nickthelegend/xorrpad/docs/screens/v4/README.md

# Firmware v4 captures

The approved desktop components, tokens and art are retained.

## F8 SCAN captures

`scan-markets-{1440,375}.png` and `scan-activity-{1440,375}.png` show the
existing desktop components populated by both real SCAN routes. The test checks
visible-element bounds at both widths. The full market/error list is expandable;
checked/unavailable counts do not claim missing candle feeds were evaluated.
`scan-record.json` records the actual public result and its provenance; `scan.png`
is the exact firmware `ui.h` frame rendered by native uipreview at 2x RGB565.
Financial data is live or explicitly Setup required. The pad record displays six
market rows plus full counts; SCAN answers never authorize a trade.

## F7 release captures

`release-captures.json` lists **14** new browser screenshots from the actual
local desk, SQLite and verified encrypted native padsim. No HTTP response is
intercepted. Device saves Sounds, Ambient and Tilt guard together and reloads
their actual stored settings. Markets' Predict on pad selects Predictor without
creating a signal. Agent and Activity show actual guard/journal state; financial
reads are live or explicitly Setup required/unavailable/empty.

- `release-{device,markets,agent,activity}-{1440,375}.png` are full-page captures.
- `release-{ambient,sounds,tilt-guard}-{1440,375}.png` show the Device settings
  around each section heading; the full-page Device capture includes every
  control. Viewport edges and the existing fixed mobile navigation are retained.
- The browser checks document width and visible form-control bounds at both
  sizes and records page runtime errors. Every resulting image is also visually
  reviewed for clipping and overflow. Configuration values are settings, not
  financial quotes, balances or claimed fills.

`release-pad-records.json` retains public input snapshots and provenance for
every new pad screen. `release-pad-*.png` are generated by the actual `ui.h`
native renderer at 2× panel resolution. `release-pad-captures.json` records
dimensions and SHA-256 hashes. Predict/outcomes, perps Setup, flatten Setup,
ambient and empty journal come from the feature suite's live-or-Setup records.
Cockpit, liquidation alarm, cooldown countdown, flatten plan and populated
journal are explicitly **LAYOUT TEST** inputs, never substituted external
responses or claims of a live trade. Missing-clock cooldown is an honest native
Setup state. Native/WASM parity separately covers all **31** frame cases.

Reproduce the release pad PNGs from the committed public snapshots:

```sh
make -B -C tools/uipreview
node tools/uipreview/capture-v4.mjs
```

Run `SIBYL_PY=$PWD/.venv/bin/python npm test --prefix desk` alone to recapture the
desktop against a fresh local session. Restore historical v3 screenshots with
`git checkout -- docs/screens/v3` if their tests rewrite them. Historical
per-feature evidence below remains intact; release screenshots use separate names.

## Historical feature captures

| Files | Source / limits |
| --- | --- |
| `predict.png` | F1 actual public pm-AMM devnet record through firmware ui.h. |
| `outcome-positions.png` | F1 actual missing-owner Setup record through ui.h. |
| `predict-markets-{1440,375}.png` | F1 real local desk + encrypted native padsim. |
| `perps-device-{1440,375}.png` | F2 real local desk + encrypted native padsim, threshold saved to 7.5%; no configured perp authority. |
| `perps-positions.png` | F2 actual empty/Setup `perps` wire record rendered with ui.h. |
| `liq-guard.png` | F2 native parser/renderer **LAYOUT TEST** vector (mark 100, liquidation 95, distance 5%). No external API substitution or live liquidation claim. |
| `perps-cockpit-layout.png` | F2 native **LAYOUT TEST** cockpit vector; next funding unavailable. No live position claim. |

F2 layout inputs are generated under `firmware/build/f2-{liq,cockpit}-layout.json`;
the real Setup record is captured as `firmware/build/f2-perps.json` by
`desk/test/pad-perps.test.mjs`. Run `make -B -C tools/uipreview` and
`tools/uipreview/preview OUTPUT 2 RECORD.json` to render the exact firmware pixels.
Native/WASM tests cover 16 distinct frames including unknown cockpit fields and
the guard, alongside all existing Fund/Portfolio/Predict/outcome cases. No hardware
was flashed, no funded perp was reduced and no transaction was submitted.

F3 evidence:

- `tilt-agent-{1440,375}.png` and `tilt-device-{1440,375}.png`: real local desk,
  SQLite and verified encrypted native-accounting padsim. The actual simulator
  has no approvals/fills at capture time; its saved hourly limit is 1. No market
  quote, fill, wallet balance or realized PnL is fabricated.
- `cooldown-layout.png`: the actual `ui.h` native renderer with explicit
  **LAYOUT TEST** inputs (900/1800 seconds, half ring), not a real trading event.
- `cooldown-setup.png`: the native renderer's honest missing-UTC state, with
  no invented clock/countdown value.

F3 extends native/WASM parity to **19 distinct frames**, including countdown,
missing UTC and a reviewed reduce-only decision while cooling. Desktop captures
reuse the approved components; no stylesheet, token or commissioned art changes.
Physical display/power-loss verification remains hardware work.

F4 evidence:

- `flatten-setup.png` uses the actual encrypted padsim/desk response with missing
  public authorities, rendered by the production `ui.h` through uipreview.
- `flatten-layout.png` is explicitly **LAYOUT TEST / no live trades**: three
  coordinator/parser layout vectors, never an external API response or a fill.
- `flatten-device-{1440,375}.png` uses the actual local desk and verified v4
  padsim after KILL. The desktop live firmware texture receives the Setup plan;
  mobile retains the approved static CAD poster and actual Kill latch controls.
  `flatten-activity-{1440,375}.png` shows the actual NO/refused record in the
  existing Activity components. Styling, tokens and commissioned art are unchanged.
- Native/WASM parity adds awaiting, Setup and refused Flatten frames, preserving
  every earlier frame and actual Fund QR decoding (22 distinct frame cases).

Public inputs are in `firmware/build/f4-flatten-{setup,layout}.json`. A plan
layout is not proof of a funded live close; venue/signing prerequisites and
unsupported inventory cases are documented in `docs/v4/V4-NOTES.md`.

F5 evidence:

- `sounds-device-{1440,375}.png`: the real Device sound controls on the local
  desk with a verified encrypted v4 padsim. The browser saves volume 45%, mute
  off, detent tick on and 22:00–07:00 UTC quiet hours. No stylesheet, tokens,
  artwork, market data or trade outcome is changed or invented.
- `sounds-cooldown-setup.png`: actual native `ui.h` rendering of the production
  tilt driver's missing-UTC state after enabling an hourly limit with no clock.
  No reservation, close or financial fill is injected. Sound is silent in
  configured quiet hours without UTC, while the existing Setup screen and LED
  remain available. The input is `firmware/build/f5-sound-cooldown-setup.json`.

F5 adds sound and LED behavior to existing screens; `ui.h` and its shipped WASM
are unchanged. PCM/browser evidence is in `desk/test/pad-earcons.test.mjs` and
`firmware/test/earcons.cpp`. Acoustic and LED hardware measurements are pending.
