nickthelegend/xorrpad/keeper/README.md

# xorrpad devnet keeper

This separate process signs only keeper market-creation and resolution
transactions on devnet. The v1 desk defaults to phone-wallet signing and also
supports a capped local session wallet; its venue adapters remain unsigned
builders. The keeper refuses any RPC whose
genesis hash is not Solana devnet and any collateral other than
`3WQ8hCqTNwjrh8WzE2XyoZoUrd1miPcwWfMkmFPUMEWZ` (6-decimal mUSDC).
It checks both before key access and again before each signing/submission.

```bash
npm install --prefix keeper
node keeper/keygen.mjs        # once: prints only the public key
node keeper/fund.mjs          # stops with the precise funding instruction if needed
node keeper/run.mjs --once    # one scheduling pass
node keeper/run.mjs           # separate recurring keeper; stop by its PID
```

The key is `keeper/.keeper-devnet.json`, exclusively created with mode 0600;
key generation refuses an existing key or public metadata. It is gitignored.
The desk reads only `.creator-devnet.json` public metadata, never the key.
Never paste a secret into a terminal, a README, or an environment file.

Funding tries `requestAirdrop` on the public devnet RPC once per keeper key.
If the balance is below 0.5 SOL afterward it stops. Once SOL is funded, the
pm-AMM faucet is requested at most once an hour for mUSDC; balances are confirmed
from chain rather than inferred from the faucet response. Local attempt records
prevent repeated faucet requests on restart.

## Schedule and creation

SOL and BTC expire on the next eligible UTC hour; ETH expires at UTC midnight.
An expiry less than 360 seconds away is skipped to leave room for the program's
300-second minimum. Strikes round the live Pyth price to $1 for SOL, $100 for BTC
and $10 for ETH, using integer arithmetic. Questions are `SOL above $<strike>
at HH:00 UTC?` and equivalents. The on-chain `endTs` is the exact expiry.

`KEEPER_DEPOSIT_USDC` defaults to 50 human mUSDC. The keeper composes the SDK's
`ix.initializeMarket` and `ix.depositLiquidity` builders, with raw 6-decimal
amounts for the deposit, then signs only inside this process. This is equivalent
to the documented [`send.createMarket`](https://predict-pm-amm.dev/llms.txt)
flow. Deterministic creator/template/expiry market ids prevent duplicate markets
on restart. The run lock prevents concurrent keepers; after a crash, inspect its
PID and chain status before removing a stale lock. Pending signatures are never
blindly resubmitted.

## Pyth sources

Feed identities were checked against the official Hermes feed-search endpoint,
matching the full `Crypto.<asset>/USD` symbol rather than the first search hit:

| Asset | Pyth Core/Hermes feed ID | Official source |
|---|---|---|
| SOL/USD | `ef0d8b6fda2ceba41da15d4095d1da392a0d2f8ed0c6c7bc0f4cfac8c280b56d` | [Hermes feed search](https://hermes.pyth.network/v2/price_feeds?query=SOL%2FUSD) |
| BTC/USD | `e62df6c8b4a85fe1a67db44dc12de5db330f7ac66b72dc658afedf0f4a415b43` | [Hermes feed search](https://hermes.pyth.network/v2/price_feeds?query=BTC%2FUSD) |
| ETH/USD | `ff61491a931112ddf1bd8147cd1b641375f79f5825126d665480874634fd0ace` | [Hermes feed search](https://hermes.pyth.network/v2/price_feeds?query=ETH%2FUSD) |

[Official feed-ID guide](https://docs.pyth.network/pro/price-feed-ids).
[Timestamp update API](https://docs.pyth.network/api-reference/hermes/price-updates-at-time).
[Pyth Core upgrade and API-key requirement](https://docs.pyth.network/pro/pyth-core-upgrade).

Hermes now requires `PYTH_API_KEY` in an `Authorization: Bearer` header for price
updates. Set it in the process environment; this code never loads an `.env` file,
prints the credential or writes headers into evidence. An authentication failure
reports `Setup required: PYTH_API_KEY`. Feed discovery remains public. There is
no substitute price source or unsigned-price fallback.

## Resolution and evidence

At the chain expiry, the keeper requests
`https://hermes.pyth.network/v2/updates/price/<endTs>?ids[]=<feed ID>`.
Hermes returns the first update at or after the requested second. This keeper
requires **publish_time exactly equal to endTs**. If it is missing, it holds
the market open and retries the same timestamp; it never substitutes a later
price. Resolution uses exact integer arithmetic against the rounded strike.
YES requires the entire confidence interval above the strike; NO requires it
below (or an exact zero-confidence equality, because the question says above).
An interval touching or straddling the strike remains open and logs
`UNRESOLVED: confidence straddles strike`. Retrying the same fixed observation
may never settle an ambiguous market; this is deliberate, not a later-price
fallback. Retries are no faster than once per minute.

The full Hermes response, including `binary.data`, is journalled before sending
the resolution. Only after confirmation and a matching on-chain winning side is
`resolutions/<market>.json` published, with the question, strike, exact publish
time, price, confidence, outcome and resolution transaction signature. These
are public evidence files. A restart recovers a confirmed pending resolution;
it does not guess a signature or blindly submit twice.

This is a creator-operated oracle keeper, **not** an on-chain Pyth verifier.
Hermes HTTPS parsed fields are trusted by this process; signed update bytes are
preserved for independent verification. pm-AMM still enforces creator authority
rather than verifying the oracle proof itself.

`node keeper/run.mjs --cycle` attempts one SOL market expiring in ten minutes,
then waits to resolve it. It needs funding and authenticated Hermes first.
SIGINT/SIGTERM request a clean stop; the process owns no listening port.

## Desk read endpoints and traction

The authenticated desk API exposes `/pm/ours` from on-chain creator filtering,
`/pm/resolutions` from these public evidence files, and `/pm/stats` from chain
transaction history only. `KEEPER_PUBLIC_KEY` can select the public creator when
the desk does not have local public metadata. The desk never imports this
process's signing module or reads its key.

Stats cache successful scans for at least 60 seconds. They deduplicate transaction
signatures across markets, ignore failed transactions, identify each swap's
actual trader, and isolate its SPL transfers (including CPI stack scopes).
Volume is the gross mUSDC leg: declared raw USDC input for buys and actual vault
outflow for sells. YES↔NO trades count as swaps but have zero mUSDC volume.
Creator fees count actual fee transfers; a creator trading with themselves does
not inflate received fees with a waived fee share. Missing transactions or an
unobserved creation instruction make totals incomplete and request an archival
`PMAMM_RPC`; no database total or fabricated zero is substituted.
