nickthelegend/xorrpad/docs/v4/V4-NOTES.md

# Firmware 4.0.0 — F8 SCAN answers

MIT · Copyright (c) 2026 Nivesh Gajengi.

Features 1–7 are delivered through F1–F6; F7 packages their release evidence.
V1–V3 and agent-wallet functionality remains. OTA metadata defaults to 4.0.0
and lists every feature. Pro and Core manifests are explicitly unsigned:
no production signing step, OTA publication, flashing or push is performed.
See [4.0.0 release notes](RELEASE-4.0.0.md) and the F8 section in
[TESTING.md](../../TESTING.md) for current verification rather than historical
per-feature counts below. F8 delivers SCAN answers below; the remaining legacy
mirror corrections are the separate F9 scope.

Select **Predictor** in Device or **Predict on pad** in Markets. If the device has
stored hardware profiles, the desk selects its Predictor profile/Predict layer.
Otherwise the desktop profile activates the same screen. Pending decisions,
clear signing, KILL, pairing, receipts and errors retain their existing priority.
Knob turns browse the live market catalogue, six records at a time. The pad keeps
local selection responsive; the desk returns the selected catalogue page.

`{type:"predict", enabled, cluster:"devnet", venue:"pmamm", markets:[{market,
question, probability, change24h, closesIn}], selected, total, offset, sizeUsd,
observedAt, validForMs?}` comes from authenticated `/pm/markets`. A snapshot is
usable for at most 30 seconds. Scrolling cannot extend its original freshness.
Questions are bounded to 180 printable characters and drawn in at most three
lines. `change24h:null` is rendered **24h unavailable** because the current adapter
has no history. The arc uses the on-chain marginal YES probability; executable
BUY quotes include size, fees and price impact and need not equal that probability.
No offline or empty feed creates a quote. Failed prediction requests use the
existing Action needed screen with the actual desk error, rather than hiding
quote or liquidity failures behind the probability arc.

A first YES/NO emits `key` with `action:"predict:yes"|"predict:no"` and the displayed
market. The desk checks the profile, encrypted session, KILL state, absence of a
pending decision, freshness and market membership, then reads `/pm/quote` at the
current desk size and sends a normal `/signals` proposal. `manualConfirmation`
persists in the signal and disables auto-accept on both proposal and re-gate.
A new signal resets the physical hold: a held initiating YES cannot also accept.
Only a separate trusted YES (800 ms above the existing threshold) accepts; NO
refuses. Existing permissions, caps, execution, clear-sign, session policy and
mainnet acknowledgement gates remain in force. F1 is devnet-only. Nothing is
signed or submitted as part of the verification scenarios.

PORTFOLIO in Predict reads `/pm/positions` using its existing configured public
owner (`SOLANA_ADDRESS`). `{type:"outcome_positions",cluster:"devnet",positions:
[{name,yes,no}],message?}` shows up to eight outcome markets, three per timed page.
These are outcome **shares**, not invented USD valuations. Missing owner/RPC gives
Setup required; a successful empty response gives No outcome positions. Any key
closes the card without proposing; a one-second PORTFOLIO hold still requests FUND.
`predict:close` synchronizes this dismissal with the desktop mirror.

Core builds (`-DXORR_CORE=1`) skip TFT initialization/backlight. The same public
Predict/outcome records reach the authenticated desktop mirror; existing earcons
remain. Transaction-byte signing on a screenless Core still requires the existing
external desktop/phone review/signing path: local clear-sign approval is not bypassed.
No hardware was flashed and no physical pad behavior is claimed as measured.

`PredictPadSimulator` in `tools/padsim/predict.mjs` uses encrypted v2 framing with
firmware version 4.0.0 and the existing native session driver. It implements
proposal-vs-answer, scroll, stale/empty refusal and outcome dismissal. Run the
focused scenario with `SIBYL_PY=$PWD/.venv/bin/python node --test
--test-concurrency=1 desk/test/pad-predict.test.mjs` after the native driver build.
Tests use real local HTTP/encryption and real devnet reads; pure parser/layout
cases are explicitly test inputs, not substituted external service responses.

Evidence: `docs/screens/v4/predict.png` renders an actual public devnet record;
`outcome-positions.png` renders the actual missing-owner response. Markets captures
at 1440/375 px preserve the approved desktop. The native/WASM parity suite covers
live-layout probabilities 0/42/100%, unknown change, Setup, empty and share rows.
See TESTING.md for the final counts and unsigned Pro/Core build evidence.

## F2 — Perps cockpit and liquidation guard

Authenticated `GET /pad/perps` reads configured Phoenix (`PHOENIX_AUTHORITY`)
and Jupiter (`JUPPERPS_AUTHORITY`, falling back to the public `SOLANA_ADDRESS`)
positions. The desk checks these on its existing five-second connected-pad tick.
No authority means Setup required; a successful empty venue response stays empty.
Both existing perp deployments expose mainnet **read-only** data. F2 verification
uses no funded perp authority, executes no mainnet transaction, and never enables
`XORR_ALLOW_MAINNET`. The existing mainnet signing gate additionally guards the
reduce-only builder in every wallet mode.

`{type:"perps",positions:[{market,venue,side,entry,mark,leverage,liq,distancePct,
nextFunding}],message,observedAt}` adds up to six cockpit pages alongside all
existing spot position pages. Native/WASM share the exact renderer. Missing
fields are null on the link and **unavailable** on the pad. Phoenix account data
does not expose actual account liquidation or leverage; its isolated-entry quote
estimate is deliberately excluded. Neither adapter supplies a next funding time.
Jupiter API micro-USD fields are decoded at six decimal places; leverage is copied
from the API. [Jupiter's API specification](https://perps-api.jup.ag/v2/docs)
documents position fields and the partial `positions/decrease` request.

Distance is `max(0, (mark-liq)/mark*100)` for longs and
`max(0, (liq-mark)/mark*100)` for shorts. Crossing liquidation remains an alarm.
`liqGuardPct` defaults to 10 and is persisted in `/pad/options` (0 < pct <= 100).
The nearest eligible open position emits `{type:"liq_guard",active,id,market,
mark,liq,distancePct,proposal,observedAt}`. Missing prices never trigger a guard.
A red LIQ GUARD screen, distinct synthesized alarm and red LED pulse announce
the episode. KILL, errors, pairing, pending/clear-sign decisions and updates retain
priority. The guard and cockpit expire after 30 seconds without a fresh read.

With no pending decision, first YES sends `liq:yes` with `guardId`; NO sends
`liq:no` and dismisses that episode. YES rechecks the live position, threshold,
identity, exact half size, encrypted peer, KILL and pending state, then creates
an ordinary `/signals` proposal with `reduceOnly:true`, `reducePct:50` and
`manualConfirmation:true`. It never accepts, signs or executes that proposal.
A distinct trusted YES must accept the newly displayed **REDUCE 50%** proposal;
the existing fresh-key/hold and transaction-byte clear-sign rules still apply.
Every re-gate preserves manual confirmation. Permissions, caps, cooldowns and
session/crew policy remain in force. A cap that would alter the half-close
refuses it rather than silently changing its meaning. A changed position or
quote requires a fresh proposal.

Reduction routes never call an opening builder or switch venues. Phoenix halves
absolute base lots and sets the actual order's ReduceOnly flag. Jupiter halves
raw USD size, uses `positions/decrease` with `entirePosition:false` and withdraws
zero collateral. Both round down to the venue integer unit, rejecting dust. Each builder read
also verifies the reviewed position side and notional size before constructing
the close; intervening changes require a fresh proposal.
Jupiter's decrease response has no execution price: proposal price is its live
mark reference, explicitly labelled in quote metadata; fees come from its API
quote. A quote/unsigned transaction is never presented as a fill. After a
proposal/refusal, the same alert episode stays dismissed until recovery or a
different nearest position, preventing repeated prompts/alarms.

Device's existing options form gains the threshold. Activity's existing surfaces
show actual guard events received this session; disconnected/empty states remain
honest. Core receives the same records through the existing desktop/phone mirror
and hears the alarm, without bypassing the existing external visual review path.
`PredictPadSimulator` handles guard records and proposal-vs-answer semantics using
the encrypted native session simulator.

Evidence in `docs/screens/v4/`: `perps-device-{1440,375}.png` captures the real
local server and encrypted padsim; `perps-positions.png` renders its actual Setup
record. `liq-guard.png` and `perps-cockpit-layout.png` are explicitly labelled
**LAYOUT TEST** native parser/renderer vectors, not external financial data or
claims of a live liquidation. Their supplied inputs are generated test vectors
in `firmware/build/f2-{liq,cockpit}-layout.json`. No physical pad was flashed.

## F3 — Firmware tilt guard

`/pad/options.tiltGuard` configures `{dailyLossUsd,maxTradesHour,losingCloses,
cooldownMinutes}` in Device's existing options form. Zero disables each limit;
cooldown is 1–10080 minutes, hourly and streak limits are 0–1000. Defaults leave
all limits disabled, preserving existing permissions. Each pad saves its settings,
accepted IDs, rolling-hour timestamps, confirmed close PnL, losing streak and
independent UTC deadlines as one versioned `xorrtilt/state` NVS blob in the
existing 256 KiB profiles partition (bounded to 64 KiB, avoiding NVS string limits). Approval
reserves and saves locally before any approval/signature leaves the device.
Repeated signal approval, crew review and signing count once (128 recent IDs).
Counts include reduce-only approvals and conservative reservations even if the
desk later rejects the trade. A failed NVS write or corrupt restore refuses new
exposure; risk-reducing actions remain available under their existing gates.

Hourly limits use a rolling hour, daily loss uses net **confirmed realized** USD
PnL received this UTC day, and N losing closes starts the configured cooldown.
Zero/profitable closes reset the streak. Independent deadlines compose: a new
UTC day releases only the daily loss latch. Relaxing/disabling settings, positive
PnL, reconnection and reboot cannot shorten a running deadline. There is no desk
reset or supplied-clock operation. Firmware uses ESP32 UTC/SNTP, started by the
existing price-alert service. Missing/regressing UTC gives Setup required when
limits are enabled or a deadline is retained. With disabled limits, approvals
before clock sync are persisted and conservatively counted for an hour after
sync, rather than inventing timestamps. At most 1000 hourly timestamps are kept.

Firmware v4+ receipt records carry `closed` and `realizedPnlUsd` (number or
null); v1–v3 receipt records retain their exact existing shape. Explicit close receipts, reduce-only fills and spot sells identify closes.
PnL is copied only from confirmed receipts; marks, quotes, unrealized PnL and
unsigned builds never become realized profit/loss. Current adapters do not always
supply realized close PnL. A missing close result is recorded as unavailable and
loss-based guards show **Setup required: close PnL**, refusing new exposure until
that receipt supplies known PnL or the next UTC day. Unknown closes reset streak
continuity. No external API or financial response is mocked. Receipt signatures
are deduplicated across reboot (128 recent signatures and unresolved closes).

The Cooldown screen shows the reason and countdown ring, including offline.
New proposal YES is refused before the ordinary confirmation and clear-sign /
session / crew signing paths. Previously reserved approval-to-sign steps may
finish without double-counting; no new approval or automatic signing route can
bypass a tripped guard. Hidden confirmation pages cannot count as reviewed, and
a refused approval releases its hold so approval requires a fresh YES. KILL retains its exact hold/latch/rearm semantics. NO,
PORTFOLIO (including its funding hold), liquidation-guard reduction proposals and
reviewed reduce-only trades retain their existing behavior. Core receives the
same state through the desktop/phone mirror, and the existing refusal earcon
announces cooldown start. Every prior permission/cap/clear-sign/mainnet gate
still applies; no live trade, production release signing or flashing is performed here.

Encrypted `{type:"tilt_state",blocked,reason,remainingSeconds,durationSeconds,
tradesHour,realizedPnlUsd,losingCloses,unknownCloses,clockReady,healthy,settings}`
reports locally authoritative state once per second. The desk accepts this only
from the preferred verified encrypted peer and exposes it in `/desk/link`.
Agent shows the actual device state or Setup required, including unknown PnL.
The native/WASM mirror renders the same Cooldown frame, and stale mirror state
is marked Setup required. Desktop controls reuse existing Field/Card components;
no CSS, design tokens or art is changed.

`tools/padsim/tilt.mjs` uses production C++ accounting via `tilt-driver`, public
accounting files and the existing encrypted native-signing simulator. Native tests
cover serialized reboot, UTC midnight, independent deadlines, settings changes,
rolling-hour counting, deduplication, unknown PnL/time, corrupt storage and failed
persistence. No board has been flashed: physical NVS atomicity, power cuts, UTC
synchronization and TFT readability still require hardware verification.

F3 acceptance: native **291 passed / 4,146 assertions / 0 failures**; isolated
complete desk **266 tests / 256 passed / 10 existing skips / 0 failures /
0 cancellations**. Model3d CAD parity and all 19 native/WASM frame cases pass.
The standalone app build, WASM rebuild and unsigned Pro/Core compilation pass.
Final implementation/artifact hashes match across the workspace and isolated
source. Verification logs are `firmware/build/f3-*.log`; see TESTING.md for exact
counts, build sizes and limits. No CSS, token or commissioned art is changed. No existing private key,
production signing key or existing wallet directory is opened.

## F4 — Panic flatten

The existing KILL timer still fires at exactly 2 seconds, latches locally before
network work and persists through reboot. Its desk request + fresh physical
800 ms YES re-arm flow is unchanged. After a verified v4 pad reports KILL, the
desk reads configured Phoenix, Jupiter Perps and pm-AMM public wallet inventories
and builds one immutable Flatten all plan for that latch episode. KILL cancels
old pending trades first. No transaction is built for execution or signed merely
because KILL was pressed. NO refuses the plan and keeps the local and desk latch.

`{type:"flatten",id,fingerprint,reduceOnly:true,state,orders,perps,outcomes,rows,
message,remainingMs,observedAt}` drives the pad, Core's desktop/phone mirror and
Activity. States are building, awaiting, setup, empty, executing, refused, complete
and failed. Counts and every bounded row must agree; non-reduce-only records are
refused by the native parser. The pad shows four plan rows per page (knob scroll),
with quantities/budgets, venue and market; the fingerprint binds full identities
and amounts even when a long public market address is abbreviated for display.
The plan has at most 32 transactions and a 60-second confirmation window. Larger,
incomplete or unsupported inventories are Setup required rather than truncated
executable plans. A stale/changed plan requires re-arm and another KILL to rebuild.

A fresh YES hold of 800 ms sends a dedicated `flatten:yes` key bound to the
plan ID and fingerprint over the preferred verified encrypted transport. NO sends
`flatten:no`. Ordinary trade YES, voice, knobs that change trade parameters and
unrelated signing remain blocked while killed. The desk rereads the full inventory
before acting, cancels orders first, then closes every planned perp at 100% and
sells existing outcome tokens into collateral. No opposite-side purchase is used.
Each leg goes through the existing signal queue and executor, with auto-accept
forced off, permissions/caps/allowlists/cooldowns and the selected phone/session/
pad/crew policy intact. Caps cannot silently resize the reviewed exit. Outcome
permission budgets conservatively use $1 per share, not an invented price.
Normal remembered spot-position checks remain in force; only structurally valid
flatten exits use the actual venue inventory instead of requiring spot memory.

The killed exception is an in-memory grant for an exact internally created child
signal and its complete signal digest, device and current plan. A `reduceOnly`
label supplied by another proposal grants nothing. Re-arm requests and another
KILL revoke the plan; submission rechecks authorization immediately before the
network call. Each transaction must have a confirmed receipt before the next leg
starts; a phone handoff, quote or unsigned build is never called a fill. Failure
stops the sequence and reports its reason, retaining the latch and any earlier
confirmed partial progress. A completed flatten also leaves the latch on.

Every granted child ID also reserves native F3 accounting when its executing
record arrives, including phone/session signing modes; signing retries deduplicate
that same ID. Cancellations do not fabricate realized close PnL.

For pad signing, executing records identify the granted `legId` with
`legReduceOnly:true`. Only that ID can receive status/transaction review while
killed; policy configuration remains blocked. Native clear-sign decoding, every
reviewed page and its existing hold remain required. Automatic pad signing is
suppressed while killed, so an unrelated automatic policy cannot turn KILL into
a trade. Core retains its existing external visual-review/signing requirement.

Inventory scope is the existing configured Phoenix trader PDA and its subaccounts,
Jupiter public authority and pm-AMM public owner. Phoenix normal limit-order
cancellation uses the official SDK instruction builder; its conditional, spline
and active TWAP orders currently require external cancellation and block the
whole plan with Setup required. Jupiter limit and TP/SL requests use the official
unsigned cancellation API; keeper-dependent cancellation is explicitly refused.
Phoenix/Jupiter full-close instructions retain their real reduce-only/decrease
semantics and bind to the reviewed side/notional snapshot. Their deployments are
mainnet read-only by default: every flatten builder retains `XORR_ALLOW_MAINNET`.
pm-AMM sells exact existing YES/NO token amounts on devnet, checks the live token
balance and uses minimum-output protection. Resolved/expired shares require the
external claim flow and block the plan honestly. LP liquidity is outside the
outcome-position scope. Missing authorities, RPC failures, dust or unsupported
public account metadata never become a fabricated empty/successful flatten.

`tools/padsim/flatten.mjs` extends the encrypted native-signing/tilt simulator.
Coordinator tests use explicitly labelled local state-machine vectors to verify
YES execution dispatch, cancel-before-close ordering, receipt sequencing, NO,
replay, expiry, changed snapshots, permission refusal and grant revocation. These
vectors do not replace external APIs or claim live financial execution. The
actual HTTP/encrypted test uses missing public authorities, verifies Setup and
NO/re-arm, and confirms that YES cannot manufacture a plan or trade.
No physical pad is flashed and no live transaction is submitted in verification.

F4 acceptance: complete desk **271 tests / 262 passed / 9 existing skips /
0 failures / 0 cancellations**; native **293 passed / 4,179 assertions /
0 failures**. All 22 native/WASM frame cases, CAD parity, app build, WASM rebuild
and final unsigned Pro/Core compiles pass. See TESTING.md for exact sizes, command,
run duration, prerequisites and public log locations. No push or board flash.

## F5 — Sound design

`firmware/xorrpad/logic/earcons-table.h` is the single parameter source for
all eight synthesized earcons. The Arduino compiler includes it as an X macro;
the desktop imports its raw text at build time. Two sine notes per event use
3 ms raised-cosine edges, signed 16-bit mono PCM at 16 kHz and bounded peaks.
No recorded sound asset is shipped. The existing `Chime::Error` name maps to
wire event `alert`, retaining every earlier caller and native voice test.

`GET/POST /pad/options` gains `sounds` (complete object):

```json
{"volume":80,"mute":false,"knobTick":false,"quietHours":null}
```

Volume is an integer 0–100. `quietHours` is null or
`{"startMinute":1320,"endMinute":420}` in UTC. Start is inclusive and end is
exclusive; midnight wrapping works; equal endpoints silence the full day.
The Device form accepts HH:MM UTC. Mute, zero volume and quiet hours silence
alarms as well as speech and routine cues. Configured quiet hours with an
unavailable pad UTC clock stay silent. The LED and safety controls remain live.
Sound settings persist in the pad's `xorrsound` NVS namespace and desk options;
identical pad configurations avoid repeated flash writes. The preexisting voice
profile volume knob still changes local playback gain.

Every scheduled cue emits an authenticated notification
`{type:"earcon",id,kind,audible,volume}`. Kinds are `accept`, `refuse`, `fill`,
`alert`, `liq_alarm`, `kill`, `cooldown`, `tick`. The desk validates it from the
current verified transport and publishes `pad_earcon` with device and sound
settings. This is a sound notification and carries no trade authority. Secure
transport replay checks remain in force. The mirror listens only to its selected
device, uses WebAudio buffers from the same PCM formula and needs an initial
click/key gesture under browser autoplay rules. Muted/unsynced-clock pad events
stay silent on the mirror; events before unlock are discarded, never replayed
later. Older firmware without these notifications does not gain mirror sound.

I2S playback emits at most 128 samples (8 ms) per loop, without blocking for
an entire earcon. A detent never interrupts another cue; safety alarms take
priority over routine cues. KILL remains a deliberate 2 s hold, and acceptance
sound on a trusted decision occurs when its existing tap/hold gate emits YES.
No audio callback signs, creates or accepts a trade. GPIO 48 retains a green
fill pulse, adds a red alarm pulse while KILL/LIQ GUARD is active, and breathes
amber while cooling. Warnings remain visible with mute or quiet hours enabled.

Native tests render every cue to PCM and check exact duration, peak, silent
edges and distinct samples. `earcon-driver` exposes the production synthesis
and policy to the desk's sample-by-sample parity test. Browser verification
observes actual AudioBufferSourceNode playback from an encrypted padsim event,
checks volume and mute, saves the real Device form and reloads simulator state.
These are explicit local audio/policy vectors, not fabricated prices or fills.
The native uipreview frame uses the actual missing-UTC discipline state. No new
pad screen or `ui.h` change is needed for F5; the existing WASM is preserved.
Physical speaker timbre, acoustic loudness and LED appearance require a board.

F5 acceptance: complete desktop **274 tests / 265 passed / 9 existing skips /
0 failures / 0 cancellations**; native **296 passed / 4,286 assertions /
0 failures**. App build, unchanged native/WASM parity, uipreview and final
unsigned Pro/Core compiles pass. The approved desktop styling, all previous
features and the existing YES/permission/signing gates are retained. Earlier
screenshots are restored. No push or board flash.

## F6 — Ambient desk clock

After exactly 60 seconds without physical input on Home, the pad shows a quiet
UTC clock, an independent SOL reference price and up to 24 hourly closes, the
remembered book's unrealized P/L, the earliest venue-reported funding time,
existing NY hours and crew review-round count. Book P/L is change against known
cost basis, not an invented 24-hour return; missing basis is Setup required.
The existing perp readers currently supply no next funding timestamp, so the
countdown honestly says unavailable. Missing SOL data stays unavailable. The
clock extrapolates desk UTC for at most 90 seconds; an interrupted link replaces
stale financial values with Setup required. The clock stays dimly visible instead
of blanking; disabling Ambient restores the existing display idle policy.

`/pad/options` adds boolean `ambient` (default true), persisted on desk and in
`xorrui` NVS. `{type:"ambient",epoch,price,closes,pnl,nextFunding,hours,crew}`
uses only live existing reads; SOL uses `/pad/chart?symbol=SOL&hours=24`, independent
of the market in hand. The first key press consumes both down and up, including
YES, NO and KILL; the next KILL still requires its original 2-second hold. A knob
turn or press only wakes; holding that first press cannot start recording and
its release cannot cycle the control. Every proposal, warning and wallet view
keeps its priority. Screen transitions report authenticated `pad_view` records
for the mirror; they carry no trading authority. Core uses the same state and
mirror with its existing earcons. Native tests and the padsim production C++
driver cover boundaries, clock wrap and complete wake gestures. Native/WASM
parity adds two honest missing-feed clock frames. The preview capture is a real
desk record or an explicit unavailable-data state, never a substituted quote.

## F6 / feature 7 — NVS trade journal

A knob click from Home opens the journal, newest first; turn to browse and click
again or press a key to dismiss. A dismissal consumes both key edges; KILL
retains its hold immediately. Existing knob mode cycling remains outside Home,
clear-review paging, prediction scrolling, volume and long-press voice retain
their gates. New decisions, warnings and wallet cards outrank journal browsing.
No journal path creates, accepts, signs or retries a trade.

The pad stores a bounded 32-entry chronological ring as a blob in `xorrjournal`
on the existing `profiles` NVS partition. Decision IDs deduplicate repeated link
records; an update changes that decision in place, and the 33rd distinct ID
evicts the oldest. Each row holds UTC epoch seconds (zero = Time unavailable),
action, market, size, venue, result, confirmed signature and bounded public reason.
The result can be awaiting, accepted, signed, filled, refused, expired, failed or
blocked by tilt guard. Local NO, local deadlines, clear-review/sign responses
and tilt blocks are retained alongside authenticated desk outcomes. Only a
confirmed receipt with a nonempty signature supplies `filled`; accepted, signed
and executed-without-receipt do not imply a fill. Unknown metadata is labelled
unavailable. The pad clock must be synchronized for timestamps; reboots preserve
unknown/in-flight outcomes until the desk reports their result. No reconstructed
or estimated fill/PnL is added. Storage faults report Setup required without
silently wiping or claiming the history was saved. Legacy polling preserves the
in-memory journal, and no repeated unchanged record writes flash.

Authenticated desk `journal_decision` records carry decision metadata and queue
outcomes, including proposals refused by existing policy before display. Existing
`signal`, `signal_state` (now including reason) and `receipt` messages also update
the same IDs. Clear-sign approval is not a trade receipt. Metadata on signatures,
including flatten child decisions, remains subject to all existing permissions,
caps, session policy and physical review. No journal notification grants consent.

Pad-to-desk sync sends `journal_begin {revision,count,healthy}`, at most 32
`journal_entry {revision,index,entry}` records and `journal_end {revision}`.
Each record fits the existing encrypted link bound; ordered revision validation
and duplicate-ID checks prevent partial or mixed snapshots replacing the last
complete history. Reconnect and changes restart the snapshot. `GET /pad/journal`
(optionally `?device=...`) returns capacity, per-device last complete history,
sync time, storage health and connection state. Other verbs and unverified peers
are refused. The desk cache lasts for this process; NVS remains authoritative.
A disconnected pad's last synced copy is labelled Offline. Activity polls this
read-only route, reusing existing components/styles. With no synced pad, the route returns an explicit
Setup required state; a connected empty ring says No decisions recorded.

The mirror receives `pad_view {screen,selected}` and draws Journal/Ambient
through the exact compiled `ui.h`. Seven journal layout/empty/storage/error
states join the two clock states and 22 earlier pixel-parity cases. Native tests
cover ring eviction, scroll wrap, each outcome, strict storage restoration,
unknown UTC and receipt semantics. The final padsim extends the existing native
signer/tilt/flatten simulator and delegates journal state to production C++ with
public disk-backed storage; reboot tests start a new process. Browser evidence
captures a genuinely empty pad journal and a real encrypted link. A deliberately
refused local queue vector tests forwarding and reason retention; it never has
an executable quote, transaction signature or accepted trade. Firmware fixtures
for outcomes are labelled local state-machine inputs, never external API mocks.

Journal/view telemetry remains allowed while KILL is latched, through the same
verified preferred transport checks. This exception accepts no key, proposal or
signature authority. The encrypted padsim test records a refused local decision
while killed, confirms it syncs, and verifies BUY still fails with the latch on.

F6 final acceptance: complete isolated desktop **280 tests / 271 passed /
9 existing skips / 0 failures / 0 cancellations**; native **304 cases /
4,474 assertions / 0 failures**. App build, all 31 native/WASM frame cases,
model3d parity, rebuilt WASM, uipreview and final unsigned Pro/Core builds pass.
The journal/KILL telemetry exception is covered in the final full run; ordinary
trade keys remain blocked. Exact commands, duration, sizes, hash, captures and
public evidence locations are in TESTING.md. Approved desktop styling and all
existing signing/YES/permission gates are retained. No push or board flash.

## F7 — Release integration and evidence

Device's existing options form saves `sounds`, `ambient`, `tiltGuard` and
`liqGuardPct` together through authenticated `/pad/options`. The release browser
scenario reloads the actual stored values and verifies encrypted pad delivery.
Markets' existing Predict on pad button selects the Predictor profile via
`/desk/profiles`; that selection creates no proposal, signature or trade.
Agent reads pad-authoritative tilt state and Activity reads the bounded journal
and actual liquidation events. No desktop component, stylesheet, design token
or commissioned asset is replaced or restyled.

`firmware/build-unsigned.sh` compiles both release variants and
`prepare-release.mjs` derives public metadata from the resulting image bytes.
The existing signed generator shares the same validated metadata and complete
4.0.0 feature notes. Unsigned manifests deliberately lack a signature and fail
the existing OTA verifier. Nothing in this release workflow can bypass consent
or produce an installable verified package without the separate signing step.

The final isolated desk run passes **273/282 tests**, with **9 existing setup /
provider skips** and **0 failures / cancellations**. Native tests pass **304
cases / 4,474 assertions**. Visual review found a two-pixel collision between
the perp Setup message and the profile footer; moving only that message up six
pixels fixes it. WASM and both firmware images are rebuilt after this final
`ui.h` change; the subsequent **7/7** CAD/pixel checks include all **31** frame
cases and actual Fund QR decoding. Full-suite and focused results are reported
separately in TESTING.md, rather than added together.

All **14** desktop captures and **12** release pad frames are visually inspected
for clipping/overflow. Committed public records make native uipreview captures
reproducible. Setup/empty cases are actual feature-suite snapshots; populated
financial layouts are clearly labelled local vectors, never API substitutions
or claimed transactions. Historical v3/per-feature screenshots are restored.
No production signing, flash, mainnet enablement or push occurs.

## F8 — SCAN answers

Both `GET /scan` and the physical SCAN/BASE key publish one public
`{type:"scan", summary, markets, top, checkedCount, unavailableCount}` record.
The pad receives up to six market names (available feeds first), with the full
checked/unavailable counts, verdict in words and top setup's side/market/strategy.
The panel shows the answer for eight seconds, using a wrap-safe local timer;
any key dismisses and consumes that gesture. KILL still runs its existing safety
path. Safety screens retain priority. A pending top-setup proposal returns to
its existing confirmation screen after dismissal/expiry; otherwise Home resumes.
SCAN proposals explicitly disable auto-accept and require the existing trusted
YES, clear-sign, caps and policy checks. Receiving or dismissing an answer never
accepts, signs or sends a trade.

Markets uses the existing surface/State components for Last scan, including the
full expandable list of markets and feed errors. Activity reads
`GET /scan/history`, one uniquely identified record per completed scan including
Setup states; the latest 100 records survive navigation/refresh during this desk
process. History is not persisted across desktop restart. The last result remains
available through `/scan/last`. Missing candle feeds explicitly say Setup required;
a BTC trend-gate observation alone does not claim market setups were evaluated.
The current verified Solana book does not provide a configured candle source for
all symbols. A partial answer labels unavailable markets; no prices are invented.

Core uses the authenticated desktop mirror and Last scan card. `pad_view` adds
`screen:"scan"`; the WASM mirror consumes the same record until dismissal or
expiry. Native tests cover parsing, bounds, counts, wrap/expiry and dismissal;
the encrypted padsim uses the production C++ parser/timer. Browser coverage calls
both real SCAN routes, checks exactly one Activity row per scan, read-only YES,
refresh, and 1440/375 layouts. Native/WASM parity adds Setup and pending-top-setup
frames. `docs/screens/v4/scan-record.json` records live/Setup provenance for the
native `scan.png` frame and desktop captures. No external API responses are mocked.

## F9 — Desktop 3D pad mirror

The model's `drawFirmware` adapter uses the public `screenRecords` in
`/desk/link`, retained when the link writes a record rather than when it queues
one. It renders Fund, Portfolio, SCAN, Predict, outcome positions, spot/perp
Positions, LIQ GUARD, Cooldown, Flatten, Journal and Ambient through the shipped
WASM compiled from the same `ui.h`. The latest signal supplies the exact displayed
venue, size, price, fee, fingerprint, reduction flag and confirmation deadline;
a separately fetched desktop proposal cannot replace it.

Verified `pad_view` reports add the screen name, selected journal/market/plan
page and uint32 pad uptime. A view/selection change is sent immediately, with a
one-second clock update; the Core build sends the same metadata. The browser
extrapolates that uptime and preserves each sent record's age, so firmware page
cycling, quote expiry, scan expiry, funding/clock and plan timers use their normal
render paths. Dismissed Fund, Portfolio and outcome records remain cached without
reopening. Missing values retain firmware Setup/unavailable states. This is a
presentation-only report; it cannot accept a proposal, clear tilt or change caps.

The link publishes scoped screen events to the model, including locally reported
tilt/journal state. It does not refresh every desktop panel for clock ticks. Kill
and completed re-arm push authoritative status to the device and browser without
waiting for the five-second link tick or fifteen-second desktop poll; queued
pre-kill decisions cannot reappear after re-arm. The existing deliberate holds,
YES, clear-sign, reduce-only restrictions and session policy retain authority.

`pad-mirror.test.mjs` exercises each screen's actual browser canvas against an
independently specified native firmware frame, plus stale feeds, selected pages,
dismissal and the filmed Meteora/Jupiter decision mismatch. The encrypted
`MirrorPadSimulator` extends the existing native signing/tilt/scan/journal driver
chain; its real-server test disables the desk heartbeat, performs KILL/re-arm,
checks immediate sent status, requests the actual missing-wallet Portfolio and
verifies no trade was accepted. `mirror-view.cpp` checks firmware view priorities.
Committed replay captures identify their public release-record source; layout
vectors remain explicitly labelled. `mirror-record.json` is the real Setup reply,
with 1440/375 Device screenshots and the actual WASM Portfolio frame beside it.
Physical display refresh, USB/BLE latency and hardware clock drift remain board
checks. No desktop styles, signing keys or external API substitutions are involved.

## F10 — Tilt guard at the desk

The existing verified `tilt_state` record now gates every SignalQueue acceptance,
including API, keyboard and automatic decisions. A blocked new-exposure signal
becomes `refused` with `ruleId:"signals.tilt_guard"` and the reason
`Tilt guard: <reason> — <mm:ss> left on the pad`. Automatic refusal happens before
its acceptance announcement. The guard is checked again after asynchronous
proposal gates, at execution gates, and immediately before submission. A phone
handoff or session wallet does not bypass it.

`/desk/link` adds `tiltGate` (null when ready, otherwise device, blocked, unknown,
reason, remainingSeconds, observedAt and message). The existing SignalCard reads
it every second, disables its Accept control as Cooldown and displays the reason.
No stylesheet, component styling or artwork changes. Refuse remains available.

The desk remembers only public IDs in `pad-tilt-devices.json` after verified pad
reports. A report or transport older than 15 seconds, disconnection, restart,
unhealthy storage or an unready pad clock holds new exposure until a fresh,
healthy, clock-ready report from that pad says it is no longer blocked. Any
remembered pad can hold the desk; another ready pad cannot override it. Countdown
extrapolation is display-only, including at zero. No desk option clears it.

Strict `reduceOnly:true` signals, including existing flatten legs and order
cancellations, bypass only this tilt check; permission caps, reduce-position
validation, live quotes, KILL and clear-sign/session policy still apply. No
external API responses are substituted and no trades are sent by F10 tests.
The encrypted simulator advances the production C++ guard's test clock to
exercise real expiry. Browser captures label the pending proposal as a local
policy vector; missing model/wallet setup stays honest.
