nickthelegend/xorrpad/docs/screens/v3/README.md

# Desktop v3 screenshots

D1 Connect: `connect-{empty,pair,unverified,genuine}-{1440,375}.png`.
Generated by `desk/test/app-v3-routes.test.mjs` against the actual desk server
and `tools/padsim/v2.mjs`, using USB CRC records and real encrypted pairing.
The six-digit code in the pairing screenshots belongs to the disposable simulator.

The unverified pad has no factory certificate. The genuine scenario uses a
transient in-memory test factory injected through the `PadLink` constructor,
with an issued certificate and fresh cryptographic proof. No production trust
root is installed; these screenshots do not claim a provisioned physical pad.

Both widths use reduced motion. Browser checks cover 44 px controls, horizontal
overflow, wrong-code timeout, transport selection and clearing trust after
disconnect. The captured states are visually inspected before committing.

## D5 acceptance captures

All six v3 screens are captured from the built app served by the actual desk,
using `desk/test/app-v3-routes.test.mjs` and `desk/test/app-d4.test.mjs`.
No HTTP or WebSocket response is intercepted. Each state has a 1440 px and a
375 px image, with a 1000 px viewport height and reduced motion enabled.
Full-page images include content reached by ordinary page scrolling.

| Screen | States (filename suffix before width) | Images |
| --- | --- | ---: |
| Connect | empty, pair, unverified, genuine | 8 |
| Device | empty, connected, error, updated | 8 |
| Abilities | empty, review, installed, error | 8 |
| Agent | empty, policy, approved | 6 |
| Activity | empty, error, clear-results, crew-policy, crew-approved | 10 |
| Markets | alert-empty, alerts-stored, alerts-form | 6 |
| Total | 23 states at both widths | 46 |

Connect and Device use `tools/padsim/v2.mjs` with real encrypted pairing and
USB CRC framing. Device OTA uses the existing public signed image and manifest;
the transfer does not claim a physical flash. Abilities uses
`tools/padsim/abilities.mjs` and the native firmware interpreter with both SDK
samples. Agent, clear-sign review and price alerts use
`tools/padsim/session.mjs`; crew uses independent `tools/padsim/crew.mjs` peers.
Their native drivers execute the firmware policy, parser and approval logic.
Test identities are disposable; no existing secret or wallet is opened.

The layout check examines rendered text rectangles against viewport and
clipping ancestors, so `overflow-x: clip` cannot mask text outside the viewport.
Added controls are checked for 44×44 px targets. Long Sheet content deliberately
scrolls vertically: `markets-alerts-form-*` shows the lower form and reachable
Save action, complementing the top-of-sheet stored-alert captures.
All images are visually inspected for wrapping, clipped labels, public hashes,
verbatim errors and empty states. The approved components and styles are retained.

### Agent wallet W1 — Portfolio only

`agent-wallet-portfolio-devnet.png` and `agent-wallet-portfolio-no-wallet.png`
render the actual public desk records captured by `portfolio.live.test.mjs`
through `tools/uipreview/preview`, using the firmware's own `ui.h`. The devnet
capture is a newly created, unfunded disposable agent wallet (SOL 0, USDC 0),
not a funded-account demonstration. The empty capture shows the exact no-wallet
instruction. Both were visually inspected at 2× native resolution. Desktop
wallet-card and Fund-screen captures are documented below.

```sh
make -C tools/uipreview
tools/uipreview/preview firmware/build/w1-pad 2 firmware/build/w1-portfolio-devnet.json
tools/uipreview/preview firmware/build/w1-pad 2 firmware/build/w1-portfolio-no-wallet.json
```

### Agent wallet W3 — desktop card and pad funding

`agent-wallet-devnet-{1440,375}.png` captures the built Agent screen served by
the real authenticated desktop backend. `desk/test/app-agent-wallet.test.mjs`
creates an unfunded disposable desktop wallet, reads actual devnet SOL and SPL
balances, checks the clipboard address, independently decodes the local QR,
and sends its funding record to `tools/padsim` over fragmented TCP. Nothing is
funded or submitted. Both captures use a 1000 px viewport, reduced motion,
44×44 px controls and readable text bounds. The complete card is positioned
above the mobile navigation using ordinary page scrolling.

`agent-wallet-fund-devnet.png` renders that actual received Fund record through
`tools/uipreview/preview`. `agent-wallet-portfolio-devnet.png` and
`agent-wallet-portfolio-no-wallet.png` render the actual Portfolio records from
the full run's `portfolio.live.test.mjs`. These use the firmware's `ui.h` at
2× native resolution. Zero SOL/USDC belongs to real newly generated devnet
identities; unavailable market USD is stated honestly. These are simulator
and firmware-renderer captures, with no physical-pad funding claim.
