nickthelegend/xorrpad/docs/screens/01-boot.png

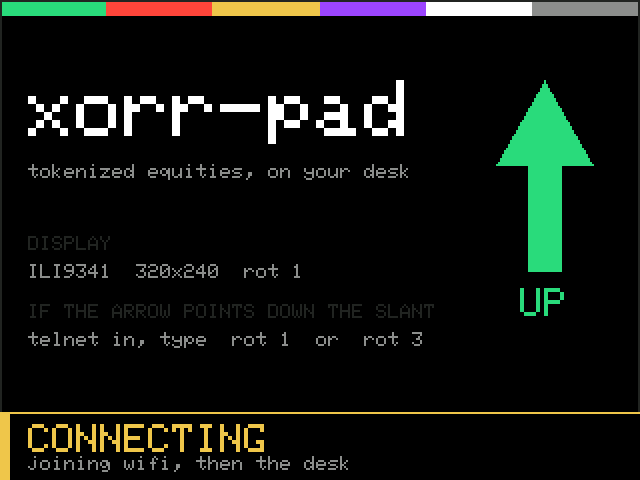
docs/screens/01-boot.png
