nickthelegend/xorrpad/docs/screens/02-home-weekend.png

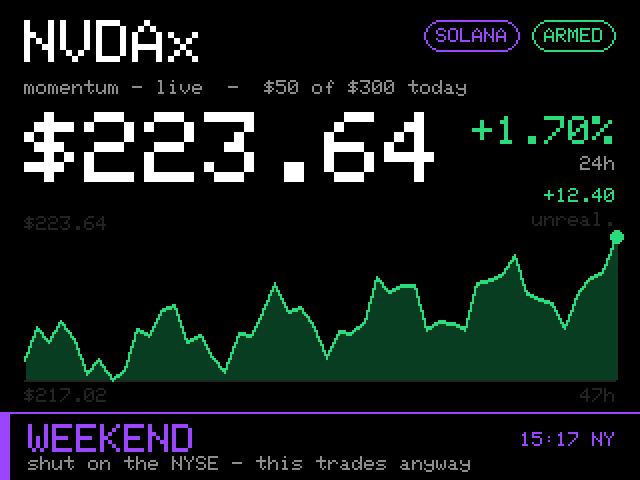
docs/screens/02-home-weekend.png
