nickthelegend/xorrpad/docs/screens/03-home-open-down.png

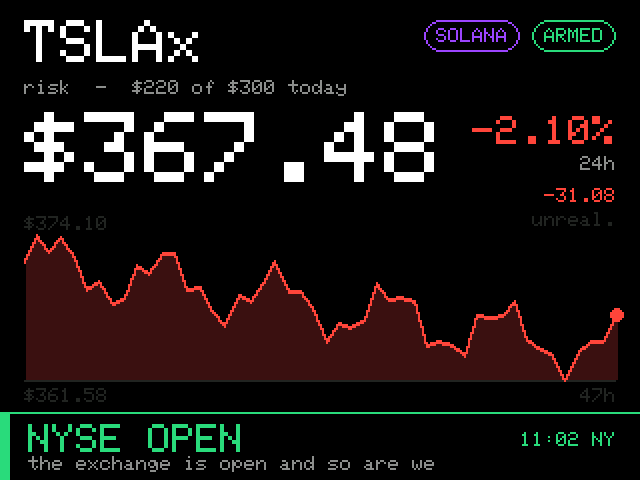
docs/screens/03-home-open-down.png
