nickthelegend/xorrpad/docs/screens/04-confirm-buy.png

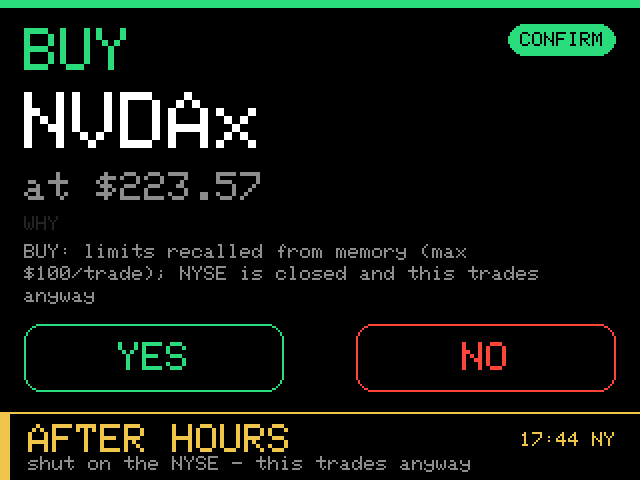
docs/screens/04-confirm-buy.png
