nickthelegend/xorrpad/docs/screens/05-stopped-wiped.png

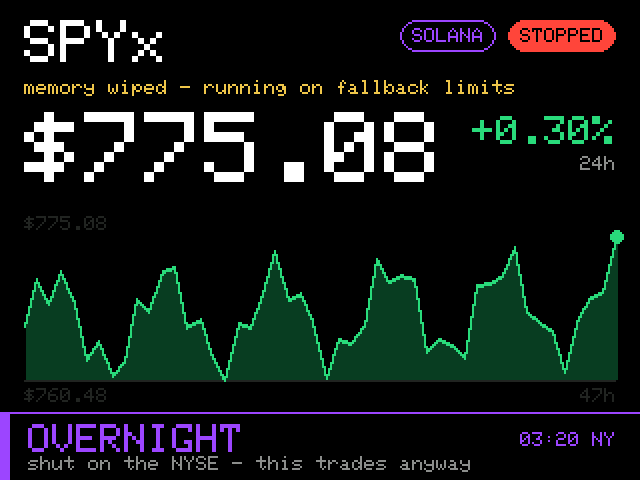
docs/screens/05-stopped-wiped.png
