nickthelegend/xorrpad/docs/screens/06-xlayer.png

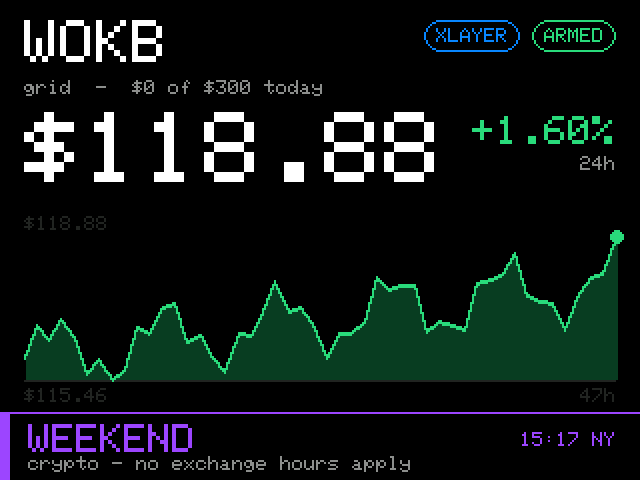
docs/screens/06-xlayer.png
