nickthelegend/xorrpad/docs/screens/07-offline.png

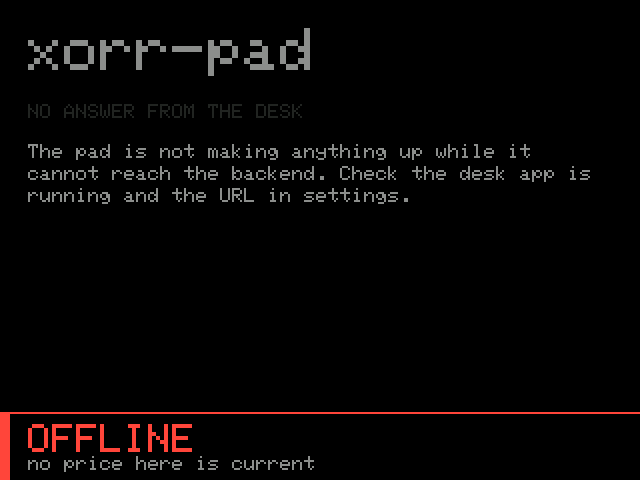
docs/screens/07-offline.png
