nickthelegend/xorrpad/docs/screens/08-no-chart.png

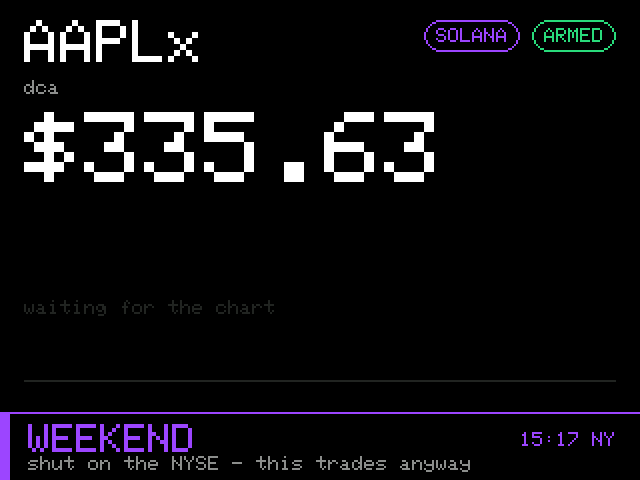
docs/screens/08-no-chart.png
