nickthelegend/xorrpad/docs/screens/phoenix-spot-before-1440.png

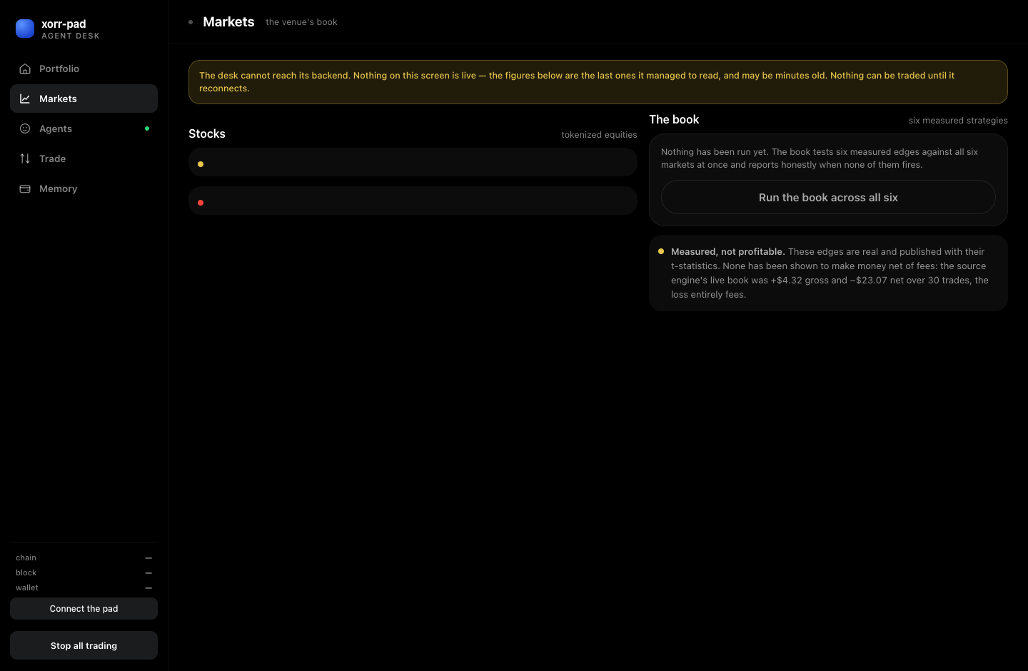
docs/screens/phoenix-spot-before-1440.png
