nickthelegend/xorrpad/docs/screens/solana-markets-after-375.png

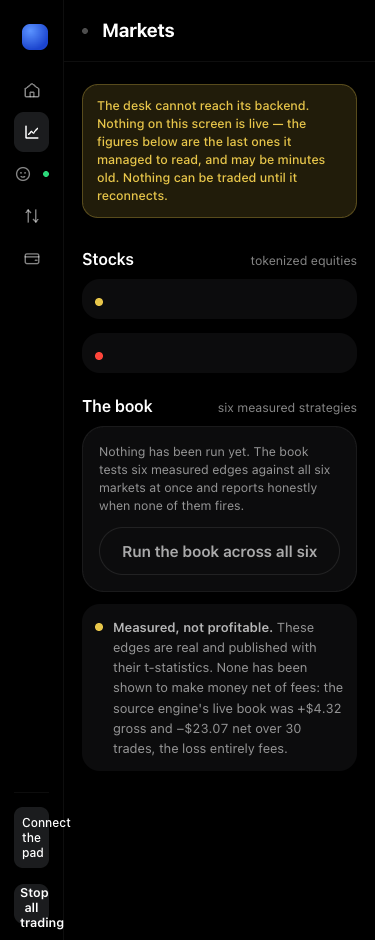
docs/screens/solana-markets-after-375.png
