nickthelegend/xorrpad/docs/screens/solana-markets-before-375.png

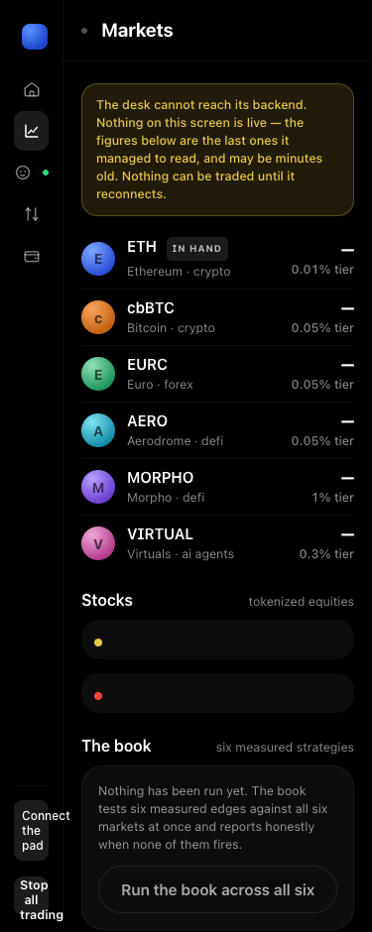
docs/screens/solana-markets-before-375.png
