nickthelegend/xorrpad/docs/screens/solana-markets-before-1440.png

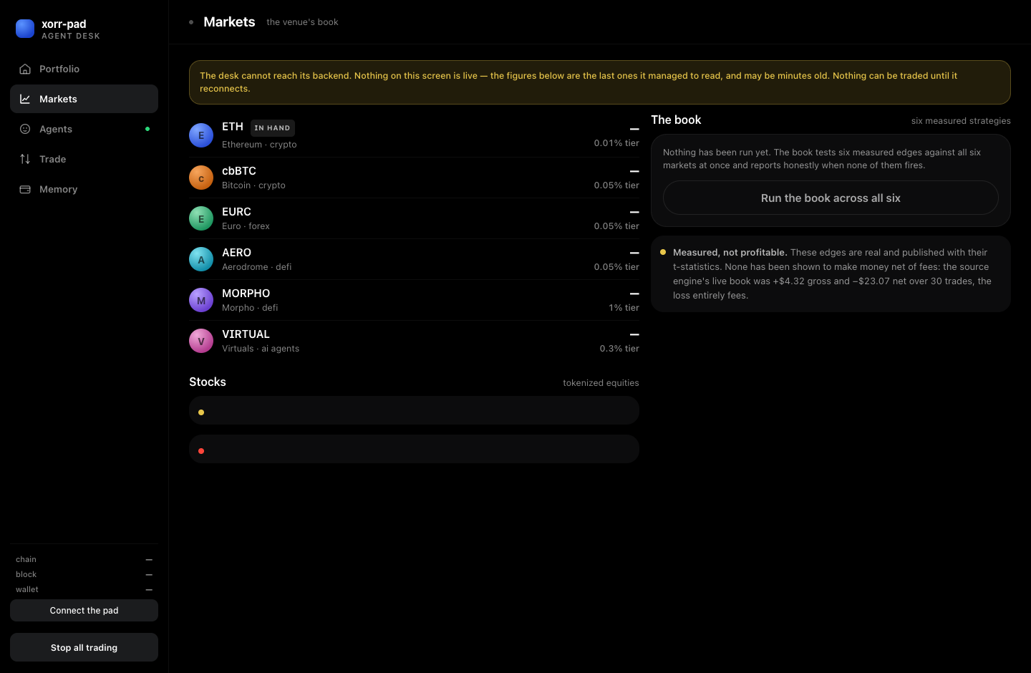
docs/screens/solana-markets-before-1440.png
