nickthelegend/xorrpad/docs/screens/solana-only-after-375.png

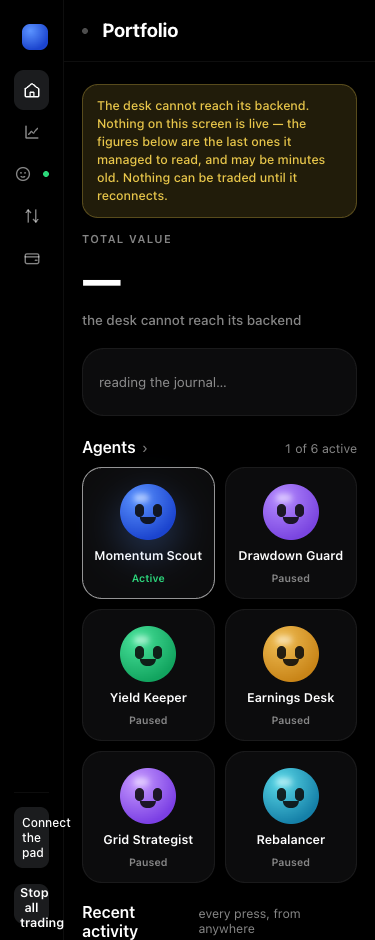
docs/screens/solana-only-after-375.png
