nickthelegend/xorrpad/docs/screens/solana-only-before-1440.png

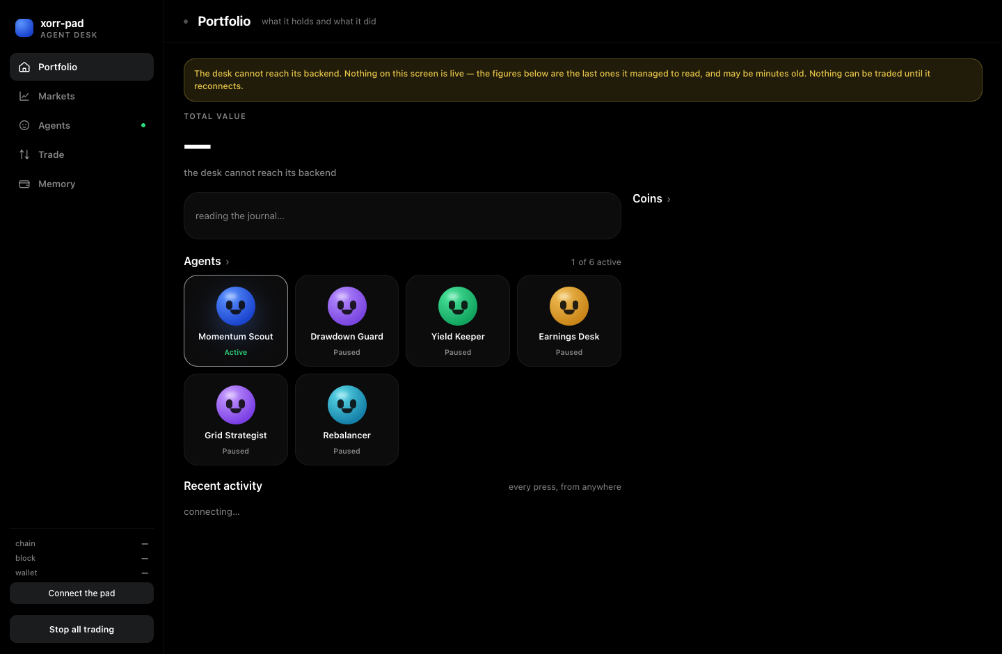
docs/screens/solana-only-before-1440.png
