nickthelegend/xorrpad/docs/screens/v4/ambient-device-375.png

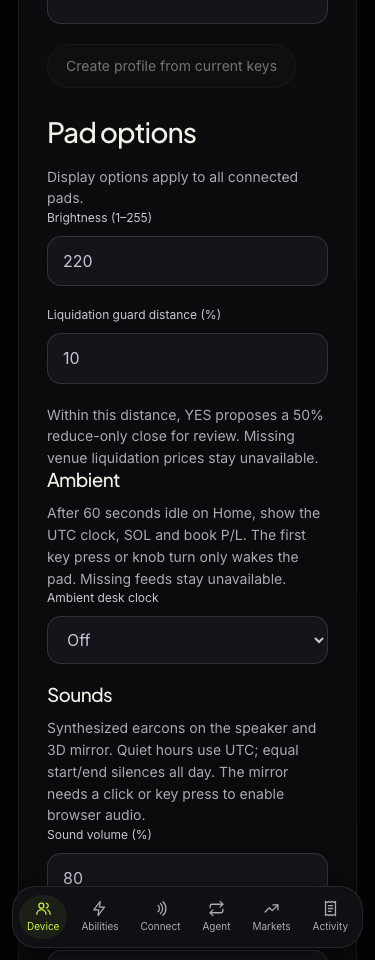
docs/screens/v4/ambient-device-375.png
