nickthelegend/xorrpad/docs/screens/v4/ambient-device-1440.png

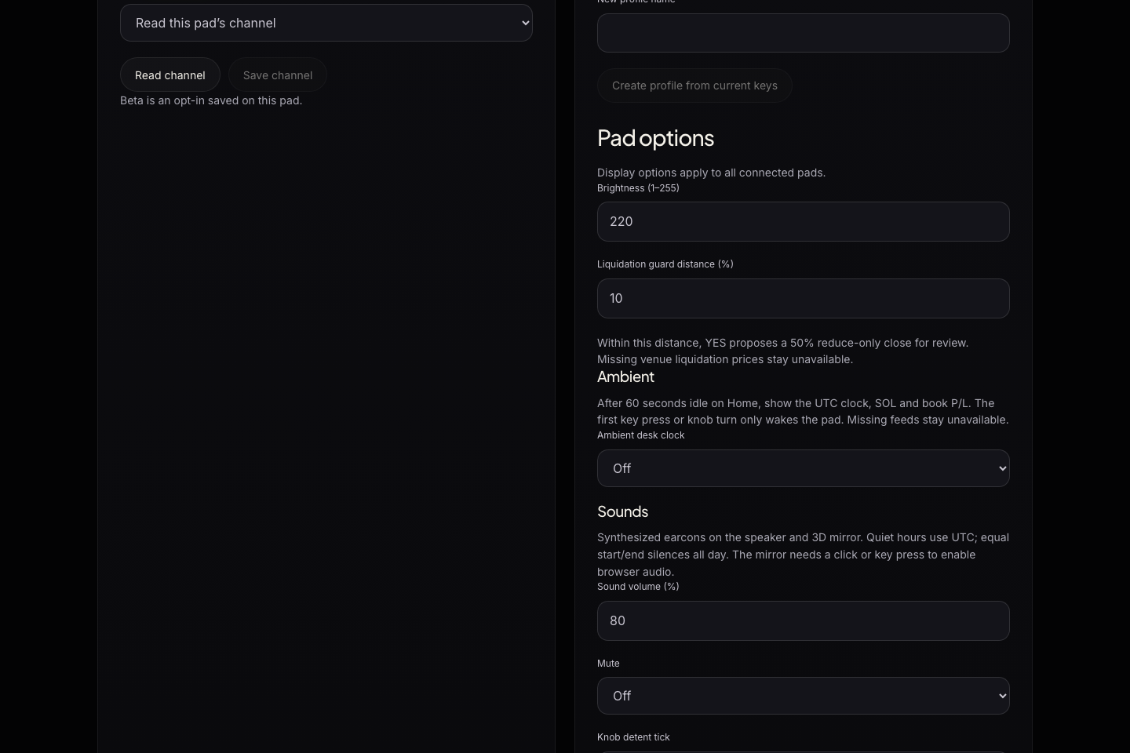
docs/screens/v4/ambient-device-1440.png
