nickthelegend/xorrpad/docs/screens/v4/ambient.png

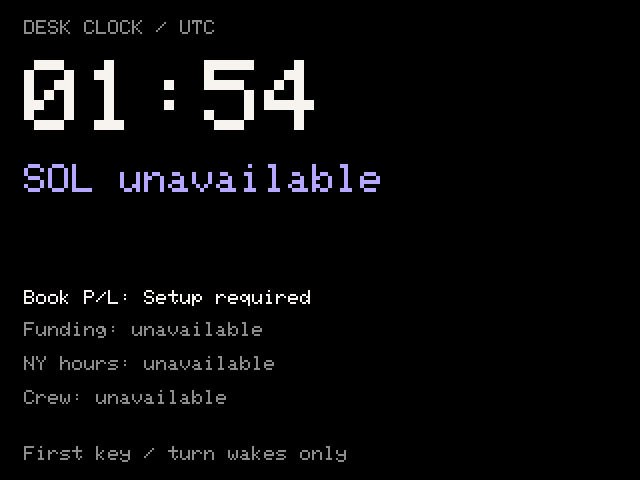
docs/screens/v4/ambient.png
