nickthelegend/xorrpad/docs/screens/v4/cooldown-layout.png

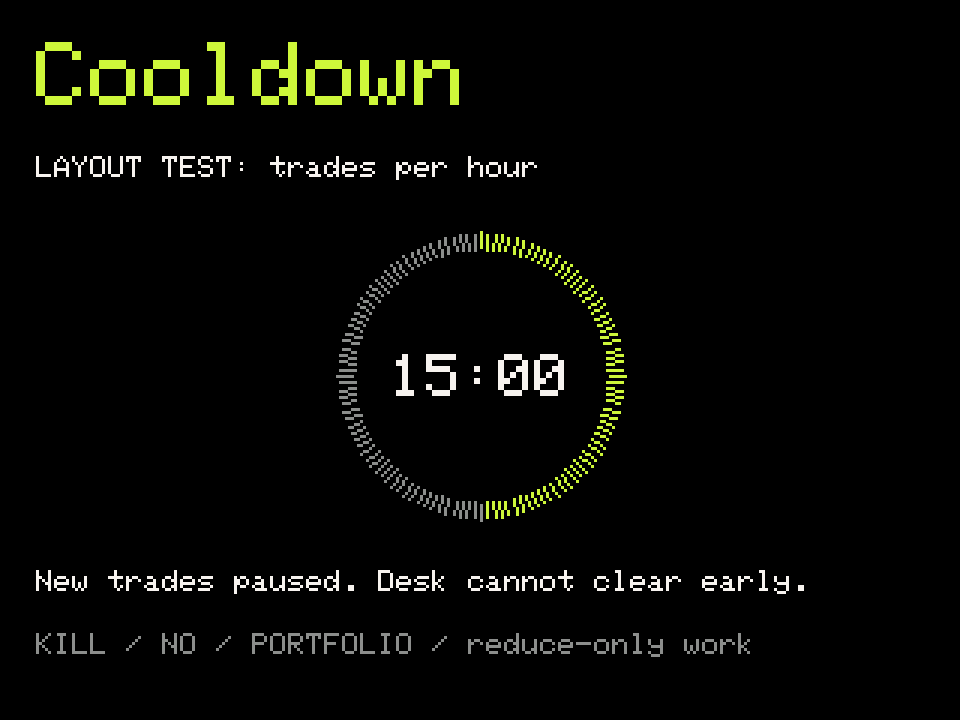
docs/screens/v4/cooldown-layout.png
