nickthelegend/xorrpad/docs/screens/v4/f10-tilt-375.png

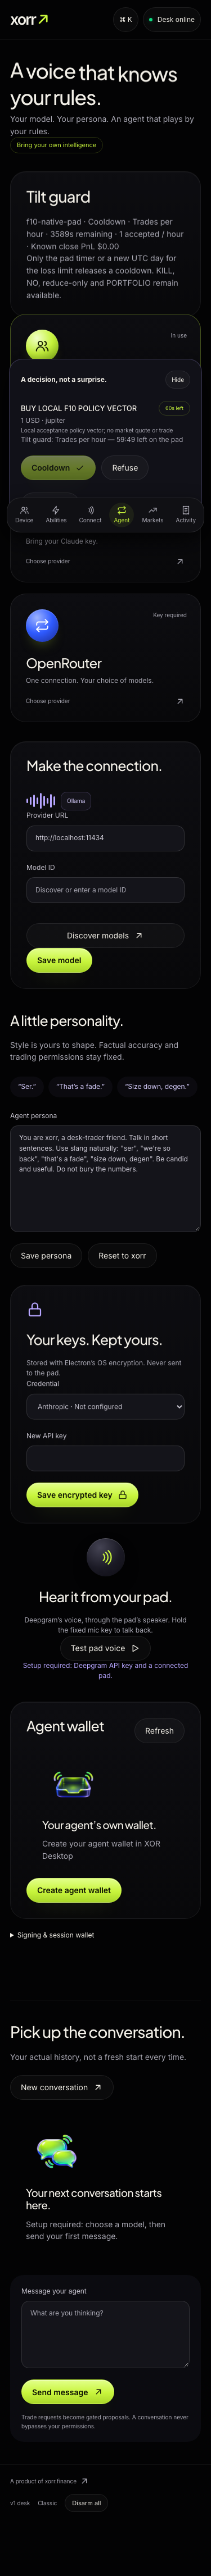
docs/screens/v4/f10-tilt-375.png
