nickthelegend/xorrpad/docs/screens/v4/f10-tilt-1440.png

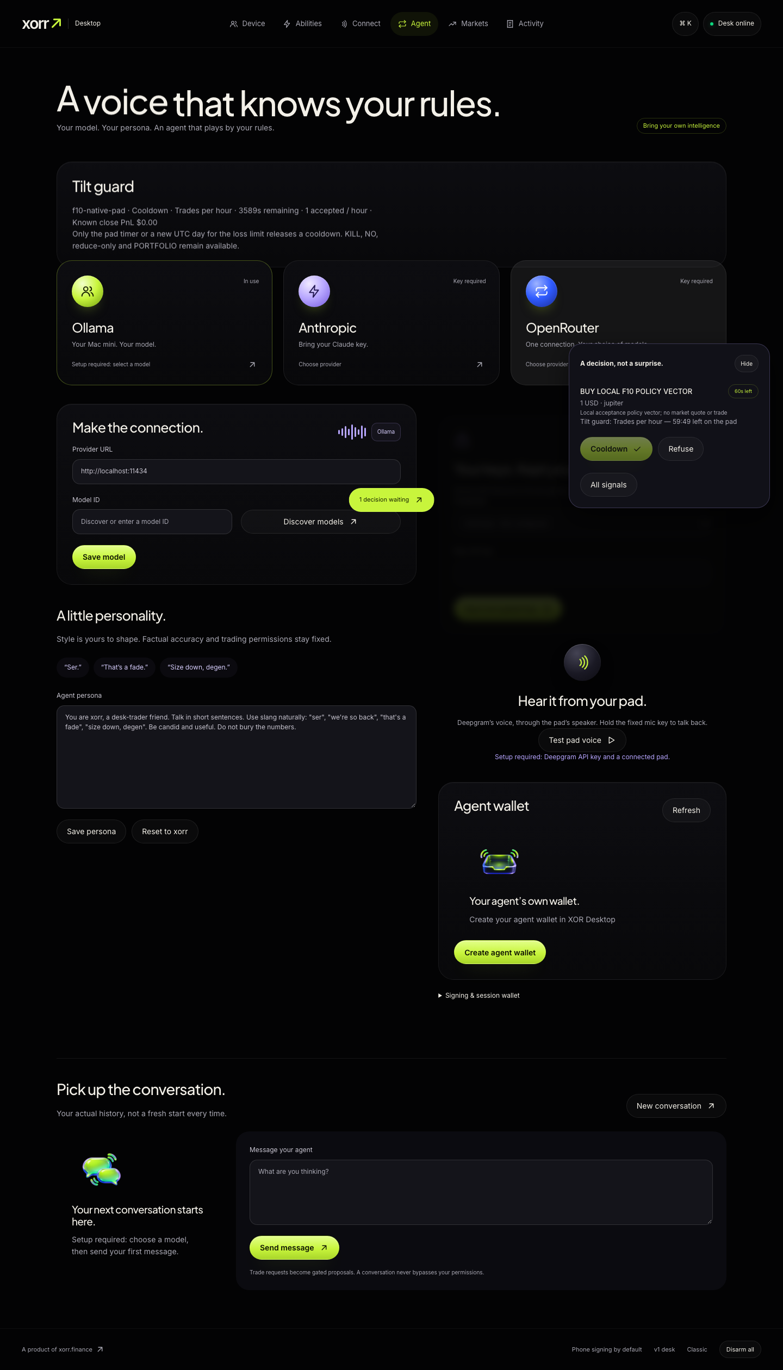
docs/screens/v4/f10-tilt-1440.png
