nickthelegend/xorrpad/docs/screens/v4/flatten-activity-375.png

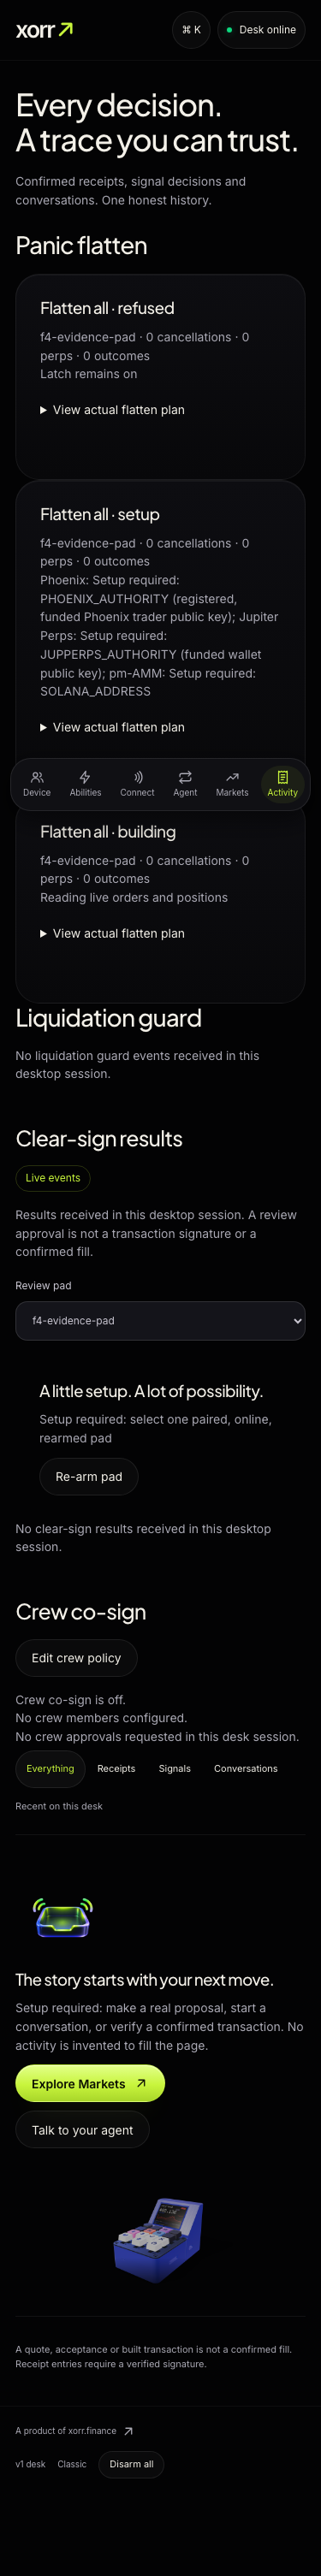
docs/screens/v4/flatten-activity-375.png
