nickthelegend/xorrpad/docs/screens/v4/flatten-activity-1440.png

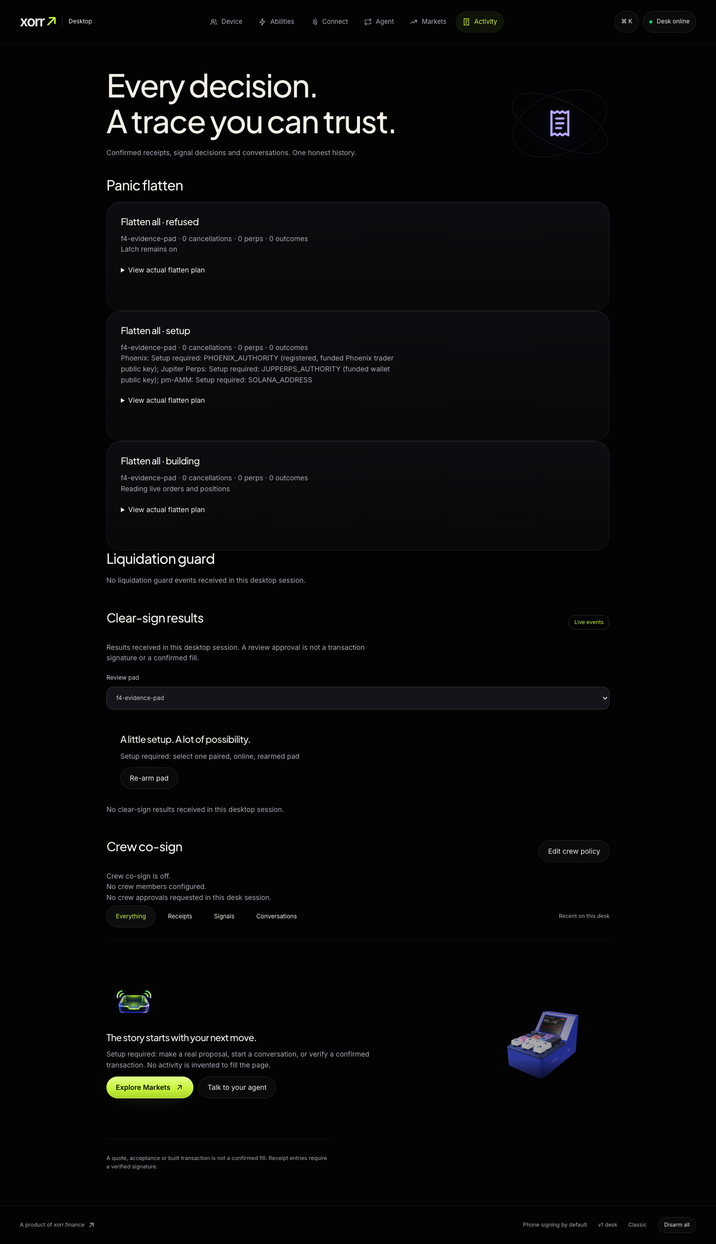
docs/screens/v4/flatten-activity-1440.png
