nickthelegend/xorrpad/docs/screens/v4/flatten-device-375.png

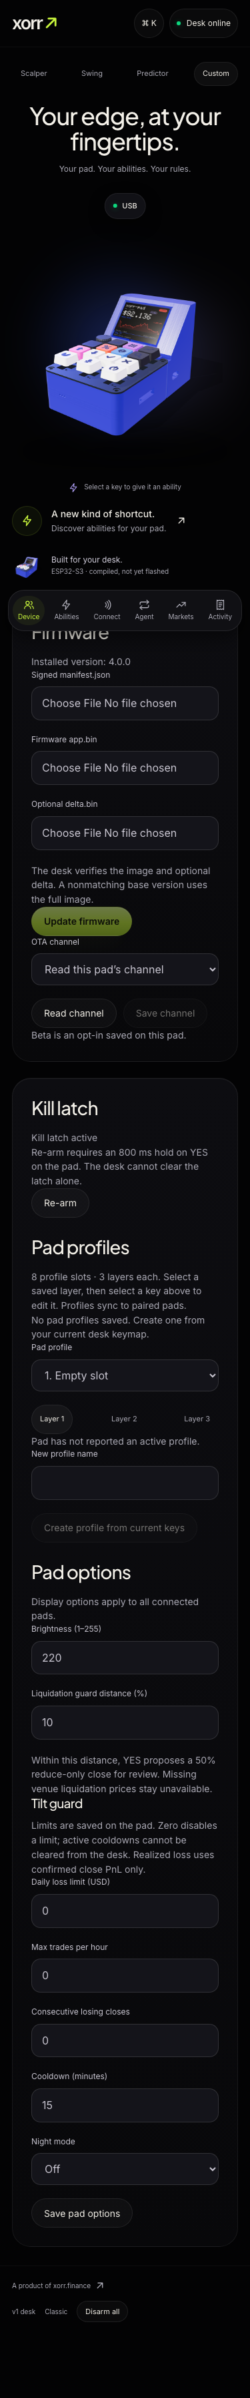
docs/screens/v4/flatten-device-375.png
