nickthelegend/xorrpad/docs/screens/v4/flatten-device-1440.png

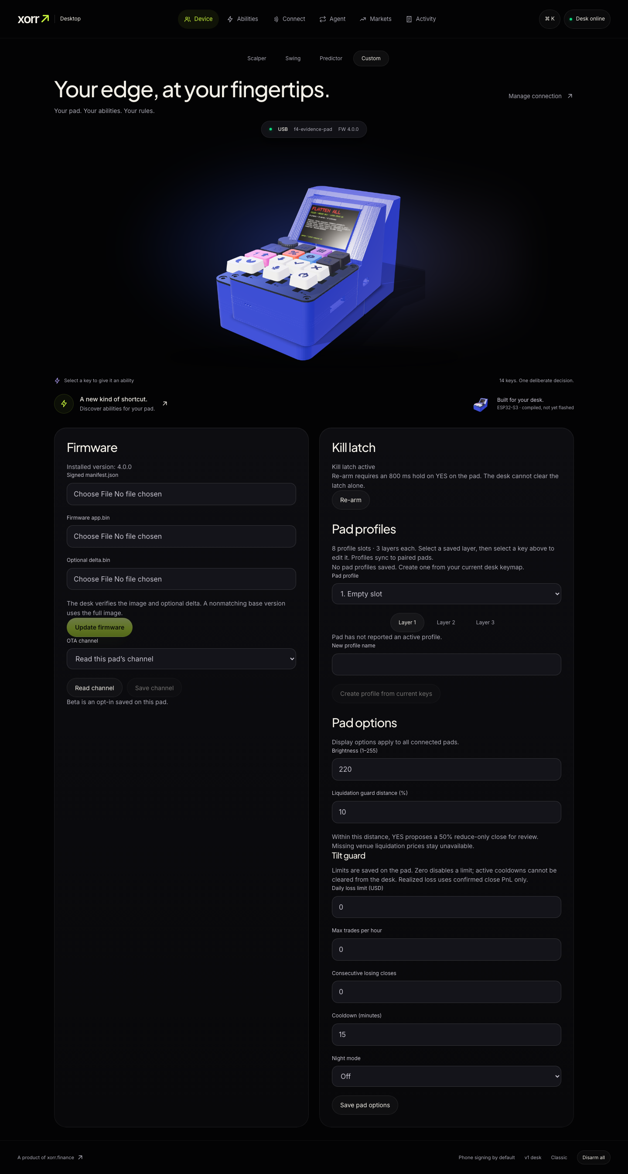
docs/screens/v4/flatten-device-1440.png
