nickthelegend/xorrpad/docs/screens/v4/liq-guard.png

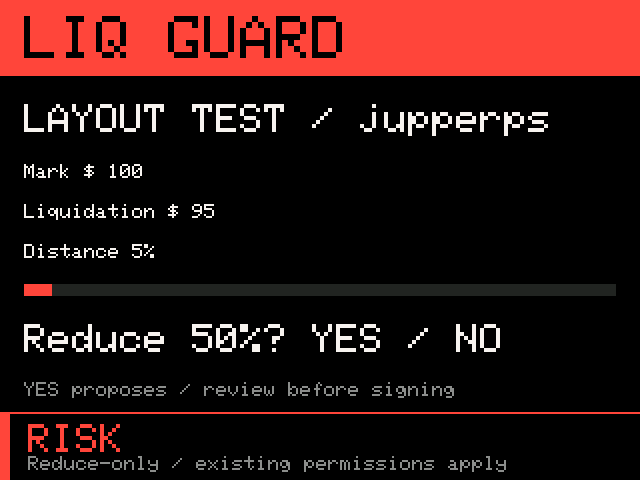
docs/screens/v4/liq-guard.png
