nickthelegend/xorrpad/docs/screens/v4/mirror-device-375.png

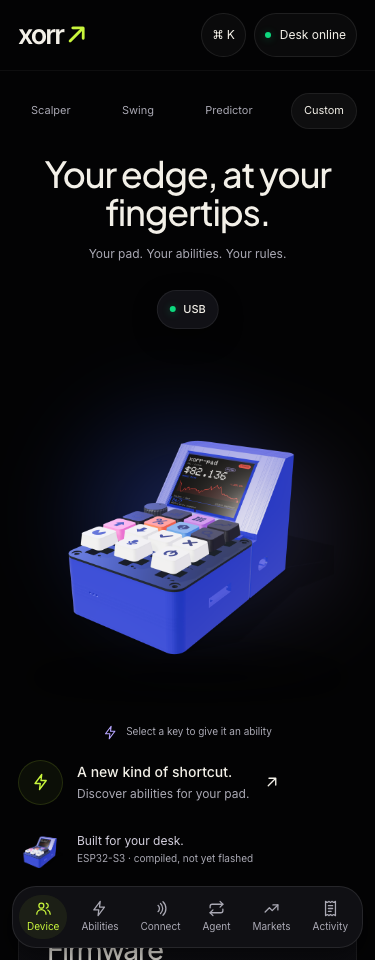
docs/screens/v4/mirror-device-375.png
