nickthelegend/xorrpad/docs/screens/v4/mirror-device-1440.png

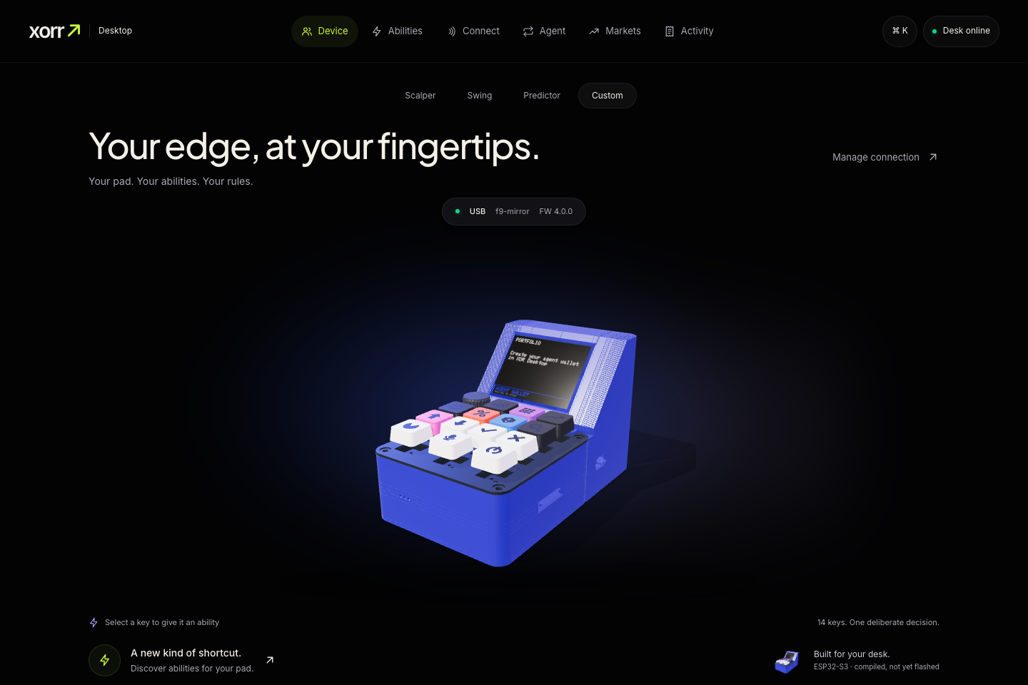
docs/screens/v4/mirror-device-1440.png
