nickthelegend/xorrpad/docs/screens/v4/mirror-pad-flatten-layout.png

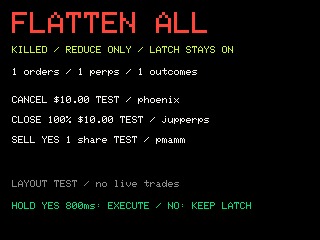
docs/screens/v4/mirror-pad-flatten-layout.png
