nickthelegend/xorrpad/docs/screens/v4/mirror-pad-outcome-positions.png

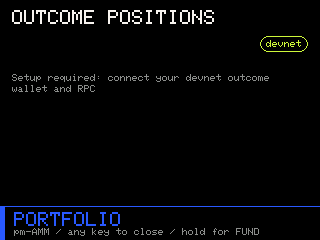
docs/screens/v4/mirror-pad-outcome-positions.png
