nickthelegend/xorrpad/docs/screens/v4/mirror-pad-perps-cockpit-layout.png

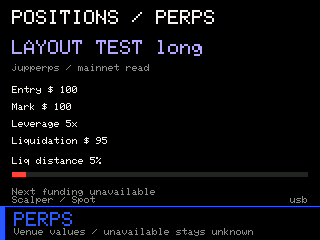
docs/screens/v4/mirror-pad-perps-cockpit-layout.png
