nickthelegend/xorrpad/docs/screens/v4/mirror-pad-perps-positions.png

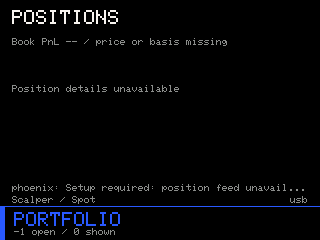
docs/screens/v4/mirror-pad-perps-positions.png
