nickthelegend/xorrpad/docs/screens/v4/mirror-pad-portfolio.png

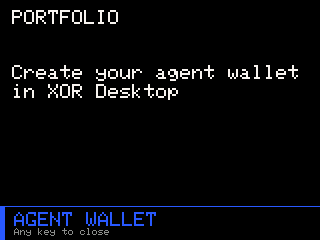
docs/screens/v4/mirror-pad-portfolio.png
