nickthelegend/xorrpad/docs/screens/v4/mirror-pad-predict.png

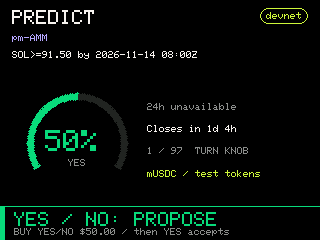
docs/screens/v4/mirror-pad-predict.png
