nickthelegend/xorrpad/docs/screens/v4/perps-device-375.png

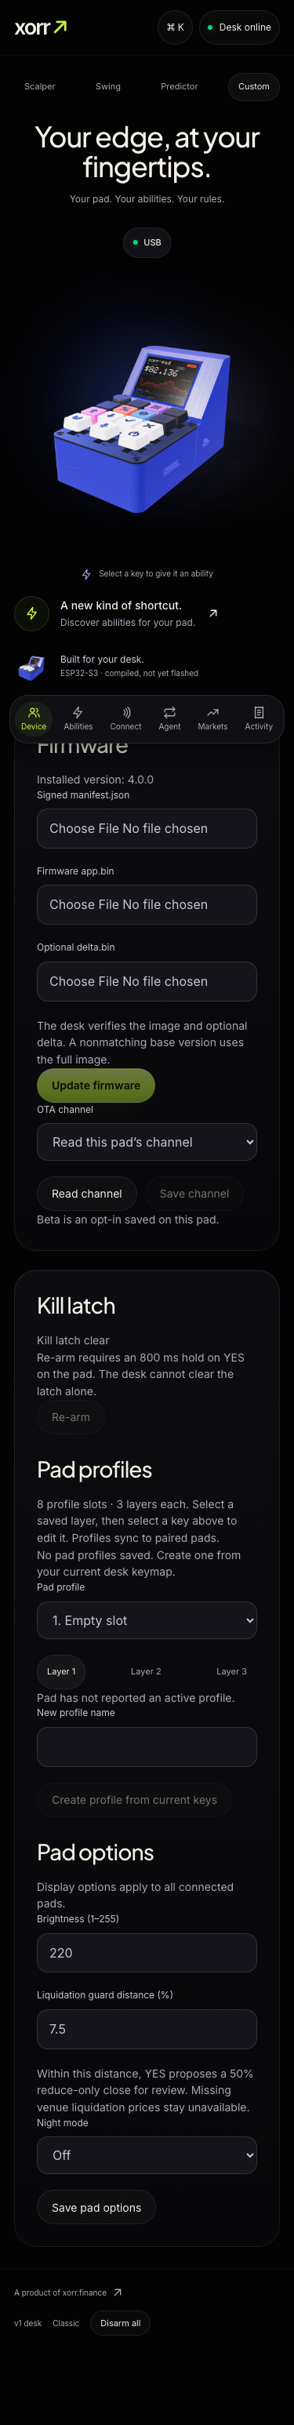
docs/screens/v4/perps-device-375.png
