nickthelegend/xorrpad/docs/screens/v4/perps-device-1440.png

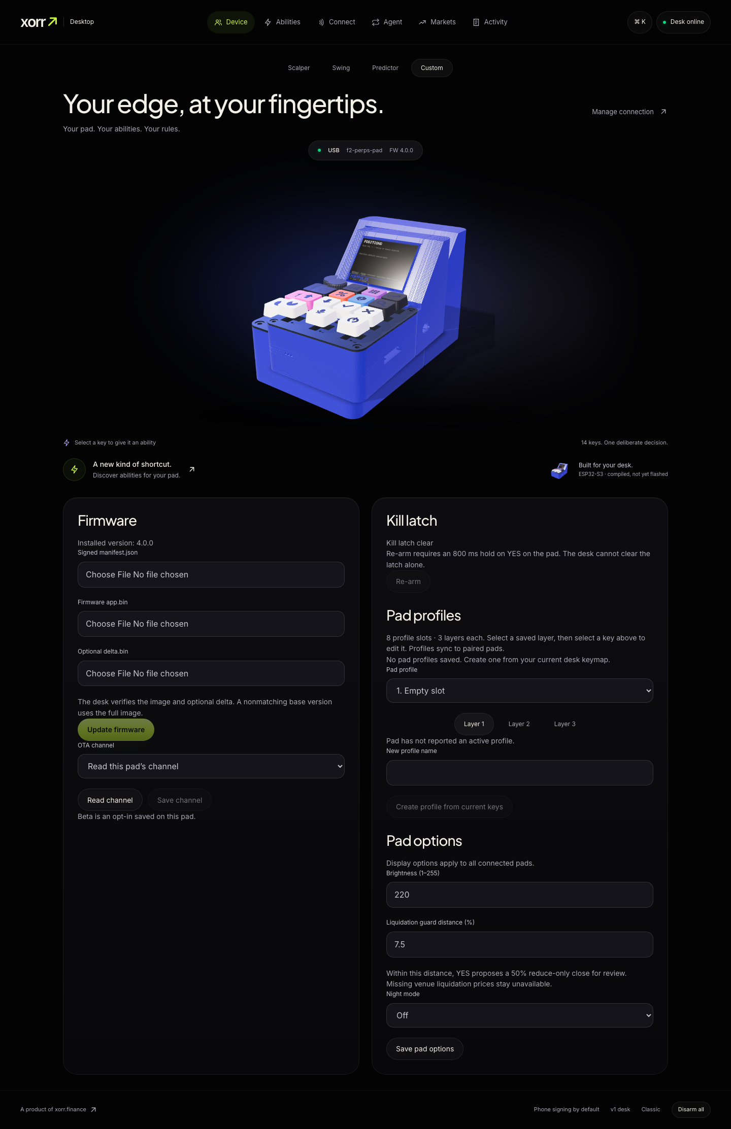
docs/screens/v4/perps-device-1440.png
