nickthelegend/xorrpad/docs/screens/v4/perps-positions.png

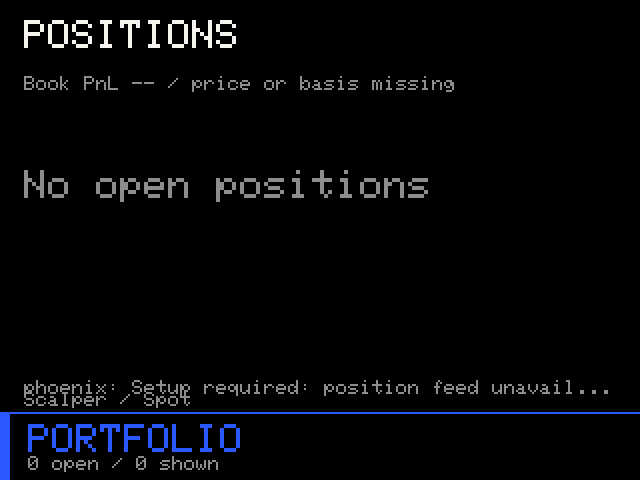
docs/screens/v4/perps-positions.png
