nickthelegend/xorrpad/docs/screens/v4/predict-markets-375.png

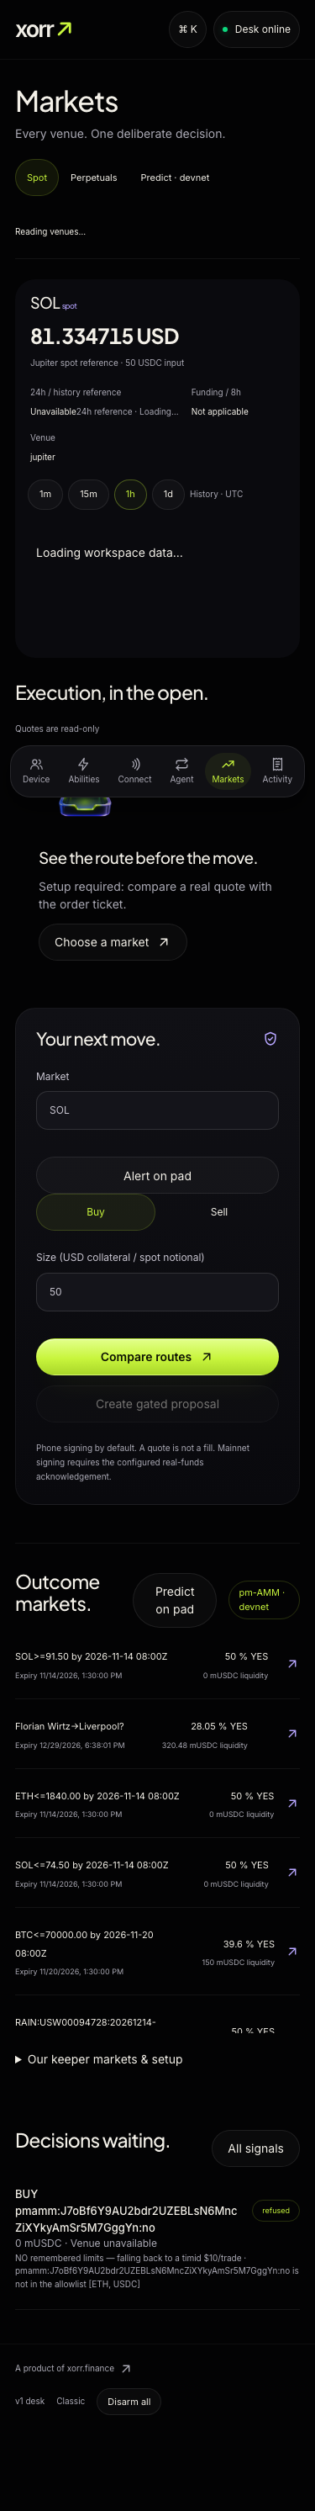
docs/screens/v4/predict-markets-375.png
