nickthelegend/xorrpad/docs/screens/v4/predict-markets-1440.png

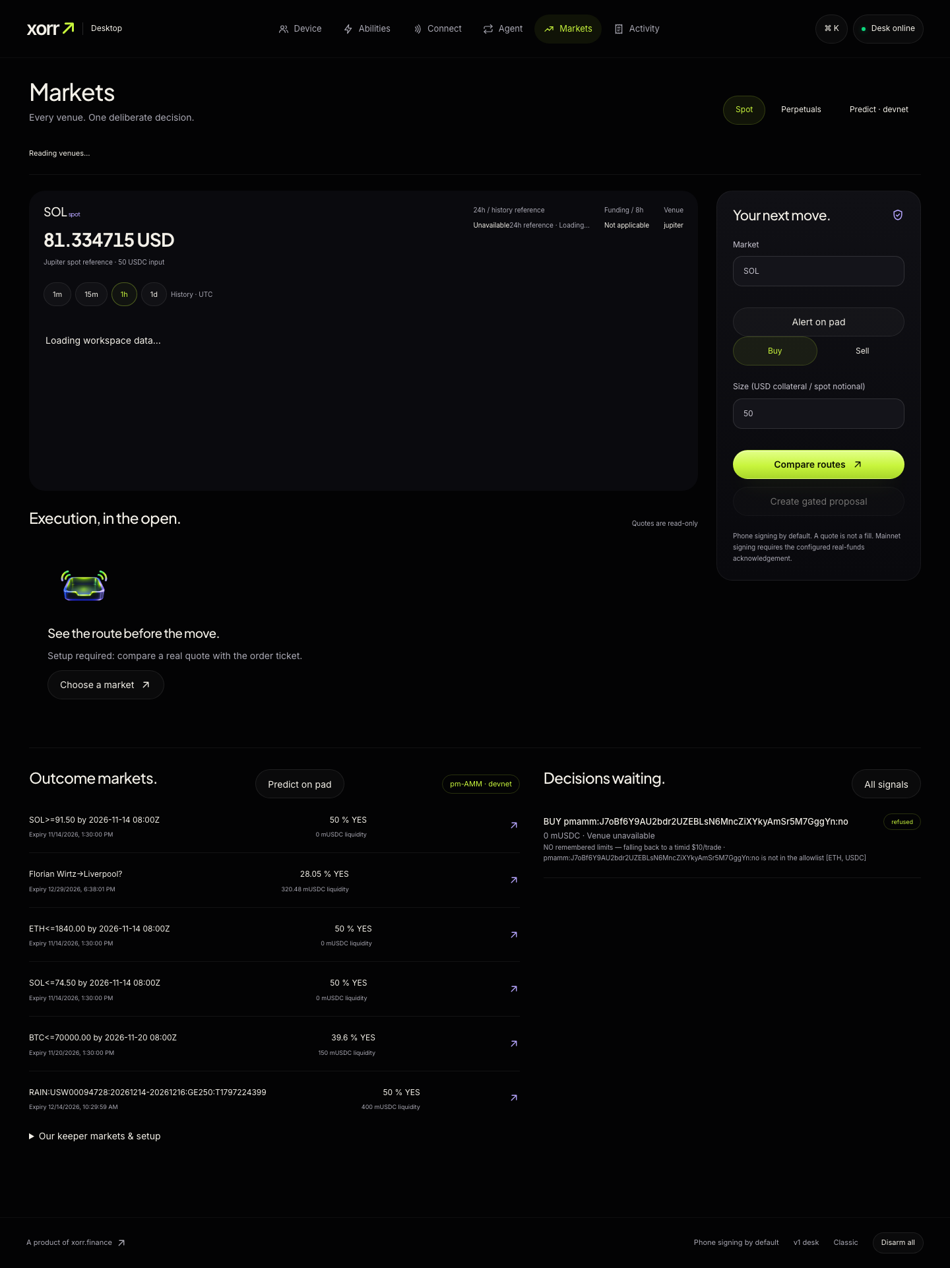
docs/screens/v4/predict-markets-1440.png
