nickthelegend/xorrpad/docs/screens/v4/release-activity-375.png

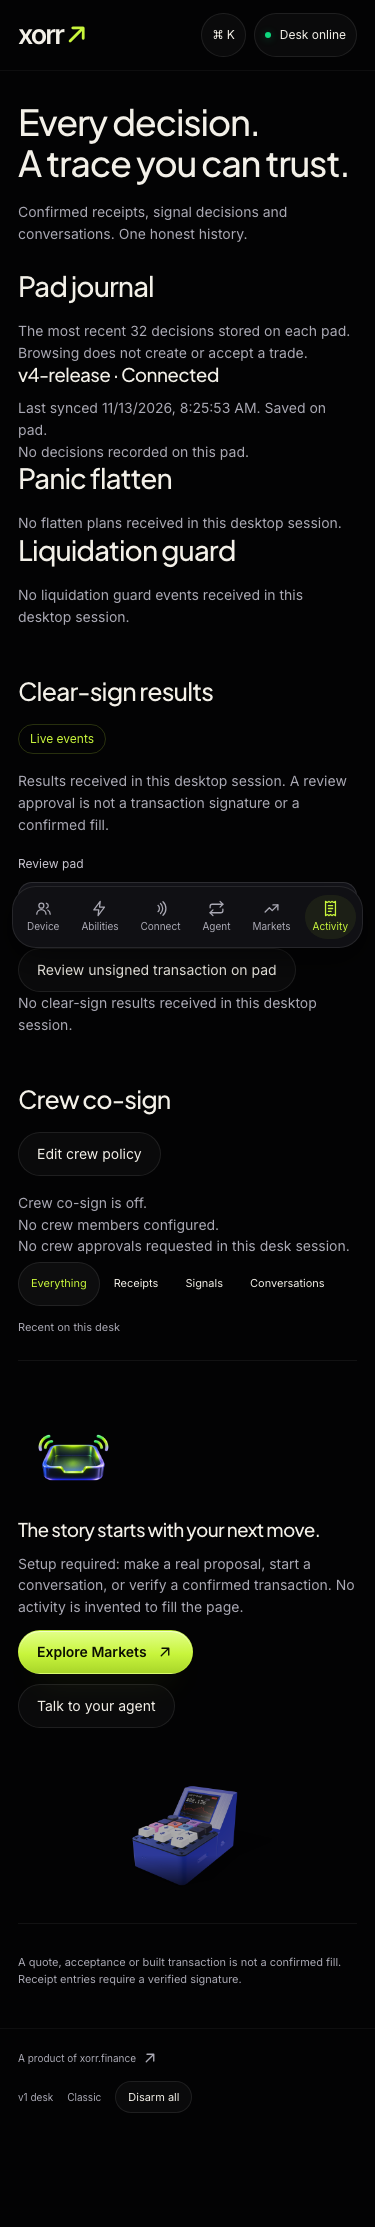
docs/screens/v4/release-activity-375.png
