nickthelegend/xorrpad/docs/screens/v4/release-activity-1440.png

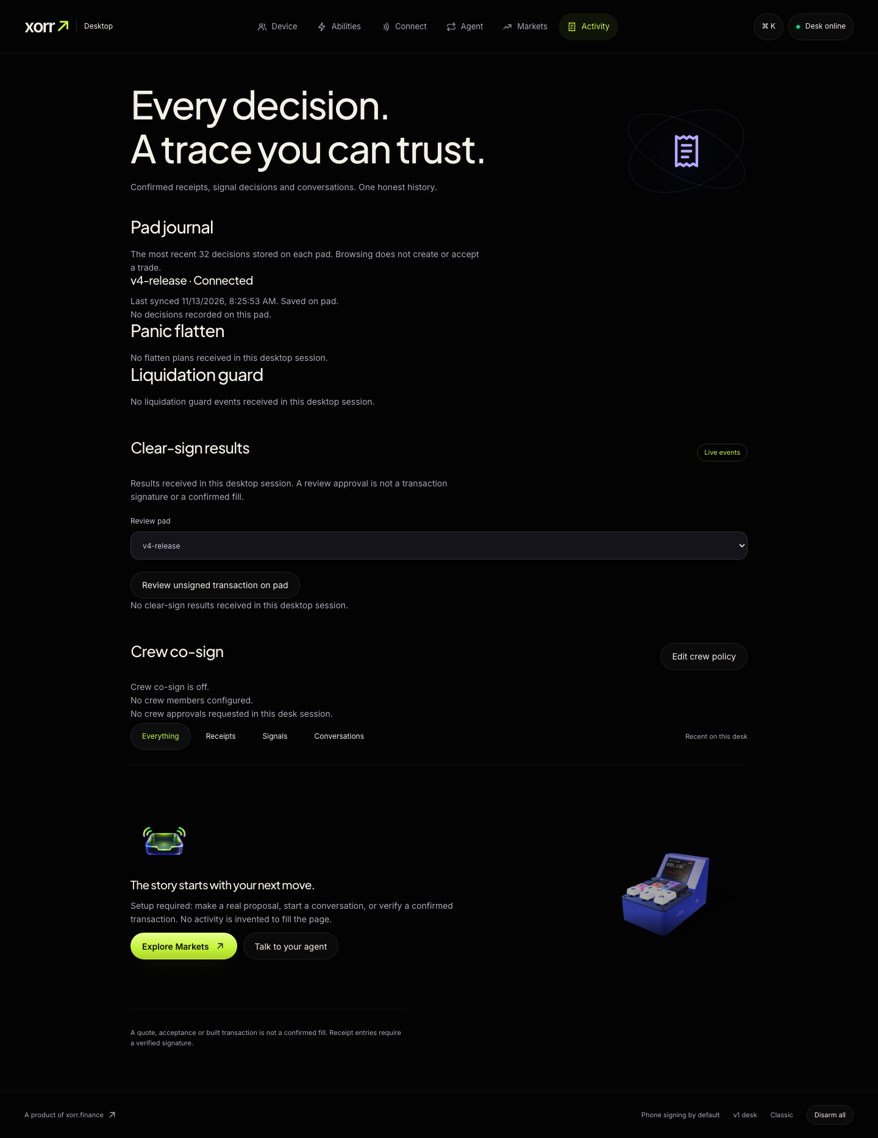
docs/screens/v4/release-activity-1440.png
