nickthelegend/xorrpad/docs/screens/v4/release-agent-1440.png

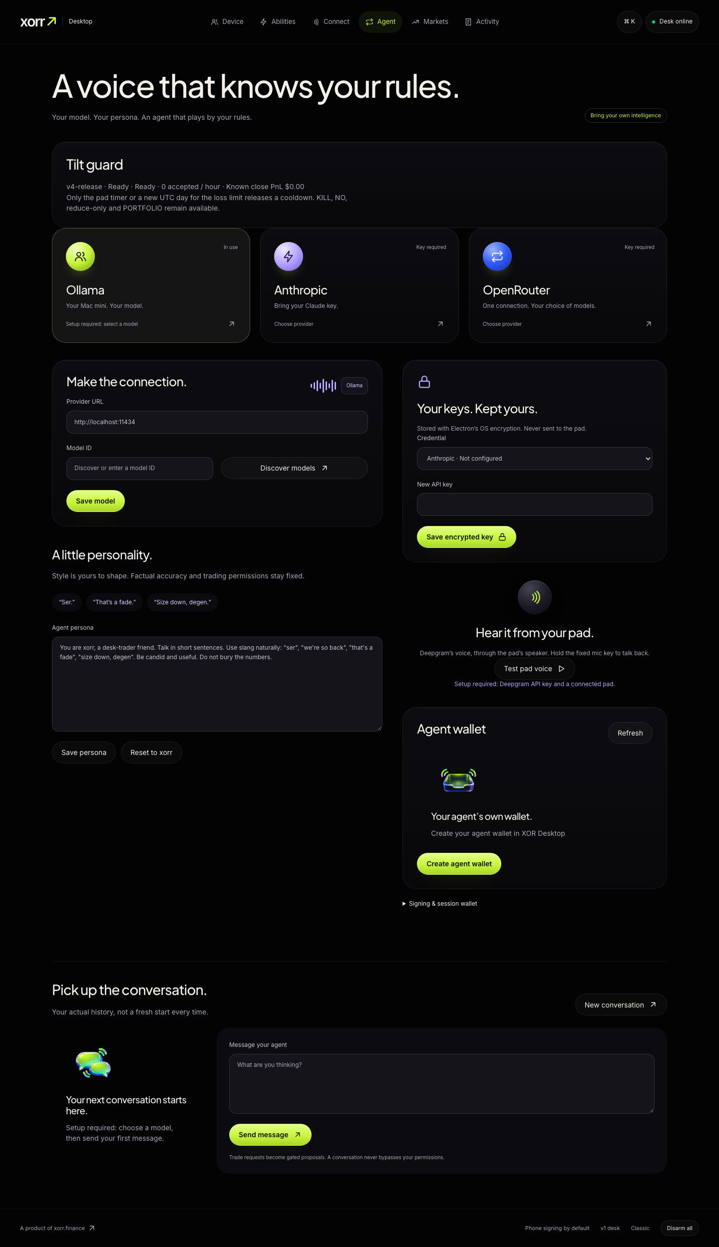
docs/screens/v4/release-agent-1440.png
