nickthelegend/xorrpad/docs/screens/v4/release-device-1440.png

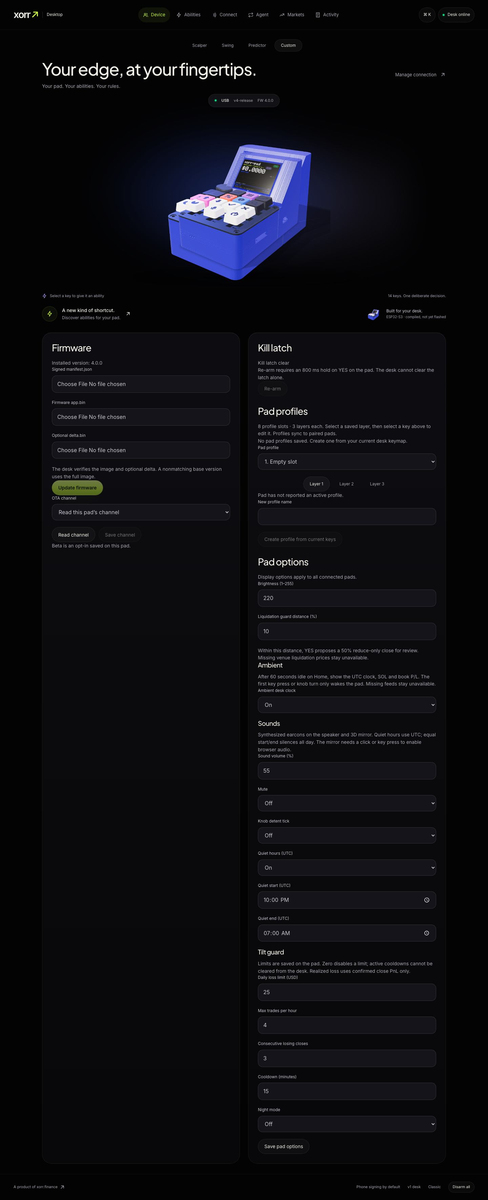
docs/screens/v4/release-device-1440.png
