nickthelegend/xorrpad/docs/screens/v4/release-markets-375.png

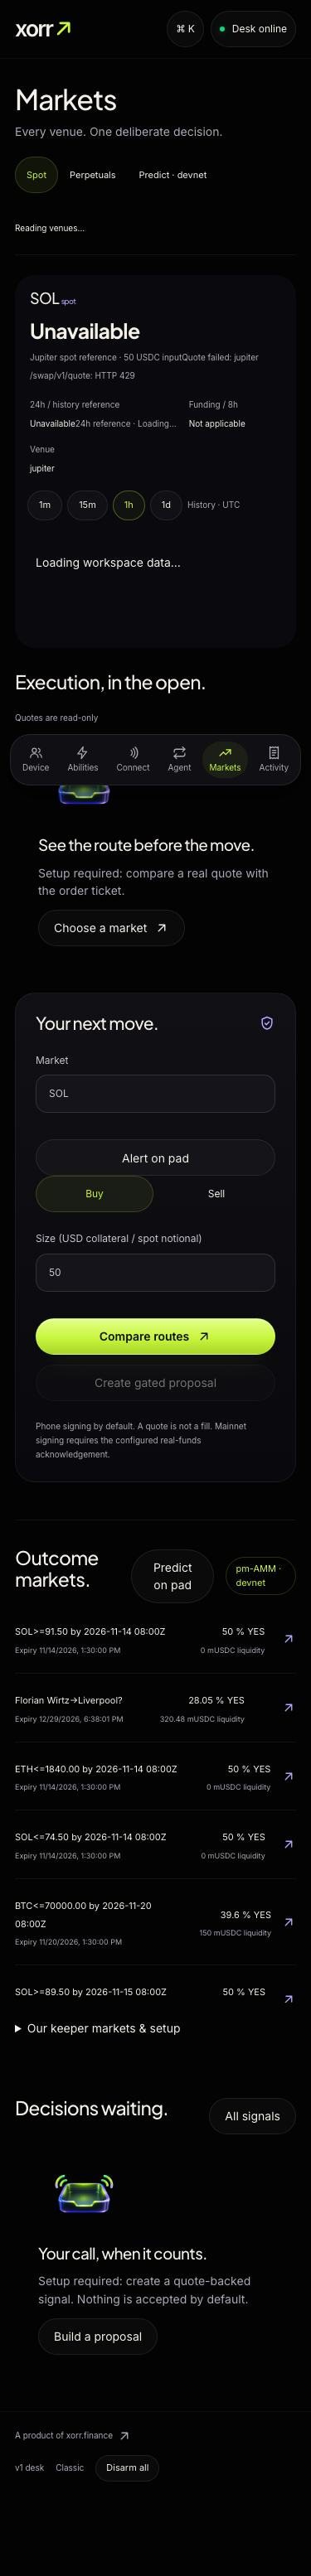
docs/screens/v4/release-markets-375.png
