nickthelegend/xorrpad/docs/screens/v4/release-tilt-guard-375.png

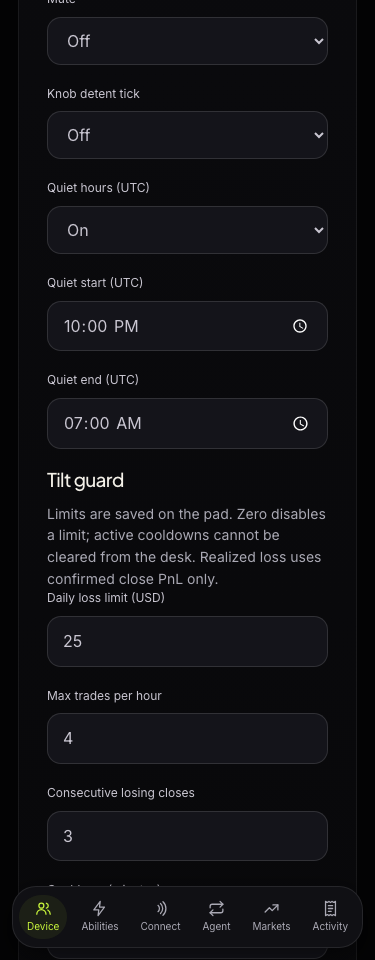
docs/screens/v4/release-tilt-guard-375.png
