nickthelegend/xorrpad/docs/screens/v4/scan-activity-375.png

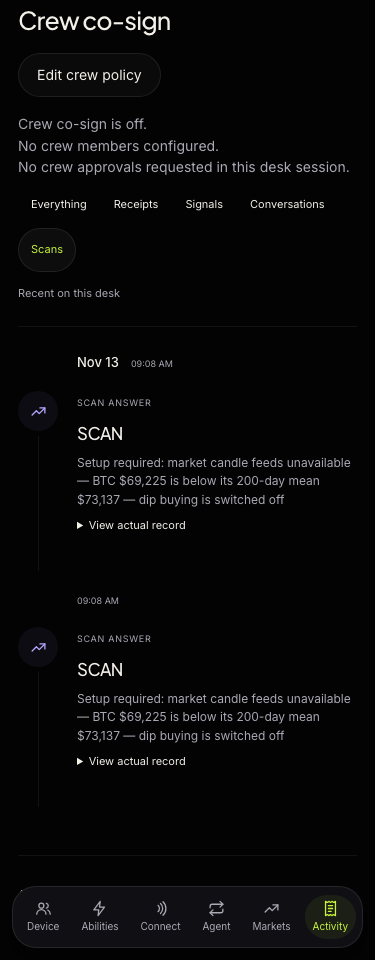
docs/screens/v4/scan-activity-375.png
