nickthelegend/xorrpad/docs/screens/v4/scan-activity-1440.png

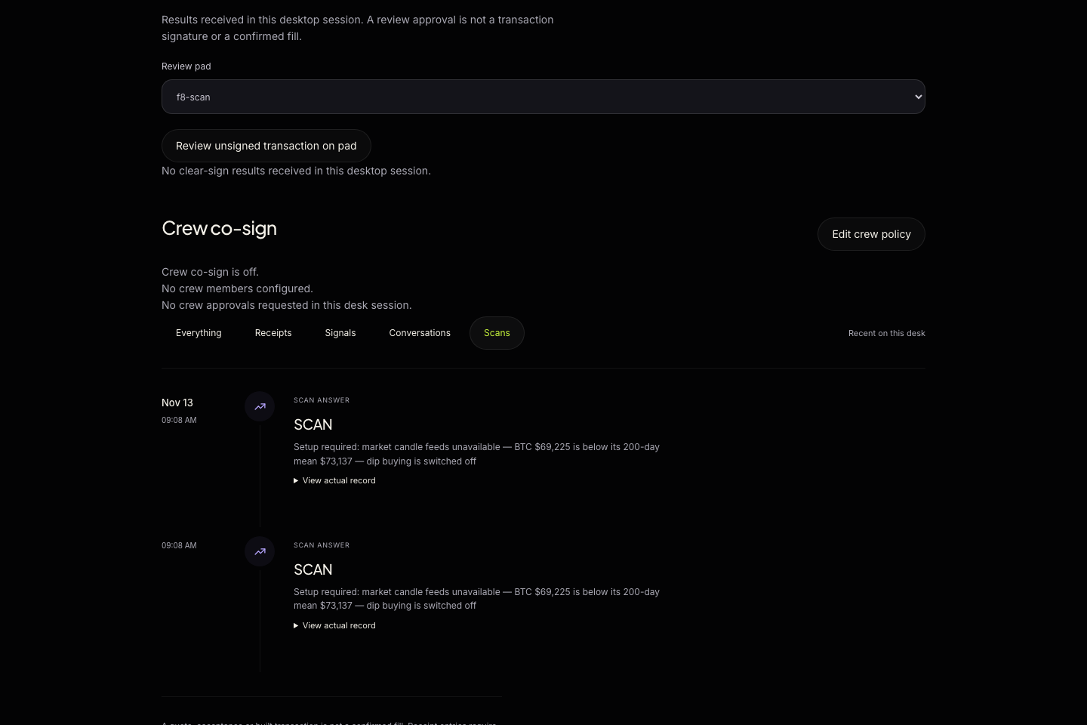
docs/screens/v4/scan-activity-1440.png
