nickthelegend/xorrpad/docs/screens/v4/scan-markets-375.png

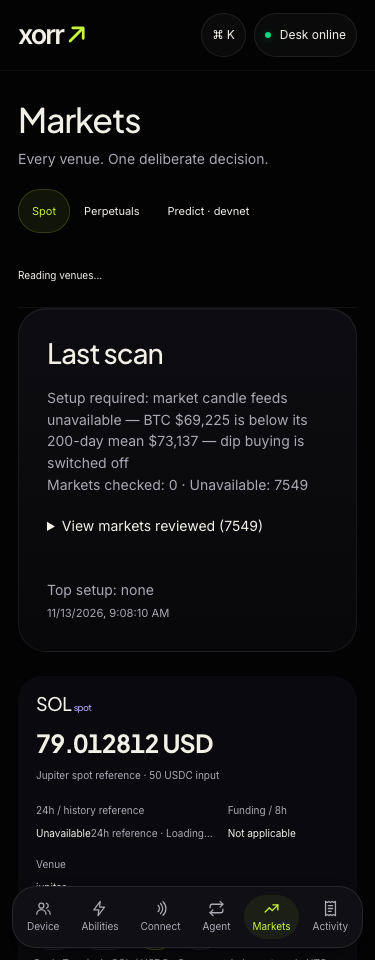
docs/screens/v4/scan-markets-375.png
