nickthelegend/xorrpad/docs/screens/v4/scan-markets-1440.png

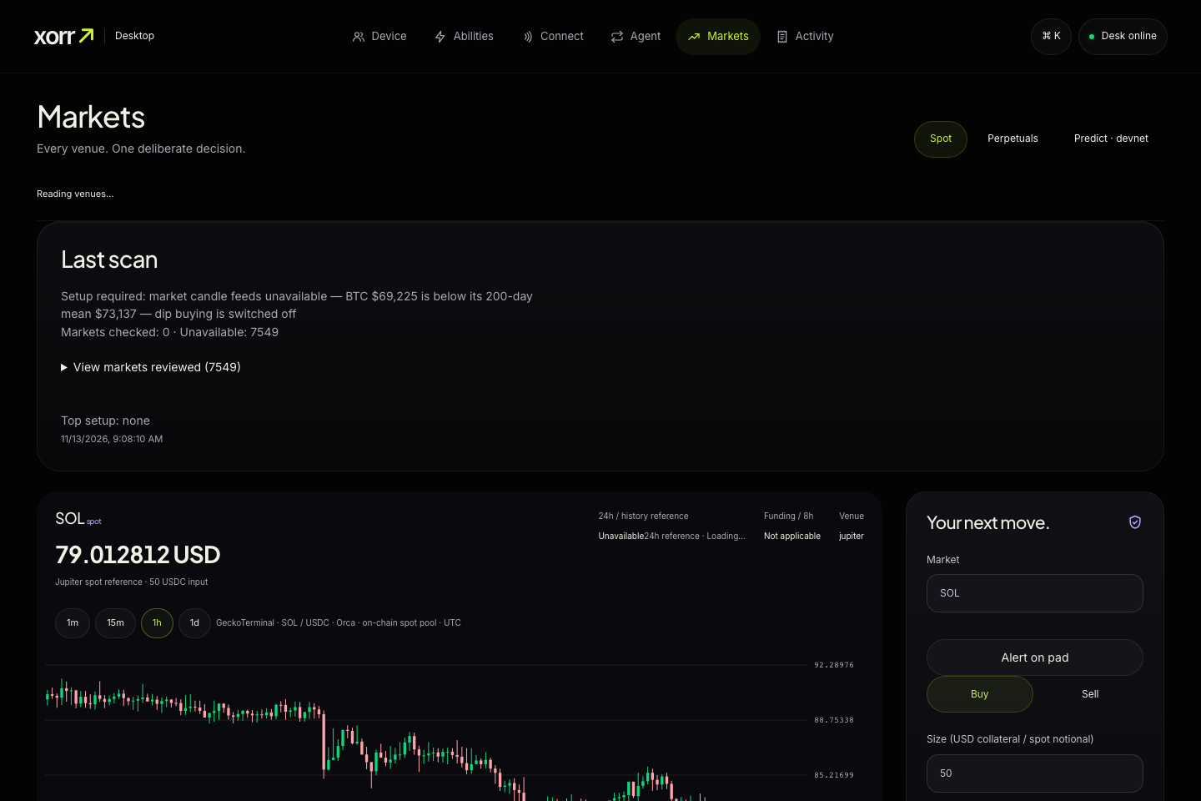
docs/screens/v4/scan-markets-1440.png
