nickthelegend/xorrpad/docs/screens/v4/scan.png

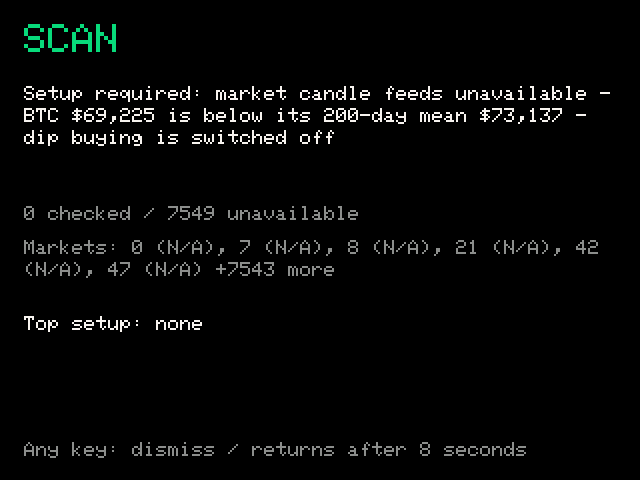
docs/screens/v4/scan.png
