nickthelegend/xorrpad/docs/screens/v4/sounds-device-375.png

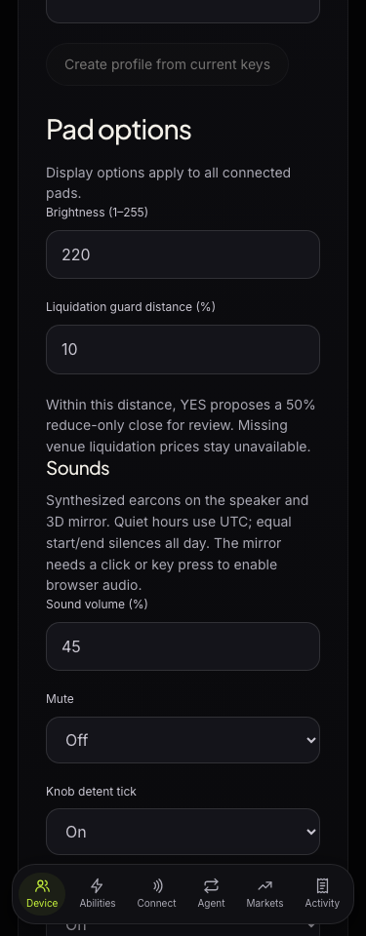
docs/screens/v4/sounds-device-375.png
