nickthelegend/xorrpad/docs/screens/v4/tilt-agent-375.png

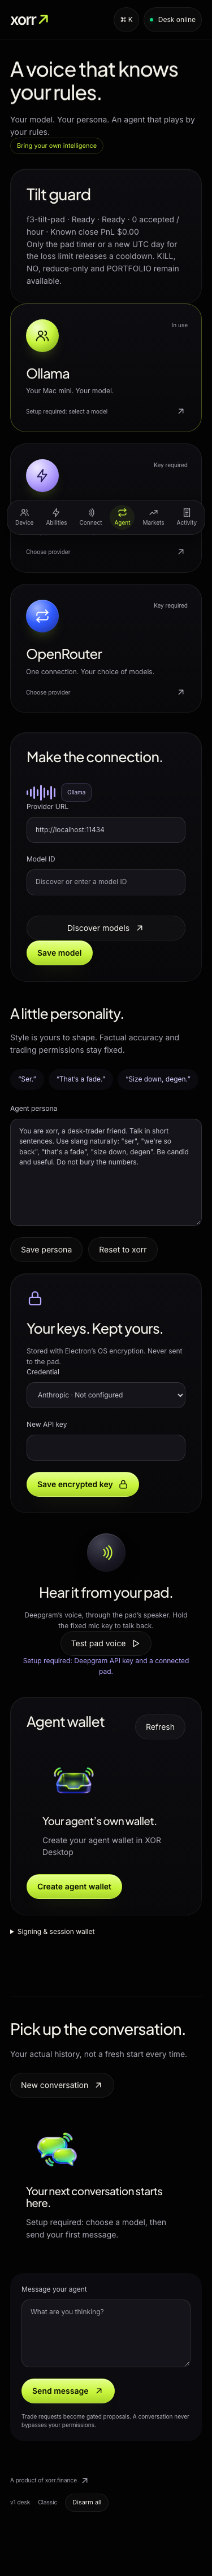
docs/screens/v4/tilt-agent-375.png
