nickthelegend/xorrpad/hardware/generated/core/fab/core-bottom.png

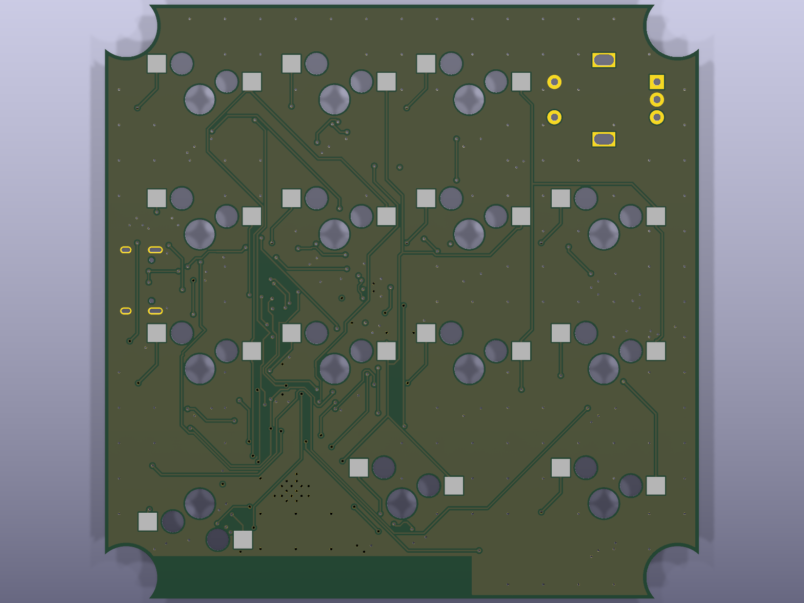
hardware/generated/core/fab/core-bottom.png
