nickthelegend/xorrpad/hardware/generated/core/fab/core-three-quarter.png

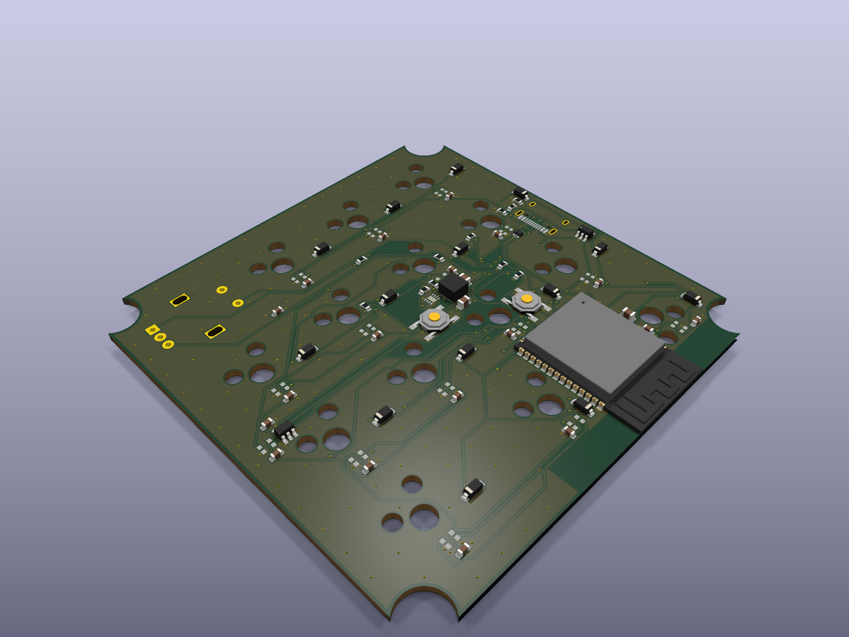
hardware/generated/core/fab/core-three-quarter.png
