nickthelegend/xorrpad/hardware/generated/core/fab/core-top.png

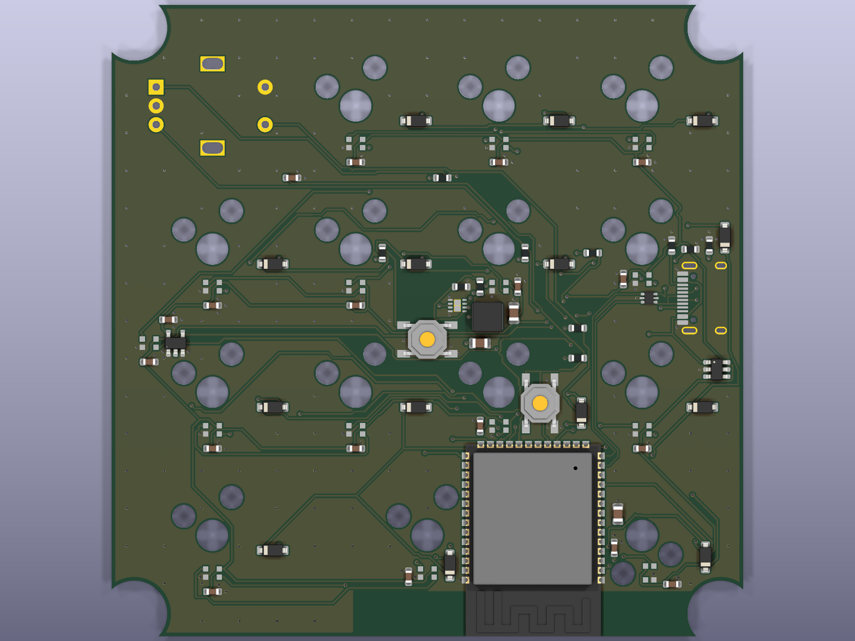
hardware/generated/core/fab/core-top.png
