nickthelegend/xorrpad/hardware/generated/pro/fab/pro-bottom.png

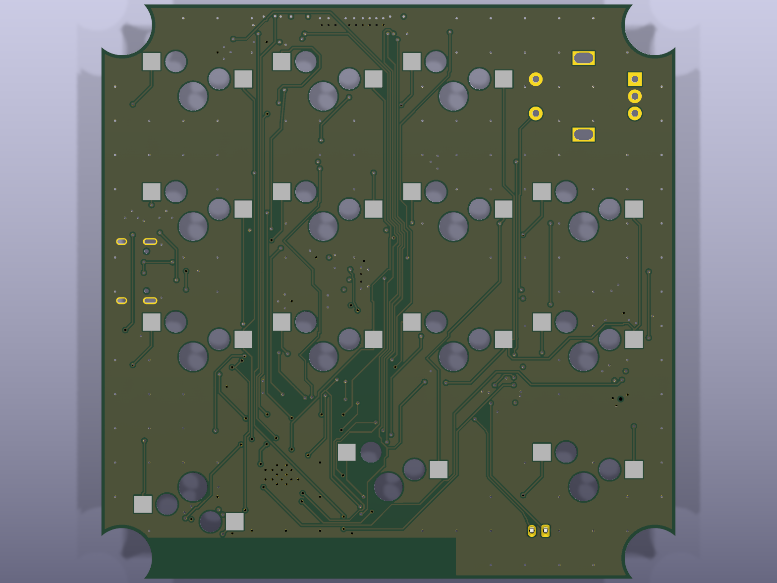
hardware/generated/pro/fab/pro-bottom.png
