nickthelegend/xorrpad/hardware/generated/pro/fab/pro-top.png

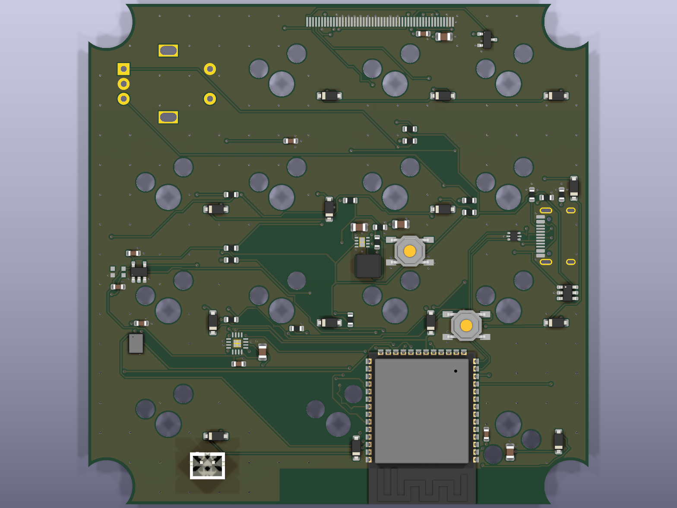
hardware/generated/pro/fab/pro-top.png
