nickthelegend/xorrpad/docs/business/BOM.md

# Production BOM and purchasing basis

Research date: **2026-11-12**. USD, before tax, freight, assembler procurement fees, attrition, reels and minimum-order rounding. [Pro CSV](bom-pro.csv) and [Core CSV](bom-core.csv) contain separate rows at **100 / 500 / 1,000 / 5,000 finished pads**. These are design choices requested in the [brief](BRIEF.md). They reconcile board references to the [SKiDL manifests](../../hardware/generated/) and add final-assembly kits. Every priced row has its URL, read date, selected published quantity tier and stock snapshot. Blank means **quote needed**, never zero.

## What the numbers do and do not cover

| Finished pads | Pro priced-line subtotal | Unpriced Pro lines | Core priced-line subtotal | Unpriced Core lines |
| ---: | ---: | ---: | ---: | ---: |
| 100 | $23.6972 | 16 | $12.7046 | 11 |
| 500 | $16.3015 | 17 | $11.7543 | 11 |
| 1,000 | $15.8002 | 17 | $11.4649 | 11 |
| 5,000 | $15.6588 | 17 | $11.3330 | 11 |

**Derived reference subtotals, not purchasable BOM totals or landed costs.** Generated by [business-bom.py](../../tools/business-bom.py) from [saved distributor facts](price-sources.json). The Pro subtotal falls sharply because the display vendor explicitly requests quotes at 500+; its price is then blank and excluded. That is missing coverage, not a manufacturing saving. Stock shortages are flagged even when a reference price exists. A quoted replacement microphone, full power circuit, caps, case and cable will change these numbers.

For an order of N pads, required component quantity is `N × quantity per pad`: sockets and switches are **14N**; Core LEDs are **15N** (14 keys plus status); Pro has one status LED. Use the largest published tier threshold not exceeding the required component quantity. Do not interpolate a new discount. A quantity beyond the last tier uses that published rate only as a reference. The CSV is not a cart: supplier package multiples, scrap/rework, panel rails and assembly attrition still need a purchasing quote. **ASSUMPTION:** reserve 2% extra pads/parts for pilot yield planning; this is not measured production yield or included in the table.

## Selected electronics and sourcing holds

| Function | Selection / LCSC | Quantity per pad | Reference price basis and qualification |
| --- | --- | ---: | --- |
| Radio/controller | Espressif ESP32-S3-WROOM-1-N16R8 / C2913202 | 1 | $3.3843 at 100 parts; $3.2241 at 650; $3.1548 at 1,300. Keep prototype flash/PSRAM configuration; no N8R8 substitution without firmware revalidation. [LCSC](https://www.lcsc.com/product-detail/C2913202.html), read 2026-11-12. |
| Genuine hot-swap socket | Kailh CPG151101S11 / C2803348 | 14 | $0.0777 at 500 parts, $0.0705 at 2,000, $0.0661 at 4,000, **zero stock**. Quote needed from Kailh/JLCPCB. Do not substitute a HanElectricity part under the Kailh name. [LCSC](https://www.lcsc.com/product-detail/C2803348.html), read 2026-11-12. |
| Knob with push | Alps Alpine EC11E15244G1 / C370970 | 1 | $1.8709 at 30, $1.4011 at 480, $1.3581 at 960 parts; 2,814 in stock. Shaft length, peg locations and push force require drawing/case review. [LCSC](https://www.lcsc.com/product-detail/C370970.html), read 2026-11-12. |
| Pro microphone candidate | TDK ICS-43434 / C5656610 | Pro 1 / Core 0 | $3.0161 at 100, $2.8741 at 500, $2.8146 at 1,000; 4,259 stock. **Not approved for production**: [TDK product search](https://product.tdk.com/en/search/sw_piezo/mic/mems-mic/info?part_no=ICS-43434) says NRND while [InvenSense](https://www.invensense.tdk.com/en-us/products/microphone/ics-43434) says EOL. Quote needed from TDK/distributor for a current I2S replacement, then prove bit alignment, acoustics and firmware. [LCSC](https://www.lcsc.com/product-detail/C5656610.html); all read 2026-11-12. |
| Prototype mic alternative | INMP441 / C5438445 | Alternative only | Zero stock; published reference $9.4664 at 500, $9.3044 at 1,000. Not a supply plan and not added to the candidate mic's cost. Quote needed from LCSC/TDK. [LCSC](https://www.lcsc.com/product-detail/C5438445.html), read 2026-11-12. |
| Pro I2S amp | MAX98357AETE+T / C910544 | Pro 1 / Core 0 | $0.8811 / $0.8332 / $0.8101 at 100 / 500 / 1,000. Limit audio output to the speaker rating; BTL terminals never connect to ground. [LCSC](https://www.lcsc.com/product-detail/C910544.html), read 2026-11-12. |
| Pro speaker | INGHAi GSPK3520037RBOX-8R1W-L100 / C46961948 | Pro 1 / Core 0 | 8 Ω, 1 W; $0.9489 at 100, $0.9180 at 450, $0.9033 at 900, only 434 in stock. Bare leads need **vendor** PH harness termination; quote needed for that service. [LCSC](https://www.lcsc.com/product-detail/C46961948.html), read 2026-11-12. |
| USB-C / ESD | TYPE-C-31-M-12 C165948; USBLC6-2SC6 C7519 | 1 each | Separate 5.1 kΩ CC pull-downs: 0603WAF5101T5E C23186, two per pad. USB data is routed to the S3, not power-only. [USB](https://www.lcsc.com/product-detail/C165948.html), [ESD](https://www.lcsc.com/product-detail/C7519.html), [CC](https://www.lcsc.com/product-detail/C23186.html), read 2026-11-12; full tier tables in JSON/CSV. |
| Buck, not a hot LDO | TPS62160DSGR / C324077 | 1 | $0.5324 / $0.4795 / $0.4514 at 100 / 500 / 1,000. [TI](https://www.ti.com/product/TPS62160) documents 1 A output; [LCSC](https://www.lcsc.com/product-detail/C324077.html), read 2026-11-12. Add SWPA4026S2R2MT inductor, feedback resistors and Murata GRM21BR61A226ME44L capacitors. Their prices are blank unless actually sourced. Validate loop, DC bias, ripple and thermals. |
| USB input protection | TPS2553DBVR, ILIM resistor TBD | 1 | Quote needed from TI/JLCPCB. A limiter alone does not detect advertised current. USB negotiation, inrush, suspend and firmware brightness/audio throttling are unresolved. Do not power/order the draft. [TI](https://www.ti.com/product/TPS2553), read 2026-11-12. |
| RGB / logic | WS2812B-2020-V6 C52917434; SN74AHCT1G125DBVR C7484 | 15 / 1 LEDs; 1 buffer | $0.0517 at 500, $0.0491 at 2,500, $0.0472 at 4,500 LED parts. Buffer shifts data from 3.3 V to the 5 V LED rail. [LED](https://www.lcsc.com/product-detail/C52917434.html), [buffer](https://www.lcsc.com/product-detail/C7484.html), read 2026-11-12. |
| Matrix / passives | 1N4148W C81598; 100 nF C14663; 22 µF C441864; 10 kΩ C25804 | By generated references | Diode per key; local bypass per IC/LED; boot/reset, feedback and backlight resistors included in CSV, with unknown prices blank. [Diode](https://www.lcsc.com/product-detail/C81598.html), [bypass](https://www.lcsc.com/product-detail/C14663.html), [bulk](https://www.lcsc.com/product-detail/C441864.html), [pull-ups](https://www.lcsc.com/product-detail/C25804.html), read 2026-11-12. |

### Switch options, externally supplied and pressed in by us

- **Base BOM reference:** Gateron G Pro 3.0 mechanical linear, listed **$9.80 / 35 switches**, derived **$0.28 per switch / $3.92 per pad**. At the requested runs that is 40 / 200 / 400 / 2,000 packs. No wholesale savings assumed. Confirm the selected color, 3/5-pin option and SMD LED aperture before approving. [Gateron](https://www.gateron.com/products/gateron-g-pro-30-switch-set?VariantsId=10621), read 2026-11-12.
- **Alternative:** Kailh Box Red CPG1511F01S04, selected 110-switch pack **$35**, derived $0.31818 per switch before pack rounding. Requested runs require 13 / 64 / 128 / 637 packs, respectively; derived switch costs per pad $4.55 / $4.48 / $4.48 / $4.459. Page has conflicting availability labels; quote needed from Kailh for current wholesale stock and variant pricing. This replaces the Gateron row; never add both. [Kailh](https://www.kailh.net/collections/all-products/products/kailh-box-switch-set), read 2026-11-12.

### Bare display versus breakout

EastRising **ER-TFT028-4** is the bare ILI9341 FPC candidate. Its public base product shows **$7.08 single, $6.91 at 10, $6.73 at 30, $6.54 at 50, $6.35 at 100; 500+ quote request**. Touch and connector options are configurable: quote needed from EastRising for the exact **no-touch** production variant and all higher runs; do not assume optional touch is free or invent a bulk price. [Product](https://www.buydisplay.com/serial-spi-2-8-tft-lcd-module-display-320x240-optional-touch-screen), read 2026-11-12 (indexed page accessible; direct fetch later returned HTTP 403).

Matching top-contact **ER-CON50HT-1**: **$0.29 single, $0.20 at 1,000**, reel 2,000 with cut tape offered. [Connector](https://www.buydisplay.com/50-pin-0-5mm-pitch-top-contact-zif-connector-fpc-connector), read 2026-11-12. Connector is a separate BOM line; assembler must accept consigned parts. Panel datasheet Rev2.1 says 50 pins, 0.5 mm pitch, four parallel backlight LEDs and 3.3 V maximum operating logic supply; this panel does **not** need an assumed series-LED boost. The draft uses individually limited anodes and a PWM cathode transistor. [Manufacturer PDF via distributor mirror](https://www.icbanq.com/icdownload/V2_DATA/ICBShop/Board/DFDSAFJLSDA.pdf), read 2026-11-12. FPC contact orientation, strain relief, current and the custom connector land pattern still need review.

Adafruit's comparable ILI9341 breakout is **$29.95 single, $26.96 at 10–99, $23.96 at 100+**; it includes touch, microSD, regulation and level shifting. This proves a breakout costs more for that configuration, not a universal display-cost rule or a like-for-like margin saving. [Adafruit 1770](https://www.adafruit.com/product/1770), read 2026-11-12.

## Distributor cross-check and release gates

[DigiKey ESP32 listing](https://www.digikey.com/en/products/detail/espressif-systems/ESP32-S3-WROOM-1-N16R8/16162642) confirms the exact module and distributor part 5407-ESP32-S3-WROOM-1-N16R8CT-ND. [DigiKey amp listing](https://www.digikey.com/en/products/detail/analog-devices-inc-maxim-integrated/MAX98357AETE-T/4936122) confirms the exact MAX98357A package. [Mouser module listing](https://www.mouser.com/ProductDetail/Espressif-Systems/ESP32-S3-WROOM-1-N16R8) blocked automated access. All checked 2026-11-12; pricing was not exposed in these reads: **quote needed from DigiKey/Mouser**. Do not claim a price cross-check succeeded.

Freeze a current mic, genuine sockets and full stock coverage; resolve USB power and FPC geometry; match every footprint to its manufacturer's drawing; obtain assembler prices/attrition, mechanical and cable quotes. Caps, screws/feet/inserts, speaker harness, USB cable and case are deliberately visible unknown lines. [Manufacturing](MANUFACTURING.md) and [pricing](PRICING.md) carry these uncertainties forward. Neither CSV is permission to purchase.
