nickthelegend/xorrpad/docs/business/bom-core.csv

sku | finished_units | mpn_or_spec | lcsc | designators | qty_per_unit | required_parts | published_tier_min_parts | reference_usd_per_part | reference_usd_per_finished_unit | stock_snapshot_parts | status | source_url | read_date | footprint | notes
core | 100 | 0603WAF0330T5E |  | R11 | 1 | 100 |  |  |  |  | quote needed from JLCPCB/LCSC | https://jlcpcb.com/pcb-assembly | 2026-11-12 | Resistor_SMD:R_0603_1608Metric
core | 500 | 0603WAF0330T5E |  | R11 | 1 | 500 |  |  |  |  | quote needed from JLCPCB/LCSC | https://jlcpcb.com/pcb-assembly | 2026-11-12 | Resistor_SMD:R_0603_1608Metric
core | 1000 | 0603WAF0330T5E |  | R11 | 1 | 1000 |  |  |  |  | quote needed from JLCPCB/LCSC | https://jlcpcb.com/pcb-assembly | 2026-11-12 | Resistor_SMD:R_0603_1608Metric
core | 5000 | 0603WAF0330T5E |  | R11 | 1 | 5000 |  |  |  |  | quote needed from JLCPCB/LCSC | https://jlcpcb.com/pcb-assembly | 2026-11-12 | Resistor_SMD:R_0603_1608Metric
core | 100 | 0603WAF1002T5E | C25804 | R1,R2,R8,R9,R10 | 5 | 500 | 100 | 0.0022 | 0.0110 | 3788000 | published reference; packaging/assembler quote needed | https://www.lcsc.com/product-detail/C25804.html | 2026-11-12 | Resistor_SMD:R_0603_1608Metric
core | 500 | 0603WAF1002T5E | C25804 | R1,R2,R8,R9,R10 | 5 | 2500 | 1000 | 0.0019 | 0.0095 | 3788000 | published reference; packaging/assembler quote needed | https://www.lcsc.com/product-detail/C25804.html | 2026-11-12 | Resistor_SMD:R_0603_1608Metric
core | 1000 | 0603WAF1002T5E | C25804 | R1,R2,R8,R9,R10 | 5 | 5000 | 5000 | 0.0017 | 0.0085 | 3788000 | published reference; packaging/assembler quote needed | https://www.lcsc.com/product-detail/C25804.html | 2026-11-12 | Resistor_SMD:R_0603_1608Metric
core | 5000 | 0603WAF1002T5E | C25804 | R1,R2,R8,R9,R10 | 5 | 25000 | 10000 | 0.0015 | 0.0075 | 3788000 | published reference; packaging/assembler quote needed | https://www.lcsc.com/product-detail/C25804.html | 2026-11-12 | Resistor_SMD:R_0603_1608Metric
core | 100 | 0603WAF2003T5E |  | R7 | 1 | 100 |  |  |  |  | quote needed from JLCPCB/LCSC | https://jlcpcb.com/pcb-assembly | 2026-11-12 | Resistor_SMD:R_0603_1608Metric
core | 500 | 0603WAF2003T5E |  | R7 | 1 | 500 |  |  |  |  | quote needed from JLCPCB/LCSC | https://jlcpcb.com/pcb-assembly | 2026-11-12 | Resistor_SMD:R_0603_1608Metric
core | 1000 | 0603WAF2003T5E |  | R7 | 1 | 1000 |  |  |  |  | quote needed from JLCPCB/LCSC | https://jlcpcb.com/pcb-assembly | 2026-11-12 | Resistor_SMD:R_0603_1608Metric
core | 5000 | 0603WAF2003T5E |  | R7 | 1 | 5000 |  |  |  |  | quote needed from JLCPCB/LCSC | https://jlcpcb.com/pcb-assembly | 2026-11-12 | Resistor_SMD:R_0603_1608Metric
core | 100 | 0603WAF5101T5E | C23186 | R3,R4 | 2 | 200 | 100 | 0.0016 | 0.0032 | 14503200 | published reference; packaging/assembler quote needed | https://www.lcsc.com/product-detail/C23186.html | 2026-11-12 | Resistor_SMD:R_0603_1608Metric
core | 500 | 0603WAF5101T5E | C23186 | R3,R4 | 2 | 1000 | 1000 | 0.0012 | 0.0024 | 14503200 | published reference; packaging/assembler quote needed | https://www.lcsc.com/product-detail/C23186.html | 2026-11-12 | Resistor_SMD:R_0603_1608Metric
core | 1000 | 0603WAF5101T5E | C23186 | R3,R4 | 2 | 2000 | 1000 | 0.0012 | 0.0024 | 14503200 | published reference; packaging/assembler quote needed | https://www.lcsc.com/product-detail/C23186.html | 2026-11-12 | Resistor_SMD:R_0603_1608Metric
core | 5000 | 0603WAF5101T5E | C23186 | R3,R4 | 2 | 10000 | 10000 | 0.0008 | 0.0016 | 14503200 | published reference; packaging/assembler quote needed | https://www.lcsc.com/product-detail/C23186.html | 2026-11-12 | Resistor_SMD:R_0603_1608Metric
core | 100 | 0603WAF6203T5E |  | R6 | 1 | 100 |  |  |  |  | quote needed from JLCPCB/LCSC | https://jlcpcb.com/pcb-assembly | 2026-11-12 | Resistor_SMD:R_0603_1608Metric
core | 500 | 0603WAF6203T5E |  | R6 | 1 | 500 |  |  |  |  | quote needed from JLCPCB/LCSC | https://jlcpcb.com/pcb-assembly | 2026-11-12 | Resistor_SMD:R_0603_1608Metric
core | 1000 | 0603WAF6203T5E |  | R6 | 1 | 1000 |  |  |  |  | quote needed from JLCPCB/LCSC | https://jlcpcb.com/pcb-assembly | 2026-11-12 | Resistor_SMD:R_0603_1608Metric
core | 5000 | 0603WAF6203T5E |  | R6 | 1 | 5000 |  |  |  |  | quote needed from JLCPCB/LCSC | https://jlcpcb.com/pcb-assembly | 2026-11-12 | Resistor_SMD:R_0603_1608Metric
core | 100 | 1N4148W | C81598 | D1,D2,D3,D4,D5,D6,D7,D8,D9,D10,D11,D12,D13,D14 | 14 | 1400 | 500 | 0.0098 | 0.1372 | 1945750 | published reference; packaging/assembler quote needed | https://www.lcsc.com/product-detail/C81598.html | 2026-11-12 | Diode_SMD:D_SOD-123
core | 500 | 1N4148W | C81598 | D1,D2,D3,D4,D5,D6,D7,D8,D9,D10,D11,D12,D13,D14 | 14 | 7000 | 6000 | 0.0067 | 0.0938 | 1945750 | published reference; packaging/assembler quote needed | https://www.lcsc.com/product-detail/C81598.html | 2026-11-12 | Diode_SMD:D_SOD-123
core | 1000 | 1N4148W | C81598 | D1,D2,D3,D4,D5,D6,D7,D8,D9,D10,D11,D12,D13,D14 | 14 | 14000 | 6000 | 0.0067 | 0.0938 | 1945750 | published reference; packaging/assembler quote needed | https://www.lcsc.com/product-detail/C81598.html | 2026-11-12 | Diode_SMD:D_SOD-123
core | 5000 | 1N4148W | C81598 | D1,D2,D3,D4,D5,D6,D7,D8,D9,D10,D11,D12,D13,D14 | 14 | 70000 | 51000 | 0.0061 | 0.0854 | 1945750 | published reference; packaging/assembler quote needed | https://www.lcsc.com/product-detail/C81598.html | 2026-11-12 | Diode_SMD:D_SOD-123
core | 100 | CC0603KRX7R9BB104 | C14663 | C1,C2,C6,C20,C21,C22,C23,C24,C25,C26,C27,C28,C29,C30,C31,C32,C33,C34 | 18 | 1800 | 1500 | 0.004 | 0.072 | 596250 | published reference; packaging/assembler quote needed | https://www.lcsc.com/product-detail/C14663.html | 2026-11-12 | Capacitor_SMD:C_0603_1608Metric
core | 500 | CC0603KRX7R9BB104 | C14663 | C1,C2,C6,C20,C21,C22,C23,C24,C25,C26,C27,C28,C29,C30,C31,C32,C33,C34 | 18 | 9000 | 4000 | 0.0036 | 0.0648 | 596250 | published reference; packaging/assembler quote needed | https://www.lcsc.com/product-detail/C14663.html | 2026-11-12 | Capacitor_SMD:C_0603_1608Metric
core | 1000 | CC0603KRX7R9BB104 | C14663 | C1,C2,C6,C20,C21,C22,C23,C24,C25,C26,C27,C28,C29,C30,C31,C32,C33,C34 | 18 | 18000 | 4000 | 0.0036 | 0.0648 | 596250 | published reference; packaging/assembler quote needed | https://www.lcsc.com/product-detail/C14663.html | 2026-11-12 | Capacitor_SMD:C_0603_1608Metric
core | 5000 | CC0603KRX7R9BB104 | C14663 | C1,C2,C6,C20,C21,C22,C23,C24,C25,C26,C27,C28,C29,C30,C31,C32,C33,C34 | 18 | 90000 | 48000 | 0.003 | 0.054 | 596250 | published reference; packaging/assembler quote needed | https://www.lcsc.com/product-detail/C14663.html | 2026-11-12 | Capacitor_SMD:C_0603_1608Metric
core | 100 | CPG151101S11 | C2803348 | SW1,SW2,SW3,SW4,SW5,SW6,SW7,SW8,SW9,SW10,SW11,SW12,SW13,SW14 | 14 | 1400 | 500 | 0.0777 | 1.0878 | 0 | stock insufficient; quote needed from LCSC/JLCPCB | https://www.lcsc.com/product-detail/C2803348.html | 2026-11-12 | Xorrpad:Kailh_CPG151101S11
core | 500 | CPG151101S11 | C2803348 | SW1,SW2,SW3,SW4,SW5,SW6,SW7,SW8,SW9,SW10,SW11,SW12,SW13,SW14 | 14 | 7000 | 4000 | 0.0661 | 0.9254 | 0 | stock insufficient; quote needed from LCSC/JLCPCB | https://www.lcsc.com/product-detail/C2803348.html | 2026-11-12 | Xorrpad:Kailh_CPG151101S11
core | 1000 | CPG151101S11 | C2803348 | SW1,SW2,SW3,SW4,SW5,SW6,SW7,SW8,SW9,SW10,SW11,SW12,SW13,SW14 | 14 | 14000 | 4000 | 0.0661 | 0.9254 | 0 | stock insufficient; quote needed from LCSC/JLCPCB | https://www.lcsc.com/product-detail/C2803348.html | 2026-11-12 | Xorrpad:Kailh_CPG151101S11
core | 5000 | CPG151101S11 | C2803348 | SW1,SW2,SW3,SW4,SW5,SW6,SW7,SW8,SW9,SW10,SW11,SW12,SW13,SW14 | 14 | 70000 | 4000 | 0.0661 | 0.9254 | 0 | stock insufficient; quote needed from LCSC/JLCPCB | https://www.lcsc.com/product-detail/C2803348.html | 2026-11-12 | Xorrpad:Kailh_CPG151101S11
core | 100 | EC11E15244G1 | C370970 | ENC1 | 1 | 100 | 30 | 1.8709 | 1.8709 | 2814 | published reference; packaging/assembler quote needed | https://www.lcsc.com/product-detail/C370970.html | 2026-11-12 | Rotary_Encoder:RotaryEncoder_Alps_EC11E-Switch_Vertical_H20mm | Assembler THT soldering; shaft/peg drawing must be matched to case
core | 500 | EC11E15244G1 | C370970 | ENC1 | 1 | 500 | 480 | 1.4011 | 1.4011 | 2814 | published reference; packaging/assembler quote needed | https://www.lcsc.com/product-detail/C370970.html | 2026-11-12 | Rotary_Encoder:RotaryEncoder_Alps_EC11E-Switch_Vertical_H20mm | Assembler THT soldering; shaft/peg drawing must be matched to case
core | 1000 | EC11E15244G1 | C370970 | ENC1 | 1 | 1000 | 960 | 1.3581 | 1.3581 | 2814 | published reference; packaging/assembler quote needed | https://www.lcsc.com/product-detail/C370970.html | 2026-11-12 | Rotary_Encoder:RotaryEncoder_Alps_EC11E-Switch_Vertical_H20mm | Assembler THT soldering; shaft/peg drawing must be matched to case
core | 5000 | EC11E15244G1 | C370970 | ENC1 | 1 | 5000 | 960 | 1.3581 | 1.3581 | 2814 | stock insufficient; quote needed from LCSC/JLCPCB | https://www.lcsc.com/product-detail/C370970.html | 2026-11-12 | Rotary_Encoder:RotaryEncoder_Alps_EC11E-Switch_Vertical_H20mm | Assembler THT soldering; shaft/peg drawing must be matched to case
core | 100 | ESP32-S3-WROOM-1-N16R8 | C2913202 | U1 | 1 | 100 | 100 | 3.3843 | 3.3843 | 18796 | published reference; packaging/assembler quote needed | https://www.lcsc.com/product-detail/C2913202.html | 2026-11-12 | RF_Module:ESP32-S3-WROOM-1
core | 500 | ESP32-S3-WROOM-1-N16R8 | C2913202 | U1 | 1 | 500 | 100 | 3.3843 | 3.3843 | 18796 | published reference; packaging/assembler quote needed | https://www.lcsc.com/product-detail/C2913202.html | 2026-11-12 | RF_Module:ESP32-S3-WROOM-1
core | 1000 | ESP32-S3-WROOM-1-N16R8 | C2913202 | U1 | 1 | 1000 | 650 | 3.2241 | 3.2241 | 18796 | published reference; packaging/assembler quote needed | https://www.lcsc.com/product-detail/C2913202.html | 2026-11-12 | RF_Module:ESP32-S3-WROOM-1
core | 5000 | ESP32-S3-WROOM-1-N16R8 | C2913202 | U1 | 1 | 5000 | 1300 | 3.1548 | 3.1548 | 18796 | published reference; packaging/assembler quote needed | https://www.lcsc.com/product-detail/C2913202.html | 2026-11-12 | RF_Module:ESP32-S3-WROOM-1
core | 100 | GRM21BR61A226ME44L | C441864 | C3,C4,C5 | 3 | 300 | 150 | 0.1869 | 0.5607 | 7390 | published reference; packaging/assembler quote needed | https://www.lcsc.com/product-detail/C441864.html | 2026-11-12 | Capacitor_SMD:C_0805_2012Metric
core | 500 | GRM21BR61A226ME44L | C441864 | C3,C4,C5 | 3 | 1500 | 500 | 0.1625 | 0.4875 | 7390 | published reference; packaging/assembler quote needed | https://www.lcsc.com/product-detail/C441864.html | 2026-11-12 | Capacitor_SMD:C_0805_2012Metric
core | 1000 | GRM21BR61A226ME44L | C441864 | C3,C4,C5 | 3 | 3000 | 3000 | 0.1516 | 0.4548 | 7390 | published reference; packaging/assembler quote needed | https://www.lcsc.com/product-detail/C441864.html | 2026-11-12 | Capacitor_SMD:C_0805_2012Metric
core | 5000 | GRM21BR61A226ME44L | C441864 | C3,C4,C5 | 3 | 15000 | 6000 | 0.1451 | 0.4353 | 7390 | stock insufficient; quote needed from LCSC/JLCPCB | https://www.lcsc.com/product-detail/C441864.html | 2026-11-12 | Capacitor_SMD:C_0805_2012Metric
core | 100 | ILIM_VALUE_TBD |  | R5 | 1 | 100 |  |  |  |  | quote needed from JLCPCB/LCSC | https://jlcpcb.com/pcb-assembly | 2026-11-12 | Resistor_SMD:R_0603_1608Metric
core | 500 | ILIM_VALUE_TBD |  | R5 | 1 | 500 |  |  |  |  | quote needed from JLCPCB/LCSC | https://jlcpcb.com/pcb-assembly | 2026-11-12 | Resistor_SMD:R_0603_1608Metric
core | 1000 | ILIM_VALUE_TBD |  | R5 | 1 | 1000 |  |  |  |  | quote needed from JLCPCB/LCSC | https://jlcpcb.com/pcb-assembly | 2026-11-12 | Resistor_SMD:R_0603_1608Metric
core | 5000 | ILIM_VALUE_TBD |  | R5 | 1 | 5000 |  |  |  |  | quote needed from JLCPCB/LCSC | https://jlcpcb.com/pcb-assembly | 2026-11-12 | Resistor_SMD:R_0603_1608Metric
core | 100 | SN74AHCT1G125DBVR | C7484 | U4 | 1 | 100 | 50 | 0.0804 | 0.0804 | 2565 | published reference; packaging/assembler quote needed | https://www.lcsc.com/product-detail/C7484.html | 2026-11-12 | Package_TO_SOT_SMD:SOT-23-5
core | 500 | SN74AHCT1G125DBVR | C7484 | U4 | 1 | 500 | 500 | 0.0624 | 0.0624 | 2565 | published reference; packaging/assembler quote needed | https://www.lcsc.com/product-detail/C7484.html | 2026-11-12 | Package_TO_SOT_SMD:SOT-23-5
core | 1000 | SN74AHCT1G125DBVR | C7484 | U4 | 1 | 1000 | 500 | 0.0624 | 0.0624 | 2565 | published reference; packaging/assembler quote needed | https://www.lcsc.com/product-detail/C7484.html | 2026-11-12 | Package_TO_SOT_SMD:SOT-23-5
core | 5000 | SN74AHCT1G125DBVR | C7484 | U4 | 1 | 5000 | 3000 | 0.0523 | 0.0523 | 2565 | stock insufficient; quote needed from LCSC/JLCPCB | https://www.lcsc.com/product-detail/C7484.html | 2026-11-12 | Package_TO_SOT_SMD:SOT-23-5
core | 100 | SWPA4026S2R2MT |  | L1 | 1 | 100 |  |  |  |  | quote needed from JLCPCB/LCSC | https://jlcpcb.com/pcb-assembly | 2026-11-12 | Inductor_SMD:L_Sunlord_SWPA4026S
core | 500 | SWPA4026S2R2MT |  | L1 | 1 | 500 |  |  |  |  | quote needed from JLCPCB/LCSC | https://jlcpcb.com/pcb-assembly | 2026-11-12 | Inductor_SMD:L_Sunlord_SWPA4026S
core | 1000 | SWPA4026S2R2MT |  | L1 | 1 | 1000 |  |  |  |  | quote needed from JLCPCB/LCSC | https://jlcpcb.com/pcb-assembly | 2026-11-12 | Inductor_SMD:L_Sunlord_SWPA4026S
core | 5000 | SWPA4026S2R2MT |  | L1 | 1 | 5000 |  |  |  |  | quote needed from JLCPCB/LCSC | https://jlcpcb.com/pcb-assembly | 2026-11-12 | Inductor_SMD:L_Sunlord_SWPA4026S
core | 100 | TPS2553DBVR |  | U8 | 1 | 100 |  |  |  |  | quote needed from JLCPCB/LCSC | https://jlcpcb.com/pcb-assembly | 2026-11-12 | Package_TO_SOT_SMD:SOT-23-6 | USB advertised-current detection and ILIM tolerance design REQUIRED
core | 500 | TPS2553DBVR |  | U8 | 1 | 500 |  |  |  |  | quote needed from JLCPCB/LCSC | https://jlcpcb.com/pcb-assembly | 2026-11-12 | Package_TO_SOT_SMD:SOT-23-6 | USB advertised-current detection and ILIM tolerance design REQUIRED
core | 1000 | TPS2553DBVR |  | U8 | 1 | 1000 |  |  |  |  | quote needed from JLCPCB/LCSC | https://jlcpcb.com/pcb-assembly | 2026-11-12 | Package_TO_SOT_SMD:SOT-23-6 | USB advertised-current detection and ILIM tolerance design REQUIRED
core | 5000 | TPS2553DBVR |  | U8 | 1 | 5000 |  |  |  |  | quote needed from JLCPCB/LCSC | https://jlcpcb.com/pcb-assembly | 2026-11-12 | Package_TO_SOT_SMD:SOT-23-6 | USB advertised-current detection and ILIM tolerance design REQUIRED
core | 100 | TPS62160DSGR | C324077 | U3 | 1 | 100 | 100 | 0.5324 | 0.5324 | 12640 | published reference; packaging/assembler quote needed | https://www.lcsc.com/product-detail/C324077.html | 2026-11-12 | Package_SON:Texas_DSG0008A_WSON-8-1EP_2x2mm_P0.5mm_EP0.9x1.6mm_ThermalVias
core | 500 | TPS62160DSGR | C324077 | U3 | 1 | 500 | 500 | 0.4795 | 0.4795 | 12640 | published reference; packaging/assembler quote needed | https://www.lcsc.com/product-detail/C324077.html | 2026-11-12 | Package_SON:Texas_DSG0008A_WSON-8-1EP_2x2mm_P0.5mm_EP0.9x1.6mm_ThermalVias
core | 1000 | TPS62160DSGR | C324077 | U3 | 1 | 1000 | 1000 | 0.4514 | 0.4514 | 12640 | published reference; packaging/assembler quote needed | https://www.lcsc.com/product-detail/C324077.html | 2026-11-12 | Package_SON:Texas_DSG0008A_WSON-8-1EP_2x2mm_P0.5mm_EP0.9x1.6mm_ThermalVias
core | 5000 | TPS62160DSGR | C324077 | U3 | 1 | 5000 | 1000 | 0.4514 | 0.4514 | 12640 | published reference; packaging/assembler quote needed | https://www.lcsc.com/product-detail/C324077.html | 2026-11-12 | Package_SON:Texas_DSG0008A_WSON-8-1EP_2x2mm_P0.5mm_EP0.9x1.6mm_ThermalVias
core | 100 | TS-1088-AR02016 |  | SW15,SW16 | 2 | 200 |  |  |  |  | quote needed from JLCPCB/LCSC | https://jlcpcb.com/pcb-assembly | 2026-11-12 | Button_Switch_SMD:SW_SPST_TL3342
core | 500 | TS-1088-AR02016 |  | SW15,SW16 | 2 | 1000 |  |  |  |  | quote needed from JLCPCB/LCSC | https://jlcpcb.com/pcb-assembly | 2026-11-12 | Button_Switch_SMD:SW_SPST_TL3342
core | 1000 | TS-1088-AR02016 |  | SW15,SW16 | 2 | 2000 |  |  |  |  | quote needed from JLCPCB/LCSC | https://jlcpcb.com/pcb-assembly | 2026-11-12 | Button_Switch_SMD:SW_SPST_TL3342
core | 5000 | TS-1088-AR02016 |  | SW15,SW16 | 2 | 10000 |  |  |  |  | quote needed from JLCPCB/LCSC | https://jlcpcb.com/pcb-assembly | 2026-11-12 | Button_Switch_SMD:SW_SPST_TL3342
core | 100 | TYPE-C-31-M-12 | C165948 | J1 | 1 | 100 | 50 | 0.1488 | 0.1488 | 264005 | published reference; packaging/assembler quote needed | https://www.lcsc.com/product-detail/C165948.html | 2026-11-12 | Connector_USB:USB_C_Receptacle_HRO_TYPE-C-31-M-12
core | 500 | TYPE-C-31-M-12 | C165948 | J1 | 1 | 500 | 150 | 0.1294 | 0.1294 | 264005 | published reference; packaging/assembler quote needed | https://www.lcsc.com/product-detail/C165948.html | 2026-11-12 | Connector_USB:USB_C_Receptacle_HRO_TYPE-C-31-M-12
core | 1000 | TYPE-C-31-M-12 | C165948 | J1 | 1 | 1000 | 1000 | 0.105 | 0.105 | 264005 | published reference; packaging/assembler quote needed | https://www.lcsc.com/product-detail/C165948.html | 2026-11-12 | Connector_USB:USB_C_Receptacle_HRO_TYPE-C-31-M-12
core | 5000 | TYPE-C-31-M-12 | C165948 | J1 | 1 | 5000 | 5000 | 0.0974 | 0.0974 | 264005 | published reference; packaging/assembler quote needed | https://www.lcsc.com/product-detail/C165948.html | 2026-11-12 | Connector_USB:USB_C_Receptacle_HRO_TYPE-C-31-M-12
core | 100 | USBLC6-2SC6 | C7519 | U2 | 1 | 100 | 50 | 0.1204 | 0.1204 | 21950 | published reference; packaging/assembler quote needed | https://www.lcsc.com/product-detail/C7519.html | 2026-11-12 | Package_TO_SOT_SMD:SOT-666
core | 500 | USBLC6-2SC6 | C7519 | U2 | 1 | 500 | 500 | 0.0862 | 0.0862 | 21950 | published reference; packaging/assembler quote needed | https://www.lcsc.com/product-detail/C7519.html | 2026-11-12 | Package_TO_SOT_SMD:SOT-666
core | 1000 | USBLC6-2SC6 | C7519 | U2 | 1 | 1000 | 500 | 0.0862 | 0.0862 | 21950 | published reference; packaging/assembler quote needed | https://www.lcsc.com/product-detail/C7519.html | 2026-11-12 | Package_TO_SOT_SMD:SOT-666
core | 5000 | USBLC6-2SC6 | C7519 | U2 | 1 | 5000 | 3000 | 0.0818 | 0.0818 | 21950 | published reference; packaging/assembler quote needed | https://www.lcsc.com/product-detail/C7519.html | 2026-11-12 | Package_TO_SOT_SMD:SOT-666
core | 100 | WS2812B-2020-V6 | C52917434 | LED1,LED2,LED3,LED4,LED5,LED6,LED7,LED8,LED9,LED10,LED11,LED12,LED13,LED14,LED15 | 15 | 1500 | 500 | 0.0517 | 0.7755 | 896850 | published reference; packaging/assembler quote needed | https://www.lcsc.com/product-detail/C52917434.html | 2026-11-12 | LED_SMD:LED_WS2812B-2020_PLCC4_2.0x2.0mm
core | 500 | WS2812B-2020-V6 | C52917434 | LED1,LED2,LED3,LED4,LED5,LED6,LED7,LED8,LED9,LED10,LED11,LED12,LED13,LED14,LED15 | 15 | 7500 | 4500 | 0.0472 | 0.7080 | 896850 | published reference; packaging/assembler quote needed | https://www.lcsc.com/product-detail/C52917434.html | 2026-11-12 | LED_SMD:LED_WS2812B-2020_PLCC4_2.0x2.0mm
core | 1000 | WS2812B-2020-V6 | C52917434 | LED1,LED2,LED3,LED4,LED5,LED6,LED7,LED8,LED9,LED10,LED11,LED12,LED13,LED14,LED15 | 15 | 15000 | 4500 | 0.0472 | 0.7080 | 896850 | published reference; packaging/assembler quote needed | https://www.lcsc.com/product-detail/C52917434.html | 2026-11-12 | LED_SMD:LED_WS2812B-2020_PLCC4_2.0x2.0mm
core | 5000 | WS2812B-2020-V6 | C52917434 | LED1,LED2,LED3,LED4,LED5,LED6,LED7,LED8,LED9,LED10,LED11,LED12,LED13,LED14,LED15 | 15 | 75000 | 4500 | 0.0472 | 0.7080 | 896850 | published reference; packaging/assembler quote needed | https://www.lcsc.com/product-detail/C52917434.html | 2026-11-12 | LED_SMD:LED_WS2812B-2020_PLCC4_2.0x2.0mm
core | 100 | Gateron G Pro 3.0 linear mechanical switch, 35-pack |  | FINAL_SWITCHES | 14 | 1400 | 35 | 0.28 | 3.92 |  | retail reference; quote needed from Gateron for bulk | https://www.gateron.com/products/gateron-g-pro-30-switch-set?VariantsId=10621 | 2026-11-12 |  | ASSUMPTION: listed 35-pack retained at every volume; no wholesale discount. Confirm selected color/pin variant and stock; assembler does not solder switches.
core | 500 | Gateron G Pro 3.0 linear mechanical switch, 35-pack |  | FINAL_SWITCHES | 14 | 7000 | 35 | 0.28 | 3.92 |  | retail reference; quote needed from Gateron for bulk | https://www.gateron.com/products/gateron-g-pro-30-switch-set?VariantsId=10621 | 2026-11-12 |  | ASSUMPTION: listed 35-pack retained at every volume; no wholesale discount. Confirm selected color/pin variant and stock; assembler does not solder switches.
core | 1000 | Gateron G Pro 3.0 linear mechanical switch, 35-pack |  | FINAL_SWITCHES | 14 | 14000 | 35 | 0.28 | 3.92 |  | retail reference; quote needed from Gateron for bulk | https://www.gateron.com/products/gateron-g-pro-30-switch-set?VariantsId=10621 | 2026-11-12 |  | ASSUMPTION: listed 35-pack retained at every volume; no wholesale discount. Confirm selected color/pin variant and stock; assembler does not solder switches.
core | 5000 | Gateron G Pro 3.0 linear mechanical switch, 35-pack |  | FINAL_SWITCHES | 14 | 70000 | 35 | 0.28 | 3.92 |  | retail reference; quote needed from Gateron for bulk | https://www.gateron.com/products/gateron-g-pro-30-switch-set?VariantsId=10621 | 2026-11-12 |  | ASSUMPTION: listed 35-pack retained at every volume; no wholesale discount. Confirm selected color/pin variant and stock; assembler does not solder switches.
core | 100 | 14-cap custom legend set |  | FINAL_KIT | 1 | 100 |  |  |  |  | quote needed from named vendor; design/package not frozen | https://maxkeyboard.com/shop/cherry-mx-keycaps/custom-color-printed-keycaps/ | 2026-11-12
core | 500 | 14-cap custom legend set |  | FINAL_KIT | 1 | 500 |  |  |  |  | quote needed from named vendor; design/package not frozen | https://maxkeyboard.com/shop/cherry-mx-keycaps/custom-color-printed-keycaps/ | 2026-11-12
core | 1000 | 14-cap custom legend set |  | FINAL_KIT | 1 | 1000 |  |  |  |  | quote needed from named vendor; design/package not frozen | https://maxkeyboard.com/shop/cherry-mx-keycaps/custom-color-printed-keycaps/ | 2026-11-12
core | 5000 | 14-cap custom legend set |  | FINAL_KIT | 1 | 5000 |  |  |  |  | quote needed from named vendor; design/package not frozen | https://maxkeyboard.com/shop/cherry-mx-keycaps/custom-color-printed-keycaps/ | 2026-11-12
core | 100 | Vendor printed tray/plate/knob set |  | FINAL_KIT | 1 | 100 |  |  |  |  | quote needed from named vendor; design/package not frozen | https://jlc3dp.com | 2026-11-12
core | 500 | Vendor printed tray/plate/knob set |  | FINAL_KIT | 1 | 500 |  |  |  |  | quote needed from named vendor; design/package not frozen | https://jlc3dp.com | 2026-11-12
core | 1000 | Vendor printed tray/plate/knob set |  | FINAL_KIT | 1 | 1000 |  |  |  |  | quote needed from named vendor; design/package not frozen | https://jlc3dp.com | 2026-11-12
core | 5000 | Vendor printed tray/plate/knob set |  | FINAL_KIT | 1 | 5000 |  |  |  |  | quote needed from named vendor; design/package not frozen | https://jlc3dp.com | 2026-11-12
core | 100 | Screws, feet, inserts, gasket and final assembly consumable kit |  | FINAL_KIT | 1 | 100 |  |  |  |  | quote needed from named vendor; design/package not frozen | https://craftcloud3d.com | 2026-11-12
core | 500 | Screws, feet, inserts, gasket and final assembly consumable kit |  | FINAL_KIT | 1 | 500 |  |  |  |  | quote needed from named vendor; design/package not frozen | https://craftcloud3d.com | 2026-11-12
core | 1000 | Screws, feet, inserts, gasket and final assembly consumable kit |  | FINAL_KIT | 1 | 1000 |  |  |  |  | quote needed from named vendor; design/package not frozen | https://craftcloud3d.com | 2026-11-12
core | 5000 | Screws, feet, inserts, gasket and final assembly consumable kit |  | FINAL_KIT | 1 | 5000 |  |  |  |  | quote needed from named vendor; design/package not frozen | https://craftcloud3d.com | 2026-11-12
core | 100 | USB-C data cable |  | FINAL_KIT | 1 | 100 |  |  |  |  | quote needed from named vendor; design/package not frozen | https://www.lcsc.com | 2026-11-12
core | 500 | USB-C data cable |  | FINAL_KIT | 1 | 500 |  |  |  |  | quote needed from named vendor; design/package not frozen | https://www.lcsc.com | 2026-11-12
core | 1000 | USB-C data cable |  | FINAL_KIT | 1 | 1000 |  |  |  |  | quote needed from named vendor; design/package not frozen | https://www.lcsc.com | 2026-11-12
core | 5000 | USB-C data cable |  | FINAL_KIT | 1 | 5000 |  |  |  |  | quote needed from named vendor; design/package not frozen | https://www.lcsc.com | 2026-11-12
