nickthelegend/xorrpad/hardware/generated/pro-jlc-bom.csv

Comment | Designator | Footprint | LCSC Part #
0603WAF0330T5E | R11 | Resistor_SMD:R_0603_1608Metric
0603WAF1000T5E | R12,R13,R14,R15 | Resistor_SMD:R_0603_1608Metric
0603WAF1002T5E | R1,R2,R8,R9,R10 | Resistor_SMD:R_0603_1608Metric | C25804
0603WAF1003T5E | R16 | Resistor_SMD:R_0603_1608Metric
0603WAF2003T5E | R7 | Resistor_SMD:R_0603_1608Metric
0603WAF5101T5E | R3,R4 | Resistor_SMD:R_0603_1608Metric | C23186
0603WAF6203T5E | R6 | Resistor_SMD:R_0603_1608Metric
1N4148W | D1,D2,D3,D4,D5,D6,D7,D8,D9,D10,D11,D12,D13,D14 | Diode_SMD:D_SOD-123 | C81598
2N7002 | Q1 | Package_TO_SOT_SMD:SOT-23
B2B-PH-K-S(LF)(SN) | J2 | Connector_JST:JST_PH_B2B-PH-K_1x02_P2.00mm_Vertical
CC0603KRX7R9BB104 | C1,C2,C6,C20,C7,C8,C10 | Capacitor_SMD:C_0603_1608Metric | C14663
CPG151101S11 | SW1,SW2,SW3,SW4,SW5,SW6,SW7,SW8,SW9,SW10,SW11,SW12,SW13,SW14 | Xorrpad:Kailh_CPG151101S11 | C2803348
EC11E15244G1 | ENC1 | Rotary_Encoder:RotaryEncoder_Alps_EC11E-Switch_Vertical_H20mm | C370970
ER-CON50HT-1 | J3 | Xorrpad:ER-CON50HT-1_DRAFT
ESP32-S3-WROOM-1-N16R8 | U1 | RF_Module:ESP32-S3-WROOM-1 | C2913202
GRM21BR61A226ME44L | C3,C4,C5,C9,C11 | Capacitor_SMD:C_0805_2012Metric | C441864
ICS-43434 | U5 | Sensor_Audio:InvenSense_ICS-43434-6_3.5x2.65mm | C5656610
ILIM_VALUE_TBD | R5 | Resistor_SMD:R_0603_1608Metric
MAX98357AETE+T | U6 | Package_DFN_QFN:TQFN-16-1EP_3x3mm_P0.5mm_EP1.23x1.23mm | C910544
SN74AHCT1G125DBVR | U4 | Package_TO_SOT_SMD:SOT-23-5 | C7484
SWPA4026S2R2MT | L1 | Inductor_SMD:L_Sunlord_SWPA4026S
TPS2553DBVR | U8 | Package_TO_SOT_SMD:SOT-23-6
TPS62160DSGR | U3 | Package_SON:Texas_DSG0008A_WSON-8-1EP_2x2mm_P0.5mm_EP0.9x1.6mm_ThermalVias | C324077
TS-1088-AR02016 | SW15,SW16 | Button_Switch_SMD:SW_SPST_TL3342
TYPE-C-31-M-12 | J1 | Connector_USB:USB_C_Receptacle_HRO_TYPE-C-31-M-12 | C165948
USBLC6-2SC6 | U2 | Package_TO_SOT_SMD:SOT-666 | C7519
WS2812B-2020-V6 | LED1 | LED_SMD:LED_WS2812B-2020_PLCC4_2.0x2.0mm | C52917434
