nickthelegend/xorrpad/docs/print/keys-print-check.png

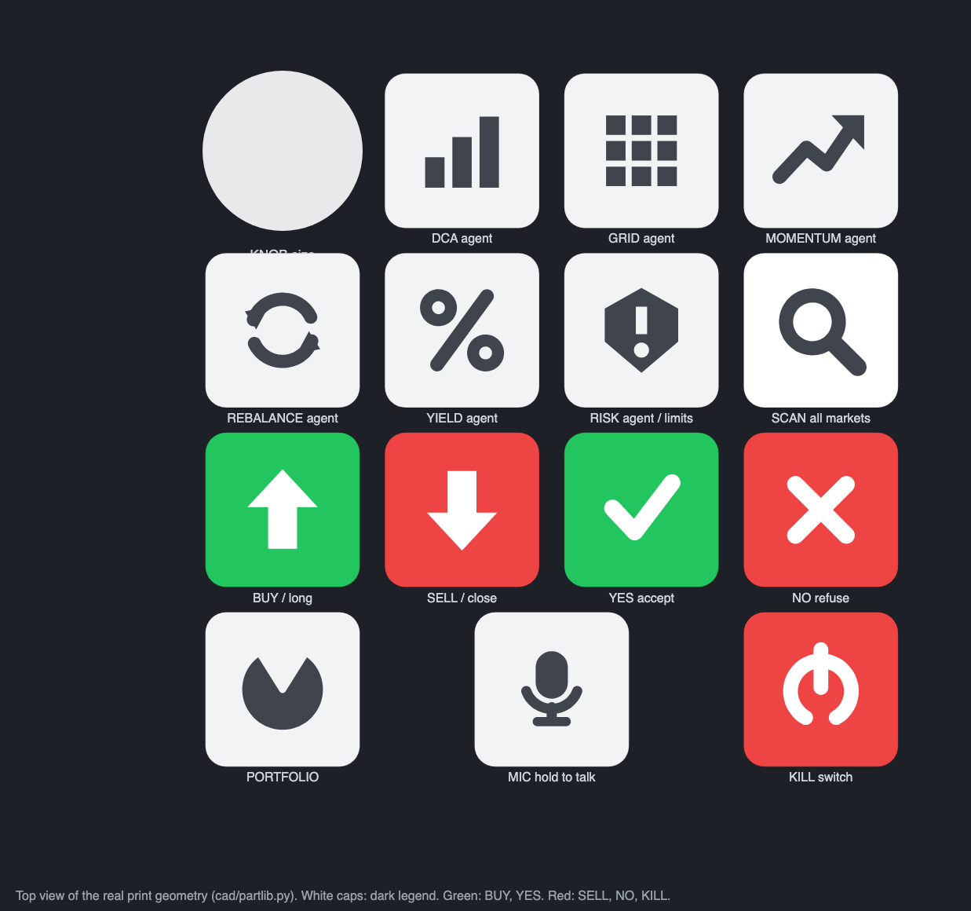
docs/print/keys-print-check.png
