nickthelegend/xorrpad/docs/screens/solana-setup-after-375.png

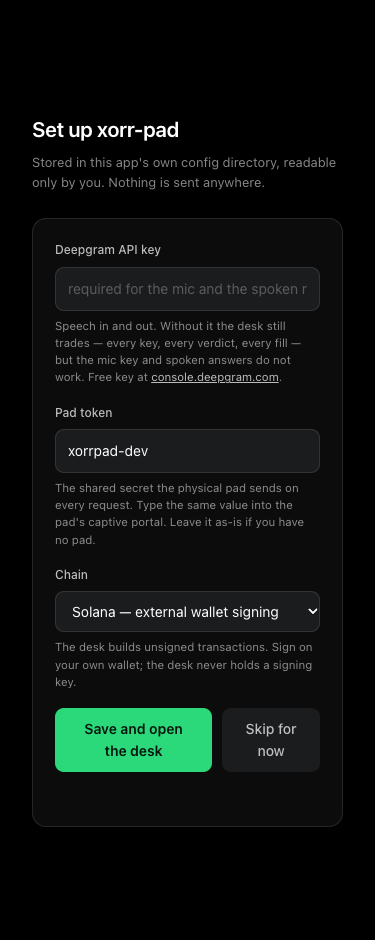
docs/screens/solana-setup-after-375.png
