nickthelegend/xorrpad/docs/screens/solana-setup-after-1440.png

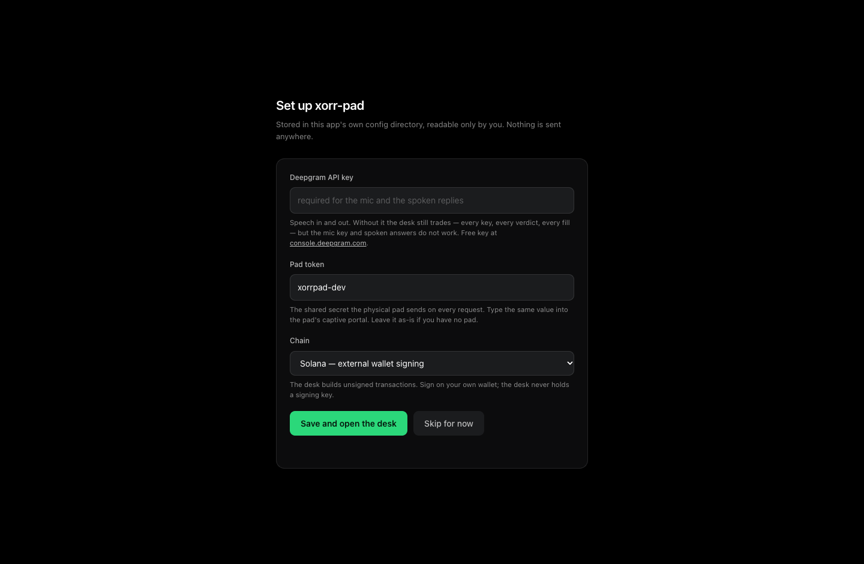
docs/screens/solana-setup-after-1440.png
