nickthelegend/xorrpad/docs/screens/solana-setup-before-375.png

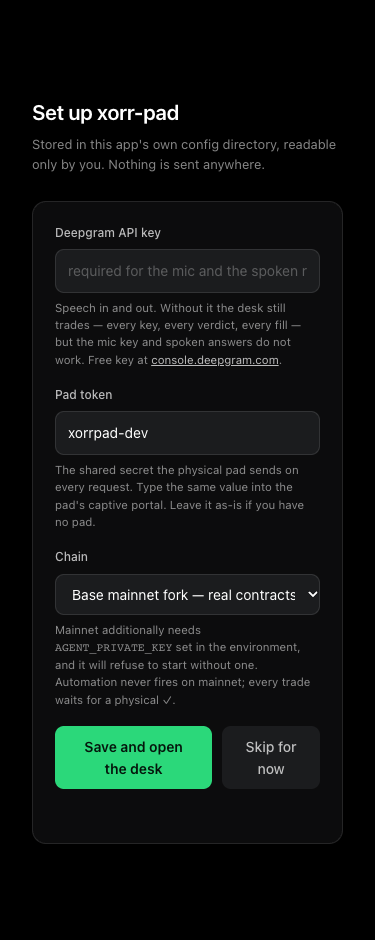
docs/screens/solana-setup-before-375.png
