nickthelegend/xorrpad/docs/screens/v4/mirror-pad-flatten-setup.png

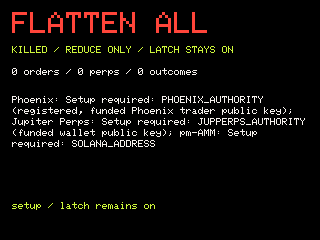
docs/screens/v4/mirror-pad-flatten-setup.png
