nickthelegend/xorrpad/CHANGELOG.md

# Changelog

All notable changes to xorrpad are documented here. This file follows
[Keep a Changelog](https://keepachangelog.com/en/1.1.0/) and
[Semantic Versioning](https://semver.org/spec/v2.0.0.html).

## [Unreleased]

## [4.0.0] — 2026-11-13

### Fixed — F10: Tilt guard at the desk

- A paired pad's cooldown also refuses desktop, API and automatic new-exposure
  acceptance, with the pad reason and countdown. The existing decision card
  disables Accept and shows Cooldown without changing desktop styles.
- Reported device identities persist; stale, disconnected, unhealthy or unknown
  tilt state holds the guard until a fresh healthy pad report releases it.
  The desktop countdown never clears it. Reduce-only and flatten retain their
  existing permission, clear-sign, session and KILL checks.
- Acceptance and executor checks cover cooldown races through signing/submission;
  native encrypted padsim, HTTP, browser and local policy vectors cover refusal,
  expiry, multiple pads, reconnect/restart and reduction exemptions.

### Added — F9: Desktop pad screen mirror

- The 3D pad draws Fund, Portfolio, SCAN, Predict, outcome positions, perp
  positions, LIQ GUARD, Cooldown, Flatten, Journal and the ambient clock from
  the public records written to its transport, with pad-reported selection and
  uptime for firmware paging and timers. Cached wallet records close with the pad.
- Decision venue, size, price, fee and fingerprint come from the sent signal;
  kill/re-arm push status immediately. Only the model refreshes on screen events.
- A desktop test per screen compares the real drawFirmware canvas to compiled
  native firmware; encrypted padsim covers status transitions and actual Setup.
  Existing desktop styling, consent rules and earlier features remain intact.

### Added — F8: SCAN answers

- SCAN/BASE and the live scan route publish bounded public pad answers with
  verdict, checked/unavailable counts and top setup; key dismissal and eight-second
  expiry retain trusted YES and KILL safety. SCAN proposals require manual consent.
- Markets shows Last scan using existing components; Activity keeps one entry per
  completed scan, including honest missing-feed states, across page refresh.
- Native parser/timer, encrypted padsim, browser and native/WASM parity coverage;
  actual uipreview and 1440/375 captures. No desktop styles or earlier tests removed.

### Release — F7

- Device's existing Sounds, Ambient and Tilt guard controls, Markets' Predict on
  pad, Agent's pad-authoritative guard state and Activity's journal/guard events
  ship together using the approved components, tokens and art.
- Compile-only Pro/Core release script writes image-bound unsigned OTA manifests
  with SHA-256, size and all seven feature notes. Unsigned manifests cannot pass
  existing OTA verification; production signing remains a separate operation.
- Release browser coverage saves settings together, reloads their stored values,
  selects Predictor without creating a trade, and captures the actual desktop
  at 1440/375 with overflow checks. Native uipreview frames cover every new pad
  screen; release notes document records, Setup states and hardware limits.

### Added — Firmware 4.0.0 F6: Ambient clock and trade journal

- After 60 seconds idle on Home, a dim UTC clock shows independent SOL reference
  data, up to 24 hourly closes, known book P/L, reported funding countdown, NY
  hours and crew state. Missing feeds remain unavailable; first key/knob input
  consumes the entire gesture and only wakes. Device exposes persistent Ambient.
- Knob press on Home opens the newest 32 pad decisions, stored in NVS and
  browsed with the knob. Records retain time, action, market, size, venue and
  filled/signature, refusal, expiry, failure/reason or tilt-blocked outcomes.
  Signing alone is never recorded as a fill.
- Authenticated bounded snapshots feed read-only `/pad/journal` and Activity's
  Pad journal section using the approved components. Native/padsim reboot,
  complete wake gestures, snapshot validation and native/WASM pixel parity are
  covered without mocking an external API or submitting a trade.

### Added — Firmware 4.0.0 F5: Synthesized earcons

- One shared parameter table drives 16 kHz PCM on MAX98357A I2S and WebAudio
  in the 3D mirror: accept, refuse, fill, alert, liquidation alarm, KILL,
  cooldown and optional detent tick (off by default).
- `/pad/options` sound volume, mute and UTC quiet hours persist on the desk and
  pad. The existing Device form exposes them without stylesheet or art changes.
  Quiet hours silence all cues, including alarms; LED warnings remain active.
- Bounded playback keeps key scanning responsive. GPIO 48 pulses green on fills,
  red for KILL/LIQ GUARD and breathes amber during cooldown. Native PCM renders,
  cross-runtime sample comparison and encrypted browser/padsim tests verify sound
  and settings without submitting a trade.

### Added — Firmware 4.0.0 F4: Panic flatten

- The unchanged two-second KILL latch requests one live Flatten all plan. The
  pad and exact firmware mirror show cancellations, full perp closes and outcome
  exits; a fresh 800 ms YES hold starts it, while NO leaves the latch on.
- Only that reviewed reduce-only plan can cross the killed execution gate.
  Every leg retains permissions, caps, fresh inventory, signing and session/crew
  policy. Cancellations precede closes; each transaction must confirm before the
  next. Re-arm, another KILL or changed inventory revokes the grant.
- Missing public authorities, incomplete/unsupported inventories and unavailable
  exits show Setup required. Mainnet signing remains disabled by default. Activity
  uses the existing desktop components; native tests, encrypted padsim and
  native/WASM parity cover both decisions without fabricated API responses.

### Added — Firmware 4.0.0 F3: Tilt guard

- Pad NVS holds daily realized-loss, rolling-hour trade and losing-close limits,
  local approval counters and cooldown deadlines that survive reboot. The desk
  cannot shorten a tripped guard; UTC rollover clears only the daily loss latch.
- Cooldown countdown ring and native/WASM mirror refuse new YES approvals across
  normal, clear-sign, session and crew paths. KILL, NO, reduce-only, PORTFOLIO
  and its funding hold retain their existing gates and behavior.
- Device settings and Agent state reuse approved components. Missing UTC, storage
  or confirmed close PnL gives honest Setup required; quotes are never counted
  as realized fills. Native accounting padsim and reboot/UTC regression evidence
  accompany the feature. No release signing, flashing, trading or push is performed.

### Added — Firmware 4.0.0 F2: Perps cockpit and liquidation guard

- Positions gains venue-supplied entry, mark, leverage, liquidation, distance bar
  and next funding, preserving unknowns as unavailable and prior spot pages.
- Each connected-pad tick reads real configured perp positions. `liqGuardPct`
  defaults to 10%; a red LIQ GUARD screen, distinct alarm and red LED pulse offer
  a 50% reduction. YES only proposes; a separate trusted YES and existing
  permissions, caps, clear-sign/session/crew and mainnet gates remain required.
- Venue-bound reduce-only builders halve Phoenix lots or Jupiter raw USD size;
  they never route to opening orders. Device threshold controls, actual Activity
  events, Core mirror, encrypted padsim, native/WASM tests and uipreview evidence
  accompany F2. Missing authorities return Setup required. No live trade claimed.

### Added — Firmware 4.0.0 F1: Predict on the pad

- Predictor home uses real devnet pm-AMM markets, with a YES probability arc,
  question wrapping, closing countdown, venue/cluster and unavailable 24h history.
  The knob pages through all markets in bounded six-market records.
- YES/NO with no pending decision proposes BUY YES/NO at the current desk size.
  A separate YES accepts the fingerprint-bound proposal under existing gates;
  NO refuses. Pad proposals explicitly disable auto-accept, including re-gating.
- PORTFOLIO shows actual outcome share balances or an honest Setup/empty state;
  the existing one-second funding hold remains. The desktop adds “Predict on pad”
  using its existing components. Its firmware mirror renders Predict and outcomes.
- Encrypted v4 padsim, native parser/confirmation tests, native/WASM frame parity,
  uipreview and responsive desktop evidence accompany F1. Core can compile with
  `XORR_CORE=1` and uses the desktop/phone for visual review. No release signing,
  flashing or push is performed. Later F3–F7 entries above complete this scope.

### Added — Agent wallet W3, part 4

- Agent now shows the existing agent wallet's full public address with copy,
  a locally encoded Solana Pay funding QR, live SOL/SPL balances and cluster,
  valuation availability and observation time. Refresh reads the wallet again;
  unavailable RPC data never becomes a fabricated zero balance.
- “Create agent wallet” appears only when no wallet exists. “Show QR on pad”
  uses the authenticated funding route and reports delivery or an absent pad.
  Existing signing controls, components, artwork and desktop styling remain.
- A built-app browser regression exercises real devnet creation/readback,
  clipboard contents, independent QR decoding, actual fragmented TCP Fund
  delivery and RPC failure. Captures cover the card at 1440/375 px and the
  actual pad Fund/Portfolio records through the firmware preview renderer.
- Concurrent wallet and policy status reads share one in-flight encrypted pad
  request. Approval/signing stays exclusive; disconnect rejects all waiting
  readers. This prevents the wallet card from disabling existing policy controls.

### Added — Agent wallet W3 acceptance

- Final isolated serial desk suite: 252 tests, 242 passed, 10 existing
  setup/provider skips, zero failures. Native suite: 273 cases and 2,709
  assertions passed. App build, model3d parity and all native/WASM wallet
  frames passed. W3 source and public-artifact hashes match the tested copy.
- Saved 1440/375 px desktop wallet captures and regenerated actual pad Fund,
  Portfolio and no-wallet screenshots in `docs/screens/v3/`; documented test
  results, the status-read race fix and screenshot provenance in `TESTING.md`.

### Added — Agent wallet W2, part 2

- The desk sends `{type:"fund", address, uri, cluster}` over the existing v1
  link or encrypted v2. Authenticated local `POST /agent-wallet {action:"fund"}`
  opens the funding QR on connected pads and reports an absent pad honestly;
  it never creates a wallet implicitly. A pad `fund` key requests the same record.
- Hold PORTFOLIO for one second for Fund; release sooner for Portfolio.
  Any key dismisses the wallet screen without triggering another action;
  KILL retains its safety action. Incoming wallet screens wake the display.
- Fund shows the real Solana Pay QR, shortened address, cluster and funding
  instruction. Pairing and Fund share `esp_qrcode` and the exact firmware pixel
  renderer across ESP32, native preview and the rebuilt desktop screen WASM.
  Portfolio retains its total, SOL/USDC, top-three tokens and honest unknown USD.
- Native hold/parser tests, independent decoding of the rendered funding QR,
  six native/WASM wallet frame cases and model3d frame parity are covered.
  The approved desktop components and styling are unchanged.

### Added — Agent wallet W2, part 5

- Final isolated desk suite: 250 tests, 240 passed, 10 existing setup/provider
  skips, zero failures; native suite 273 cases passed, app build, ESP32 compile
  and native/WASM model3d plus wallet-frame parity passed.

- Both padsim versions retain actual received `fund` and `portfolio` records,
  without inventing balances or rendered QR modules. Live tests exercise the
  authenticated desktop action and pad key over fragmented TCP and encrypted
  v2, including the selected native pad wallet and no plaintext funding record.

### Added — Agent wallet W1, part 3

- Final isolated desk suite: 248 tests, 238 passed, 10 existing setup/provider
  skips, zero failures; native suite 271 cases passed, app build and native/WASM
  frame parity passed. Classic's live chain slot/ID are retained and asserted.

- PORTFOLIO and `/portfolio` use the existing agent wallet when `SOLANA_ADDRESS`
  is unset; an explicit phone address still wins. With no wallet, they say
  “Create your agent wallet in XOR Desktop” and return no invented balances.
- The physical pad receives a Portfolio record over v1 or encrypted v2 and
  shows total USD, SOL, USDC and the top three other holdings, preserving
  unavailable USD values. Existing desktop components and styling are unchanged.
- Added native parser tests, live devnet/TCP/encrypted-native-pad coverage,
  native/WASM portfolio frame parity, and actual uipreview screenshots.
  Session-state replies can complete a PORTFOLIO key waiting on the pad public
  key without queueing behind that same key; response checks remain enforced.

### Added — Agent wallet W1, part 1

- Authenticated GET/POST `/agent-wallet` reuses the existing desk session wallet
  or the selected pad session public key, creates only when missing, and never
  returns secrets. Creation stays local and leaves the signing mode unchanged.
- Live genesis-verified SOL, SPL and Token-2022 balances, mint-pinned USDC,
  Jupiter USD prices where available, and explicit unknown/partial valuations.
  RPC failures are errors; devnet units have no claimed USD market value.

### Added — Desktop v3 D5 acceptance

- Final isolated desk suite: 238 tests, 228 passed, 10 setup/provider skips,
  zero failures or cancellations; standalone app build passes.
- Completed built-app coverage for all 17 brief routes and 25 route/method
  pairs, including invalid authentication, remaining methods, readable no-pad
  responses and the actual authenticated event WebSocket. Classic UI access
  remains checked; all existing tests are retained.
- Regenerated and inspected 46 real padsim screenshots across all six screens
  at 1440/375 px. Added text clipping, 44×44 px target and reduced-motion checks,
  plus lower-form captures proving the Markets sheet's Save action is reachable.
  The approved desktop components and styling are unchanged.
- Recorded simulator provenance, screenshot inventory, actual verification
  counts and local per-screen commits in TESTING.md. Nothing was pushed.

### Added — Desktop v3 D4, Markets

- Final D4 verification: 236 desk tests, 226 passed, 10 setup/provider skips,
  zero failures; app build passes. Twenty inspected desktop/mobile screenshots
  and full evidence are recorded in TESTING.md.

- Added Alert on pad to the selected market ticket. The existing sheet reads,
  saves and removes up to eight token-USD alert rules through `/pad/price-alerts`,
  preserving the other rules. It explains pad power/Wi-Fi/time requirements,
  re-arming on save, underlying-token limits and “Nothing will trade”.
- Added native parser-backed encrypted padsim browser coverage for both alert
  directions, stored readback, removal and device isolation, plus authenticated
  route/no-pad checks and inspected 1440/375 px empty/stored screenshots.
  No new CSS, fonts, colors or libraries; no signing or trading action is sent.

### Added — Desktop v3 D4, Activity

- Activity now shows authenticated clear-sign results, fingerprints, hashes,
  bounded actual pad-decoded rows, explicit refusals and real pad signatures.
  Review approvals and crew approvals never claim a transaction was signed or
  filled. The last 100 results remain available across screen navigation in the
  current desktop session; reload starts an honest empty event history.
- Added the existing crew threshold/quorum policy editor, paired identity
  selection and actual round approvers. The clear-sign sheet sends only unsigned
  review requests through the real route; signing remains the gated pad executor.
- Added public firmware review telemetry, native-backed encrypted padsim coverage
  for approval/refusal/signatures and independent two-pad quorum, and inspected
  1440/375 px screenshots. The approved desktop components and styling remain.

### Added — Desktop v3 D4, Agent

- Added Pad signer as the third wallet mode, bound to the selected paired pad.
  The existing session sheet edits dollar caps, 1× leverage, exact venue program
  allowlist and a capped market/destination auto-accept rule. Physical policy
  approval remains mandatory. Blind signing is off by default with a red warning
  and an explicit save. Selection/disconnect clears pad-specific editor state.
- Added public rolling-spend telemetry to firmware status and the native simulator;
  older firmware honestly reports unavailable accounting. No signing material is
  returned. Native accounting coverage and real encrypted padsim browser coverage
  include policy refusal, approval, spend readback and explicit blind opt-in.

### Added — Desktop v3 D3, Abilities

- Added an On-pad abilities section below the unchanged desktop catalog, using
  `/pad/abilities` for developer public-key review, signed bundle installation
  and removal in two independent slots. Developer trust still requires the
  physical pad hold; the complete reported public key remains readable.
- Capability pills and install examples use the actual Market Pulse and
  Pomodoro SDK manifests. The section states “Abilities can never sign or
  trade”, shows real empty/error states, and clears device-specific state on
  selection or disconnect without redirecting writes to another pad.
- Added authenticated route and encrypted native-interpreter padsim browser
  coverage, plus inspected 1440/375 px screenshots. No desktop restyling,
  automatic developer trust or bundled signing material.

### Added — Desktop v3 D2, Device

- Existing Device surfaces now expose signed manifest/image OTA with optional
  delta, authenticated event progress, explicit per-pad stable/beta channel
  read/save, and the installed firmware version from the real peer snapshot.
- Kill-latch state and a desk re-arm request preserve the physical YES hold;
  eight profile slots with three layers use the existing key assignment sheet,
  and brightness/night controls save through the real pad options route.
- Readable empty/error states, refresh-safe Device forms, authenticated route
  and encrypted padsim browser coverage, and 1440/375 px screenshots. The
  approved navigation, pad model, palette, fonts and classic UI stay intact.

### Added — Desktop v3 D1, Connect

- Encrypted pairing through `/pad/pair` using the discovered public pad identity
  and six-digit code shown on the pad, with confirmation from the peer snapshot,
  readable errors and an explicit timeout when pairing is not confirmed.
- Lime `Genuine xorrpad #serial` or red `Unverified device` badges and the exact
  attestation reason from the current encrypted peer; legacy and unprovisioned
  pads remain unverified, and disconnect/read failures clear the badge.
- Existing Connect components retain the approved desktop appearance, with
  transport/link timestamps, authenticated D1 route/browser regressions and
  encrypted padsim screenshots at 1440 and 375 px.

### Added — firmware 3.0.0, factory and XOR phone attestation

- Factory-signed device certificates, offline external-path key/issuance tools,
  physical USB factory provisioning and fresh connection proofs, verified by
  the firmware, desk and actual XOR phone app.
- Independent fresh phone-origin BLE challenges, local strict Ed25519 checking,
  single-use/expiry/disconnect protection and genuine/unverified labels in the
  existing Pad screens; v1 and encrypted v2 relay support remain.
- Native/desk/phone verification parity and firmware 3.0.0 handshake/report
  compatibility. Production trust roots remain deliberately unconfigured;
  compiled, not yet flashed, with funding/hardware acceptance still explicit.

### Added — firmware 3.0.0, V7 validation and hardware research

- Rev 2 research with exact secure-element, haptic knob, battery/charger and
  USB-C PD candidates, distributor price links, a 1k sourcing worksheet,
  enclosure DFM and FCC/CE integration paths; unresolved costs remain RFQ.
- Repeatable v3 padsim regression and live native-pad devnet signing runner,
  with exact public funding addresses and explicit BLOCKED broadcast reporting.
- Firmware label `3.0.0`, normal/release compile evidence and complete test
  totals in TESTING.md; compiled, not yet flashed. Pending attestation source,
  funded broadcast and physical-board acceptance remain explicit in V3-NOTES.md.

### Added — firmware 3.0.0, V6 OTA channels

- Per-pad stable/beta opt-in saved in NVS, signed channel/percentage rollout
  metadata, and deterministic device-ID cohorts checked by desk and firmware.
- Streaming signed COPY/ADD patches tied to the previous app version/hash;
  independent patch and final-image verification, inactive-slot writes and
  existing boot health-check rollback. Full-image and v2 bootstrap paths remain.
- Connect channel controls and optional delta uploads; real compiled-image,
  native, encrypted padsim, HTTP authorization and desktop/mobile regressions.

### Added — firmware 3.0.0, V5 multi-pad co-sign

- Persistent desk threshold/quorum policies with distinct paired crew identities;
  every pad clear-reviews the exact message and signs its raw SHA-256 after a hold.
- Executor gates phone, session and selected-pad signing/submission on fresh
  verified approvals; Connect displays the crew policy and approver names.
- Two encrypted native-backed simulated pads cover 2-of-2, refusal, expiry,
  disconnect, replay, identity/signature substitution and policy changes.

### Added — firmware 3.0.0, V5 offline price alerts

- Up to eight desk-configured, NVS-persisted one-shot price alerts; keyless
  Jupiter Price v3 over pinned Amazon Root CA 1 HTTPS at 30-second minimum intervals.
- Background bounded polling, offline-only TFT/LED/chime and no trade dispatch;
  native parser/scheduler regressions and a live pinned-root smoke check.

### Added — firmware 3.0.0, V4 Abilities SDK

- Embedded wasm3 with capability-only imports, instruction-dispatch fuel,
  bounded linear/engine memory, deadline traps and staged host effects.
- Two persistent developer-signed ability slots, full-key physical developer
  approval, encrypted installs and the desktop Abilities management screen.
- C/AssemblyScript templates, Market Pulse and Pomodoro discipline samples,
  external-signing bundle tools and native/ASan/UBSan sandbox escape regressions.
- Compiled, not yet flashed; hardware timing and production interpreter review
  remain explicit in `firmware/V3-NOTES.md`.

### Added — firmware 3.0.0, V2 on-pad session signing

- On-pad Ed25519 session generation, NVS policy/rolling debit journal, program
  allowlist, reviewed policy changes and exact-message hold/auto authorization.
- Conservative collateral-input caps refuse unpriced instructions and Phoenix
  packets without leverage. Counter reservations survive reboot and precede signing.
- Desk `pad` executor mode, public signer/policy API, signature verification and
  a native-firmware-backed encrypted simulator with real cryptographic tests.
- V2 remains compiled, not yet flashed; funded broadcast and unsupported exposure
  require further work documented in `firmware/V3-NOTES.md`.

### Added — firmware 3.0.0, V1 clear signing

- Bounded Solana legacy/v0 message parsing and the specified transfer, compute,
  pm-AMM, Jupiter v6 and Phoenix decoders, using real unsigned builder captures.
- On-pad transaction-byte fingerprints and full paged review; default-off red
  blind signing requires a fresh extra-three-second hold. Authenticated chunked
  desk transport records one approval for the exact message without signing it.
- Native/adversarial and real encrypted-link tests. Unauthenticated lookup
  evidence remains blind; Jupiter input mints use verified ATA derivations.
  Phoenix shows native lots/ticks and discloses absent account-wide leverage.
  This is item 1 of v3, compiled, not yet flashed; the full v3 release is pending.

### Added — firmware 2.0.0, S7 validation and research

- End-to-end padsim checks of encrypted wire records, live signal fingerprints,
  desk rejection of short holds/wrong fingerprints, released-hold cancellation,
  verified historical receipt delivery, signed OTA and corrupt-image rejection.
- Bidirectional authenticated replay rejection and kill persistence loaded by a
  new simulator before the desk relearns the latch; existing v1 tests retained.
- Protocol/reproduction documentation and P2 findings on custom WakeNet training
  costs and LVGL migration. Both remain research only. Firmware is 2.0.0,
  compiled, not yet flashed; hardware/phone/bootloader verification is pending.

### Added — firmware 2.0.0, S6 P1

- All P1 TFT screens, two explicit PSRAM sprites and the xorr.finance RGB565
  palette; live Market Pulse, real position rows/PnL, scrolling replies and
  coded fixes preserve unknown values and display priority.
- Persisted brightness/night/high-contrast/spoken-amount/left-handed settings,
  two-minute dim and ten-minute blank, with consumed wake/dismiss gestures.
- Cobalt idle breathing, lime pending pulses, mint receipt flashes, amber
  errors and kill-first solid red status indications.

### Added — firmware 2.0.0, S5 release hardening

- Compile out telnet in `XORR_RELEASE=1`, suppress application/SDK/portal logs,
  and gate USB diagnostics on volatile authenticated USB desk consent that is
  revoked on disconnect, transport failover, re-pair or reboot.
- Production Secure Boot v2, flash/NVS encryption and key-lifecycle planning
  with irreversible-step warnings. No security fuses or encryption enabled.

### Added — firmware 2.0.0, S5 manufacturing

- Physical 01+14 boot self-test: all fourteen keys, knob, mic meter, speaker
  sweep, TFT bars/grid, LED RGB, Wi-Fi scan and BLE advertising; signed unit
  reports with explicit failure/timeouts and serial PASS/FAIL verification.
- Physical 01+13 ten-second reset countdown with cancellation, suspended trade
  inputs, checked erasure of default/profile NVS and fresh pairing after reboot.

### Added — firmware 2.0.0, S4 health

- Panic-enabled task/idle watchdog, SDK brownout reset handling, bounded NVS
  reset history and encrypted 30-second uptime/heap/PSRAM/RSSI/temperature/link
  telemetry. Uptime uses the 64-bit monotonic clock.
- Flash core dump upload with contiguous bounded chunks, SHA-256 and size-bound
  acknowledgments, durable private desk storage, reconnect/re-pair recovery
  and lost-ack retries. Flash is erased only after the desk saves the full image.

### Added — firmware 2.0.0, S4 voice

- 16 kHz mono Opus at 24 kbps, push-to-talk energy VAD/noise gate, live TFT
  waveform, ordered Opus TTS and USB/Wi-Fi PCM fallback. Codec state resets per
  utterance; disconnects and congestion stop capture with an actionable message.
- Five distinct accept/refuse/fill/error/kill cues and shared speaker gain,
  adjusted by the knob in Voice mode. Native tests use the actual ESP32 Opus
  library; encrypted simulator tests decode real Opus TTS and preserve PCM.

### Added — firmware 2.0.0, S3 profiles and knob

- Eight persistent profiles with Spot, Perps and Predict keymaps; desk sync
  stages every layer before atomically replacing the saved snapshot. Selection
  persists locally and the TFT identifies the active profile and layer.
- A dedicated 256 KB profile NVS partition retains both 3 MB A/B app slots and
  the 16 MB flash layout. Profile names and all fourteen bindings are validated;
  MIC, KILL, YES and NO stay in their measured cells.
- Debounced rotary input, speed-dependent size/leverage/slippage changes,
  short-press mode cycling and long-press voice PTT. Offline/killed inputs do
  not change trade settings. Encrypted USB tests cover all 24 profile maps and
  the desk's size cap, leverage and slippage defaults.

### Added — firmware 2.0.0, S3 kill latch

- A two-second physical KILL persists disarm in NVS, stops queued inputs and
  voice, forces solid red, and refuses signals even while offline or rebooted.
- Re-arm requires a paired desk request and a fresh 800 ms physical YES hold
  within 15 seconds. Failed storage clears remain killed; disconnects revoke
  consent. Native tests cover timers, reboot bytes and failed persistence.

### Added — firmware 2.0.0, S2 secure pairing and link reliability

- TFT code/QR pairing with persistent device identities, fresh one-use device
  challenges, X25519 directional keys and ChaCha20-Poly1305 replay protection.
- BLE Secure Connections passkey enforcement and authenticated subscriptions;
  a BLE pairing prompt blocks trade confirmation until the signal is visible.
- Native frame/CRC/AEAD conformance tests and real TCP delivery-fault tests.

### Fixed — firmware 2.0.0, S2

- Keep control-frame replay tracking separate from reliable acknowledgments so
  heartbeats cannot discard lost data; recover dropped acknowledgments safely.
- Expire links during backend work, back off reconnects, prefer USB/BLE/Wi-Fi,
  reject standby trade inputs, and discard expired outbound signals.
- Gate every legacy HTTP request on the desk-enabled legacy setting and discard
  old Wi-Fi output on failover. Keep v1 desk compatibility.

### Added — firmware 2.0.0, S1 desk integration

- Encrypted v2 pad pairing and transport, serial CRC, acknowledgments/retries,
  telemetry/crash intake, signed OTA upload, profiles and BLE Opus bridging.
- Canonical trusted-signal fingerprints in queue events and trade confirmation;
  changed executable quotes require a fresh review.
- Connect controls for QR/code pairing, pad settings, signed firmware updates,
  profile selection and the desk/physical-hold kill-latch rearm flow.
- Stateful v2 pad simulator and real encrypted desk integration coverage.

### Fixed

- Reject incomplete or expired rearm confirmations, refresh the watchdog on
  authenticated control traffic, and bound crash uploads before saving them.
- Preserve the operator-refusal rule when accepting fingerprint-aware requests
  and isolate the v2 simulator's port from the existing signals tests.

## [1.0.1] - 2026-11-12

### Fixed

- Replace the dead primary Pyth Benchmarks history URL with mint-pinned
  GeckoTerminal Solana pool OHLCV, including cached pool selection, backward
  paging, a shared rate limiter and HTTP 429 backoff.
- Preserve Pyth as the secondary history provider and expose each attempted
  provider's failure. Disclose partial archive coverage and missing gate warm-up.
- Name the pool and DEX in chart/replay provenance; label perp charts as an
  underlying spot reference alongside the venue's live mark.
- Preserve all candle resolutions through complete-bar aggregation, validate
  requested-window duplicates, and share raw in-flight pages across ranges.

## [1.0.0] - 2026-11-12

### Added

- Shared Solana route comparison with live venue discovery, price/fee/impact
  disclosure, missing-venue reasons and mint-pinned catalog identities.
- Direct Meteora DLMM USDC-pair quotes and unsigned swaps alongside Jupiter spot,
  with Jupiter routing across Solana spot venues and the existing xStock book.
- Phoenix live perps markets, depth-based long/short quotes, actual positions,
  unsigned opens and ReduceOnly closes; Jupiter Perps SOL/ETH/BTC indicative
  quotes, on-chain fee reads and unsigned API open/close builders.
- pm-AMM devnet market reads, decay-aware YES/NO quotes, unsigned create/swap/claim,
  positions, expiring Solana Pay handoffs and outcome/perp hedge proposals.
- Separate devnet-only recurring-market keeper with deterministic SOL/BTC hourly
  and ETH daily scheduling, funding guards, exact-expiry Pyth/confidence rules,
  recovery journal and public resolution evidence. Chain-derived creator stats
  expose incomplete archive reads rather than substitute invented totals.
- Persisted permissions after memory vetoes: per-trade/day/leverage/position caps,
  venue/market restrictions, cooldown, quiet hours, manual thresholds and explicit
  deciding rule IDs. Auto-accept stays off by default and requires speech/logging.
- Expiring trade-signal queue, authenticated accept/refuse/signed-wallet routes,
  WebSocket events, durable execution reservations and confirmed receipts.
- Optional Electron safeStorage session wallet and protected Node wallet storage;
  exact-message signing capabilities, last-moment policy checks, RPC genesis
  validation and explicit mainnet acknowledgement for local signing.
- Bring-your-own-model Ollama/Anthropic/compatible-provider agent with gated tools,
  safeStorage API-key entry, model discovery, editable/resettable persona and
  persistent searchable/renameable/exportable chats with tool metadata.
- Deepgram Nova-3 streaming STT and Aura PCM TTS, ordered pad/desk playback,
  exact-number proposal speech and explicit missing-key/fallback states.
- Firmware USB-CDC, Nordic UART BLE and authenticated Wi-Fi NDJSON link manager,
  transport priority/expiry, no uncertain trade replay, nonblocking provisioning,
  persisted protected 14-key programming and protocol-level knob support.
- Firmware v1 boot/hello version, pending-signal countdown/AUTO, confirmation and
  refusal controls, confirmed signature/Explorer receipt display and PCM bridge.
- Real host pad simulator, fragmented TCP/HTTP/WebSocket framing checks and actual
  serialport/PTY round trips; host-rendered firmware layout evidence.
- Nine-page responsive desk: Pad, Trade, Predict, Chats, Models & keys, Permissions,
  Positions, Backtest and Link, with Floor/Paper/Neon themes and screenshot matrix.
- Real-history strategy/backtest tools, bounded rules, Pyth cache/provenance,
  fees/slippage/funding accounting, metrics and counterfactual pm-AMM curve replay.
- Standalone landing with actual prototype/desk imagery, durable Redis waitlist,
  live signup counts and terms-gated Solana Pay USDC reservations with immutable
  payment expectations and finalized on-chain receipt validation.
- Vercel deployment handoff, responsive landing evidence, v1 setup/architecture/
  safety documentation, deployment table, consolidated full-run test evidence and
  hackathon/bounty submission draft with explicit Nick-only TODOs.

### Changed

- Release metadata agrees at 1.0.0 for desk, keeper and firmware; keeper manifest
  and lockfile now declare the release version. The site already declares 1.0.0.

### Removed

- Nothing. v1 is additive: Classic, legacy HTTP/voice/provisioning paths, existing
  memory gates, market warnings and tests remain available.

### Known limitations

- Hardware is compiled, not yet flashed. Physical USB/BLE, persistence, display
  orientation, mic/amp and the unwired encoder need hardware verification.
- XOR Expo source is external; phone relay, push and public-TLS wallet completion
  are unverified. Packaged app verification remains outstanding.
- Funded devnet trade/receipt and keeper creation/resolution need funding and
  Hermes access; no new successful full cycle is asserted by this release.
- The specified Pyth history endpoint returns HTTP 404; successful historical
  replay/no-look-ahead evidence remains blocked. Provider and voice checks need
  a reachable model and credentials; live APIs may rate-limit requests.
- Landing persistence and a funded reservation payment need real Upstash,
  approved terms/merchant/price and deployment. Read [TESTING.md](TESTING.md)
  for exact current results and actions; this entry does not claim all tests pass.
