nickthelegend/xorrpad/docs/screens/v4/journal-activity-375.png

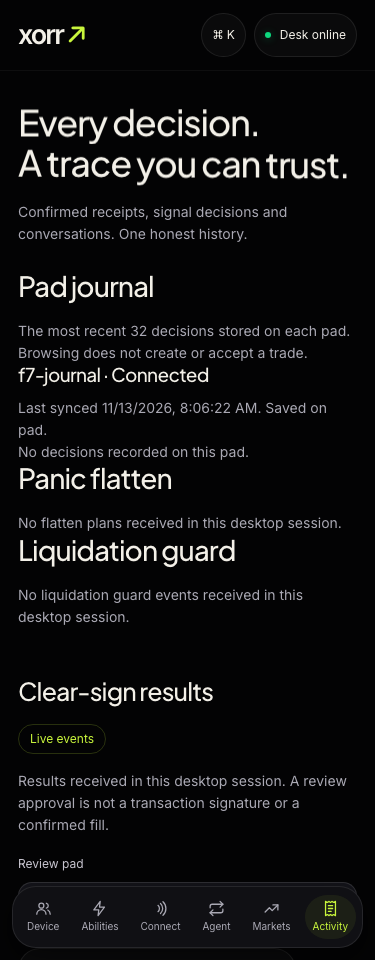
docs/screens/v4/journal-activity-375.png
