nickthelegend/xorrpad/docs/screens/v4/journal-activity-1440.png

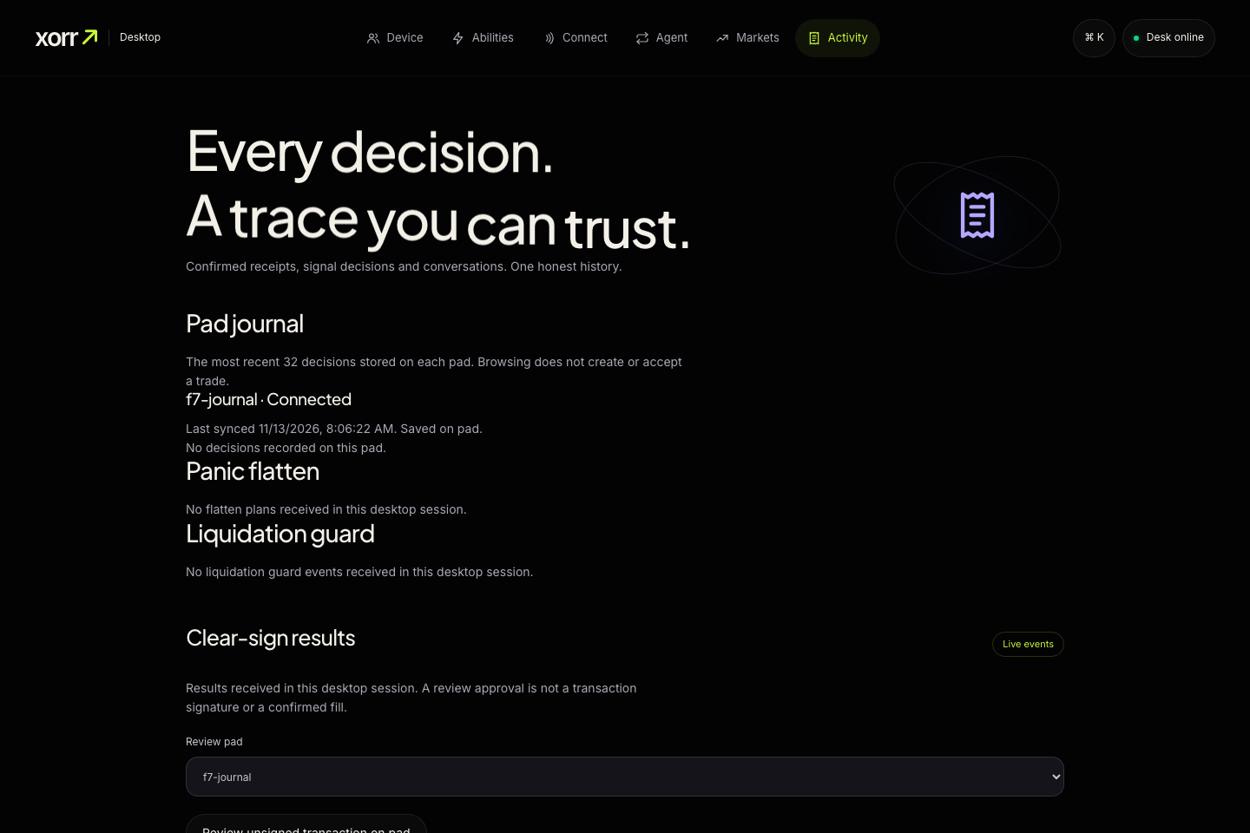
docs/screens/v4/journal-activity-1440.png
