nickthelegend/xorrpad/docs/screens/v4/journal.png

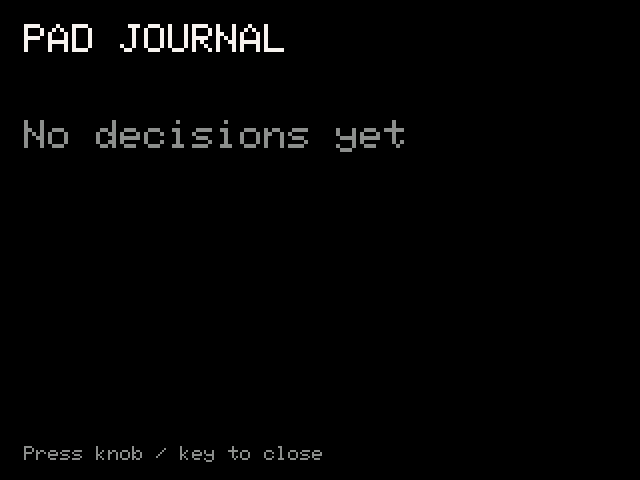
docs/screens/v4/journal.png
