nickthelegend/xorrpad/docs/screens/v4/mirror-pad-journal-layout.png

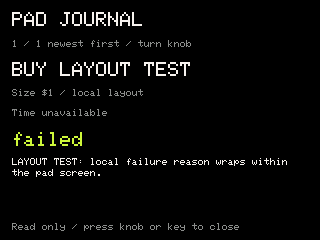
docs/screens/v4/mirror-pad-journal-layout.png
