nickthelegend/xorrpad/hardware/generated/core/fab/core-board.pdf

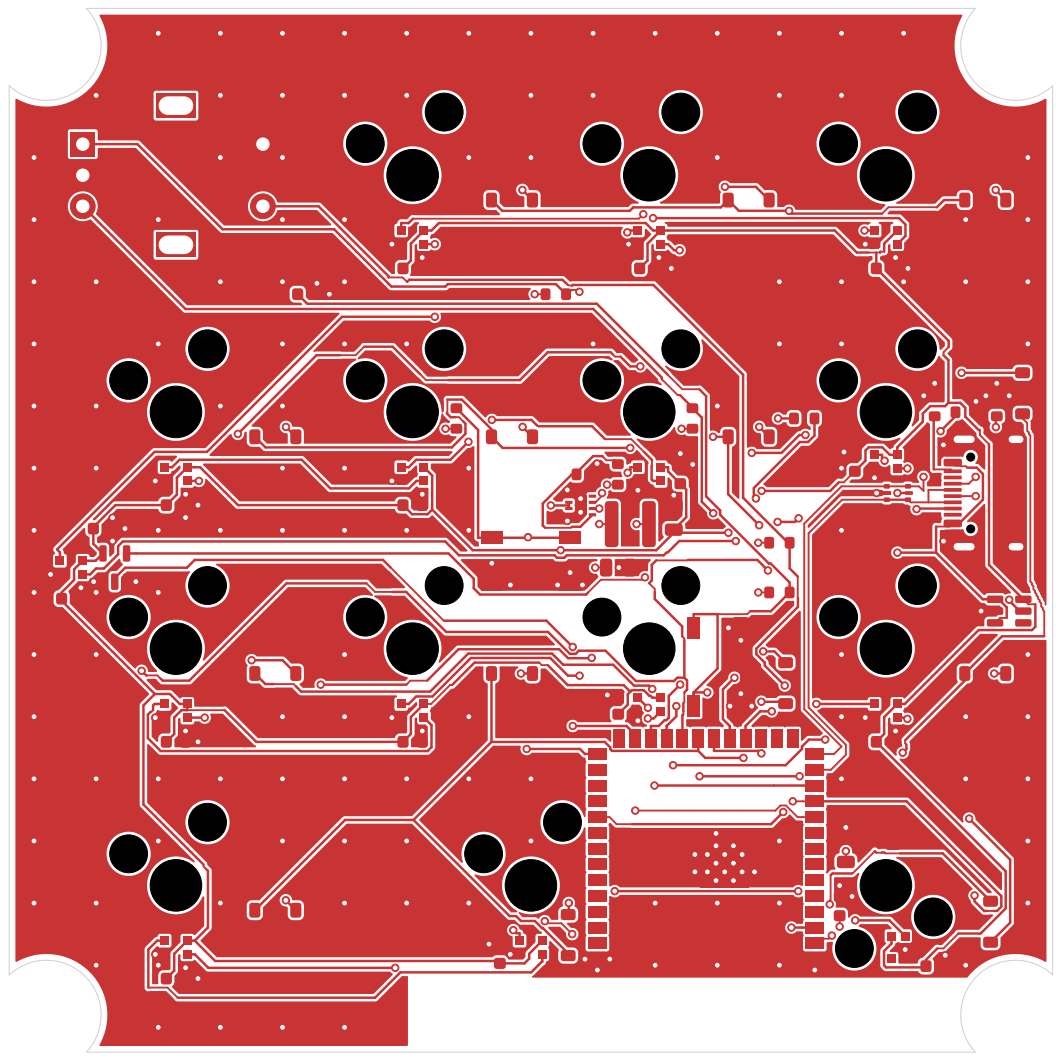
[picture p67: page 1]

Size: A4 | Rev:
KiCad E.D.A. 10.0.6 | Id: 1/8

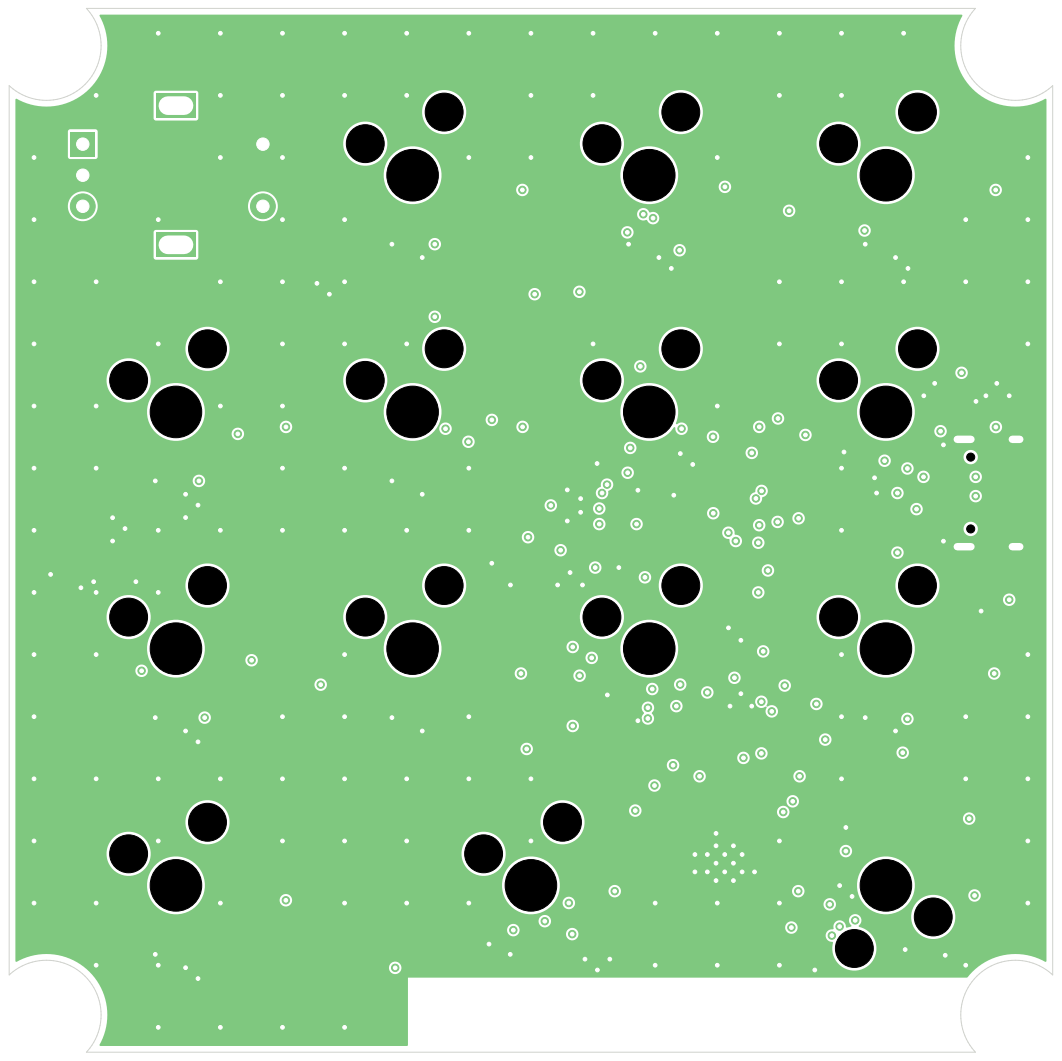
[picture p68: page 2]

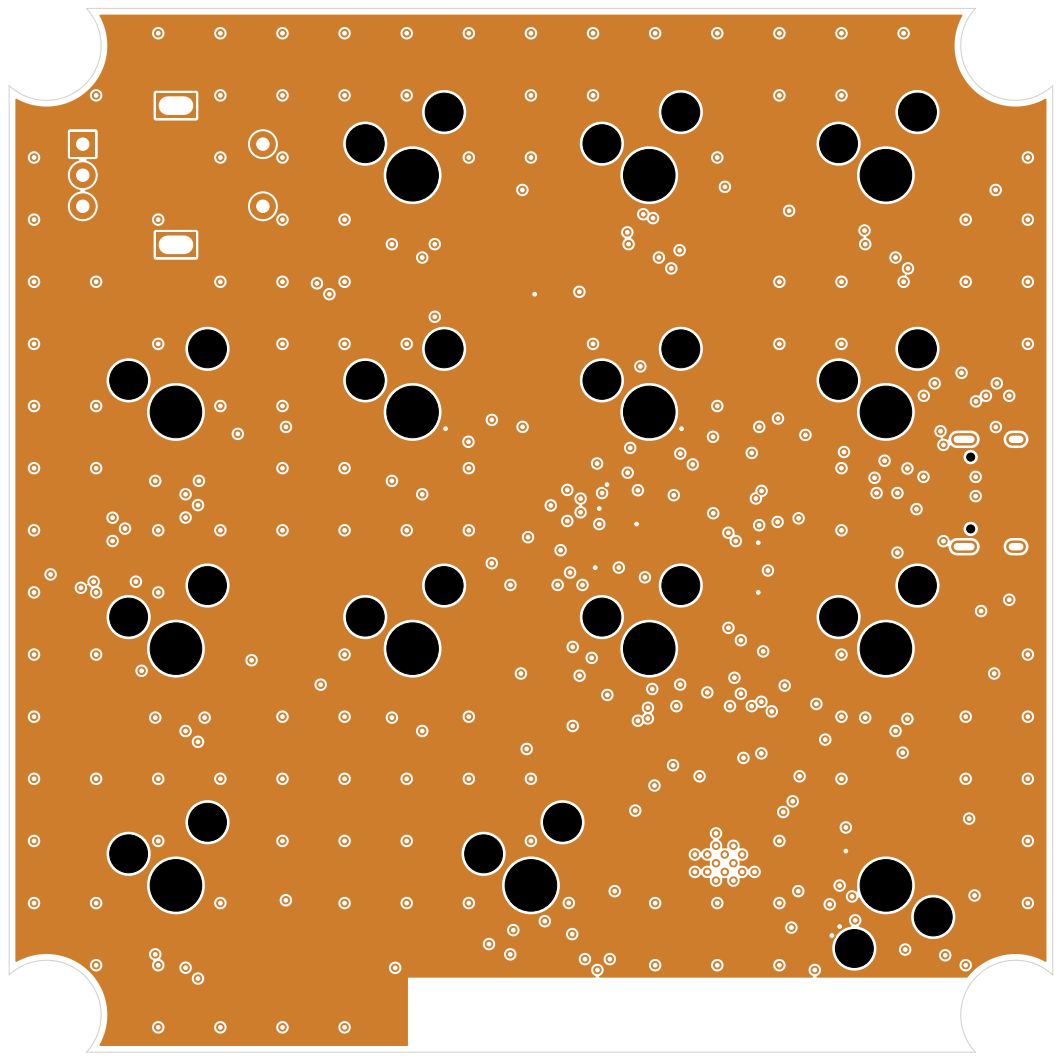
[picture p69: page 3]

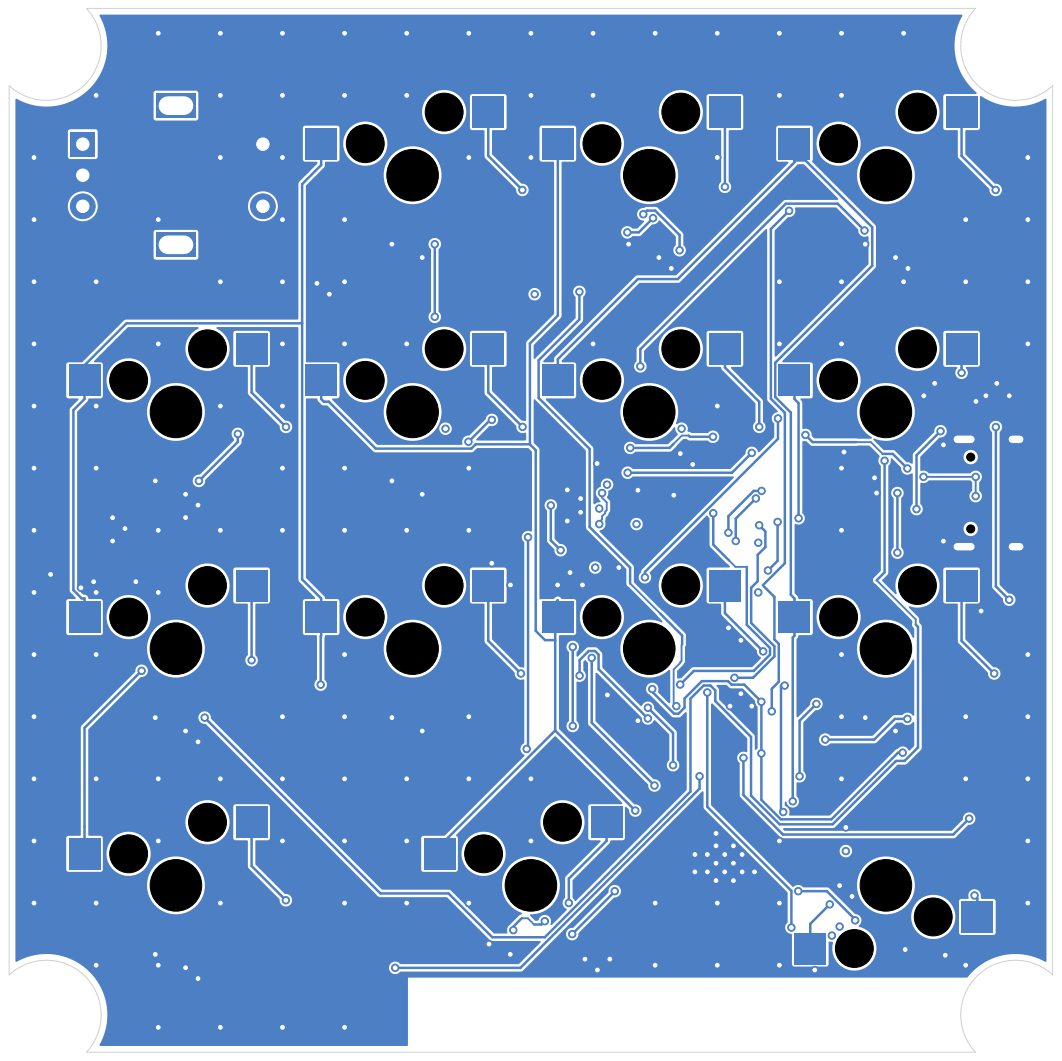
[picture p70: page 4]

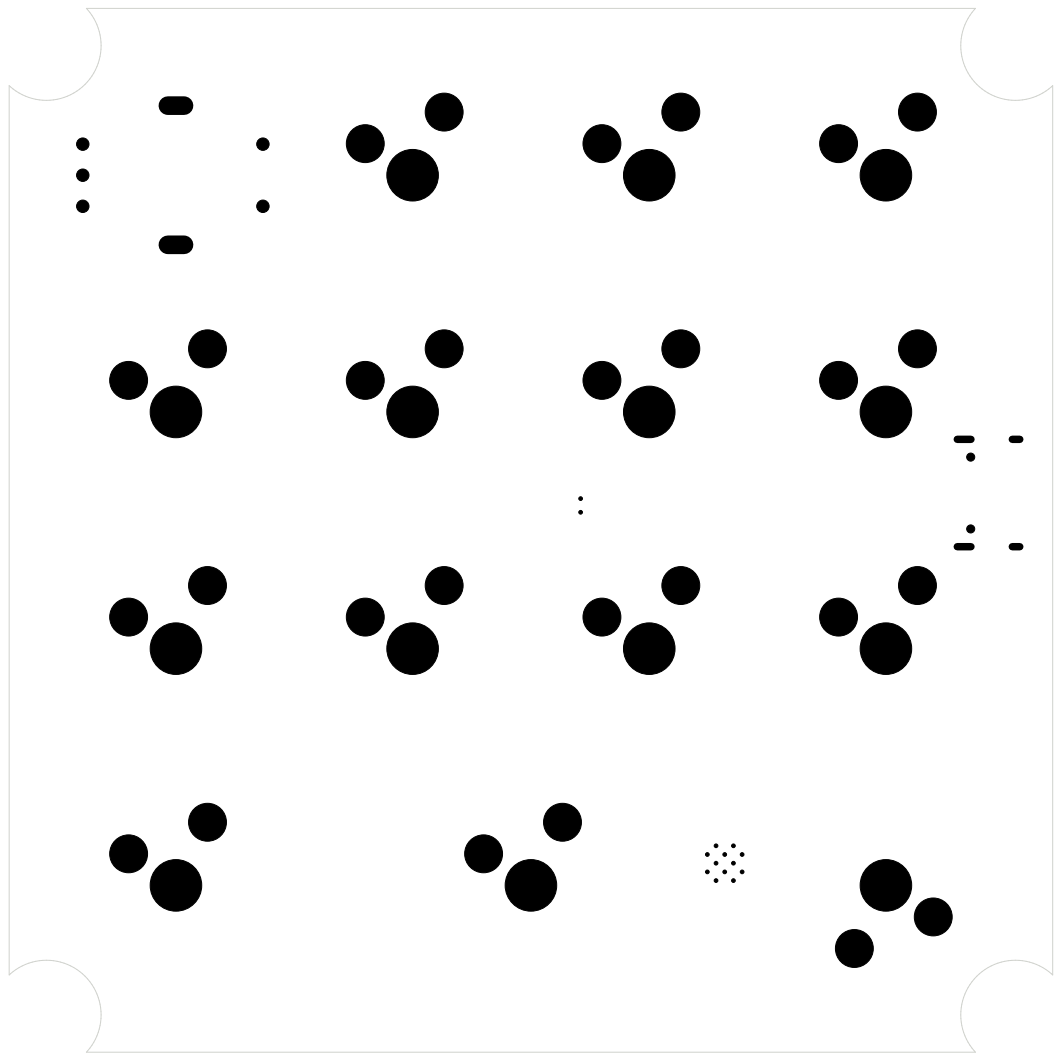
[picture p71: page 5]

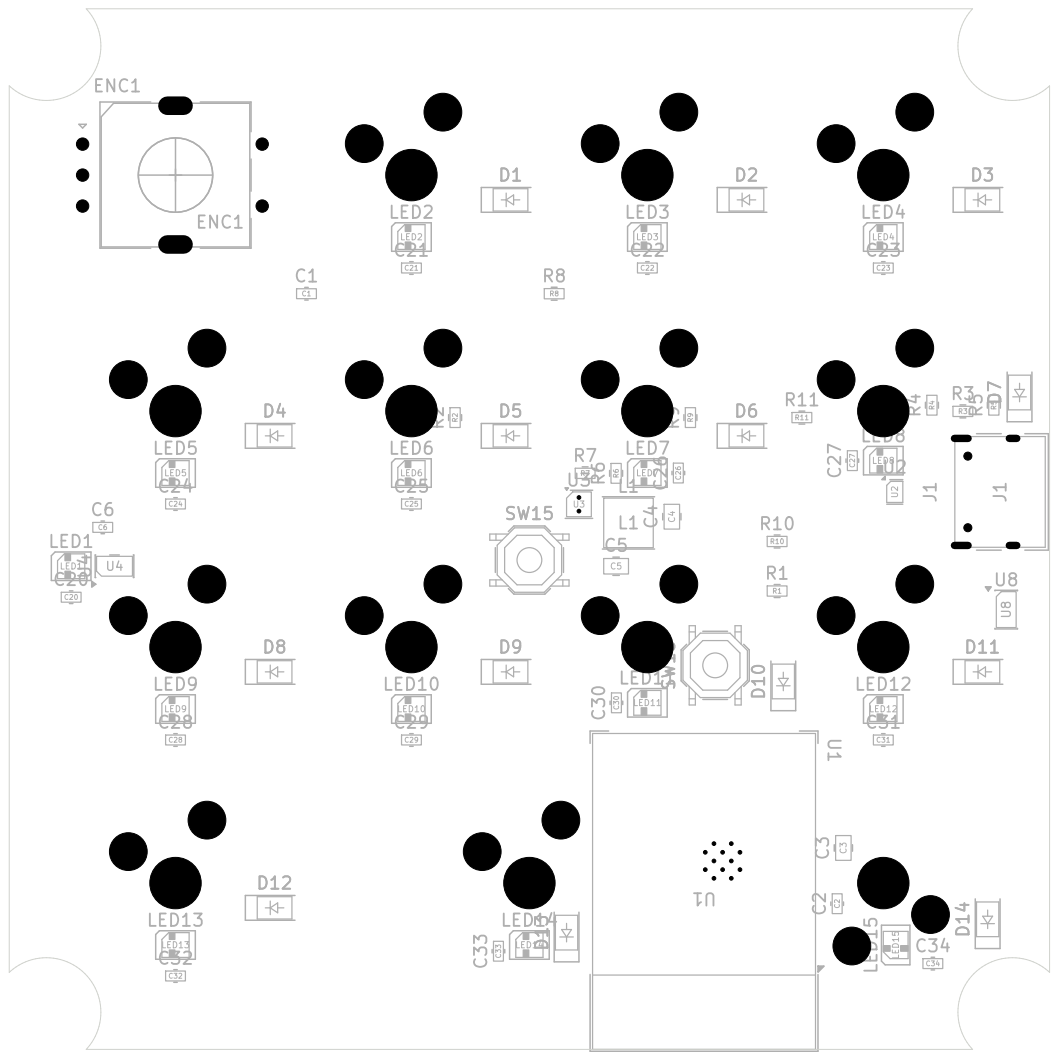
[picture p72: page 7]

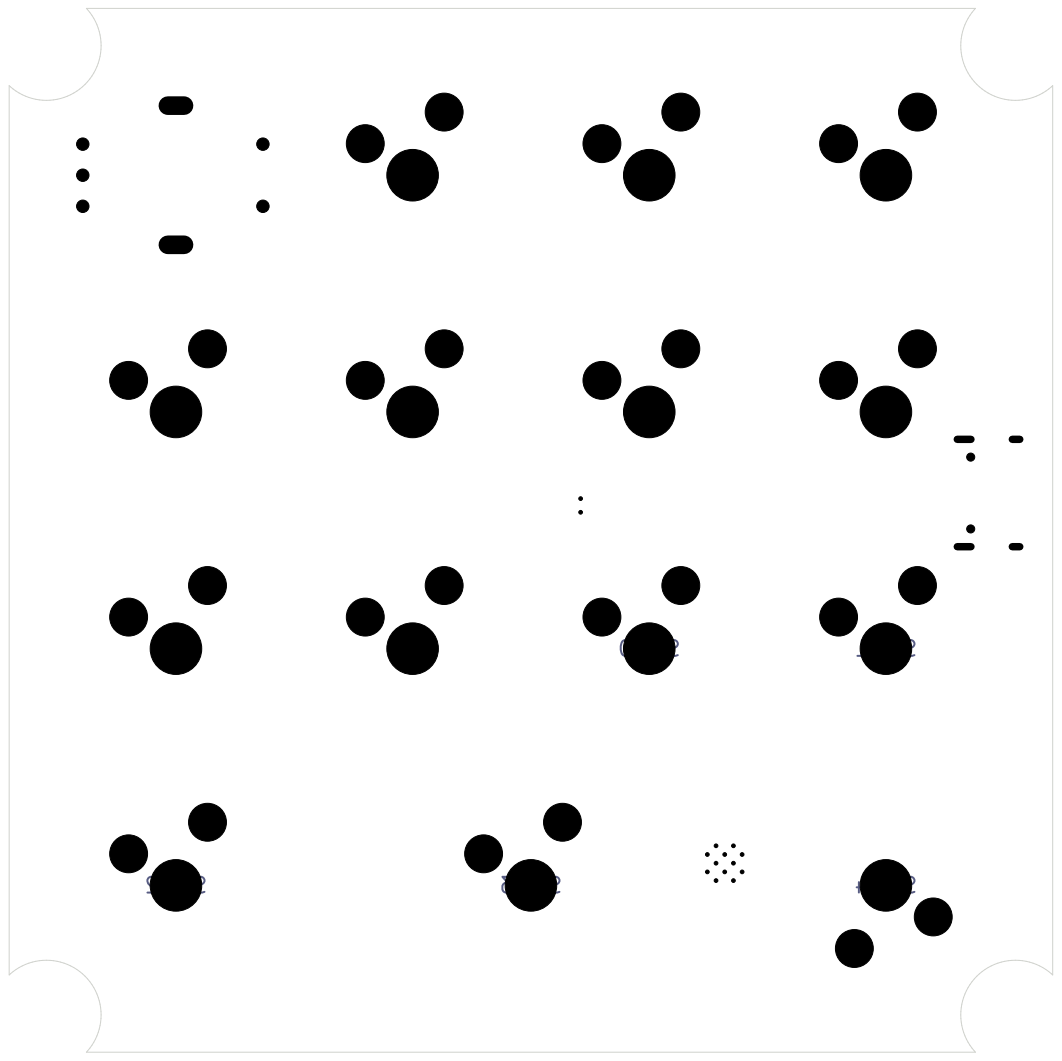
[picture p73: page 8]
