nickthelegend/xorrpad/hardware/generated/core/fab/core-schematic.pdf

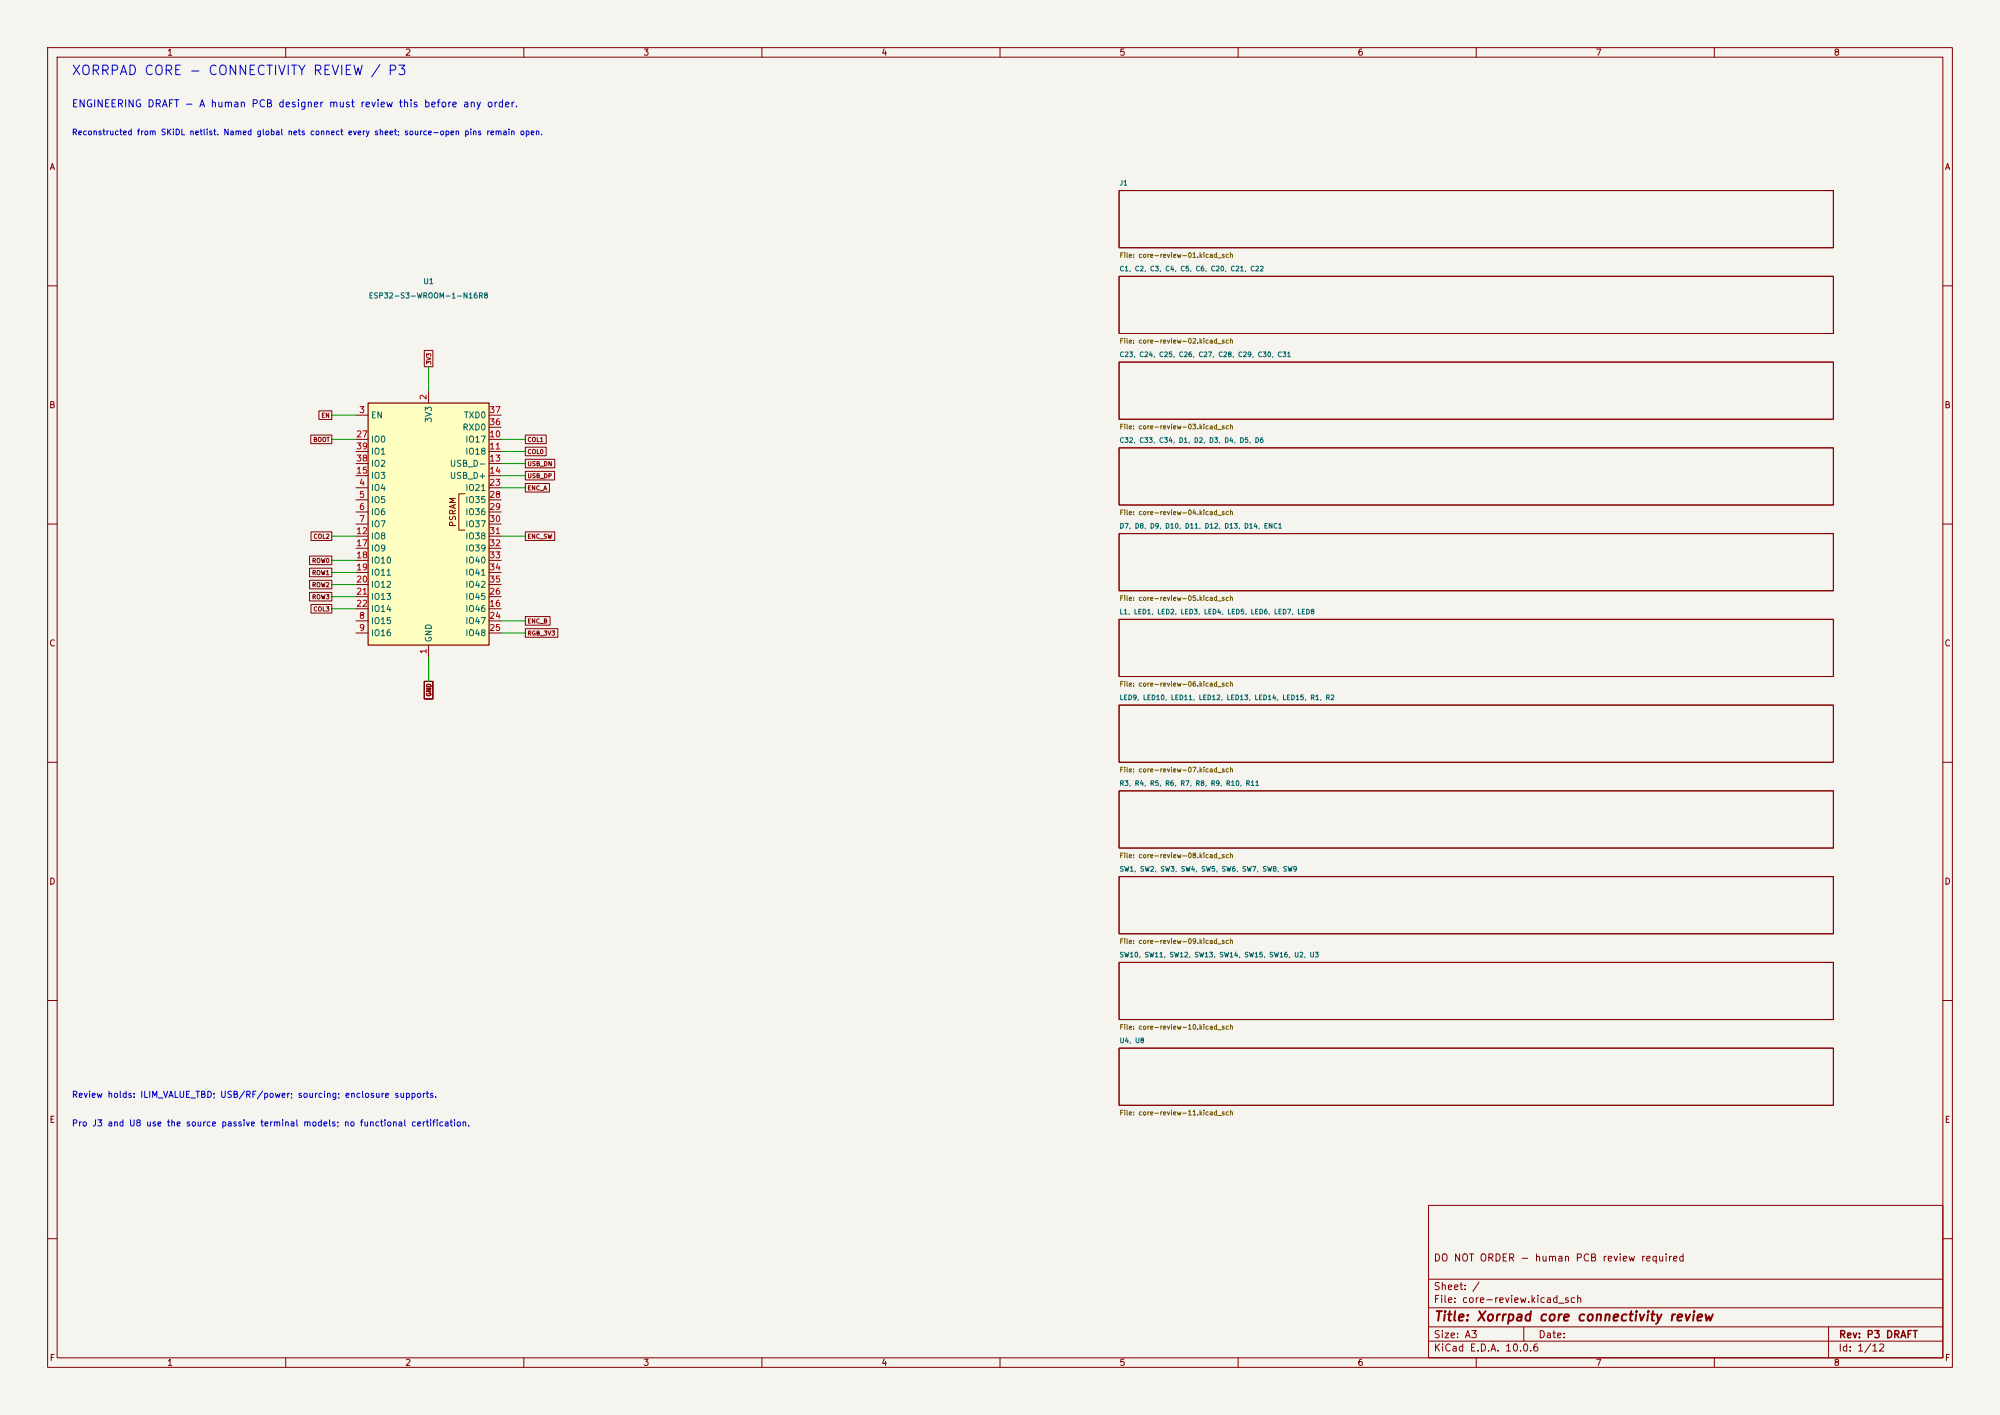
[picture p74: page 1]

XORRPAD CORE - CONNECTIVITY REVIEW / P3

ENC_A USB_DP Reconstructed from SKiDL netlist. Named global nets connect every sheet; source-open pins remain open. ENGINEERING DRAFT - A human PCB designer must review this before any order.

File: core-review-09.kicad_sch PSRAM GND

Review holds: ILIM_VALUE_TBD; USB/RF/power; sourcing; enclosure supports. Pro J3 and U8 use the source passive terminal models; no functional certification.

DO NOT ORDER - human PCB review required

Sheet: /
File: core-review.kicad_sch
Title: Xorrpad core connectivity review

Size: A3 | Rev: P3 DRAFT | F Date:
KiCad E.D.A. 10.0.6 | Id: 1/12

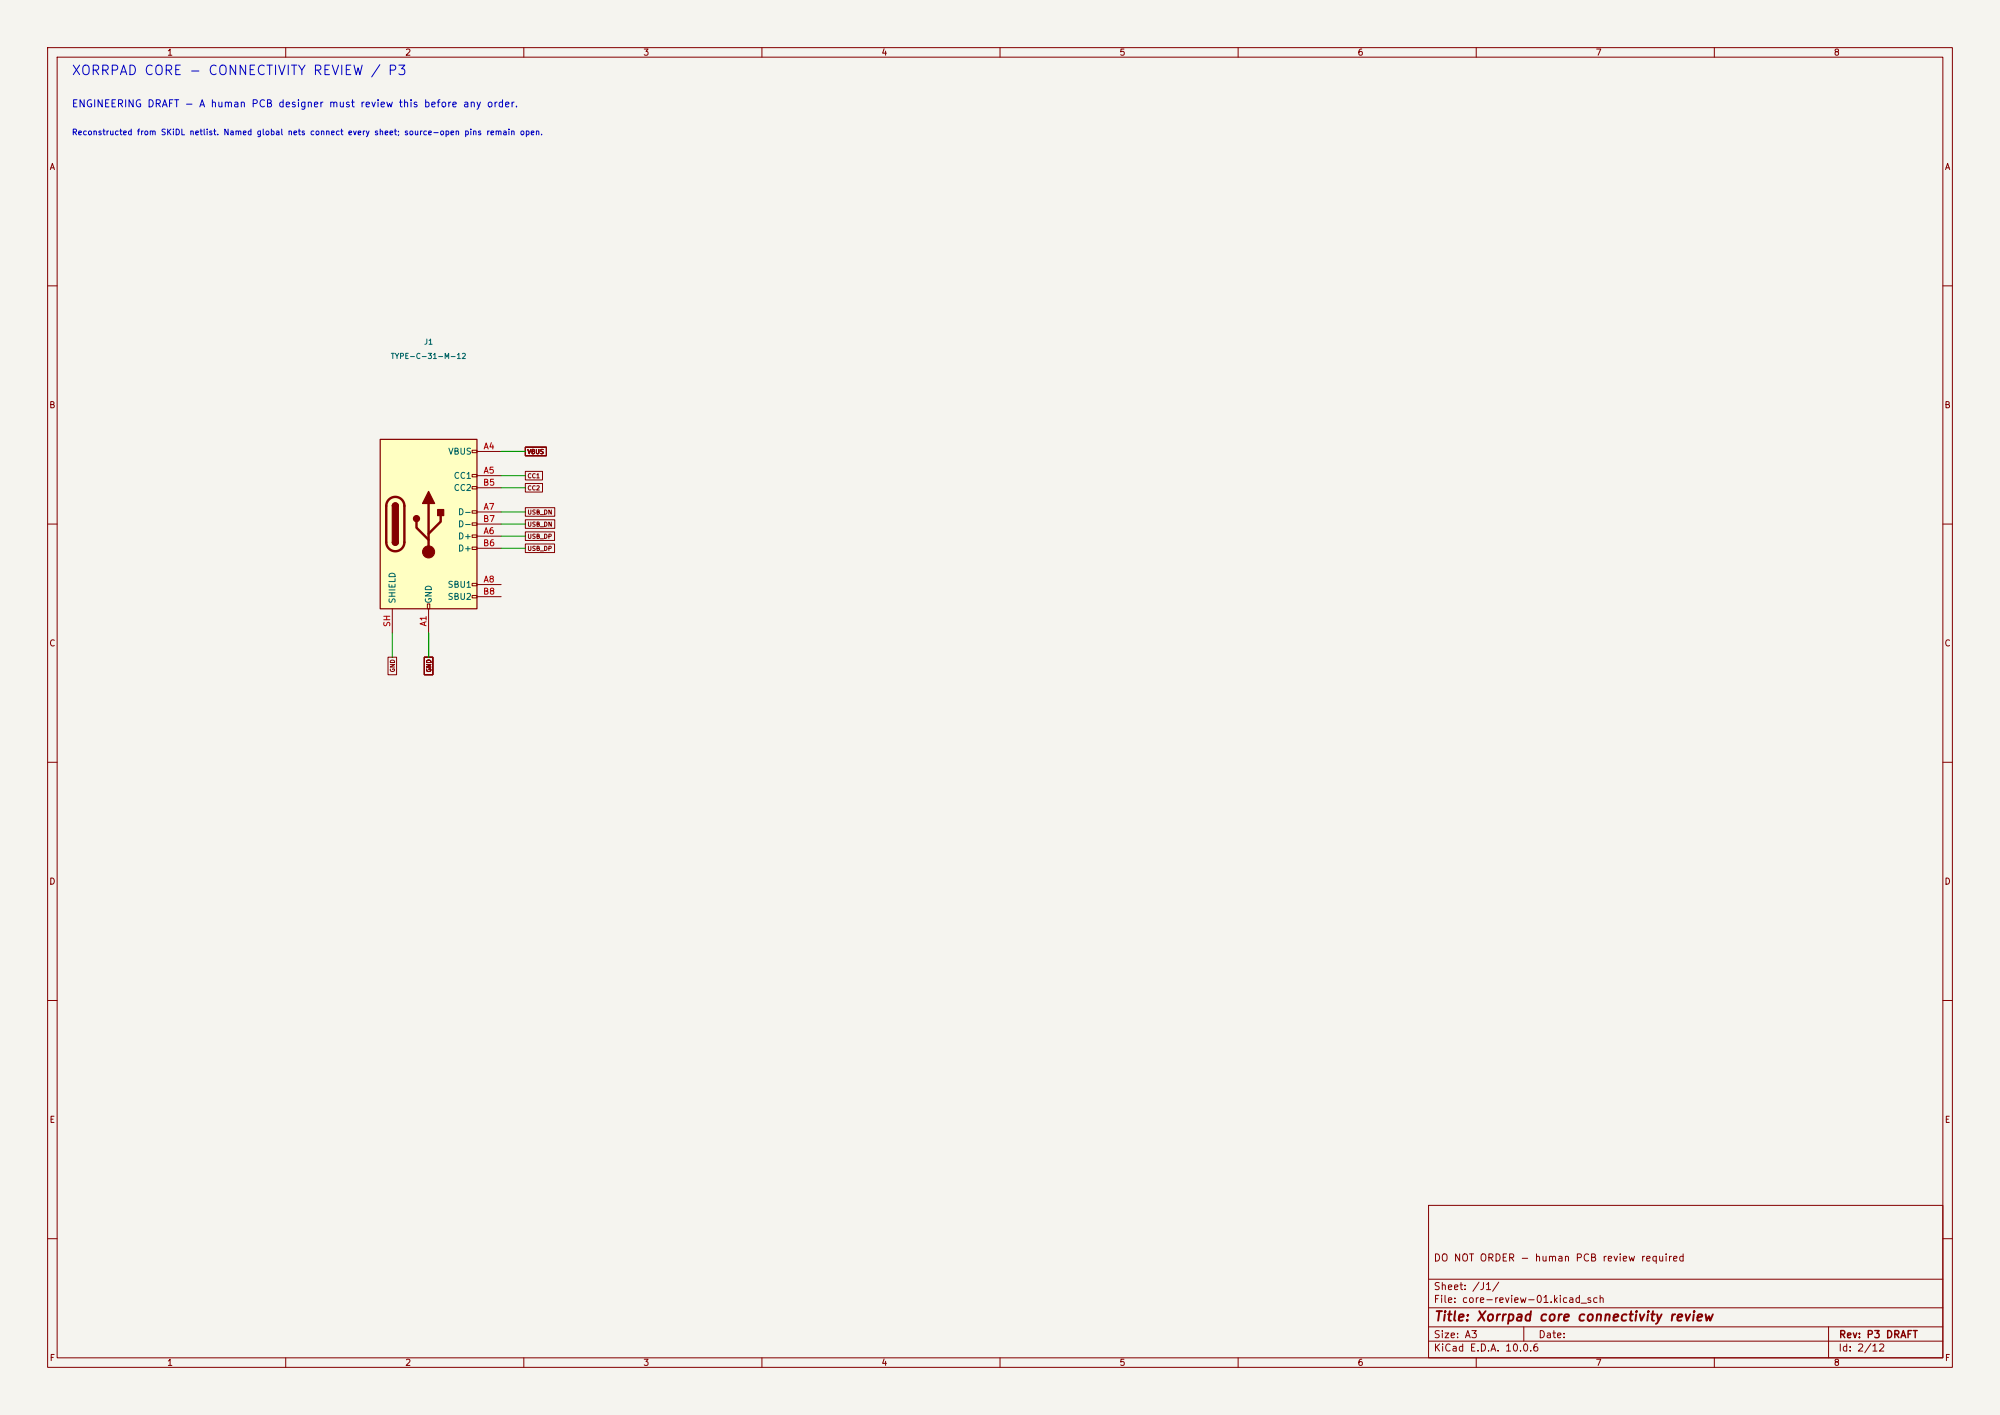
[picture p75: page 2]

VBUS CC1 XORRPAD CORE - CONNECTIVITY REVIEW / P3

ENGINEERING DRAFT - A human PCB designer must review this before any order. Reconstructed from SKiDL netlist. Named global nets connect every sheet; source-open pins remain open.

DO NOT ORDER - human PCB review required GND A1

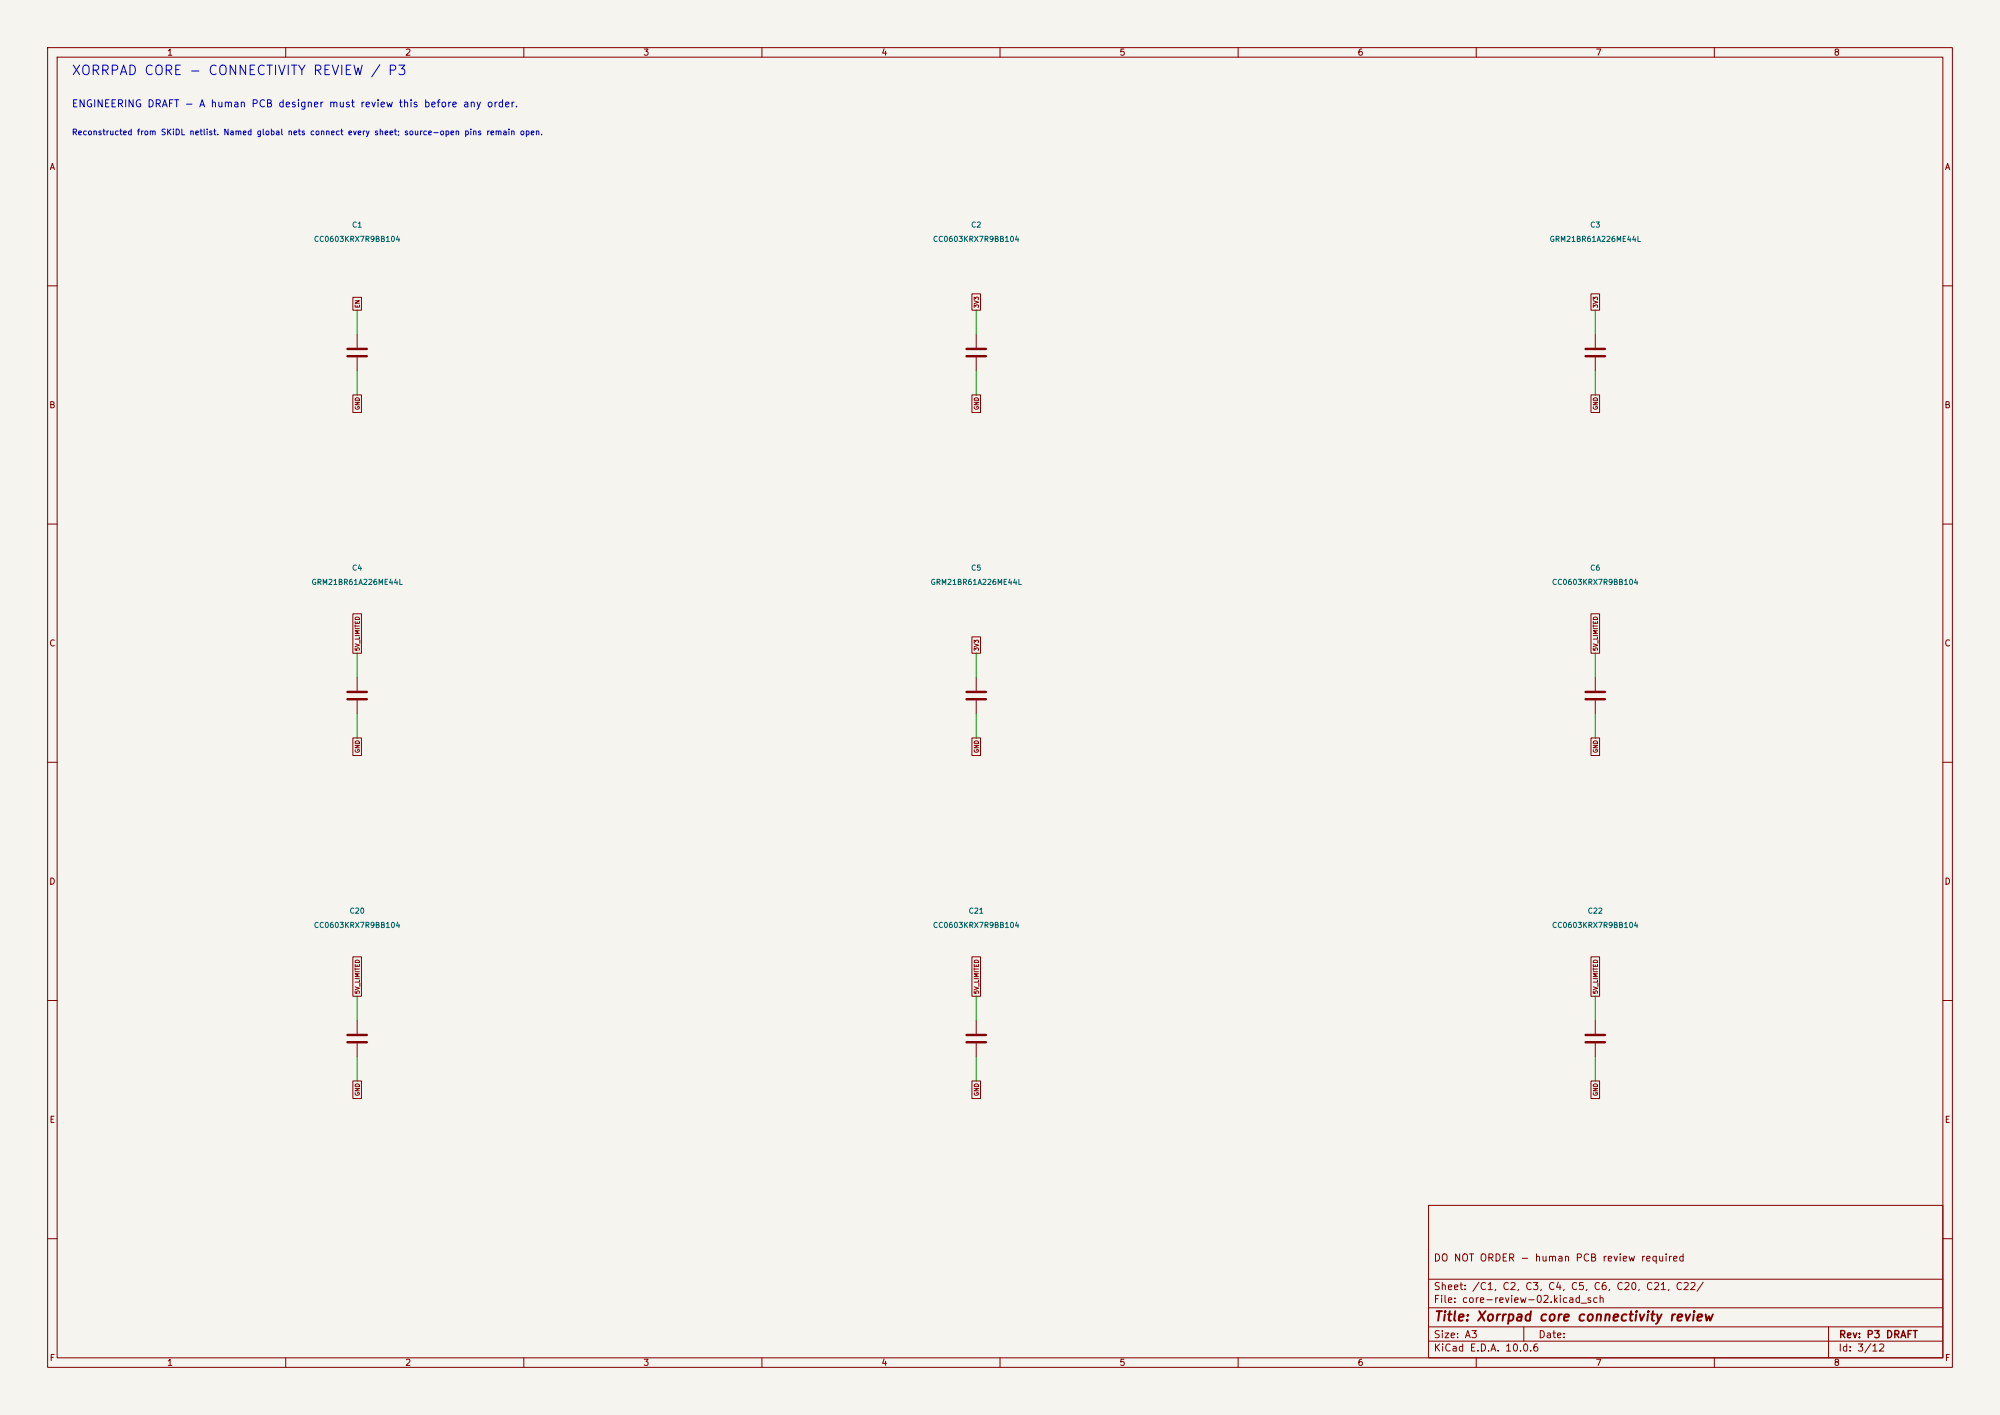
[picture p76: page 3]

ENGINEERING DRAFT - A human PCB designer must review this before any order. Reconstructed from SKiDL netlist. Named global nets connect every sheet; source-open pins remain open. XORRPAD CORE - CONNECTIVITY REVIEW / P3

DO NOT ORDER - human PCB review required

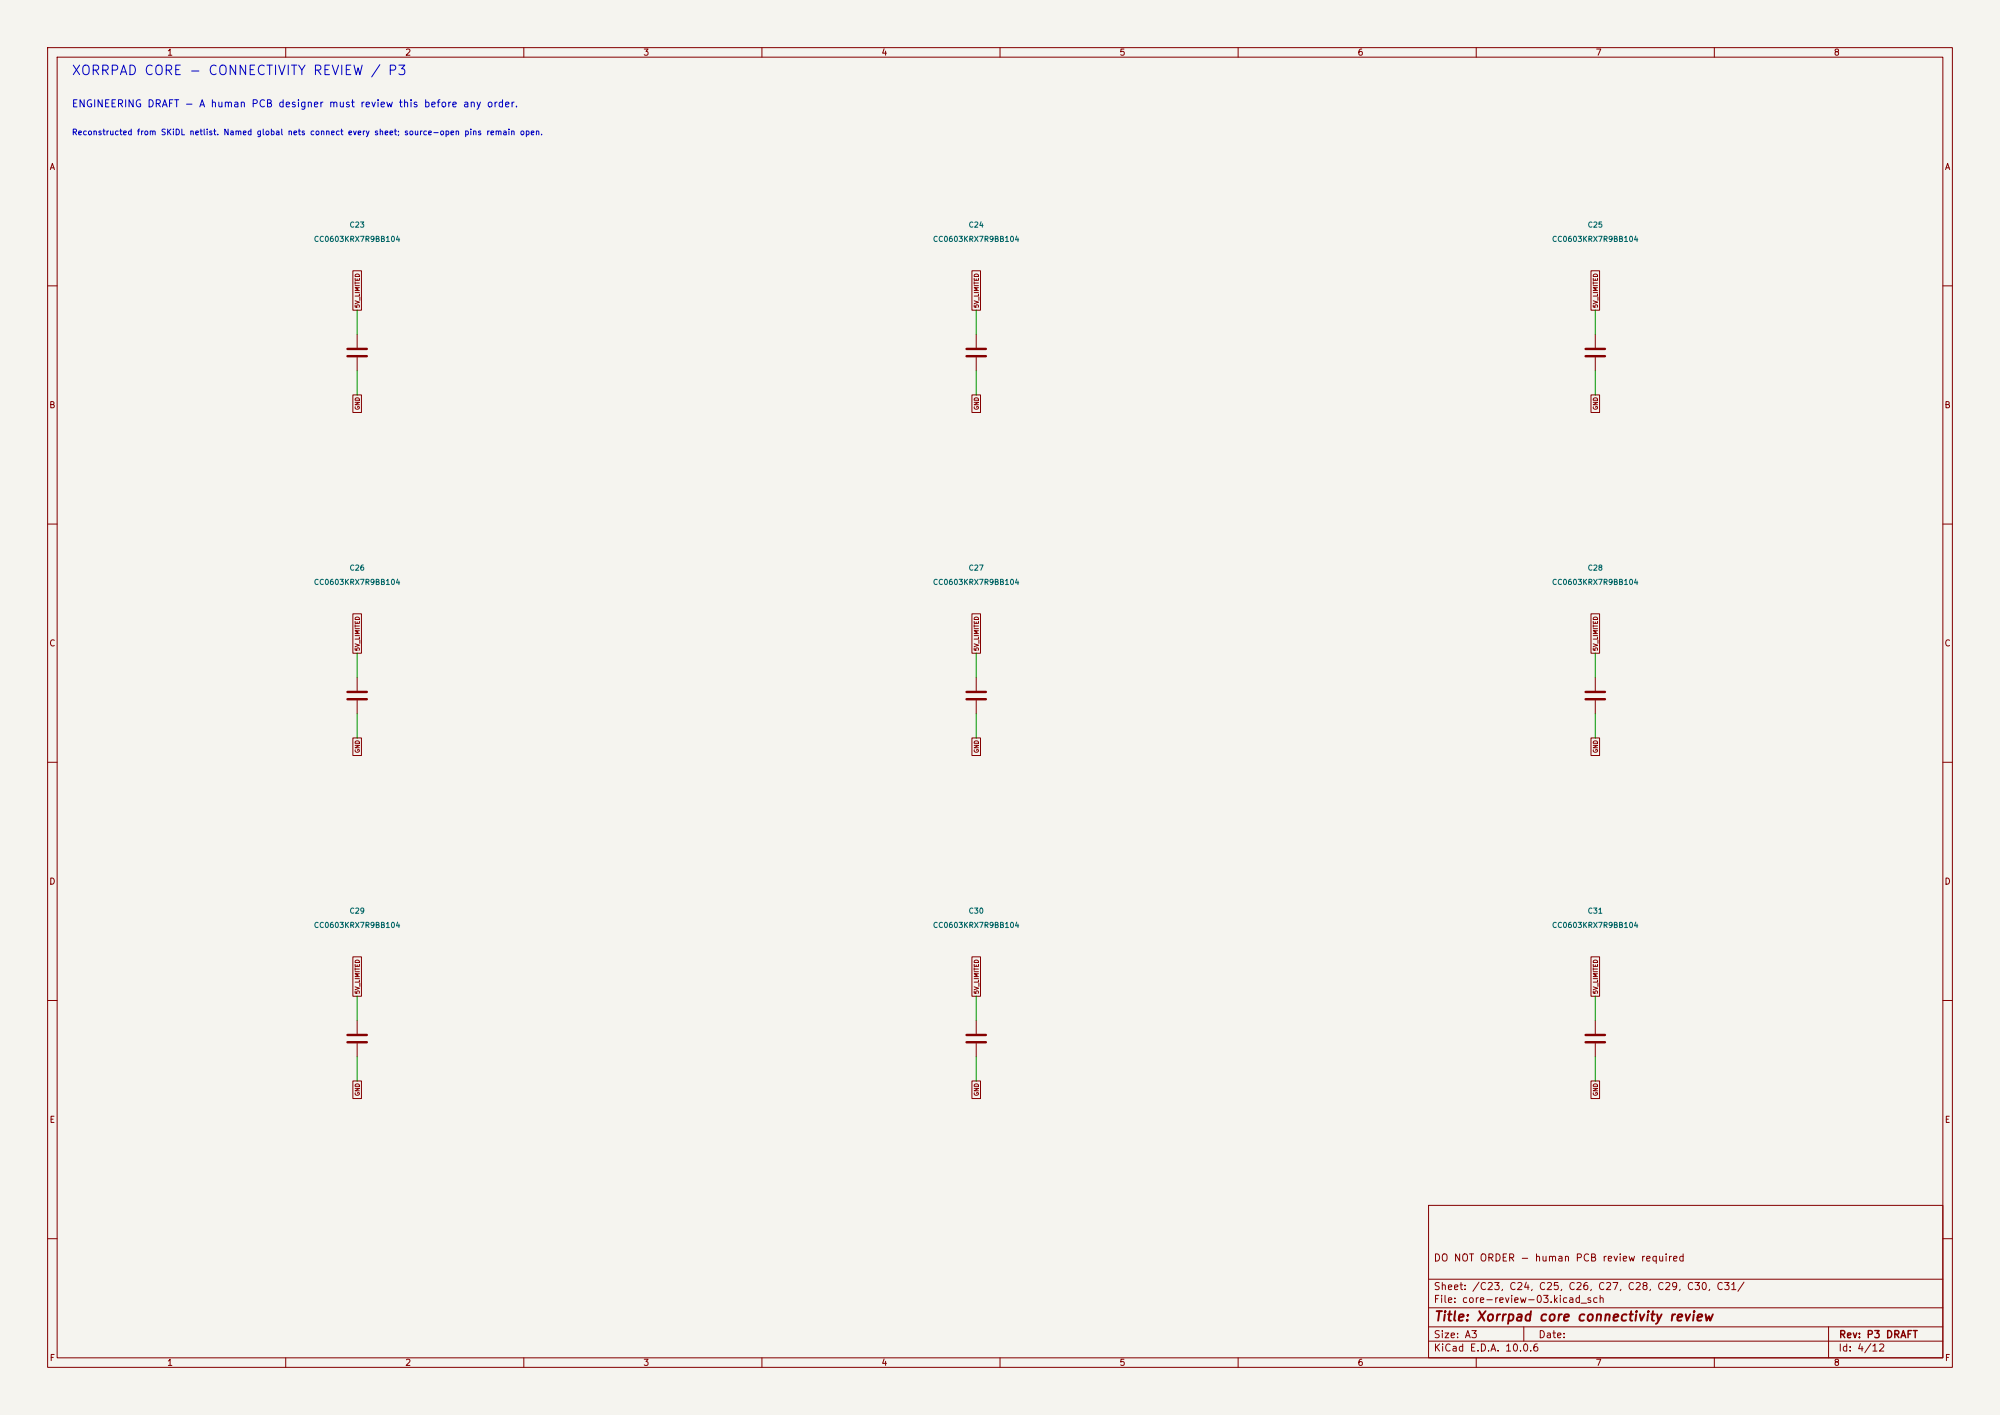
[picture p77: page 4]
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

DO NOT ORDER - human PCB review required

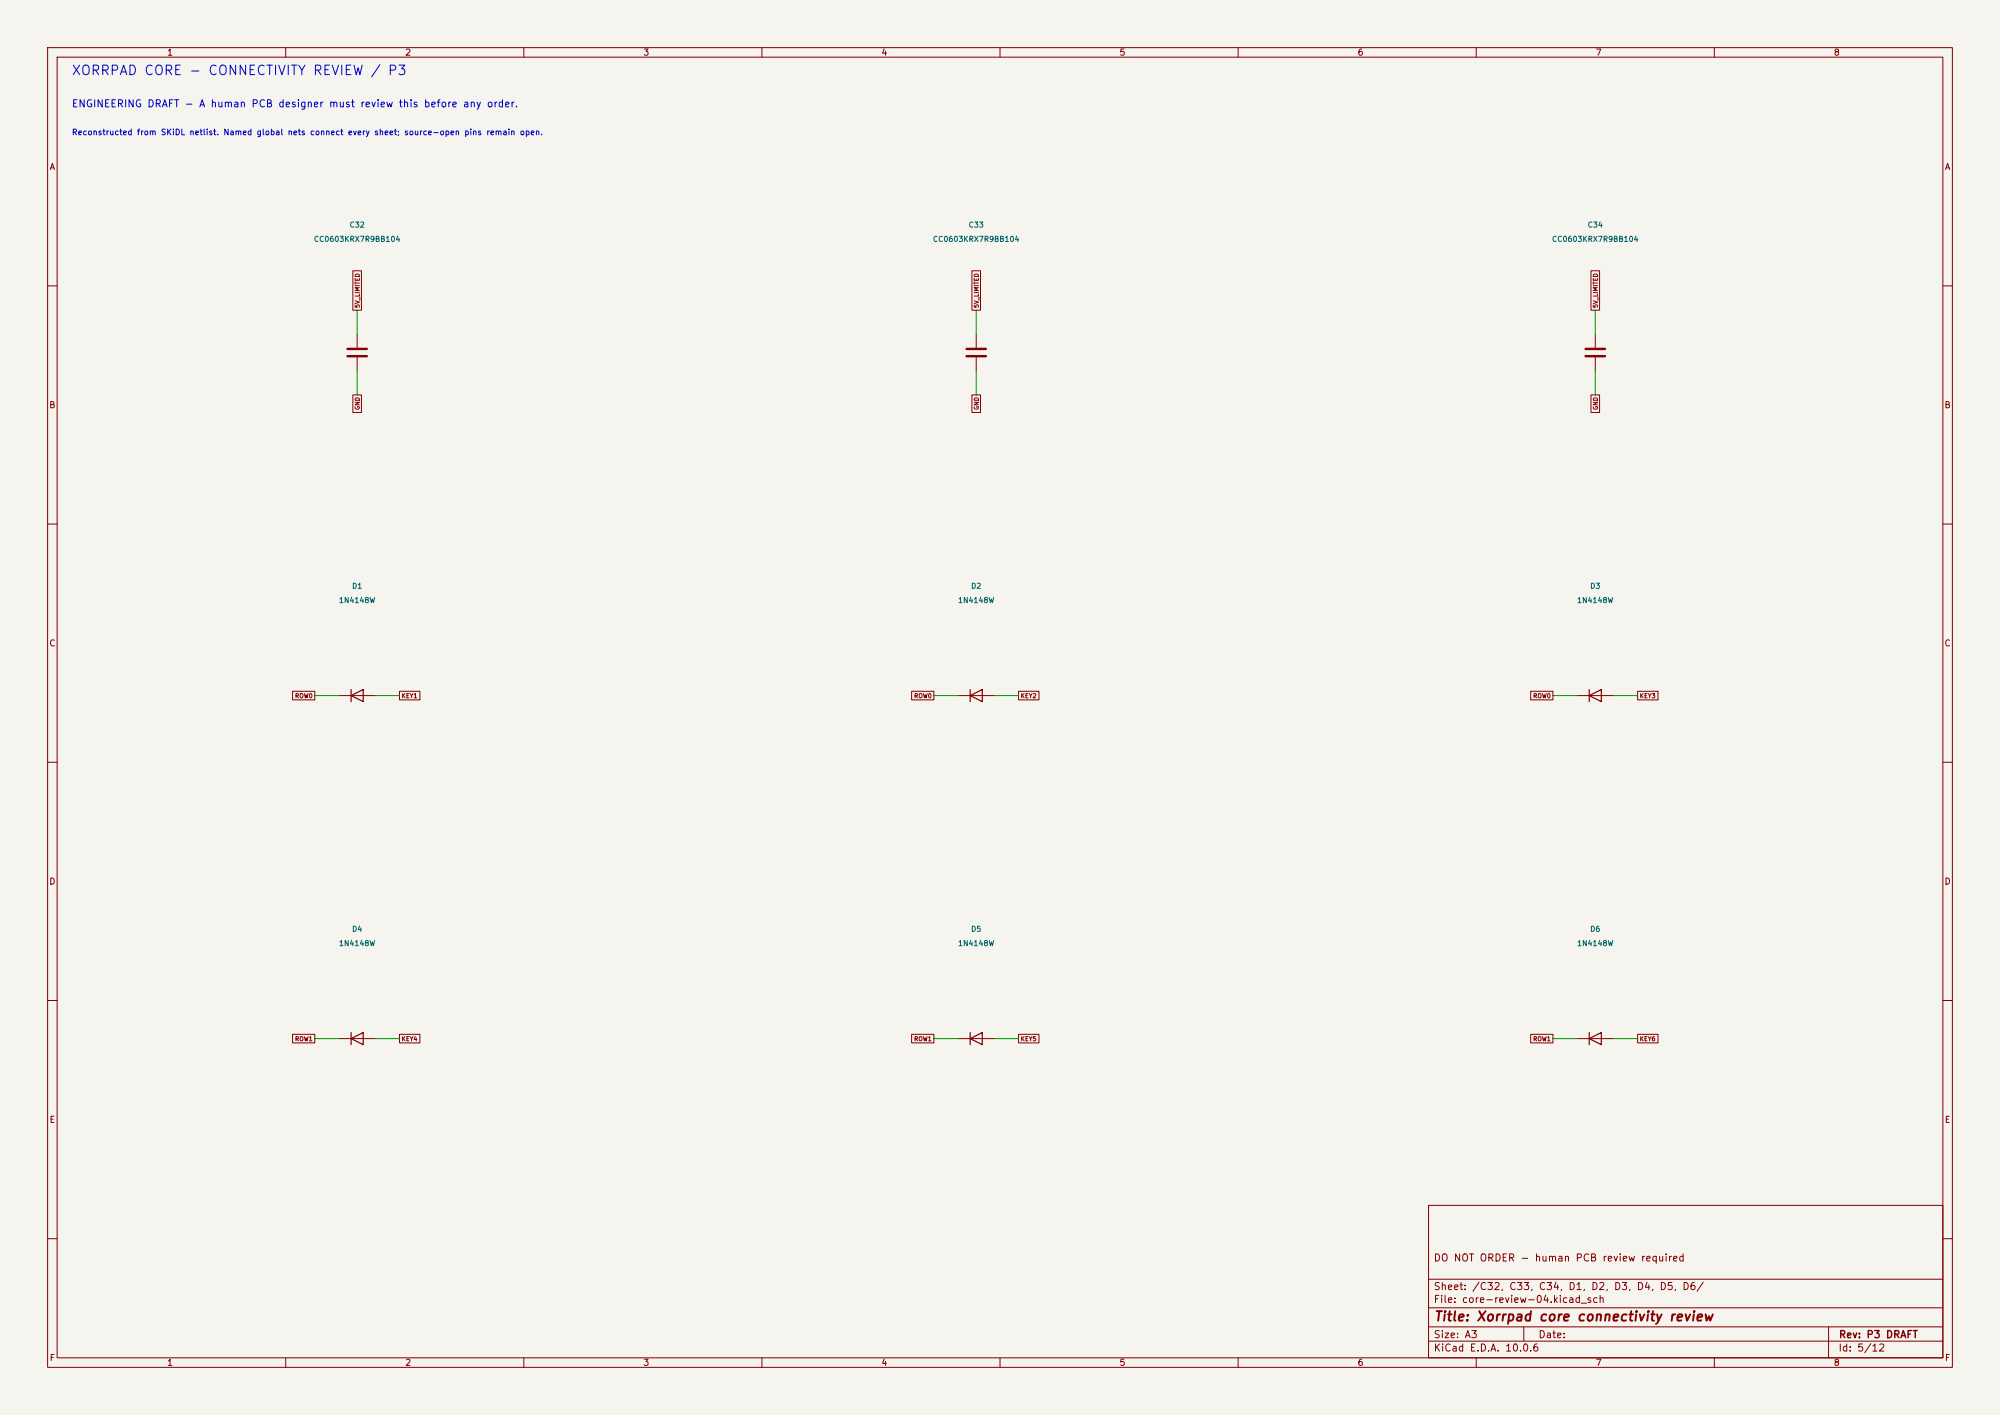
[picture p78: page 5]

ROW1 GND Reconstructed from SKiDL netlist. Named global nets connect every sheet; source-open pins remain open. XORRPAD CORE - CONNECTIVITY REVIEW / P3

ENGINEERING DRAFT - A human PCB designer must review this before any order.

DO NOT ORDER - human PCB review required

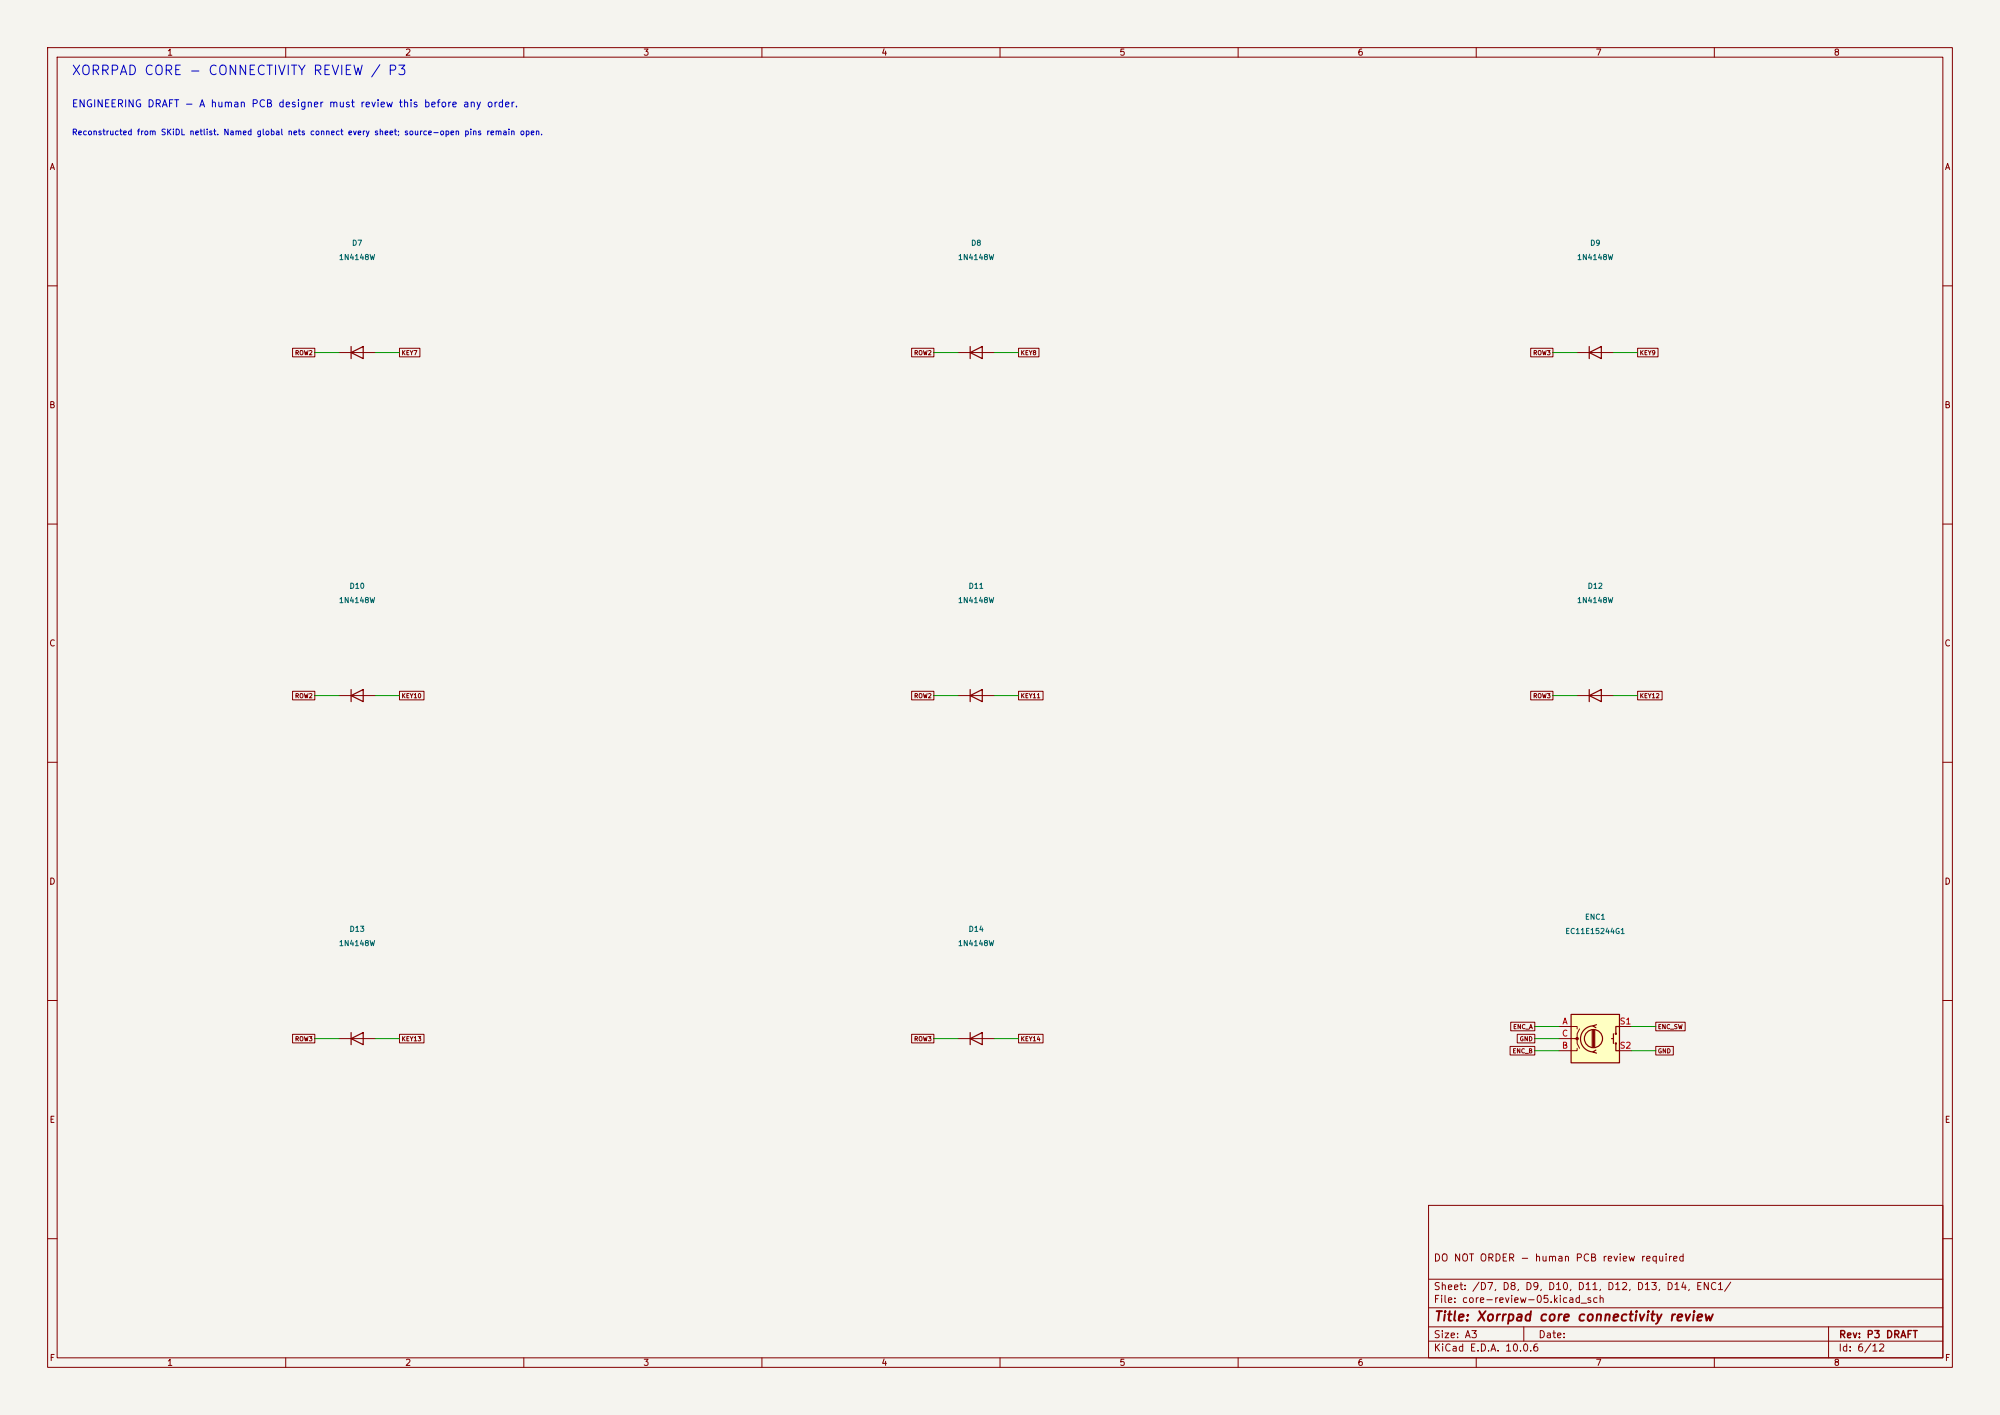
[picture p79: page 6]

XORRPAD CORE - CONNECTIVITY REVIEW / P3

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

DO NOT ORDER - human PCB review required

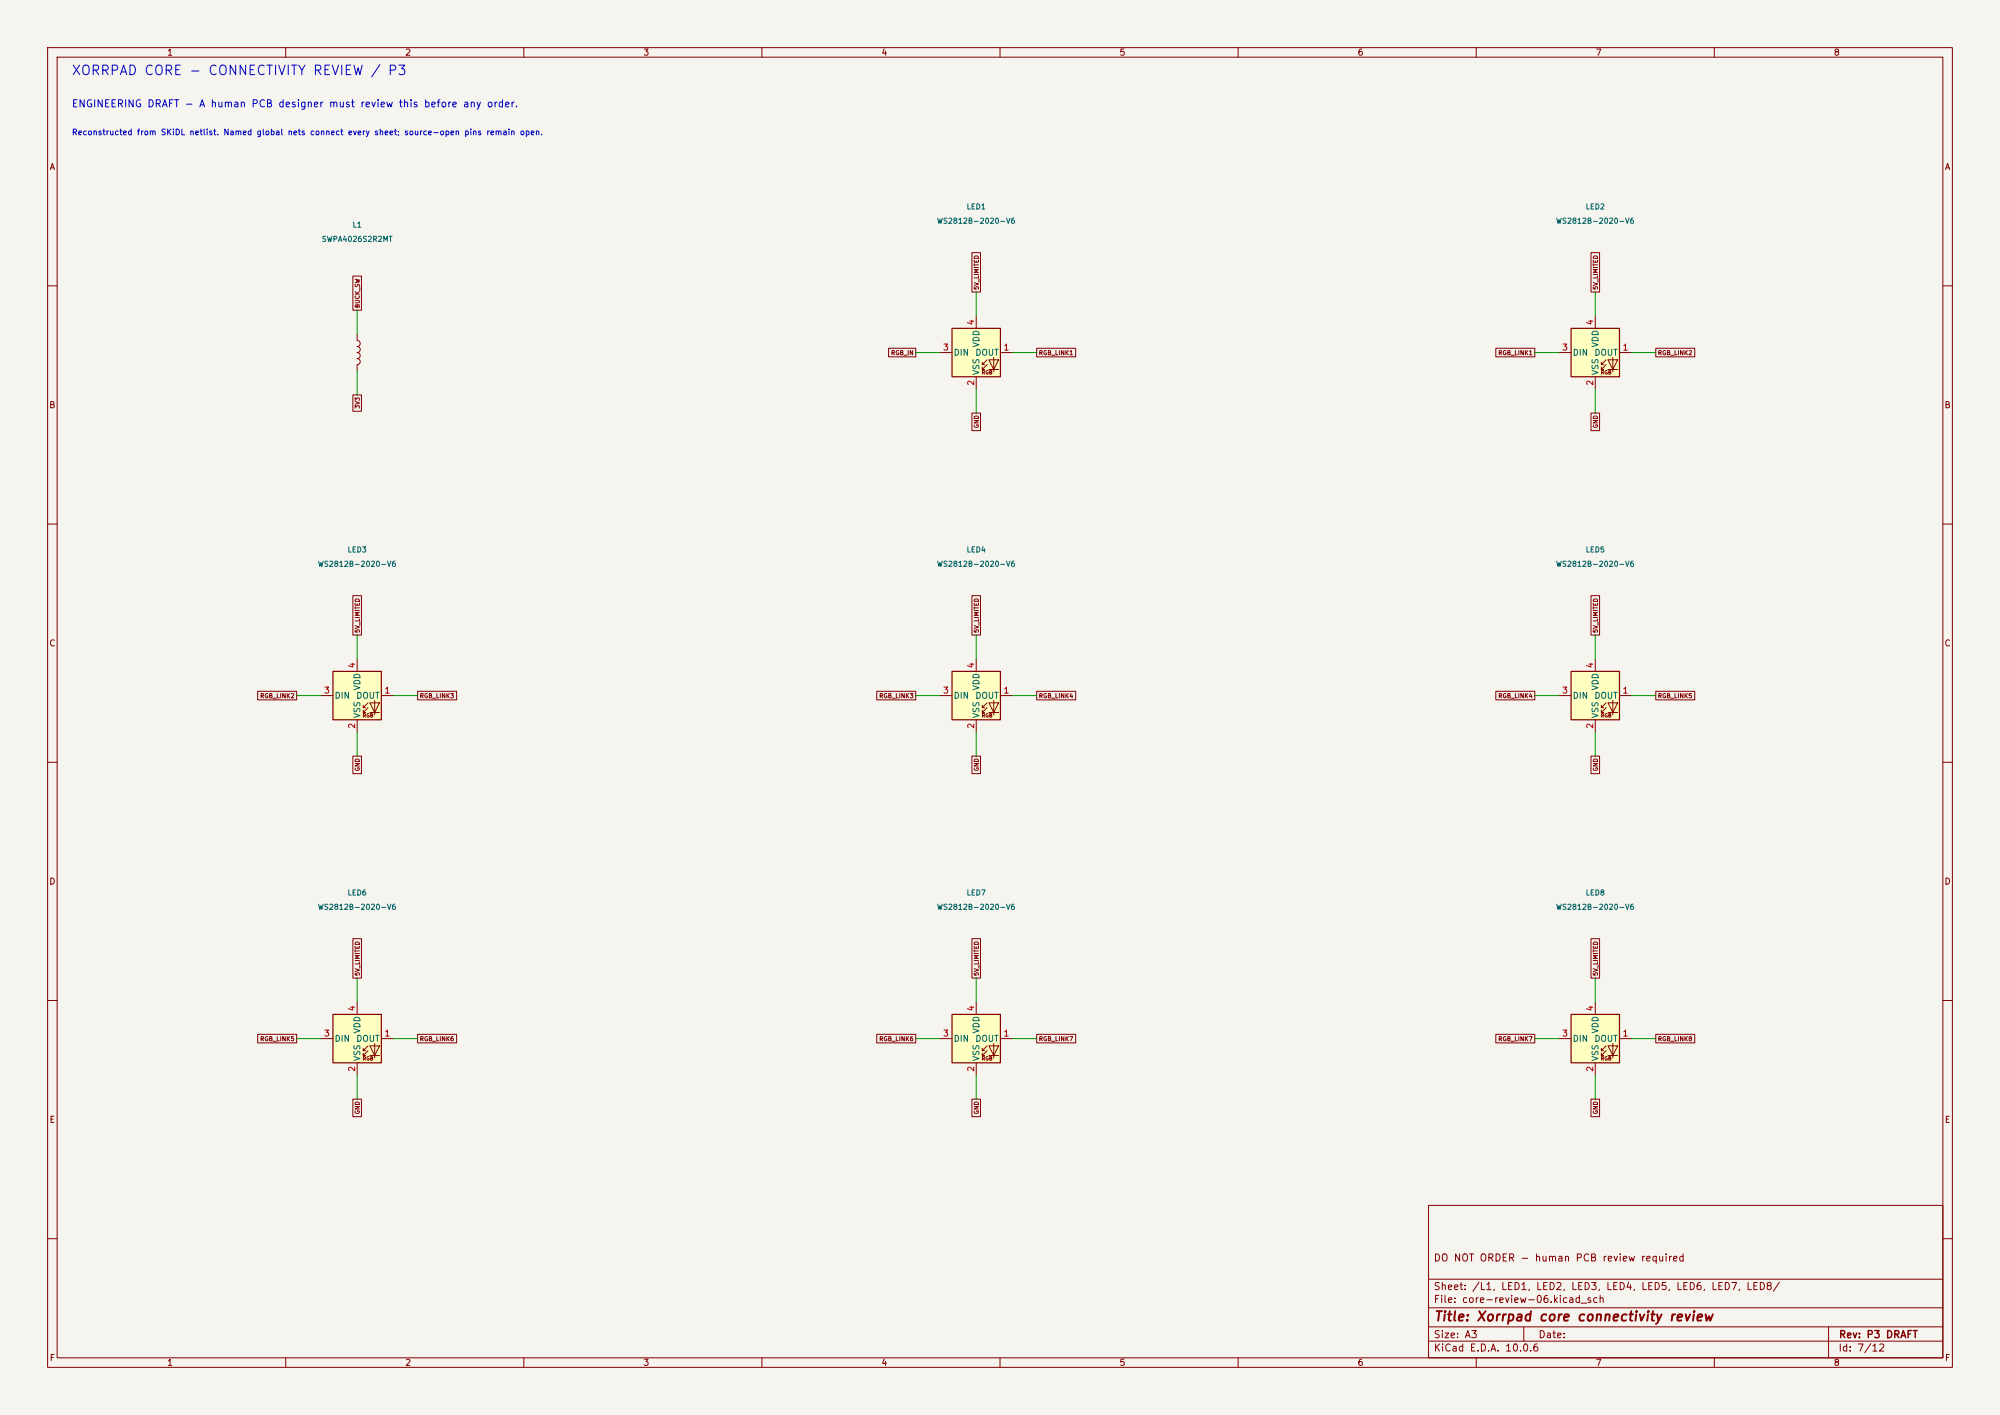
[picture p80: page 7]

DO NOT ORDER - human PCB review required

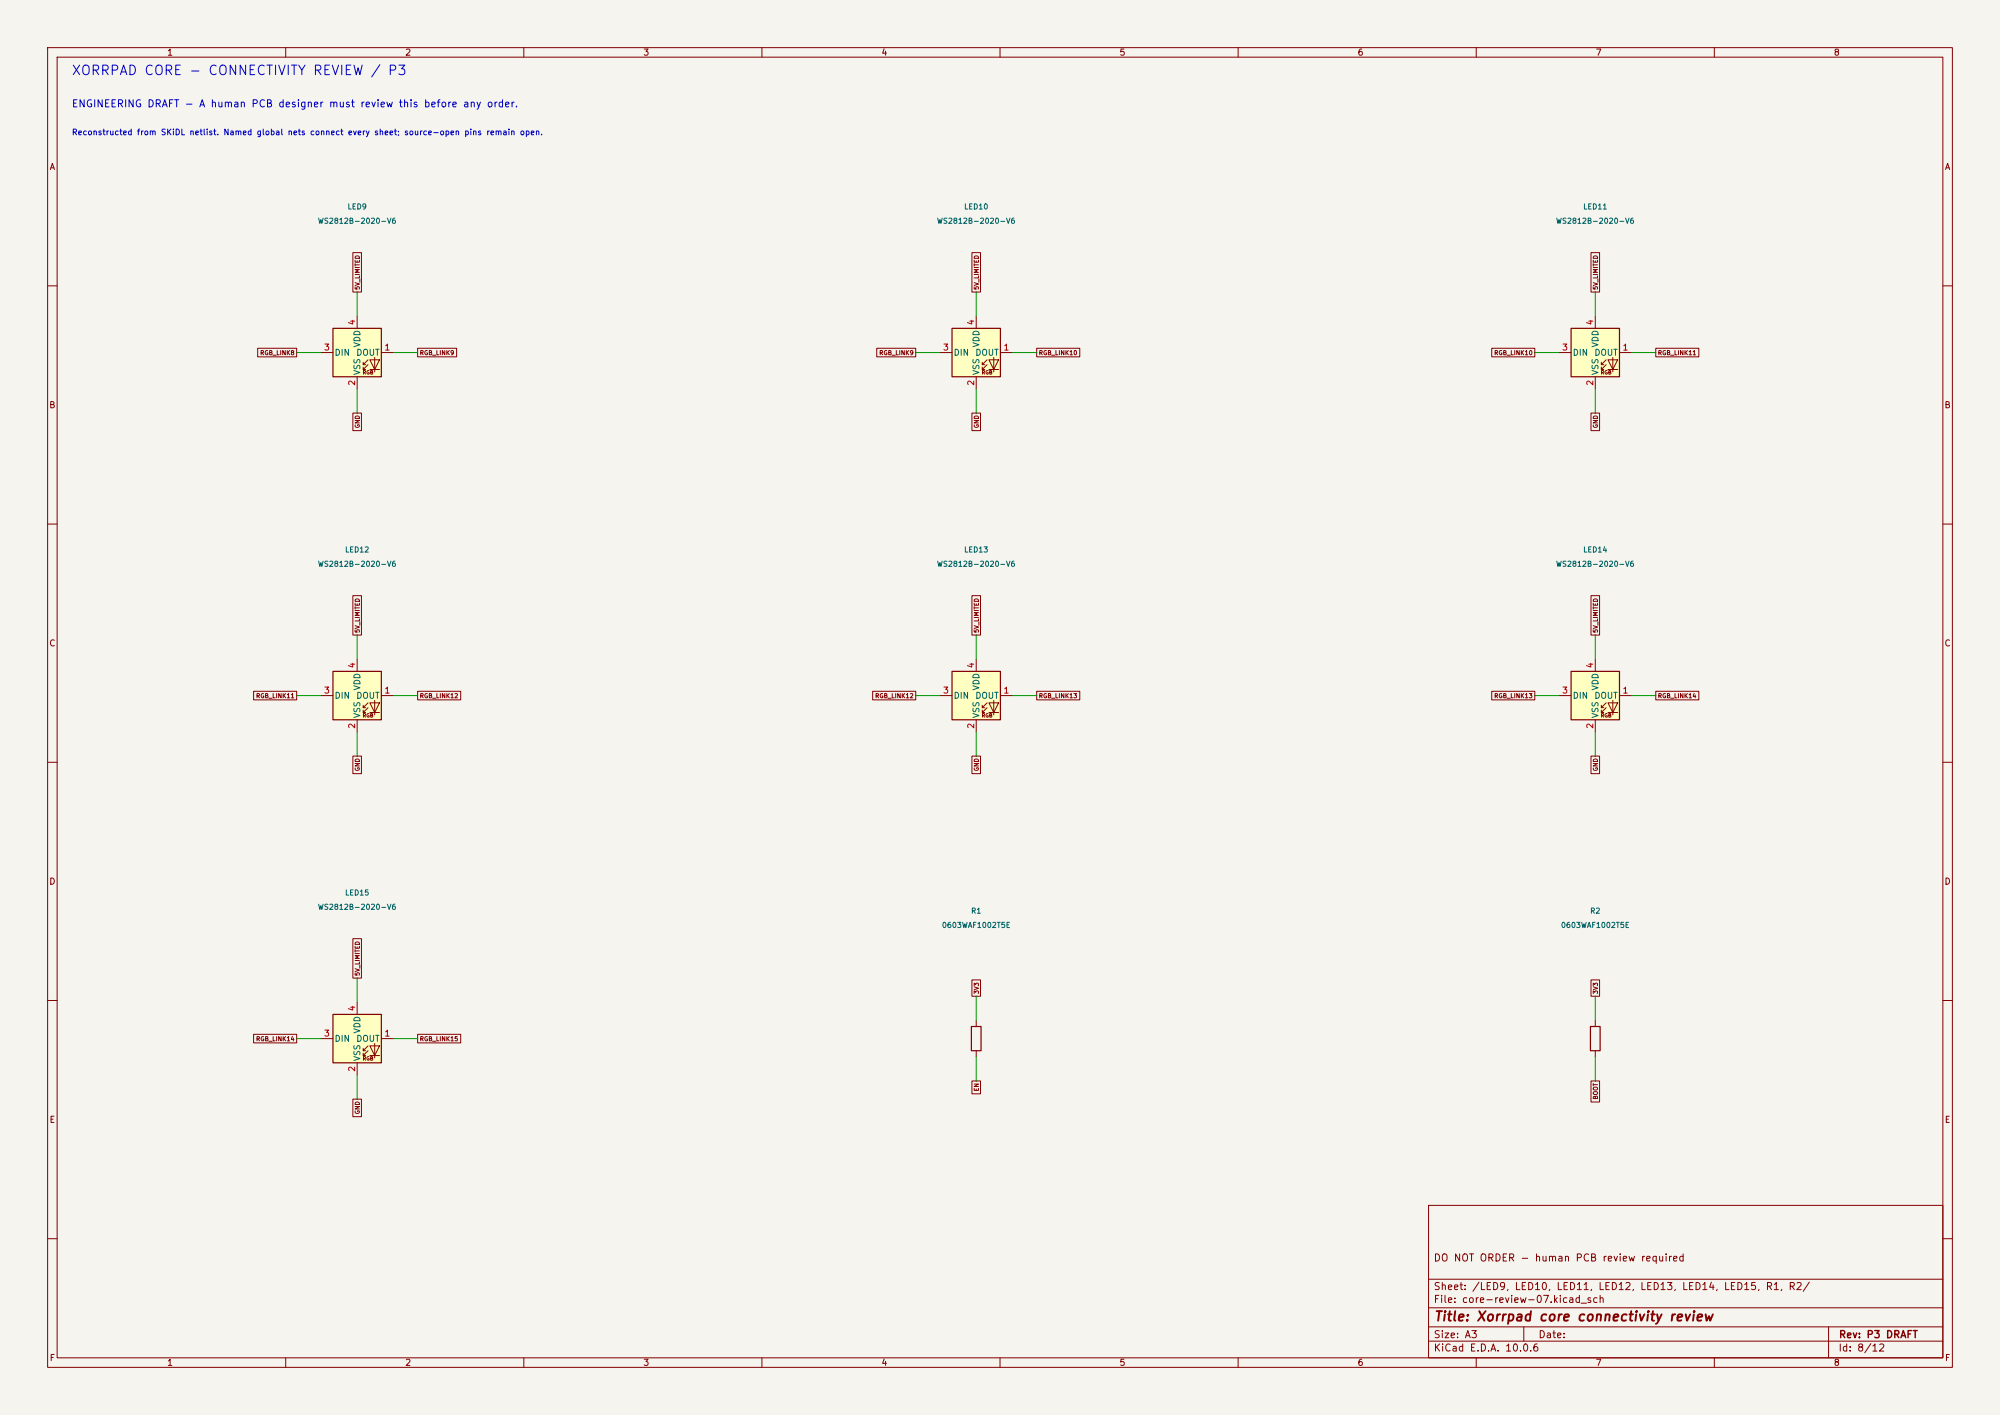
[picture p81: page 8]
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

DO NOT ORDER - human PCB review required

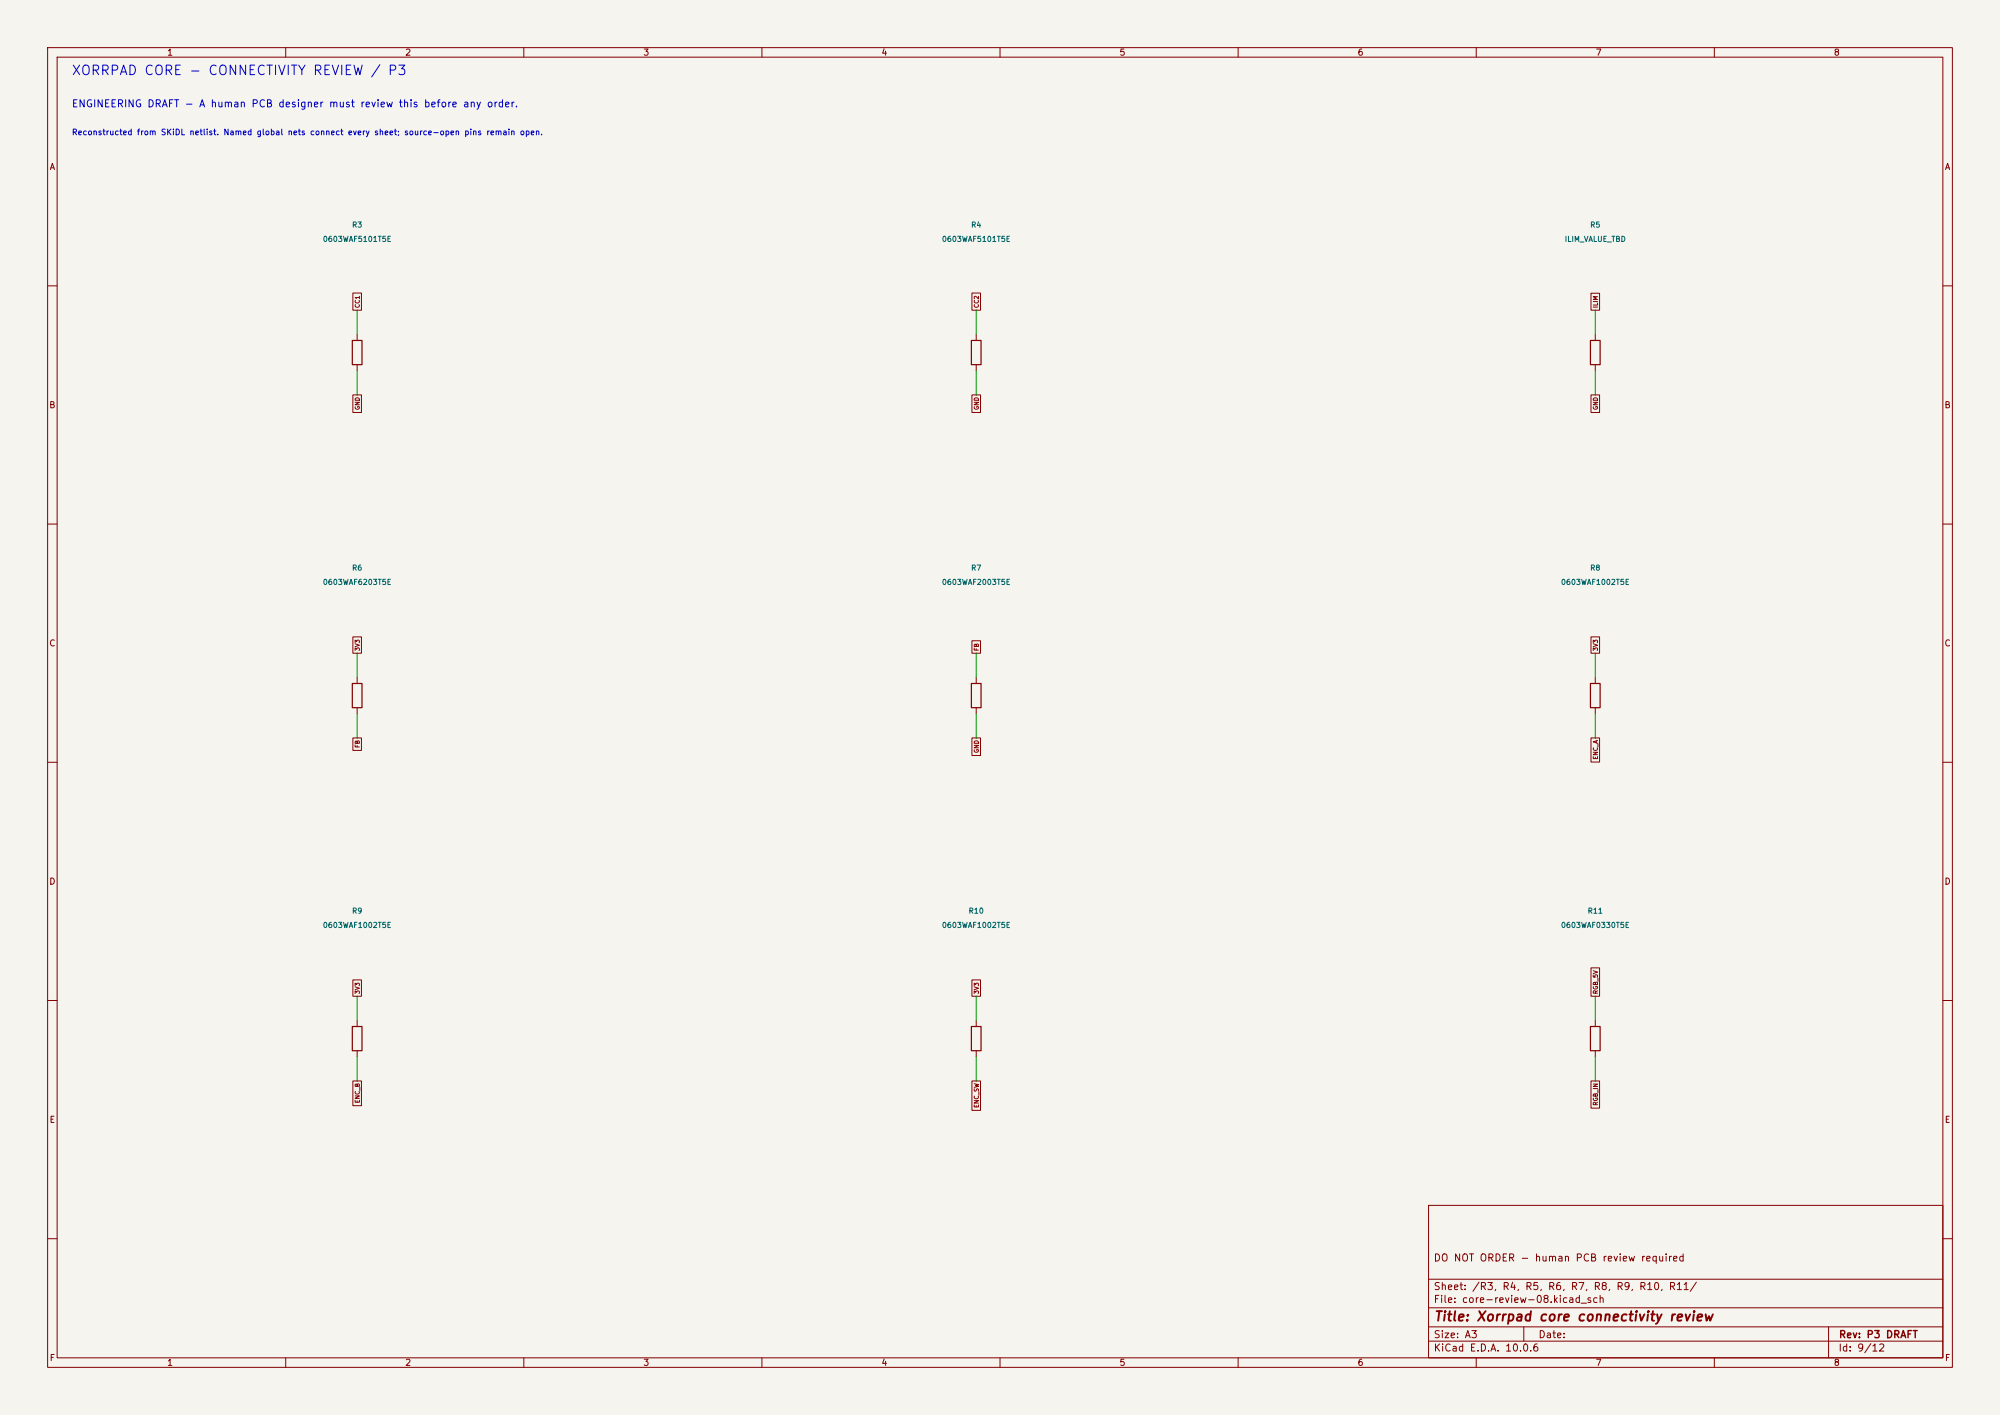
[picture p82: page 9]
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

DO NOT ORDER - human PCB review required

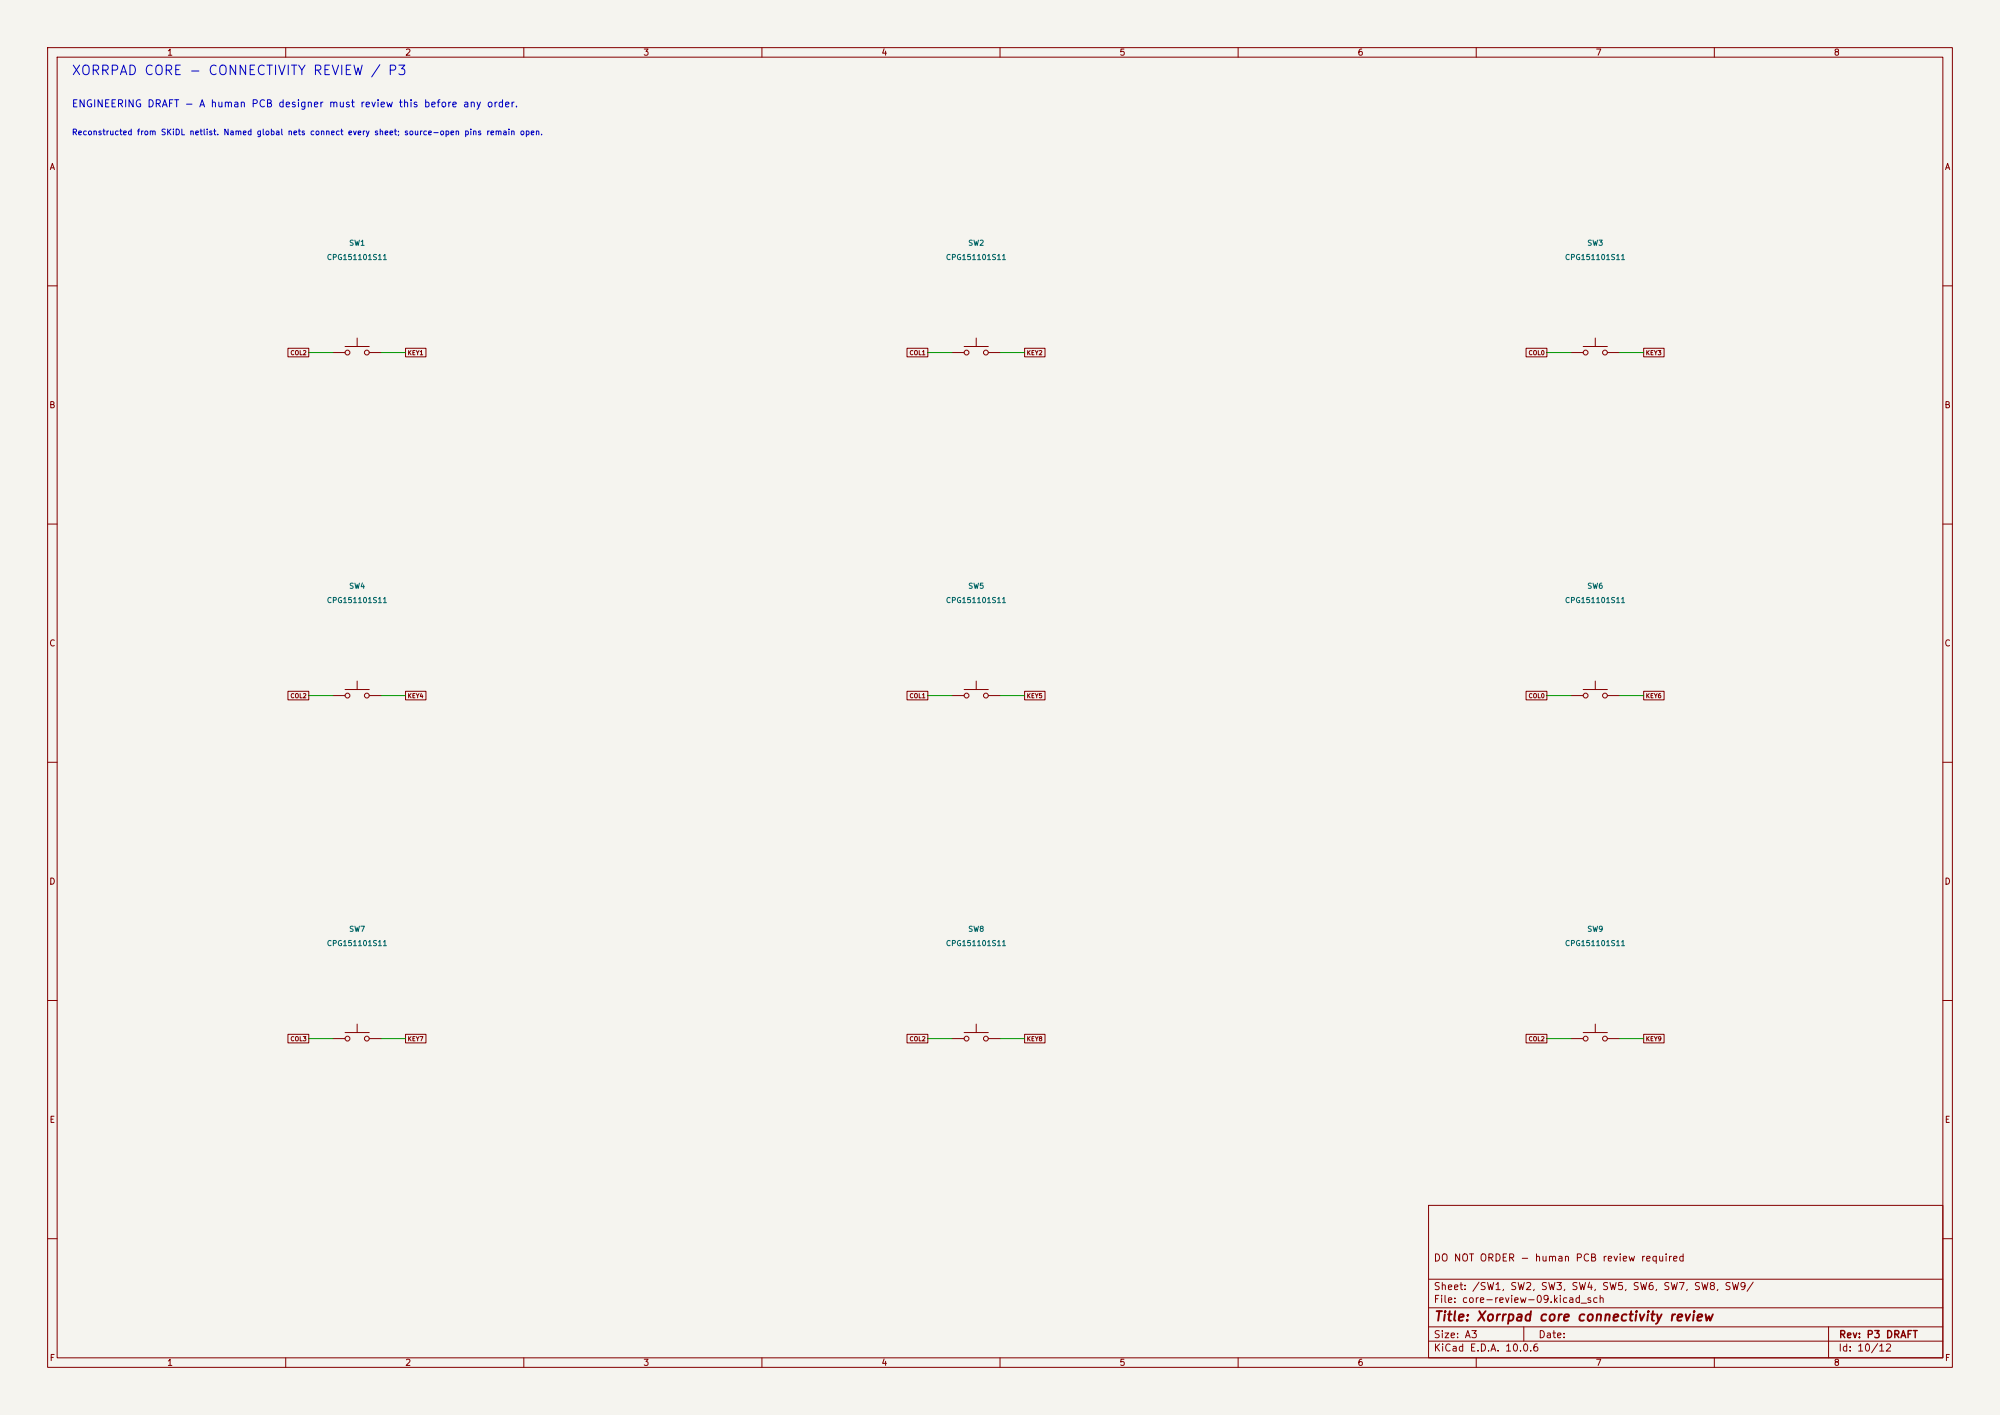
[picture p83: page 10]

KEY1 Reconstructed from SKiDL netlist. Named global nets connect every sheet; source-open pins remain open. XORRPAD CORE - CONNECTIVITY REVIEW / P3

DO NOT ORDER - human PCB review required

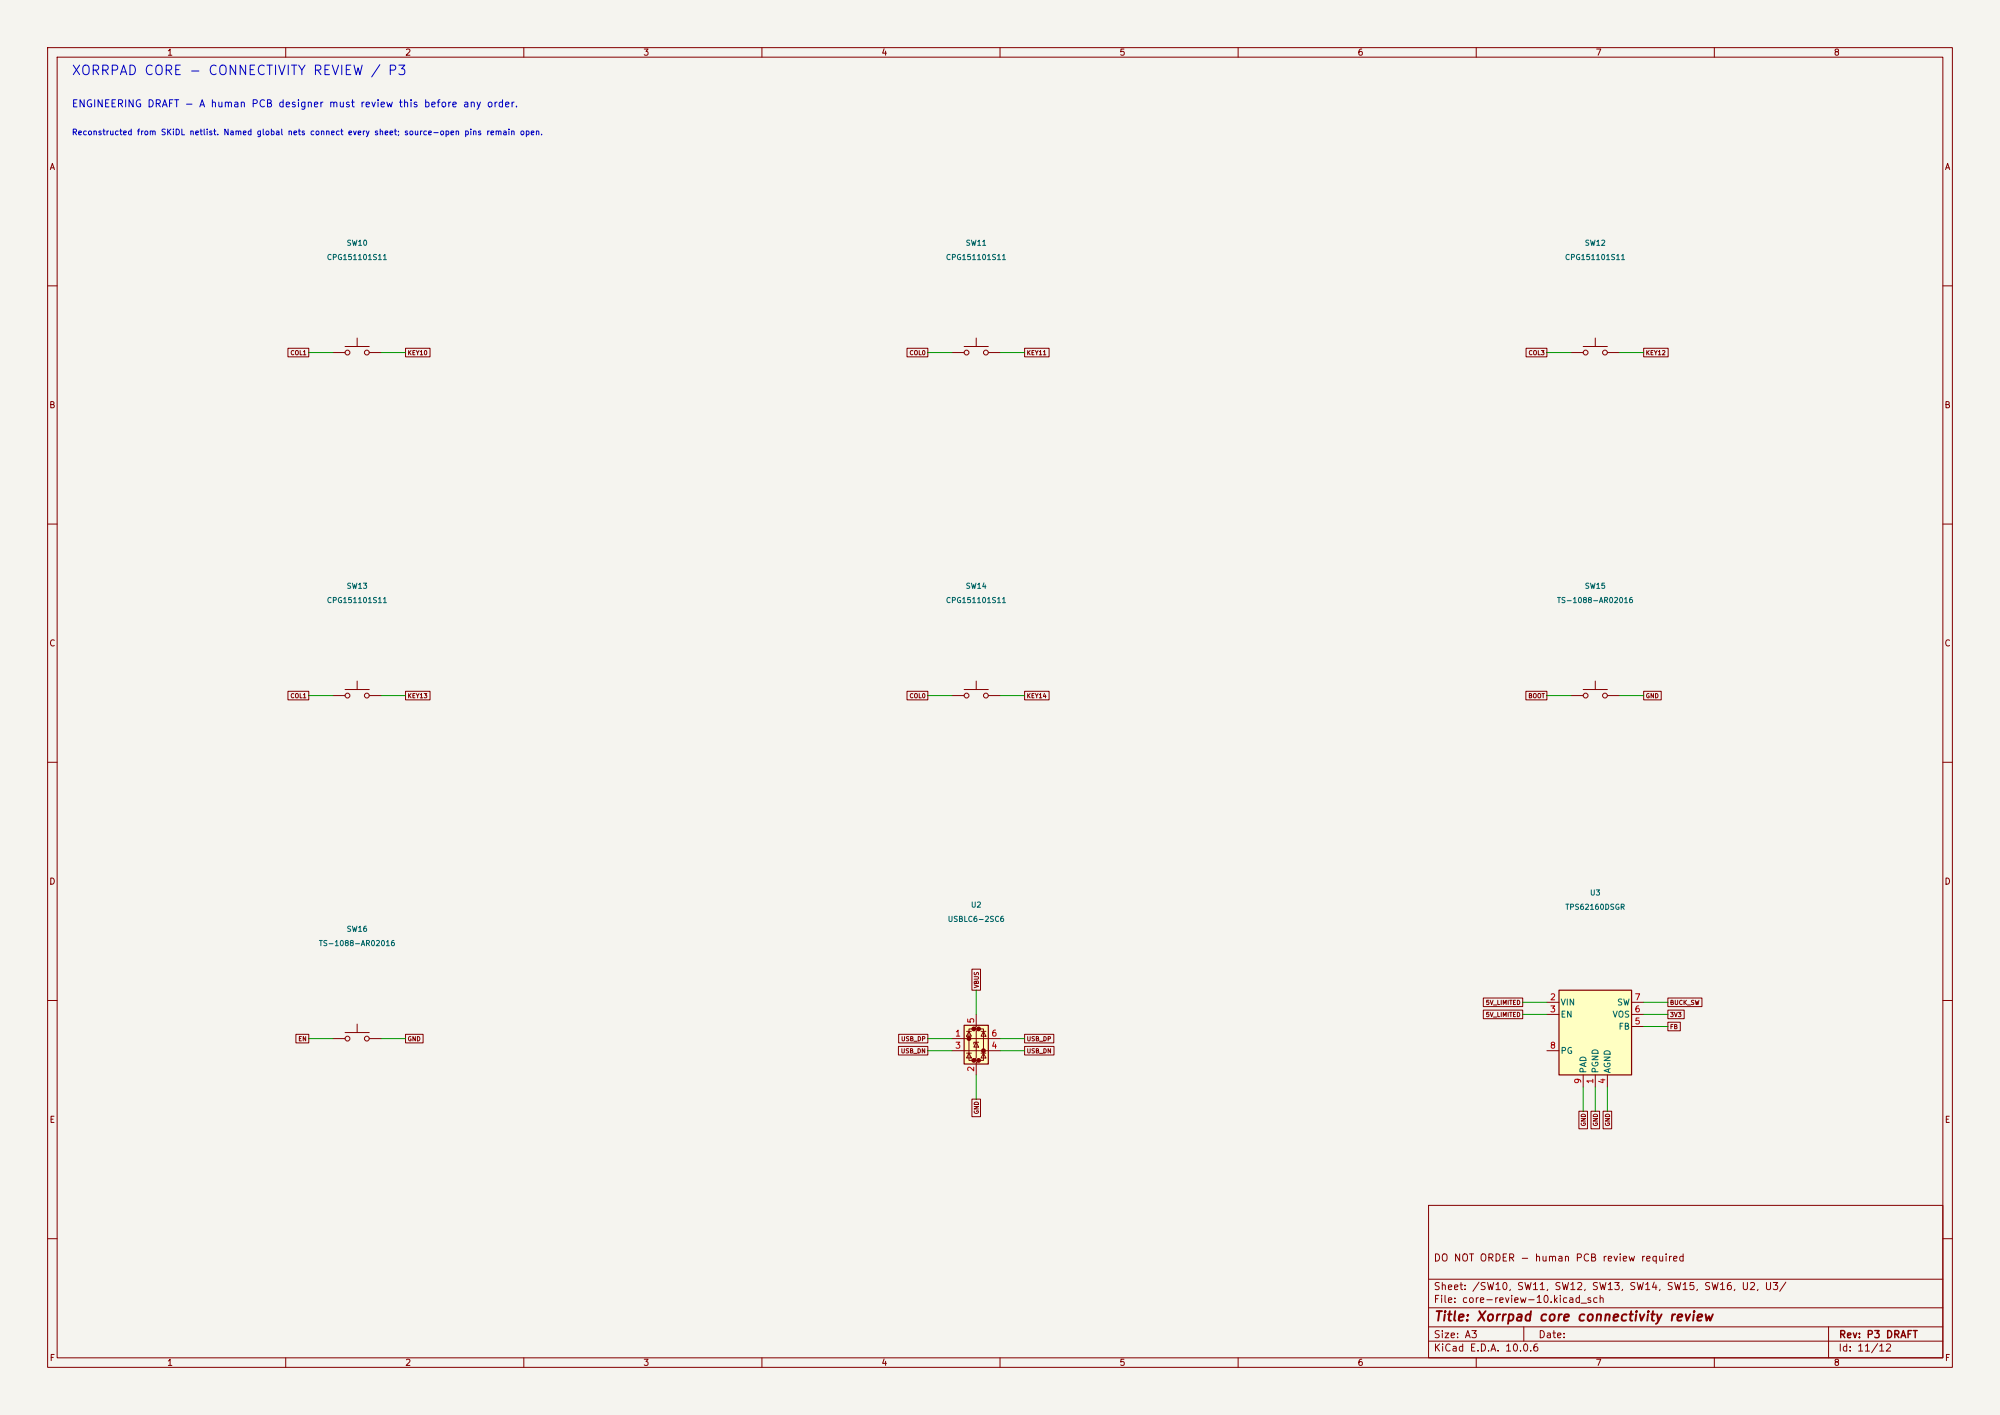
[picture p84: page 11]

XORRPAD CORE - CONNECTIVITY REVIEW / P3

Reconstructed from SKiDL netlist. Named global nets connect every sheet; source-open pins remain open.

DO NOT ORDER - human PCB review required

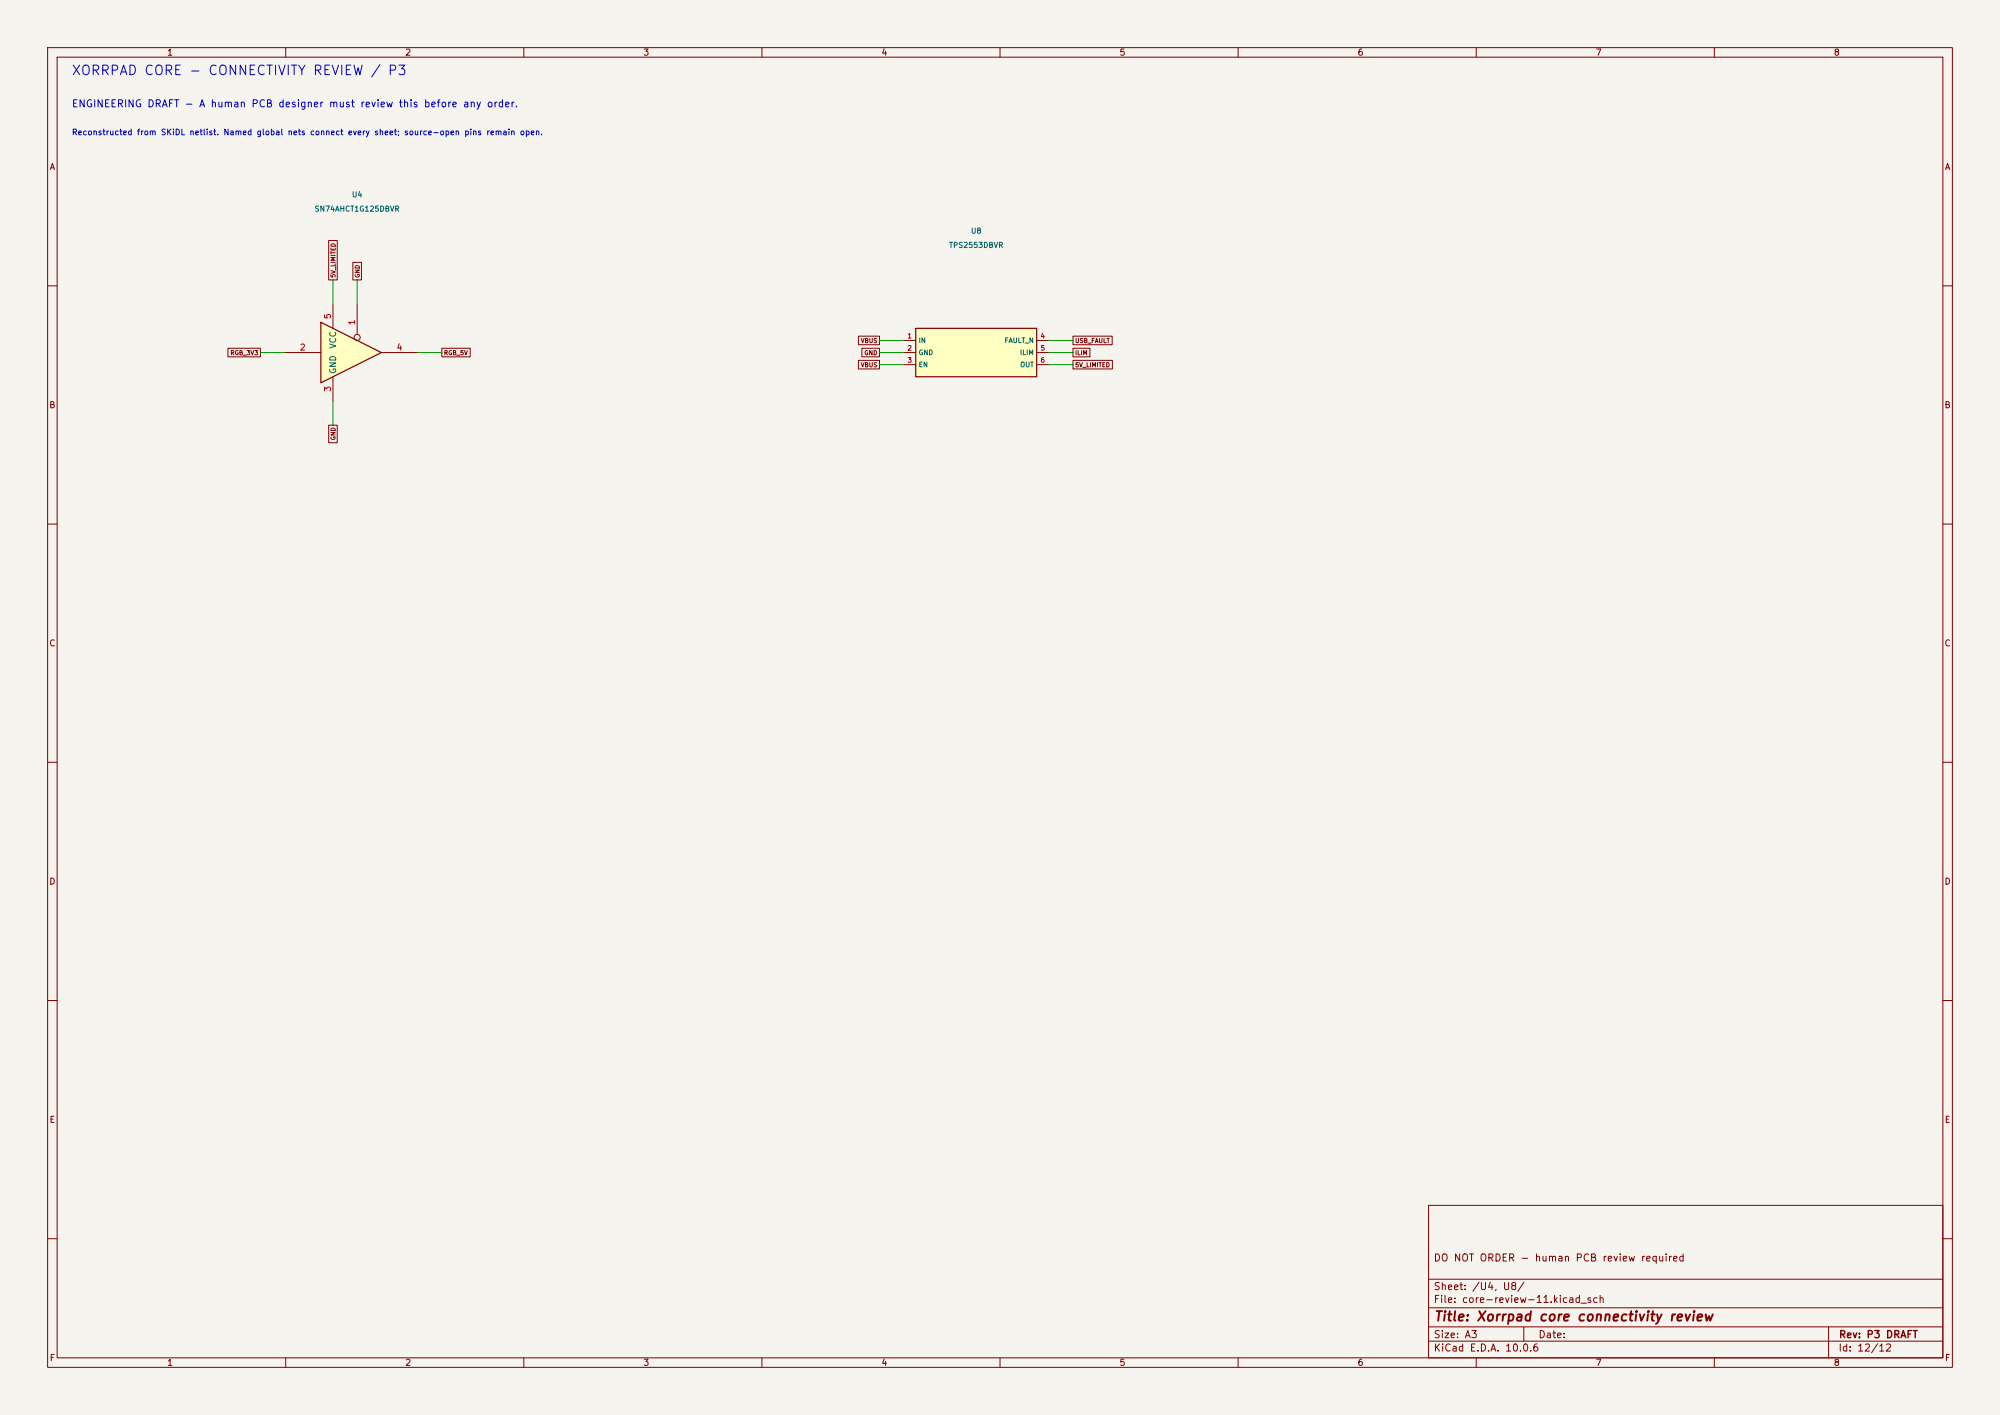
[picture p85: page 12]

XORRPAD CORE - CONNECTIVITY REVIEW / P3

Reconstructed from SKiDL netlist. Named global nets connect every sheet; source-open pins remain open.

DO NOT ORDER - human PCB review required
