nickthelegend/xorrpad/hardware/generated/pro/fab/pro-board.pdf

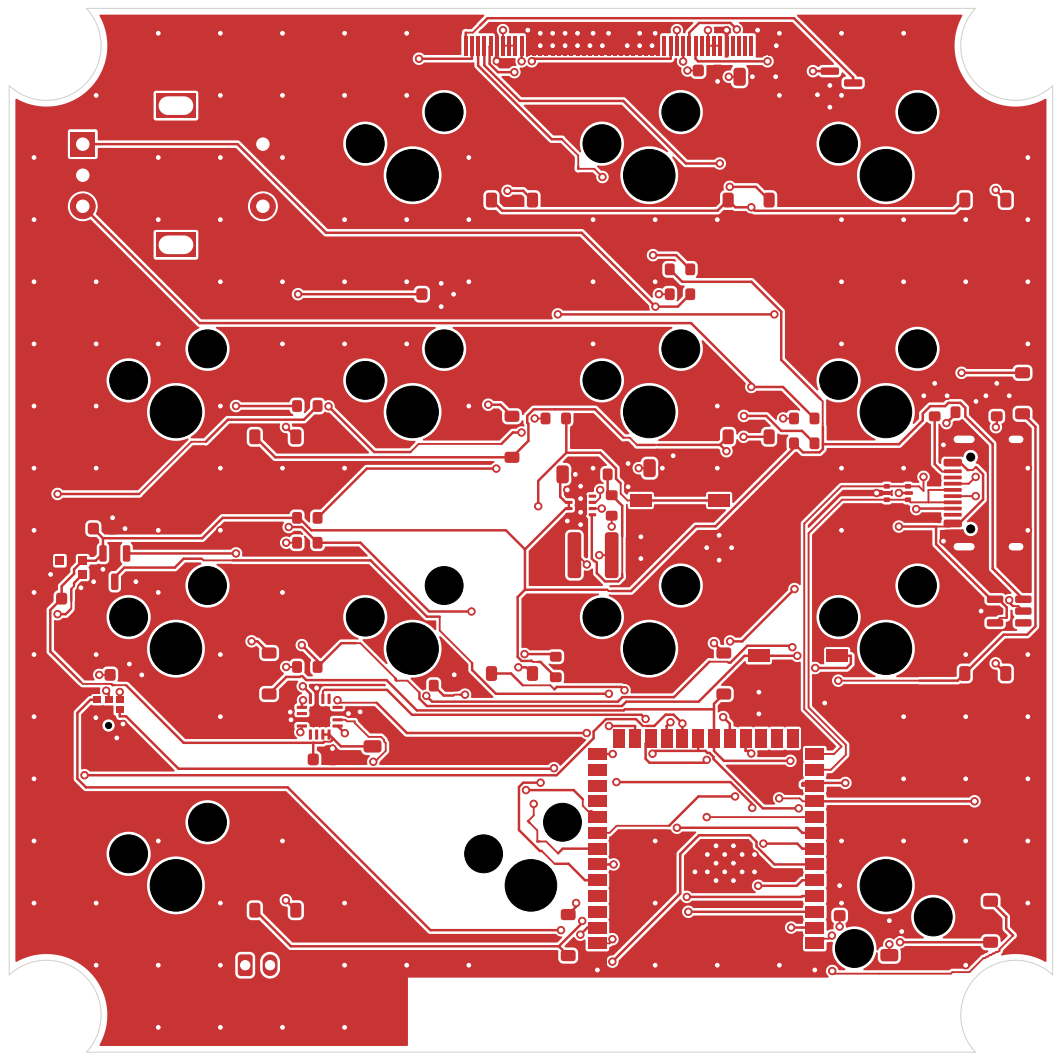
[picture p86: page 1]

Size: A4 | Rev:
KiCad E.D.A. 10.0.6 | Id: 1/8

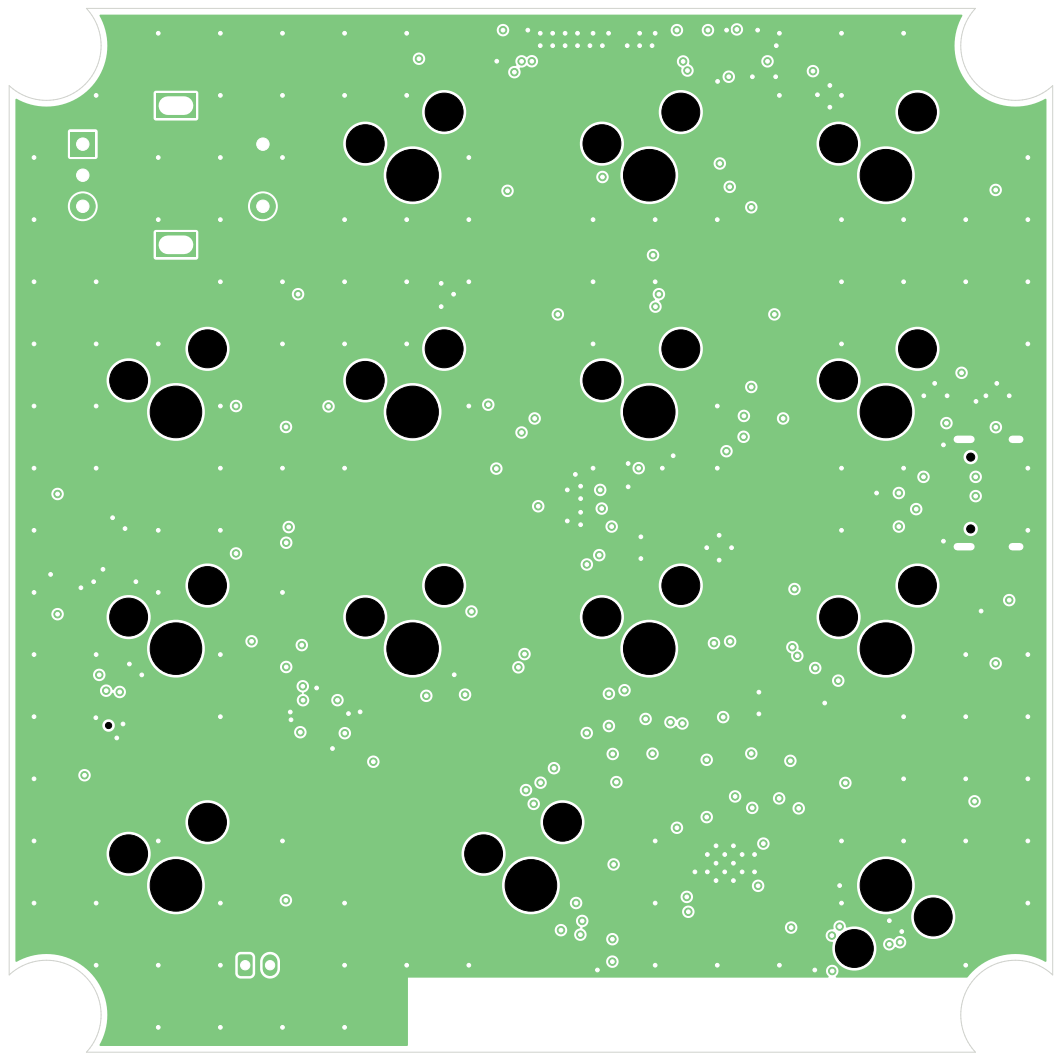
[picture p87: page 2]

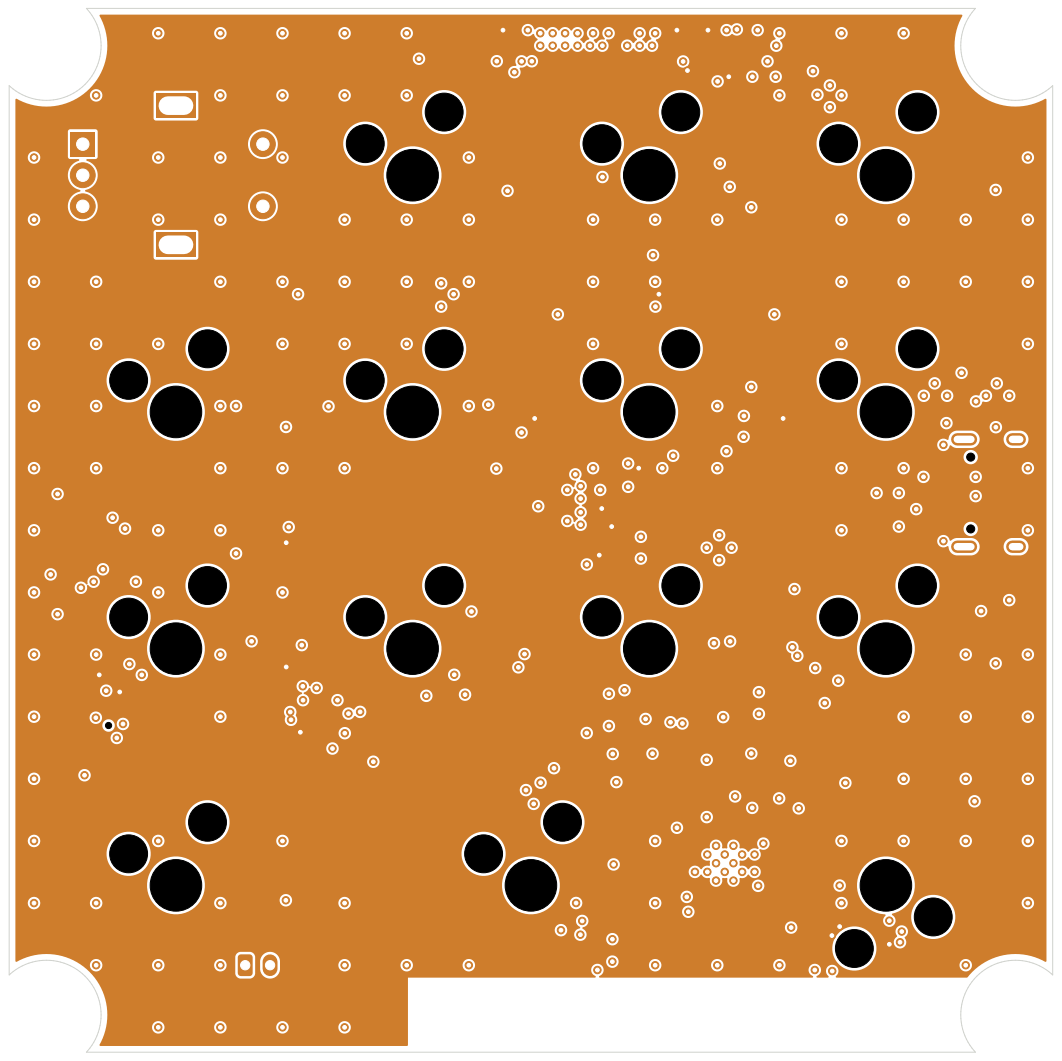
[picture p88: page 3]

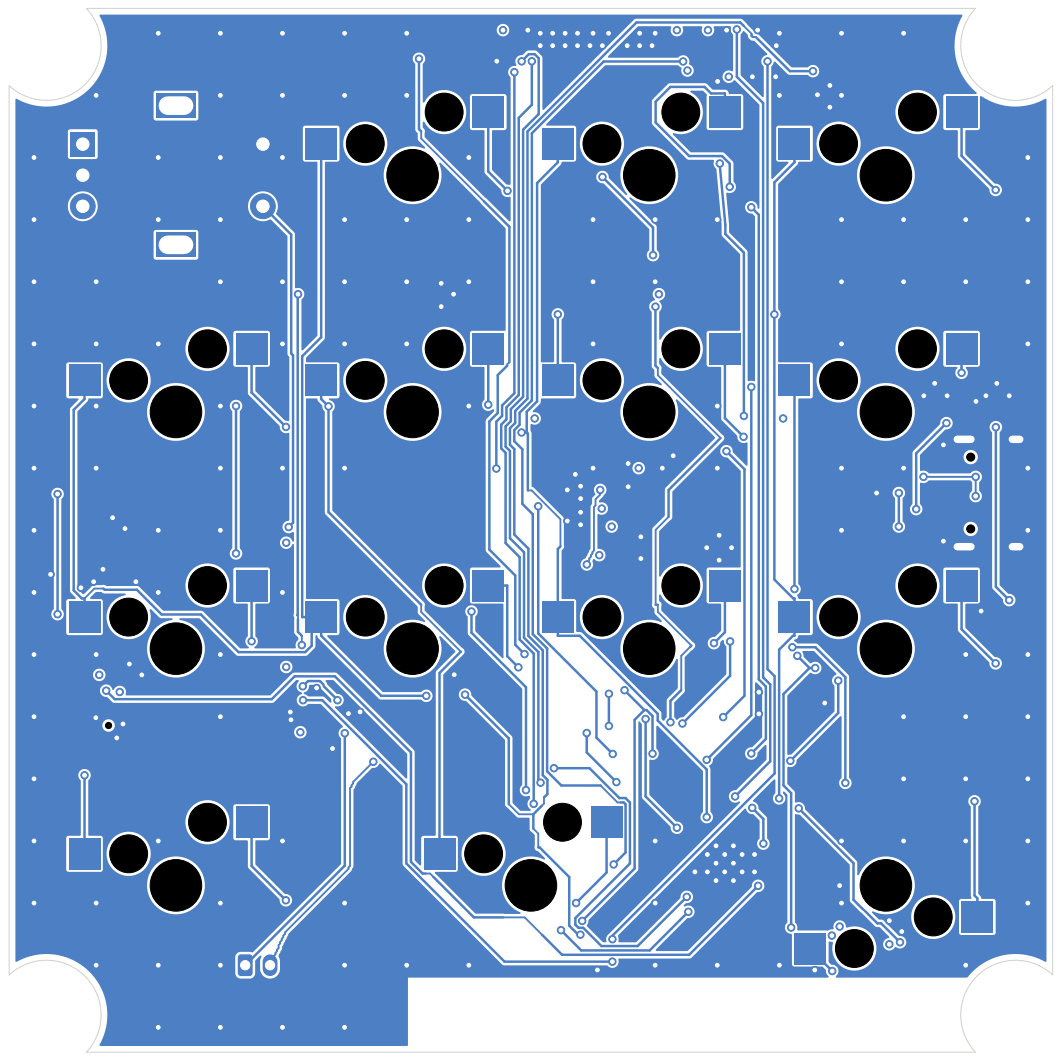
[picture p89: page 4]

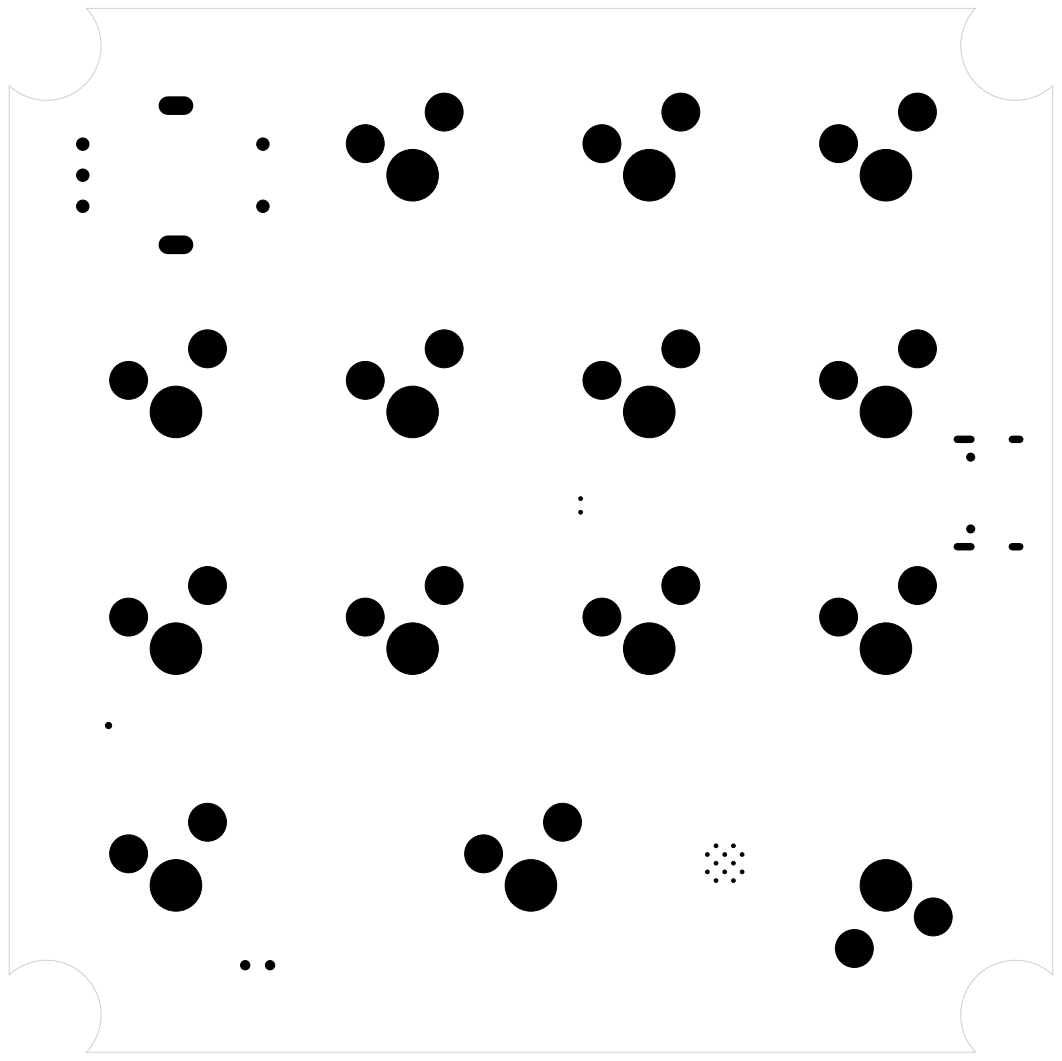
[picture p90: page 5]

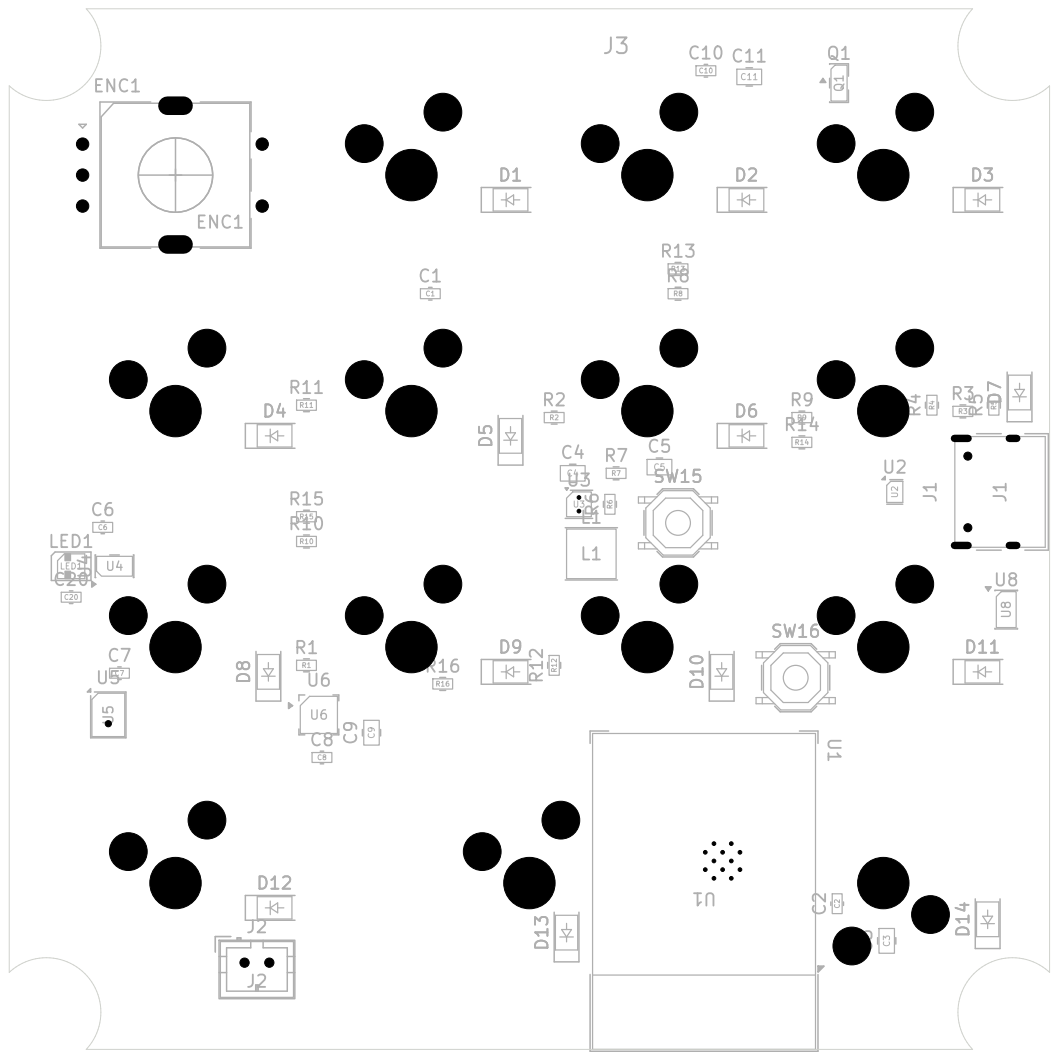
[picture p91: page 7]

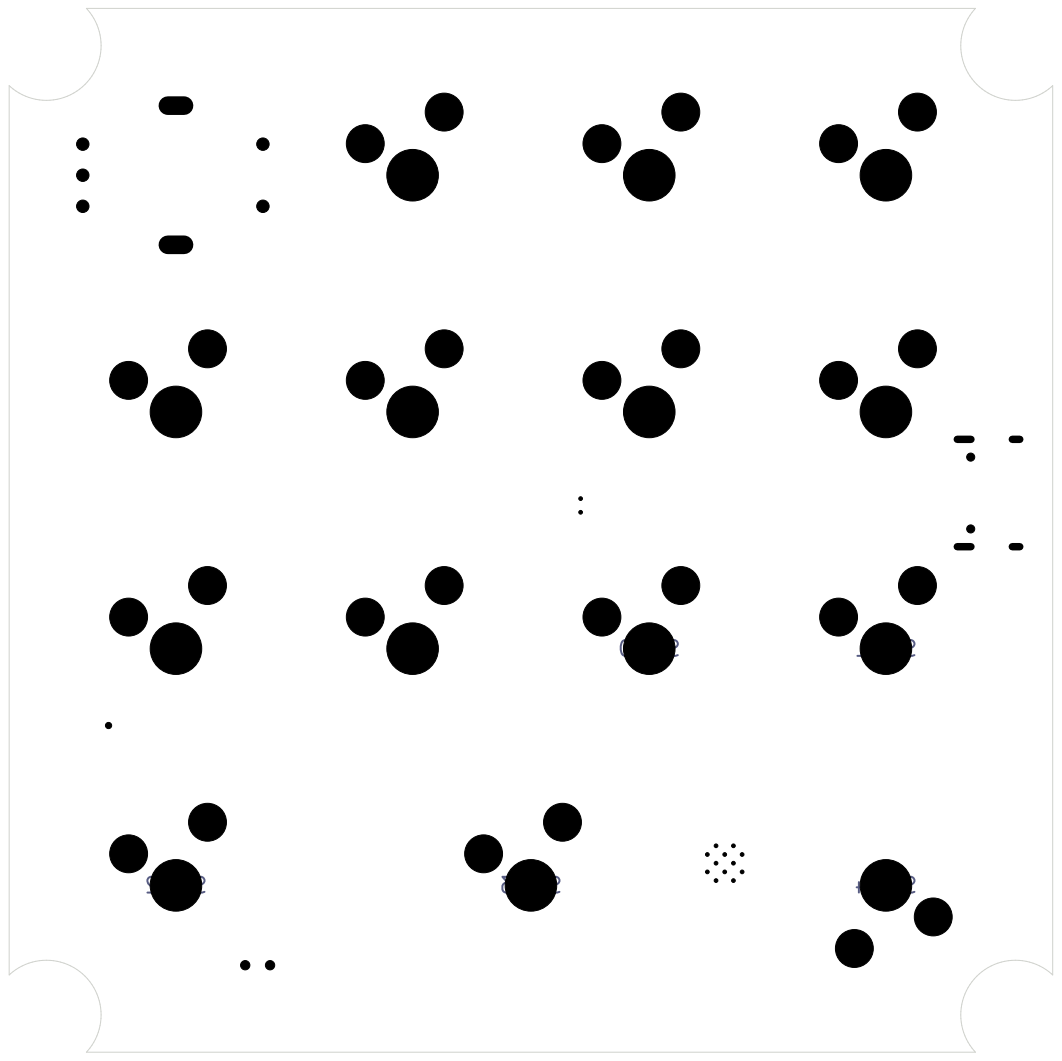
[picture p92: page 8]
