nickthelegend/xorrpad/hardware/generated/pro/fab/pro-schematic.pdf

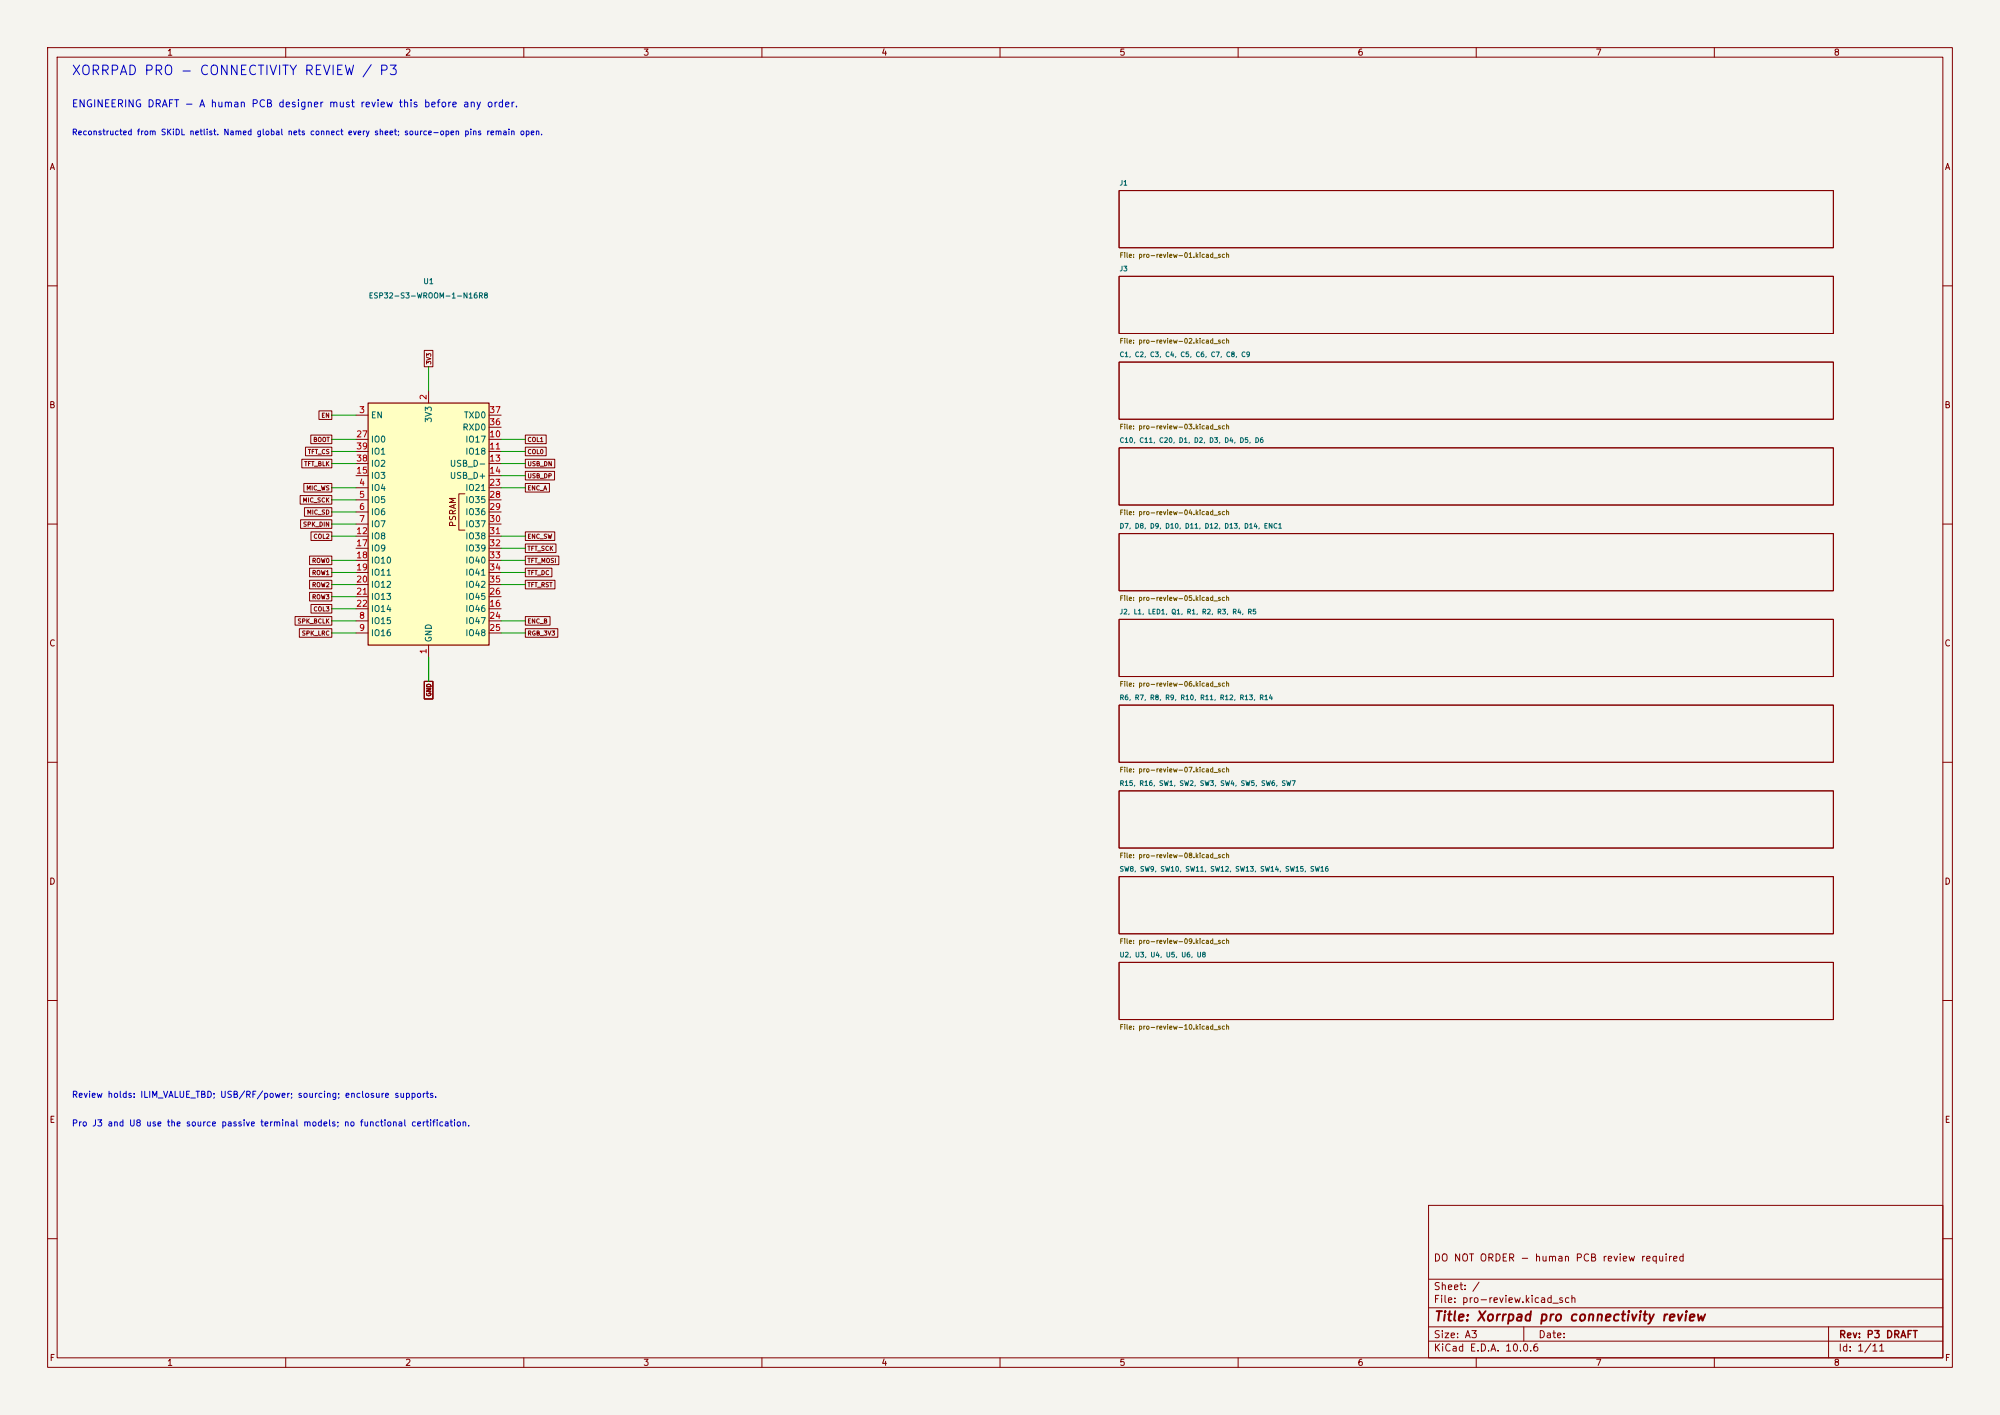
[picture p93: page 1]

TFT_MOSI SPK_DIN XORRPAD PRO - CONNECTIVITY REVIEW / P3

ENGINEERING DRAFT - A human PCB designer must review this before any order. Reconstructed from SKiDL netlist. Named global nets connect every sheet; source-open pins remain open.

File: pro-review-05.kicad_sch PSRAM GND

Pro J3 and U8 use the source passive terminal models; no functional certification. Review holds: ILIM_VALUE_TBD; USB/RF/power; sourcing; enclosure supports.

DO NOT ORDER - human PCB review required

Sheet: /
File: pro-review.kicad_sch
Title: Xorrpad pro connectivity review

Size: A3 | Rev: P3 DRAFT | F Date:
KiCad E.D.A. 10.0.6 | Id: 1/11

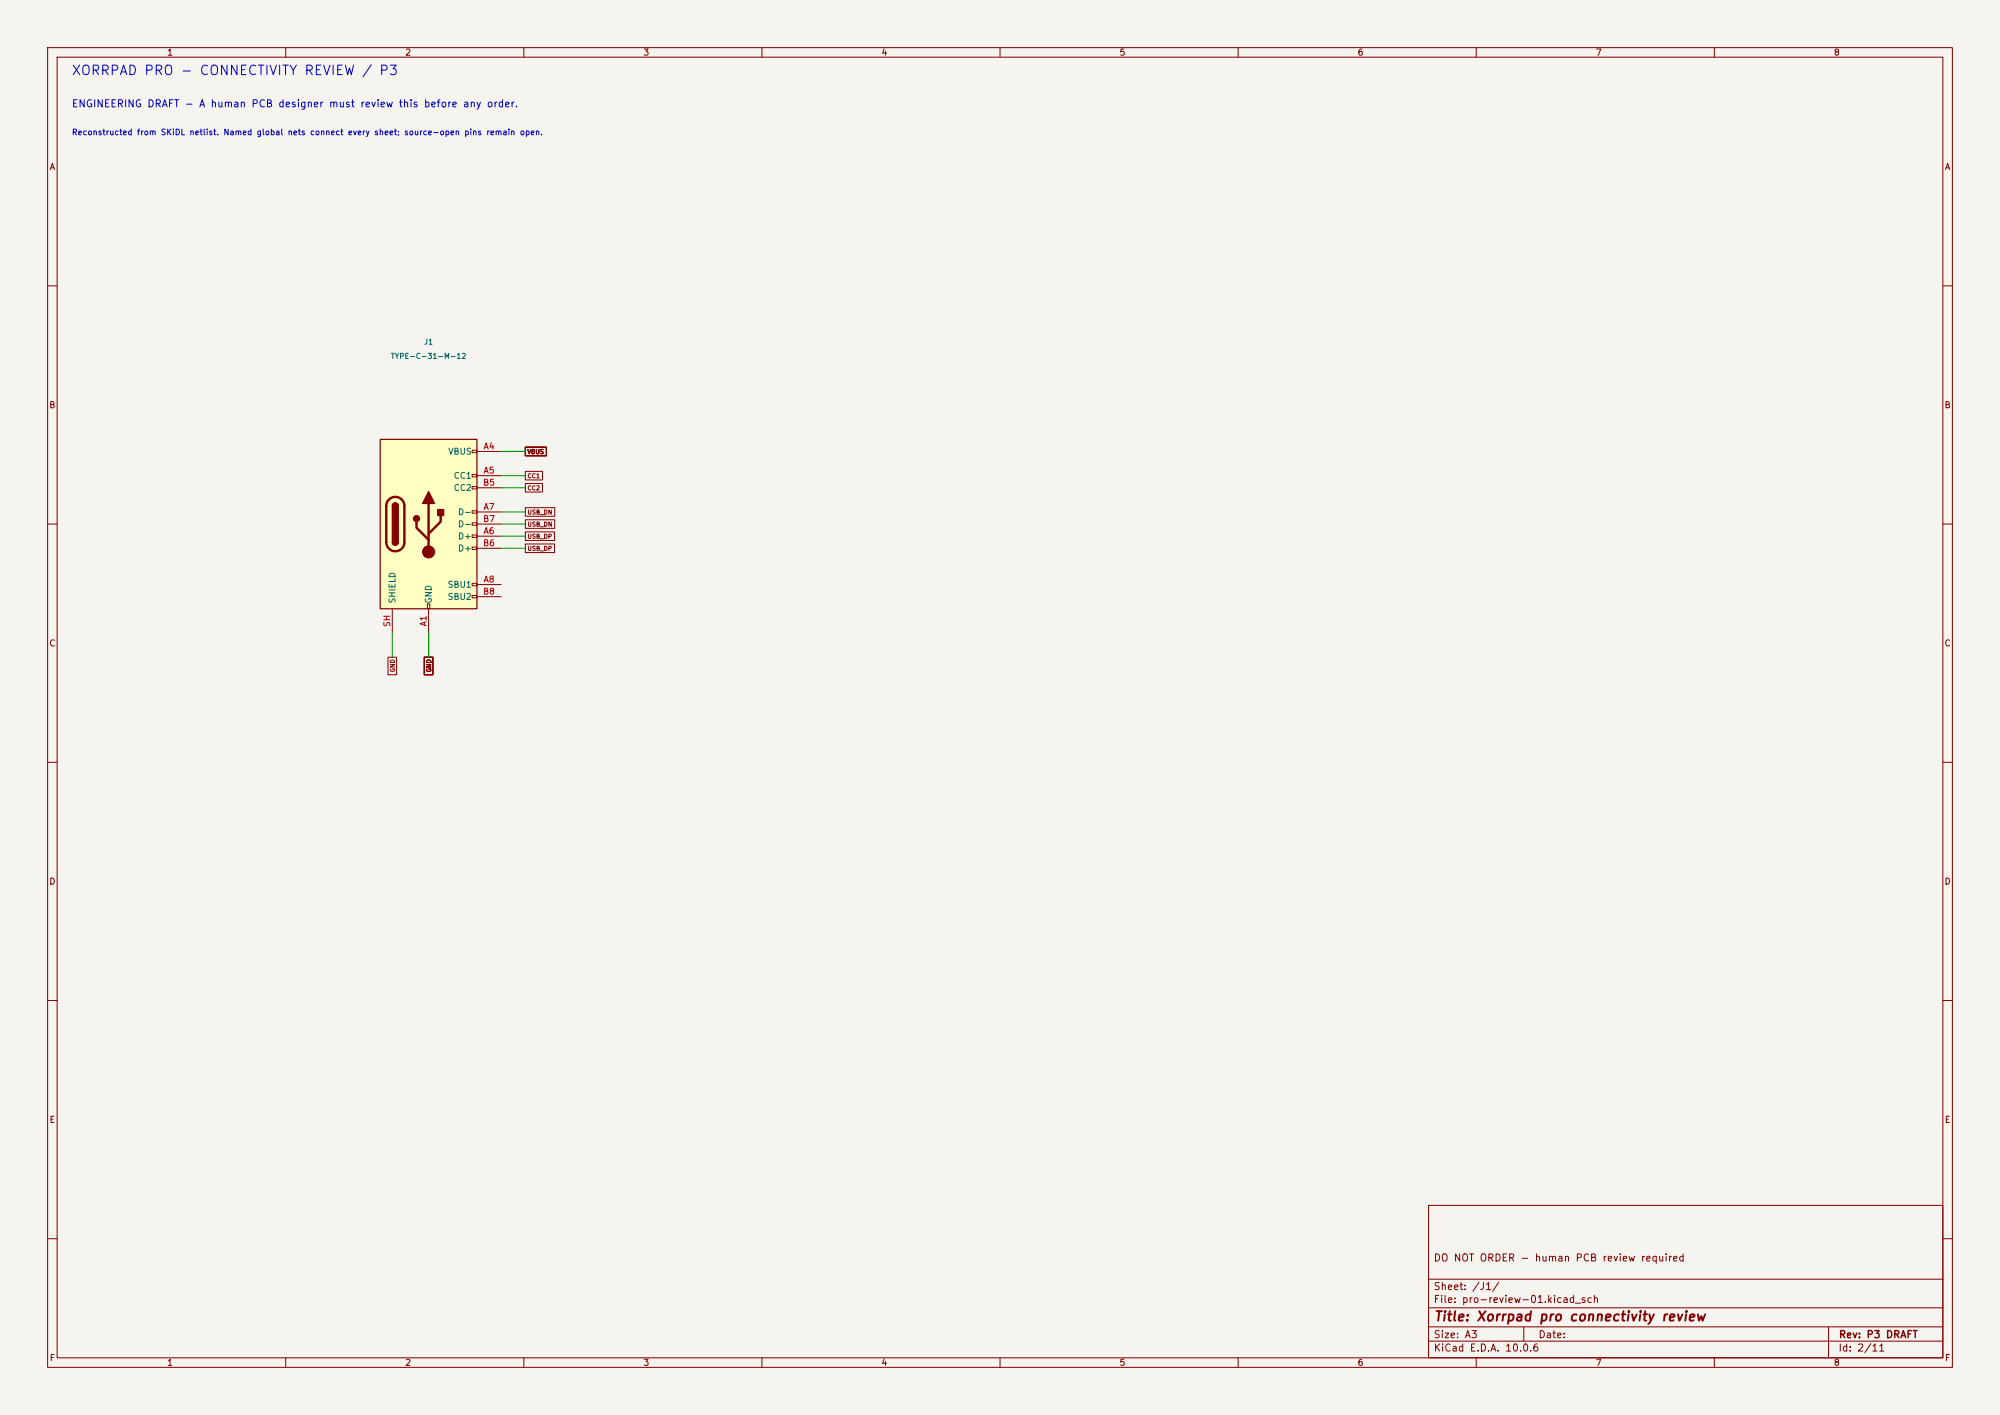
[picture p94: page 2]

VBUS CC1 XORRPAD PRO - CONNECTIVITY REVIEW / P3

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

DO NOT ORDER - human PCB review required GND A1

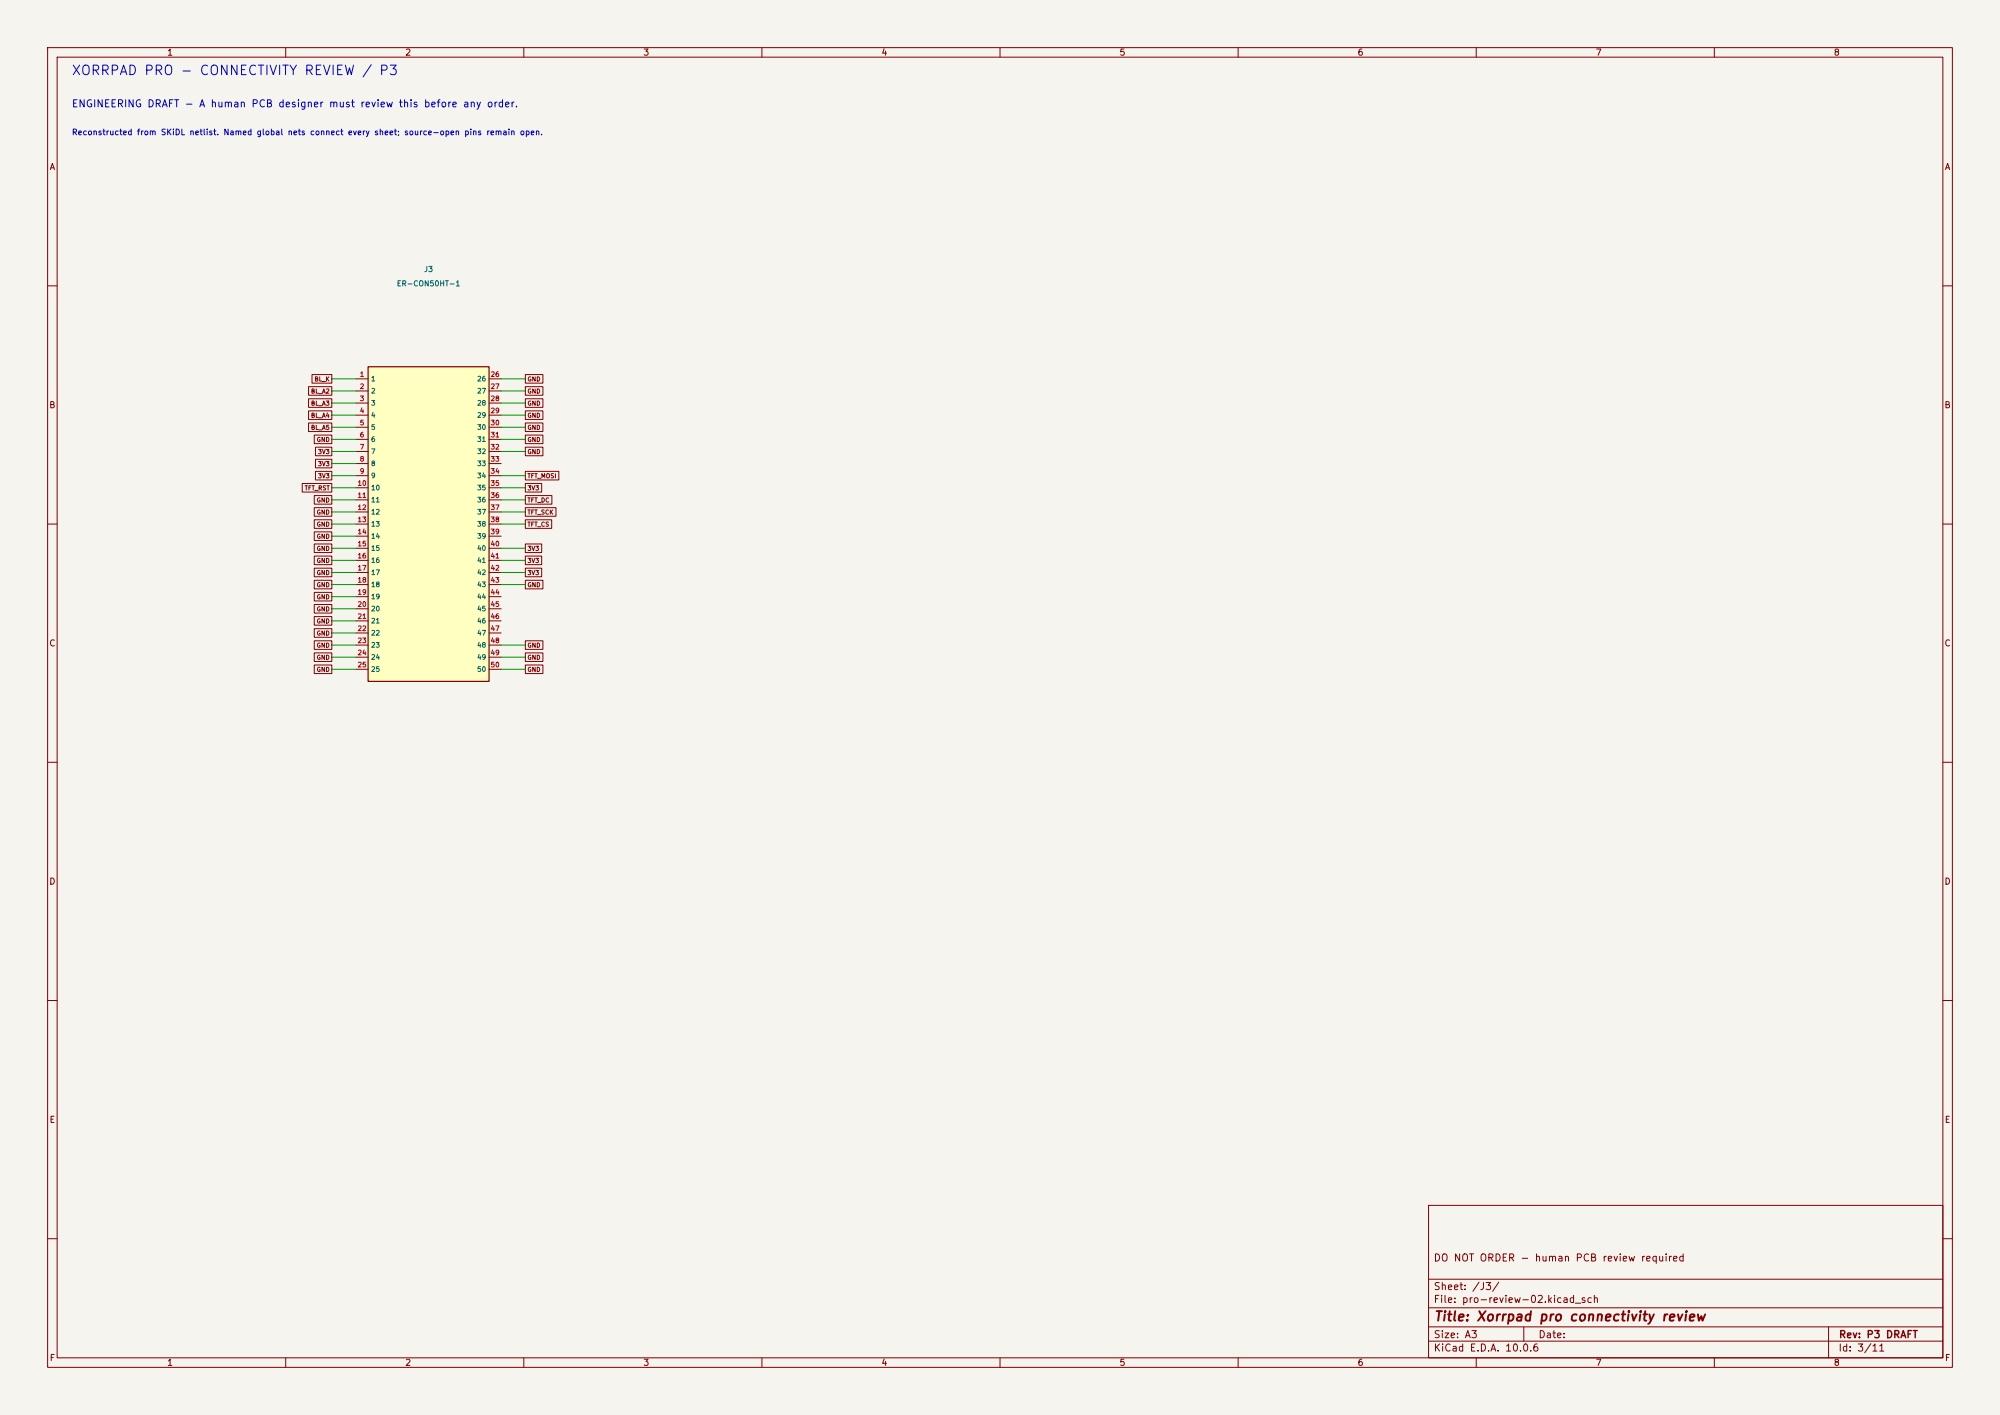
[picture p95: page 3]

GND XORRPAD PRO - CONNECTIVITY REVIEW / P3

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

DO NOT ORDER - human PCB review required

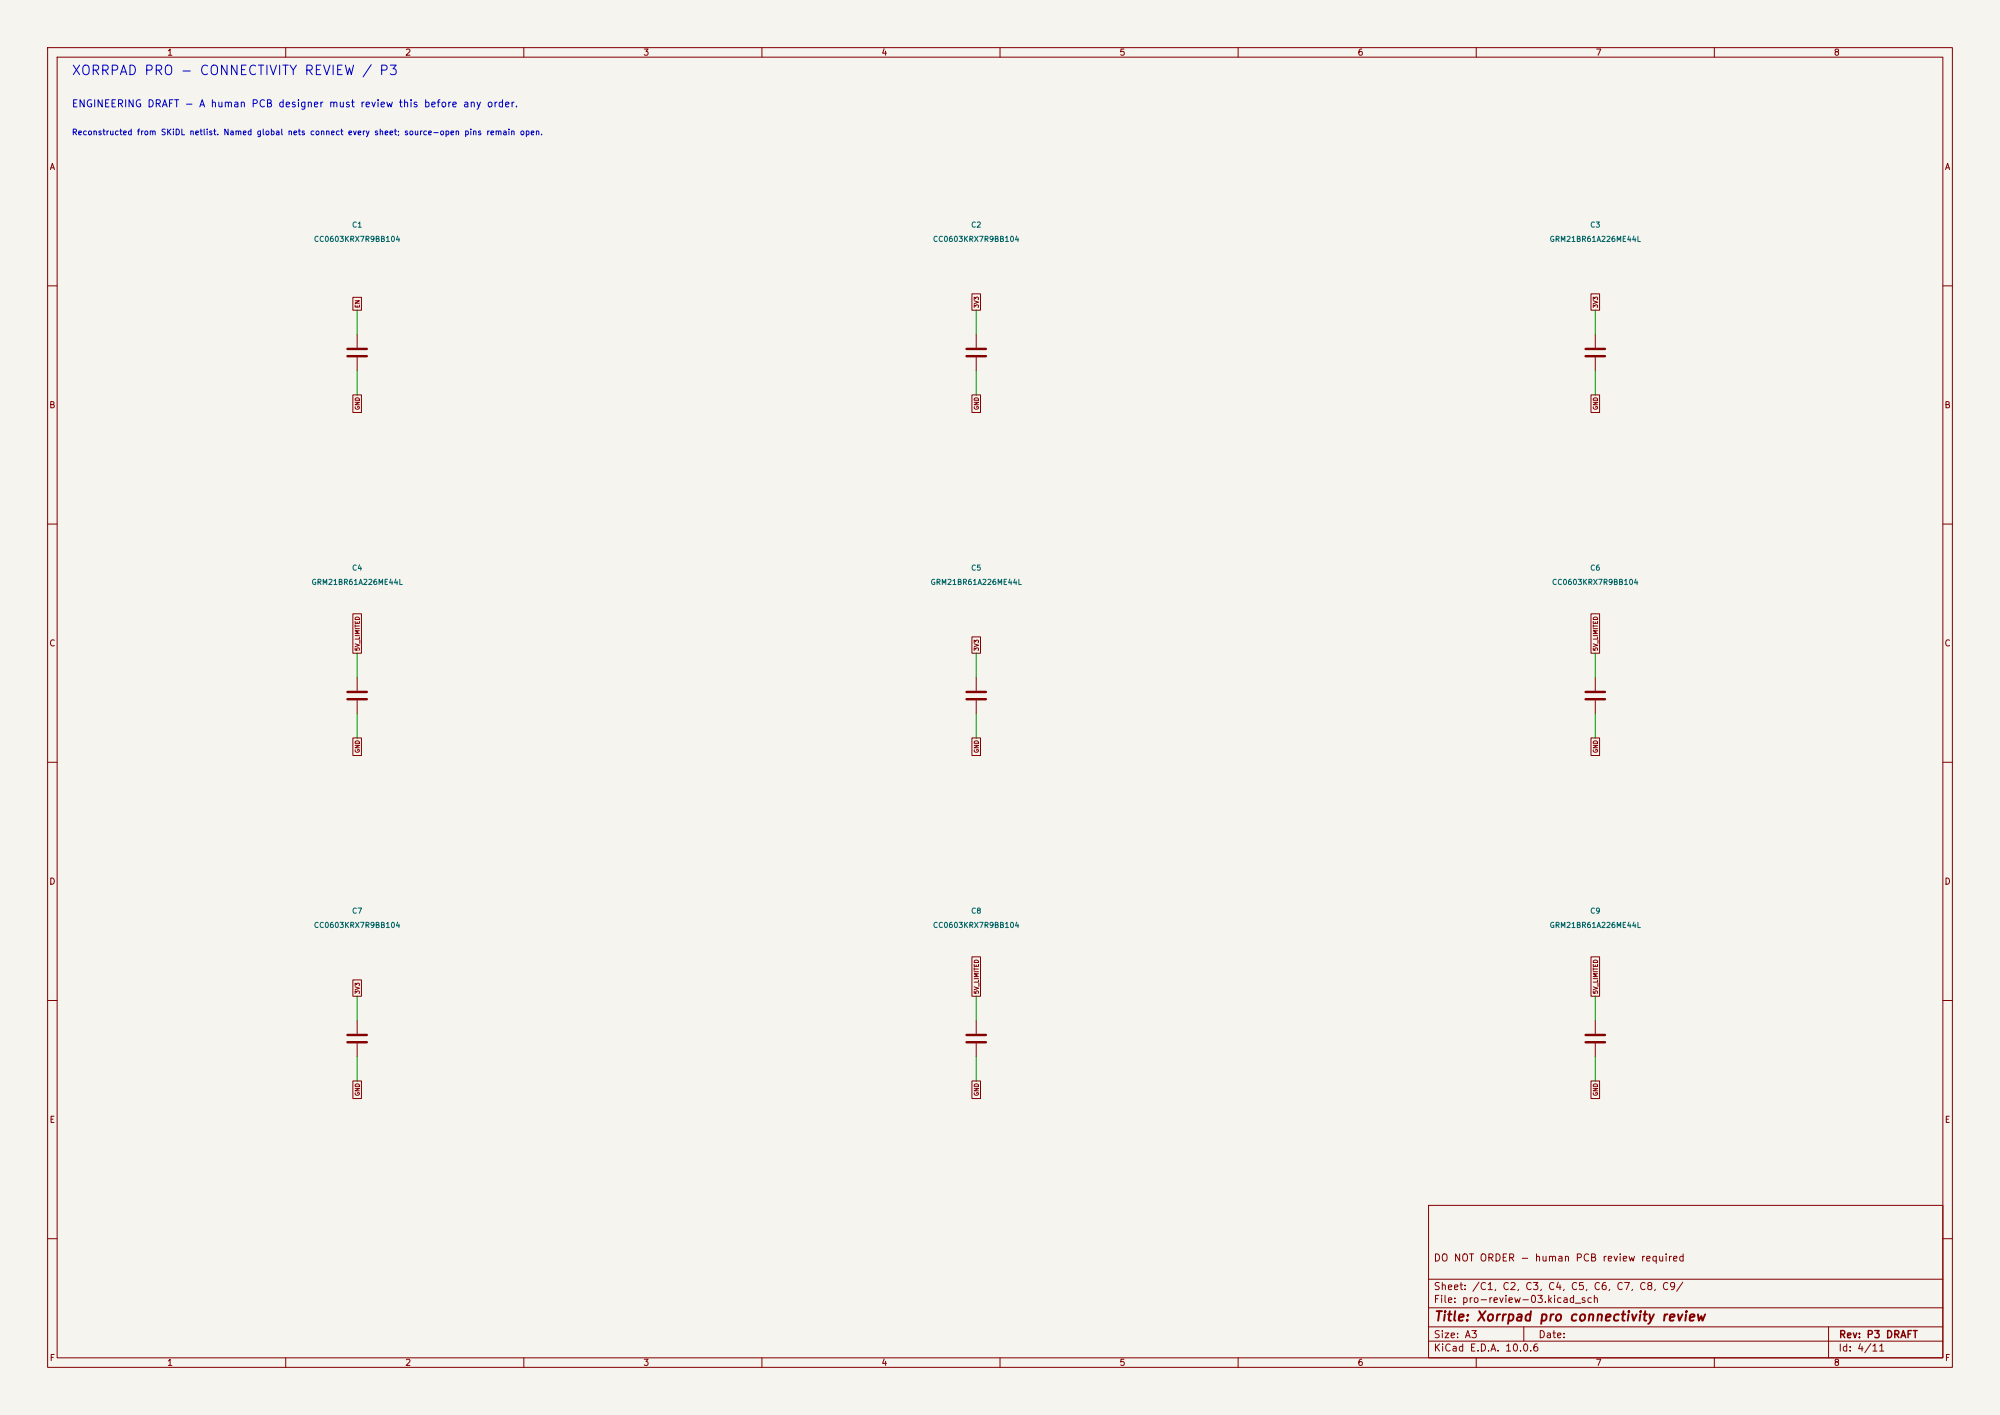
[picture p96: page 4]

ENGINEERING DRAFT - A human PCB designer must review this before any order. Reconstructed from SKiDL netlist. Named global nets connect every sheet; source-open pins remain open. XORRPAD PRO - CONNECTIVITY REVIEW / P3

DO NOT ORDER - human PCB review required

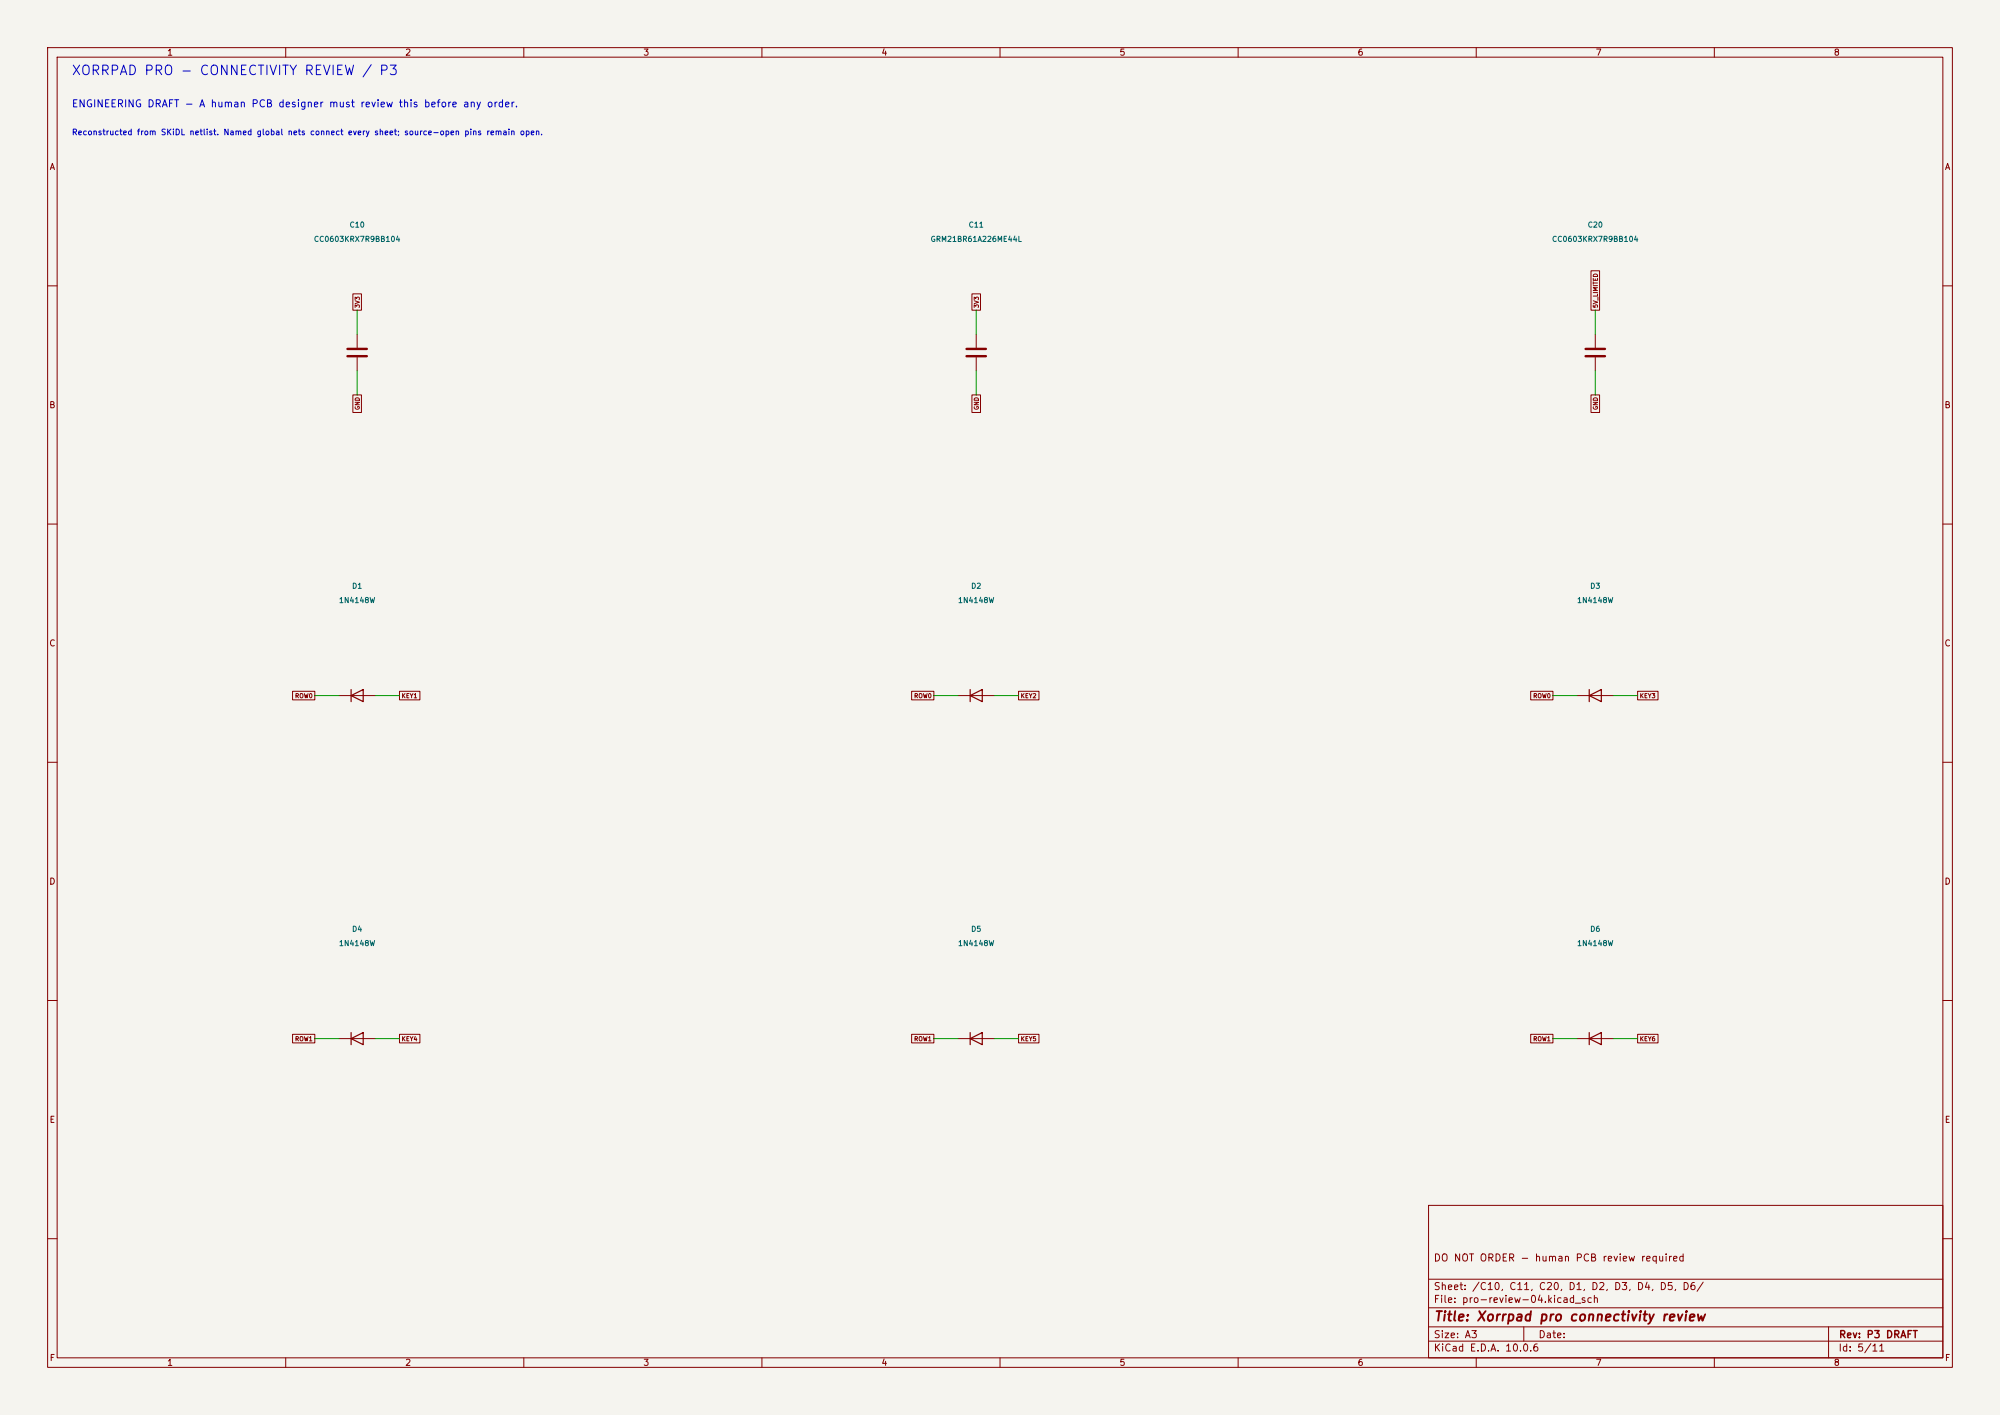
[picture p97: page 5]

ROW1 GND Reconstructed from SKiDL netlist. Named global nets connect every sheet; source-open pins remain open. XORRPAD PRO - CONNECTIVITY REVIEW / P3

ENGINEERING DRAFT - A human PCB designer must review this before any order.

DO NOT ORDER - human PCB review required

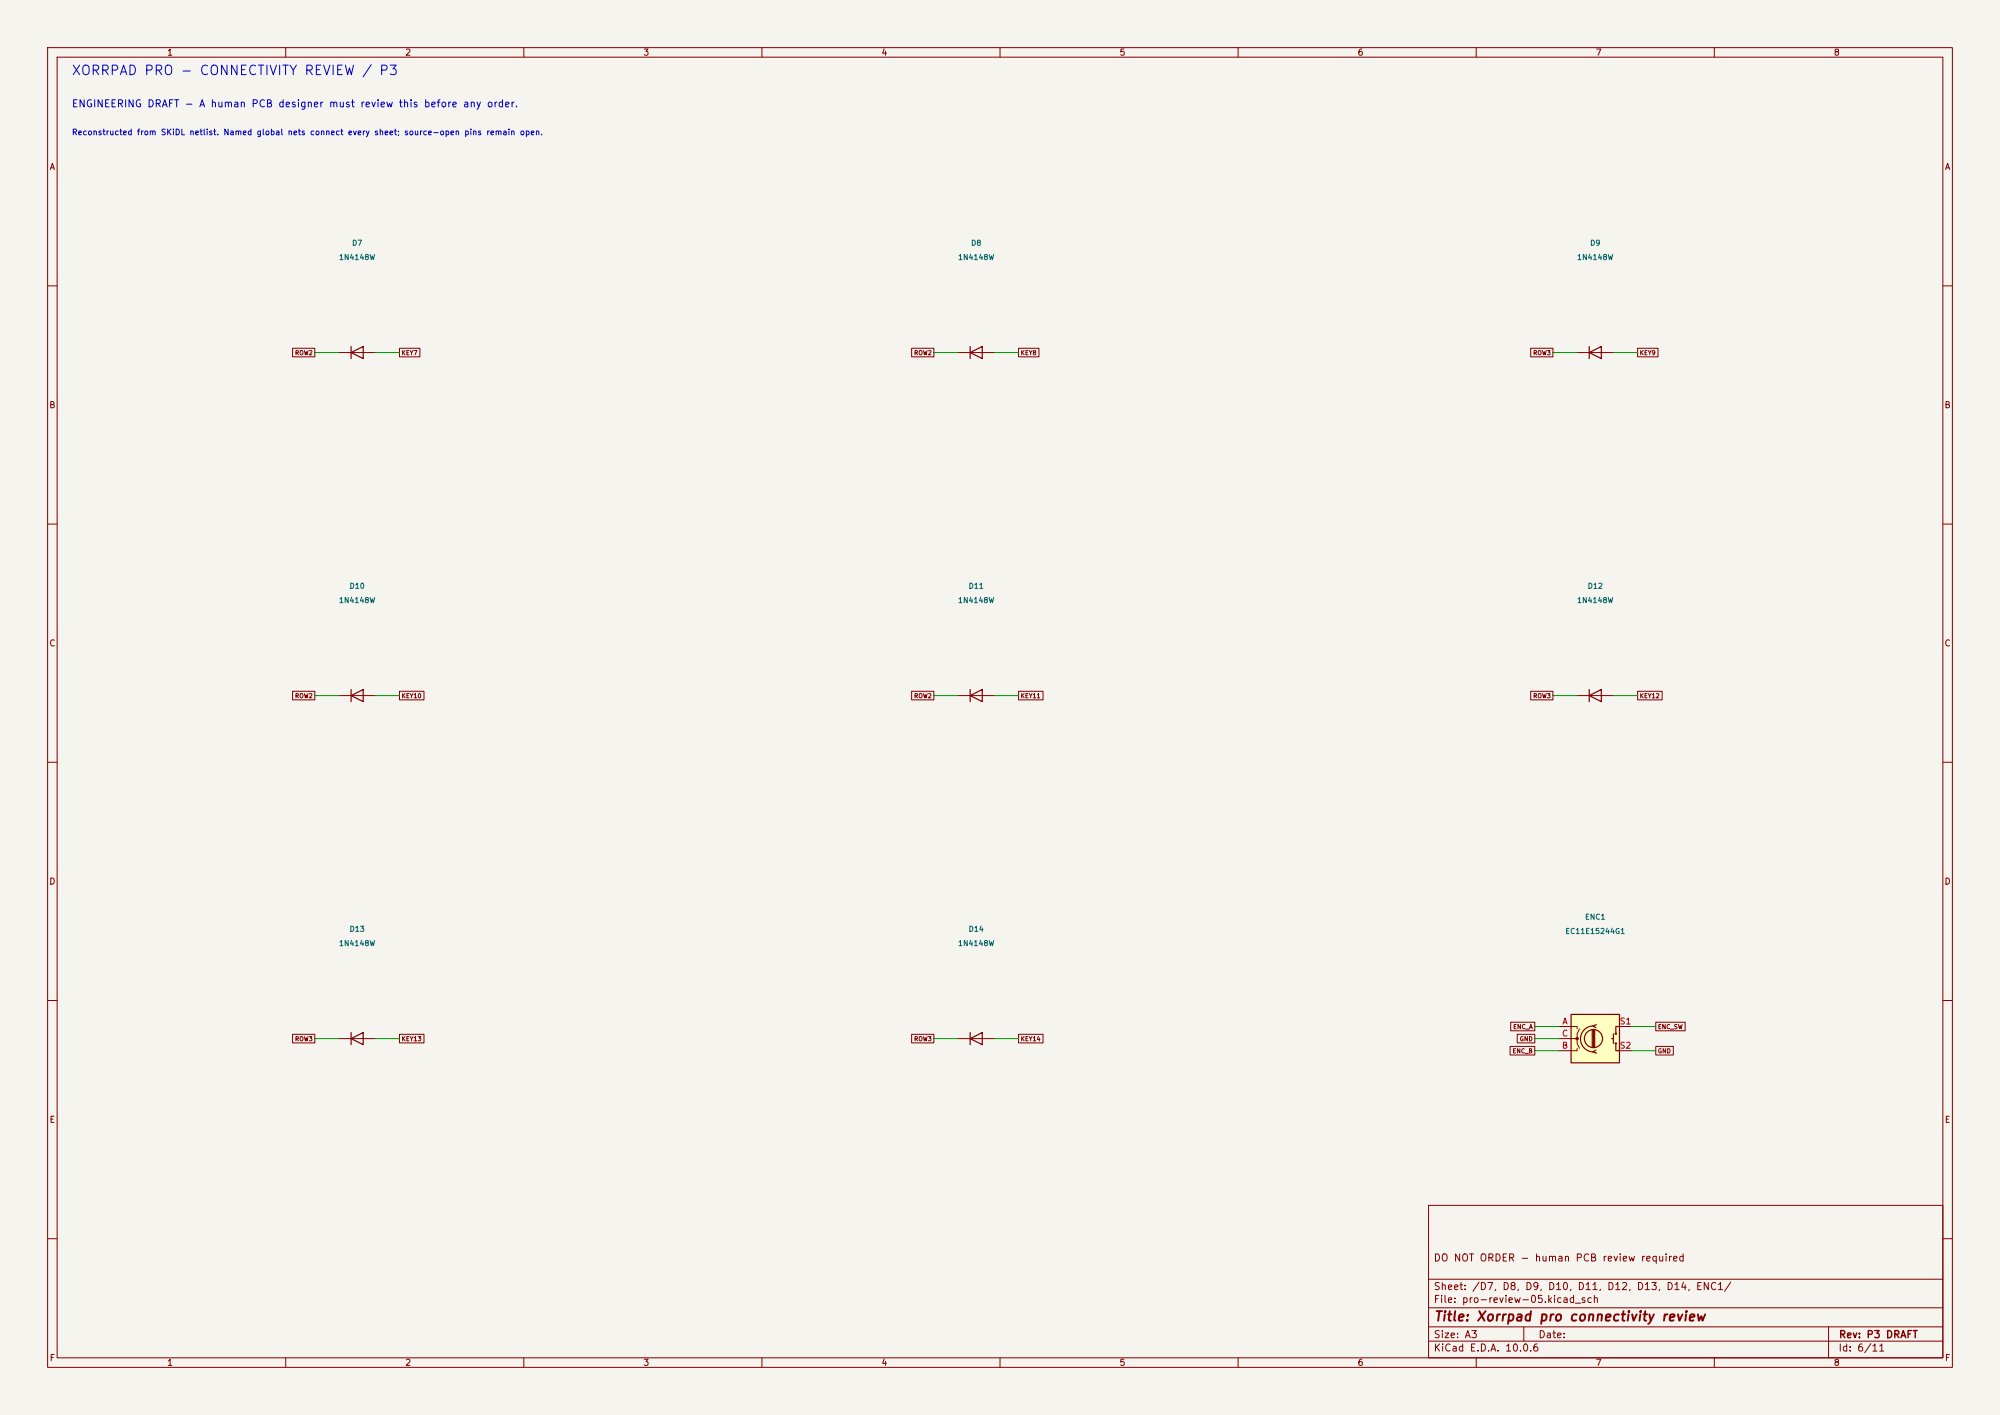
[picture p98: page 6]

XORRPAD PRO - CONNECTIVITY REVIEW / P3

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

DO NOT ORDER - human PCB review required

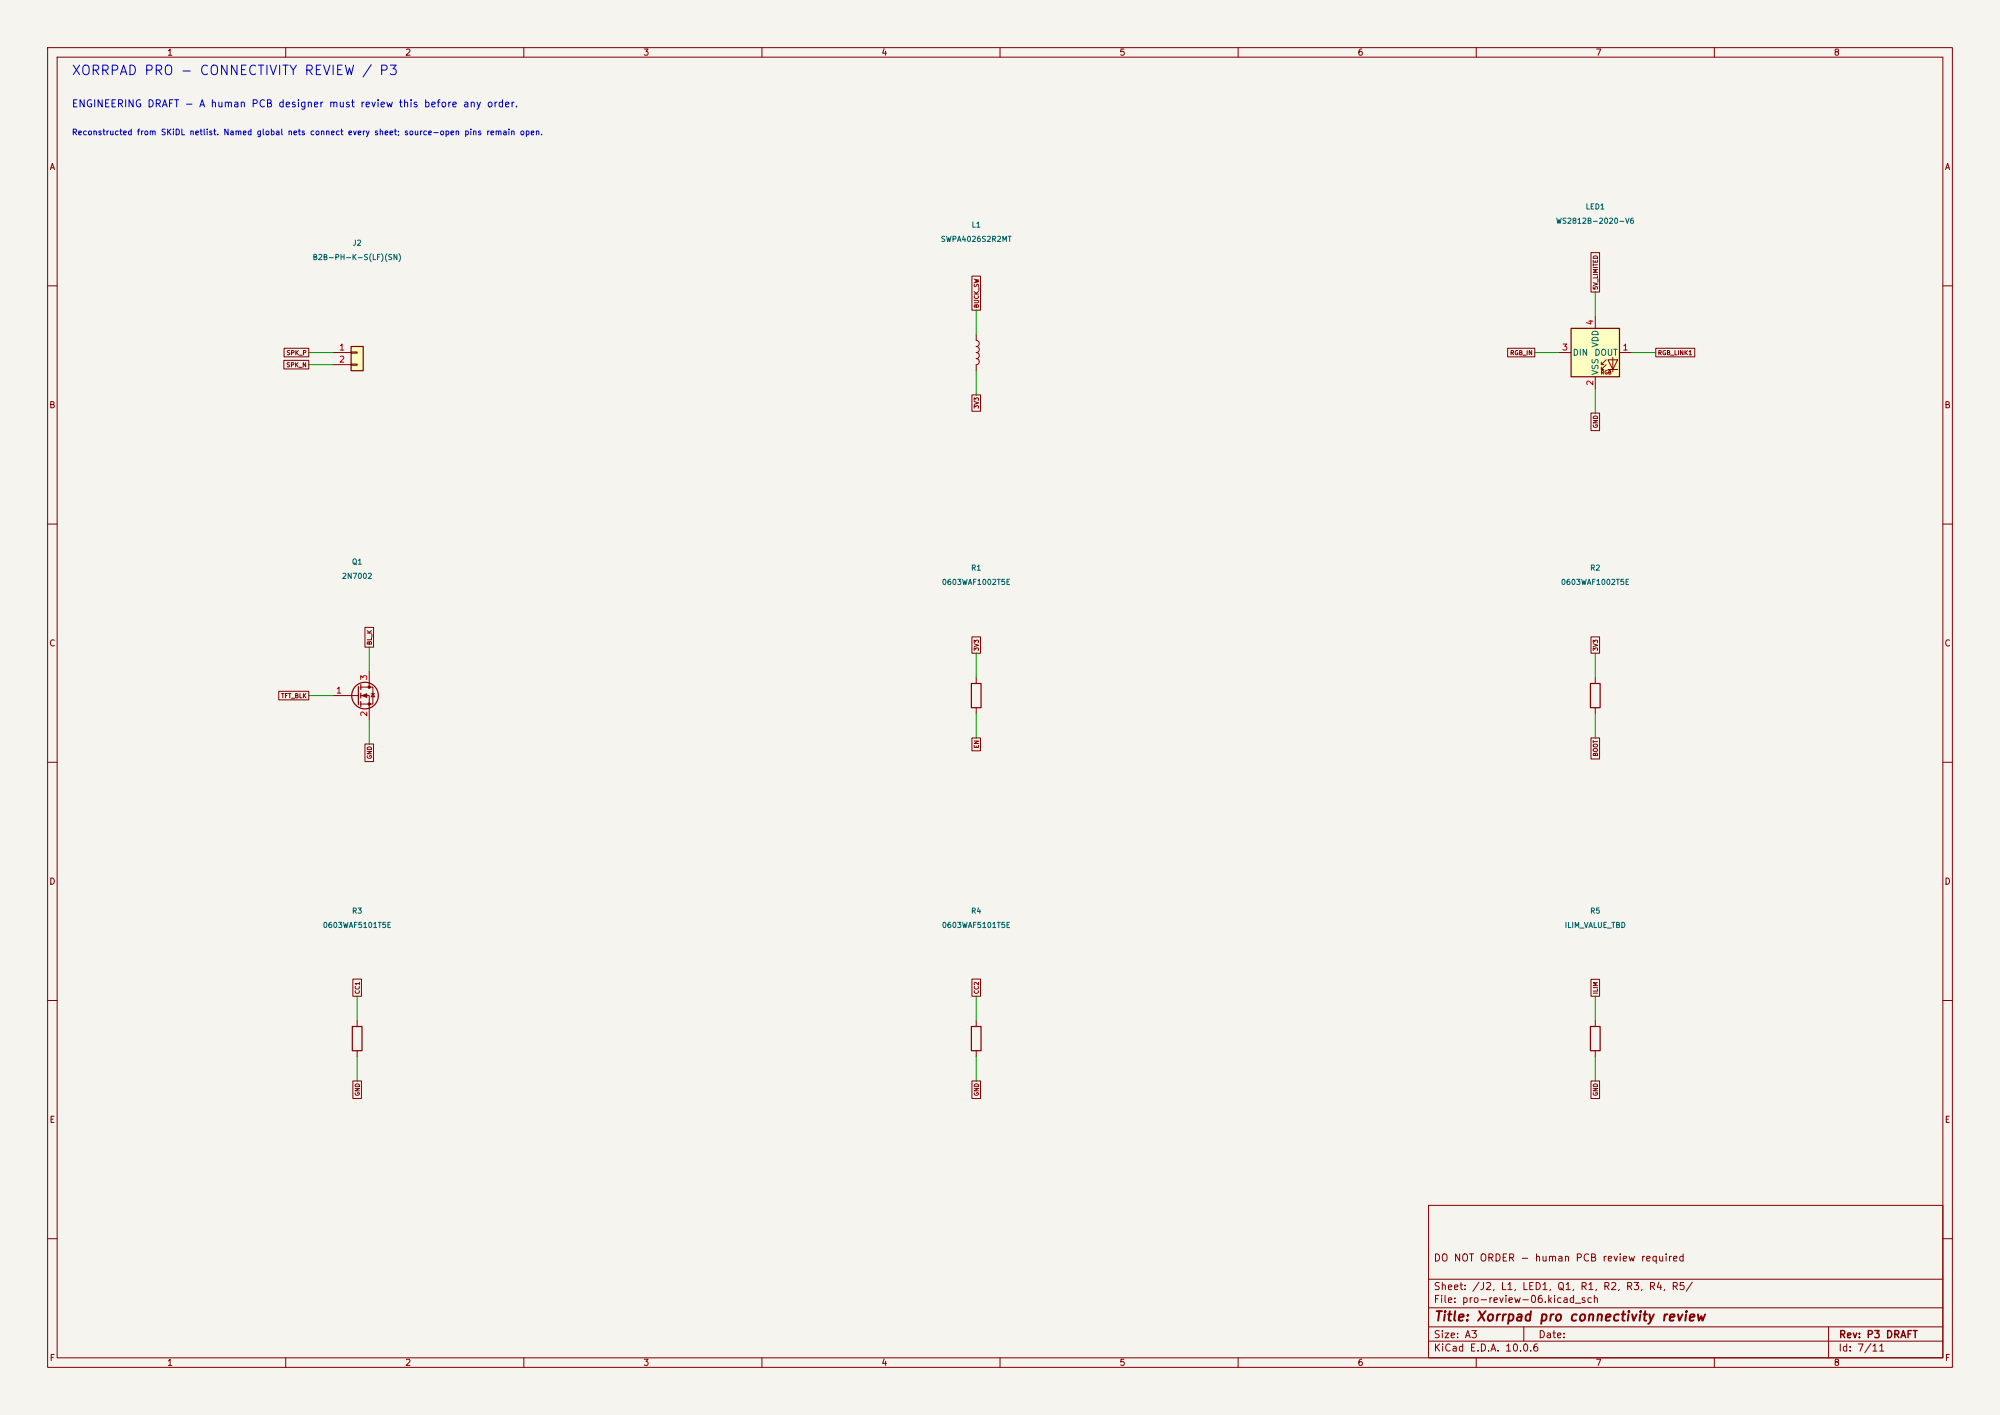
[picture p99: page 7]

XORRPAD PRO - CONNECTIVITY REVIEW / P3

ENGINEERING DRAFT - A human PCB designer must review this before any order.

Reconstructed from SKiDL netlist. Named global nets connect every sheet; source-open pins remain open.

DO NOT ORDER - human PCB review required

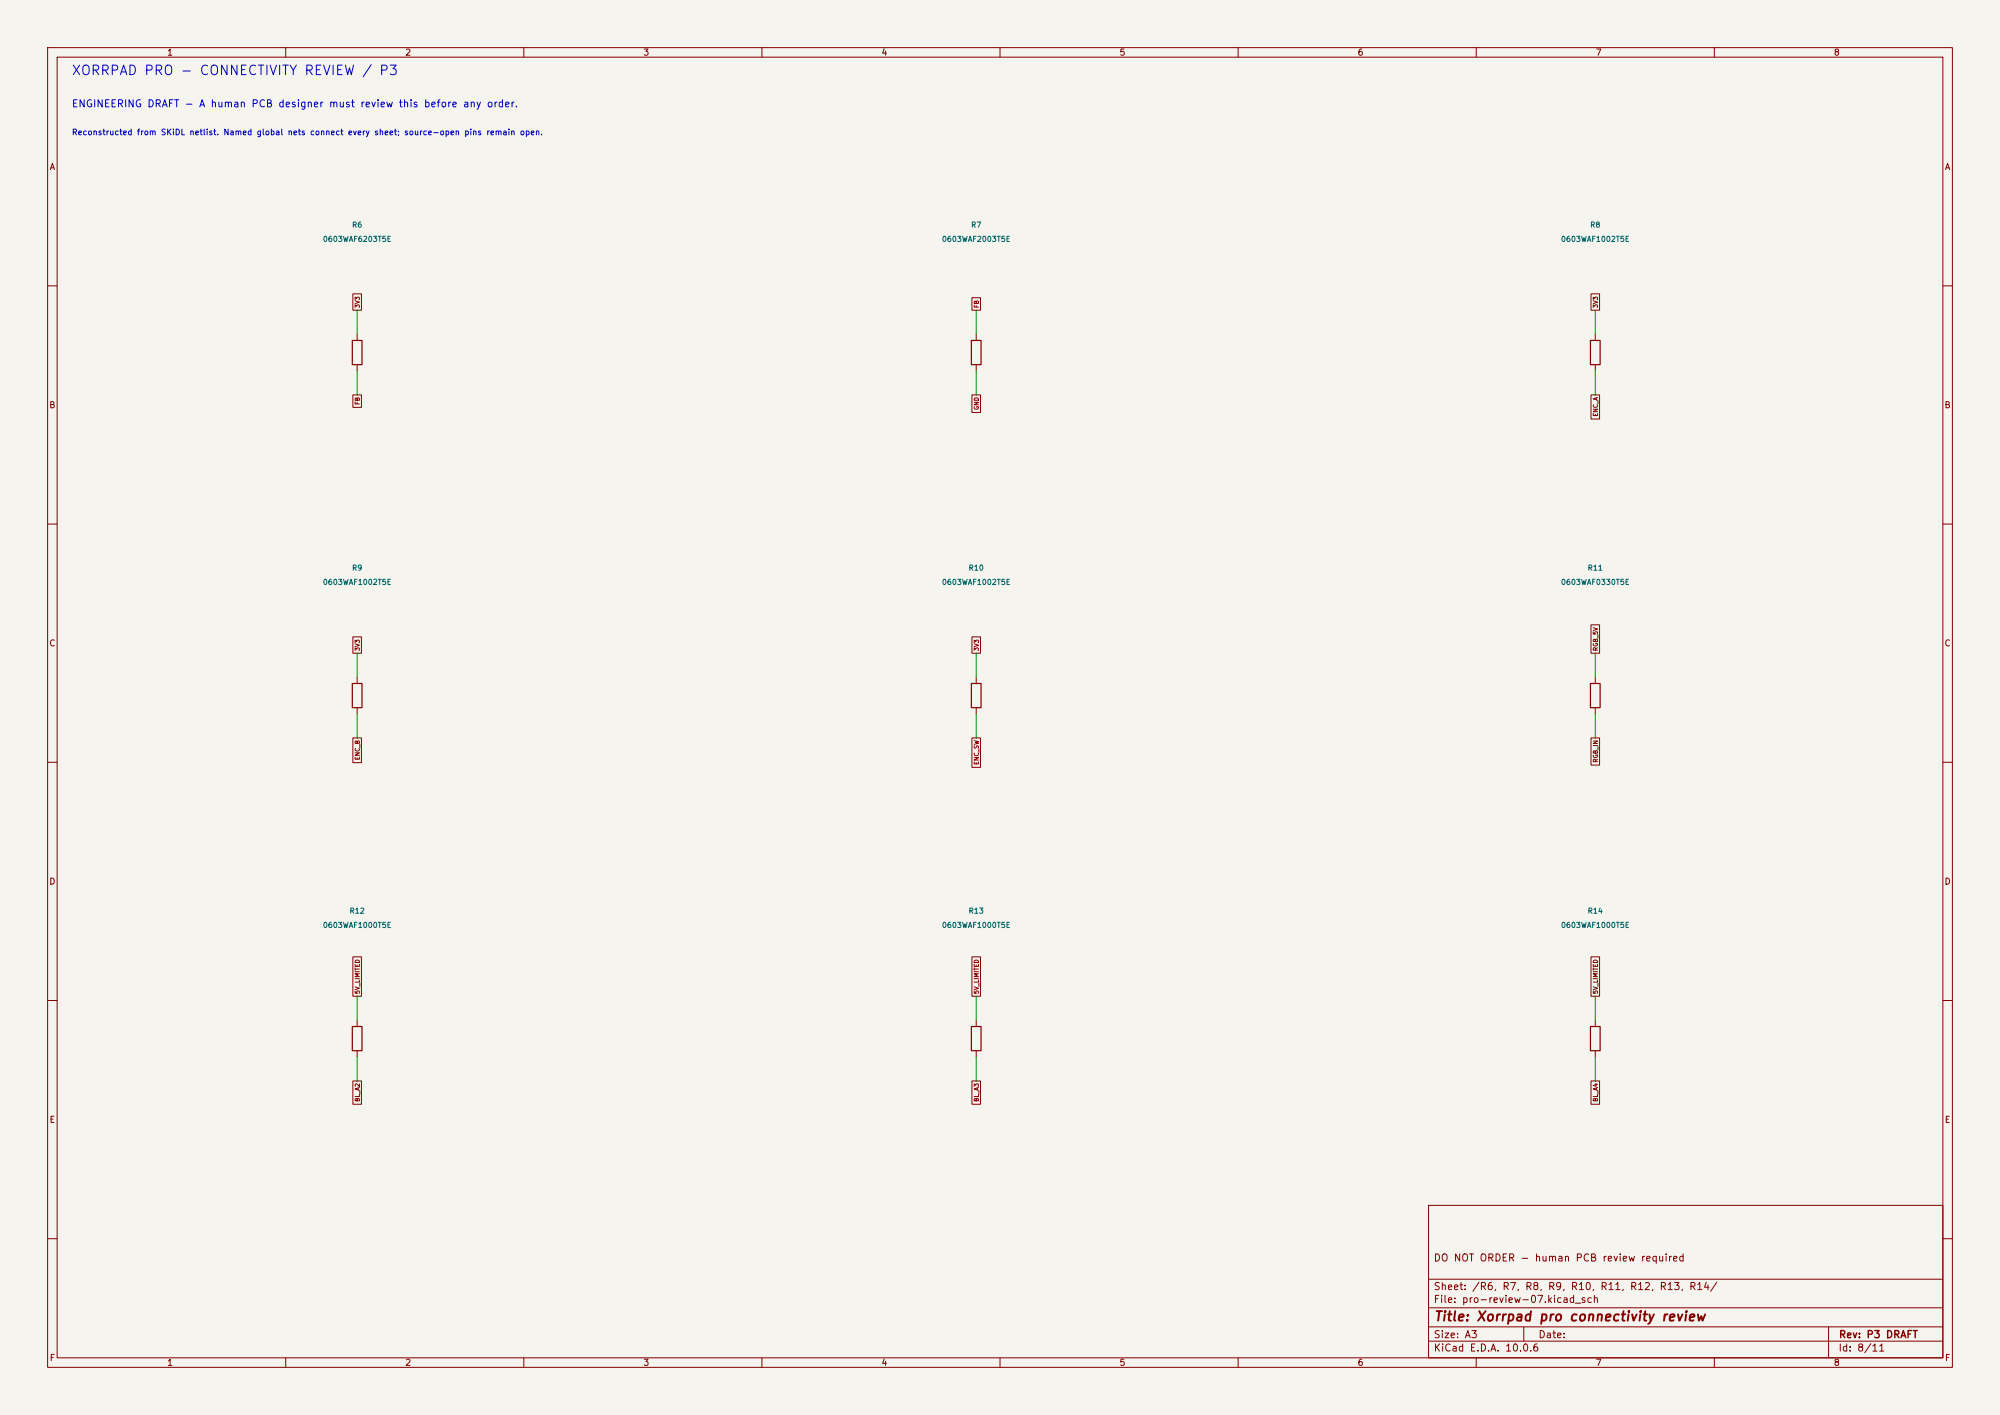
[picture p100: page 8]
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

DO NOT ORDER - human PCB review required

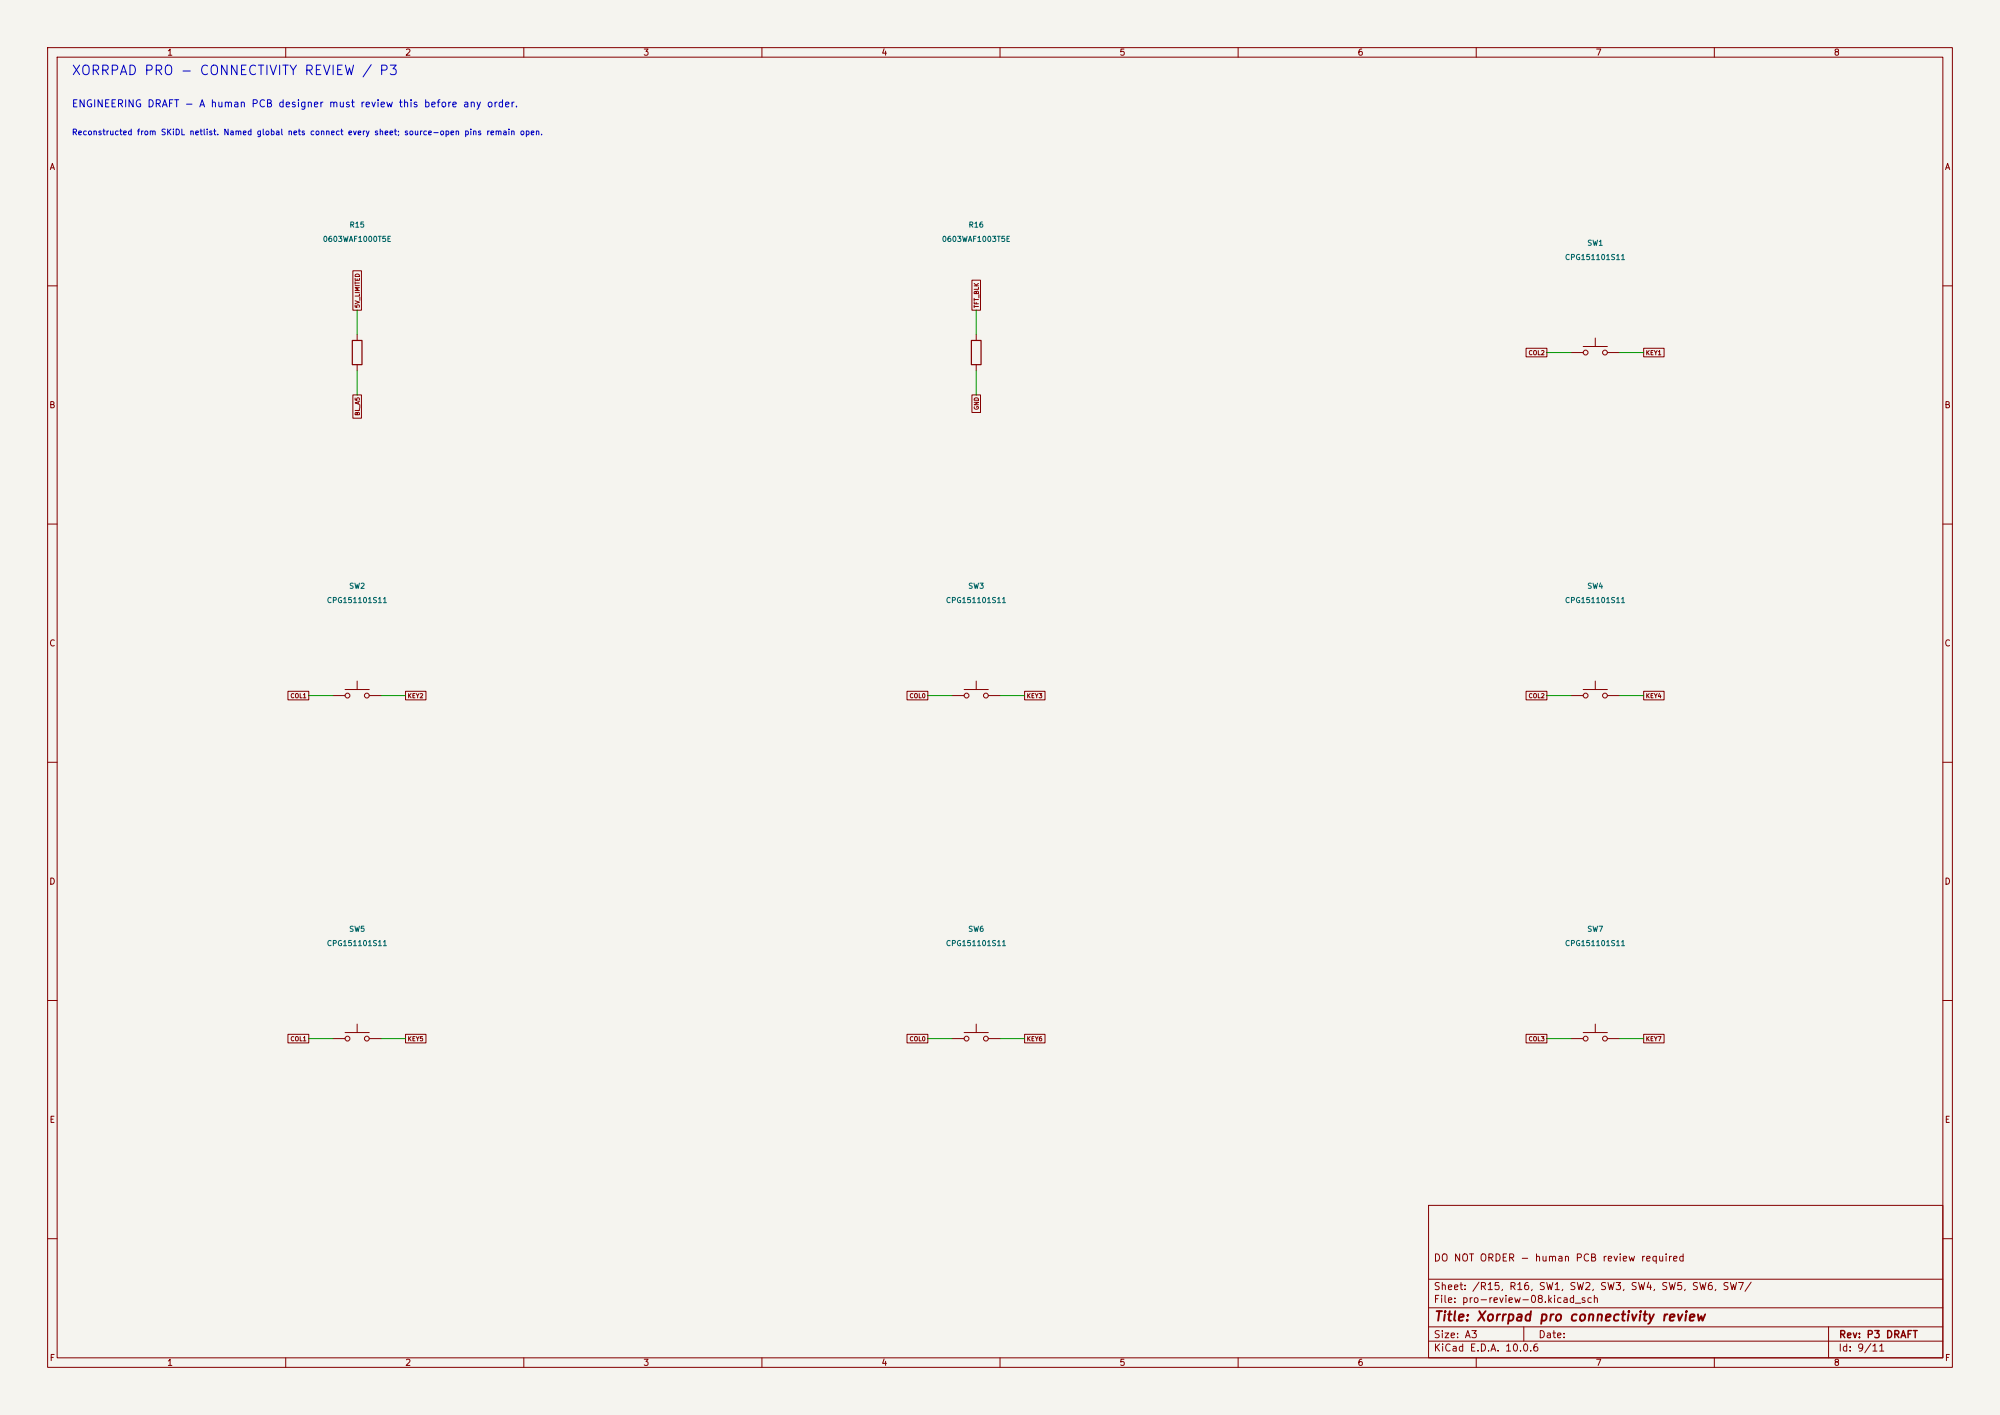
[picture p101: page 9]

XORRPAD PRO - CONNECTIVITY REVIEW / P3

ENGINEERING DRAFT - A human PCB designer must review this before any order.

Reconstructed from SKiDL netlist. Named global nets connect every sheet; source-open pins remain open.

DO NOT ORDER - human PCB review required

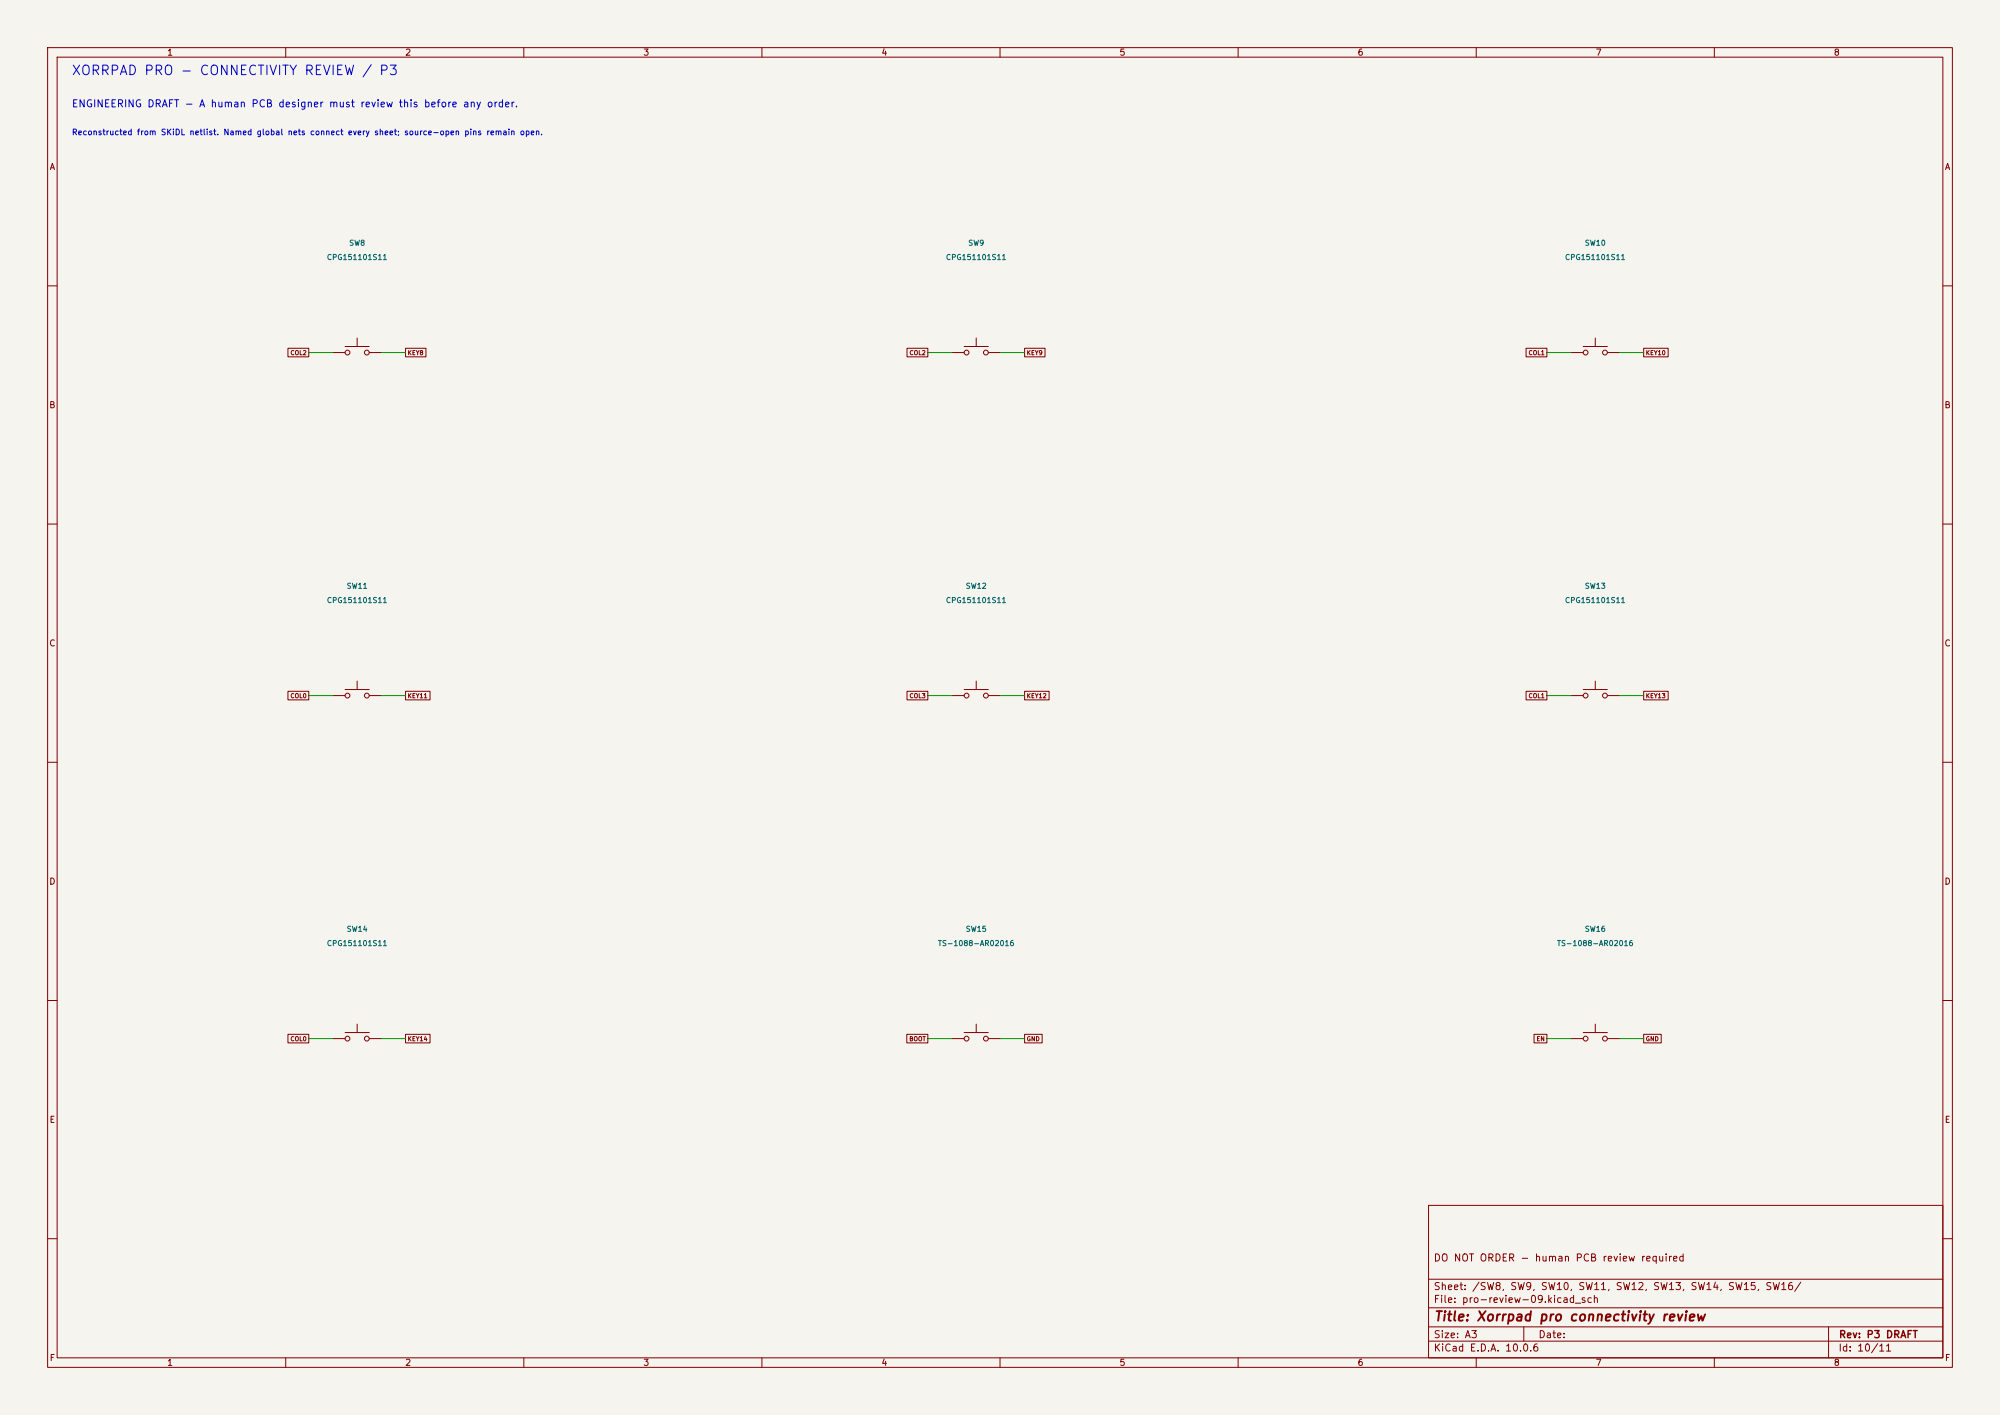
[picture p102: page 10]

XORRPAD PRO - CONNECTIVITY REVIEW / P3

Reconstructed from SKiDL netlist. Named global nets connect every sheet; source-open pins remain open.

DO NOT ORDER - human PCB review required

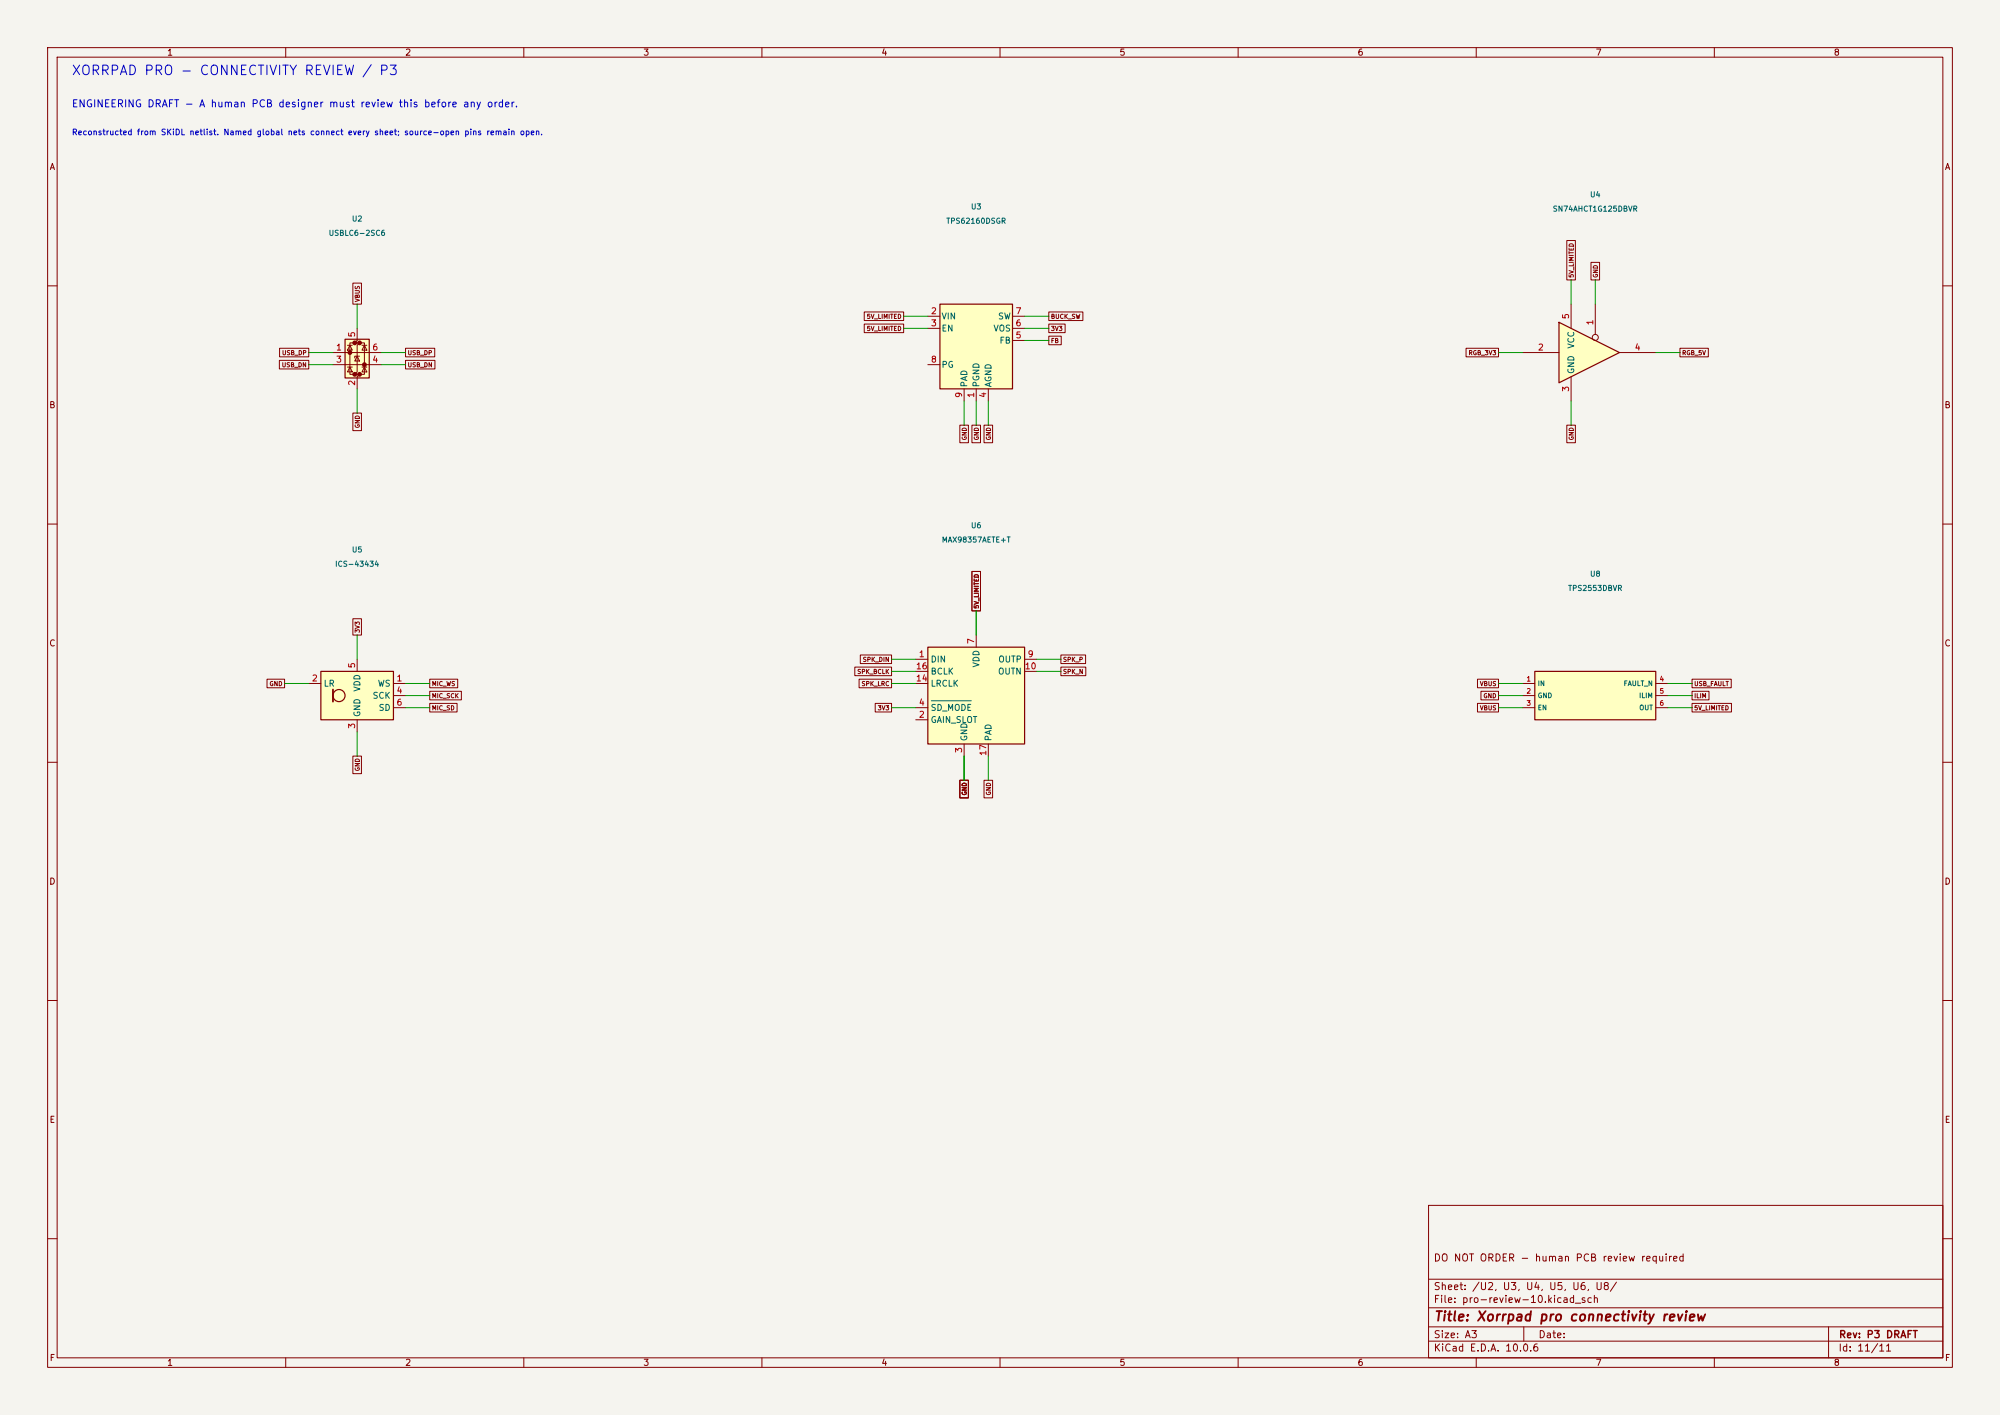
[picture p103: page 11]

FB Reconstructed from SKiDL netlist. Named global nets connect every sheet; source-open pins remain open. XORRPAD PRO - CONNECTIVITY REVIEW / P3
ICS-43434 1

ENGINEERING DRAFT - A human PCB designer must review this before any order.

DO NOT ORDER - human PCB review required
