nickthelegend/xorrpad/(list of files, drawings)

Other design files:
hardware/generated/core.dsn
hardware/generated/native-baseline/core.dsn
hardware/generated/pro.dsn
hardware/generated/pro/p1/attempt-1/pro.dsn
hardware/generated/pro/p1/attempt-2/pro.dsn
