nickthelegend/xorrpad/hardware/generated/core.kicad_pcb

## KiCad design hardware/generated/core.kicad_pcb (2026-11-12)

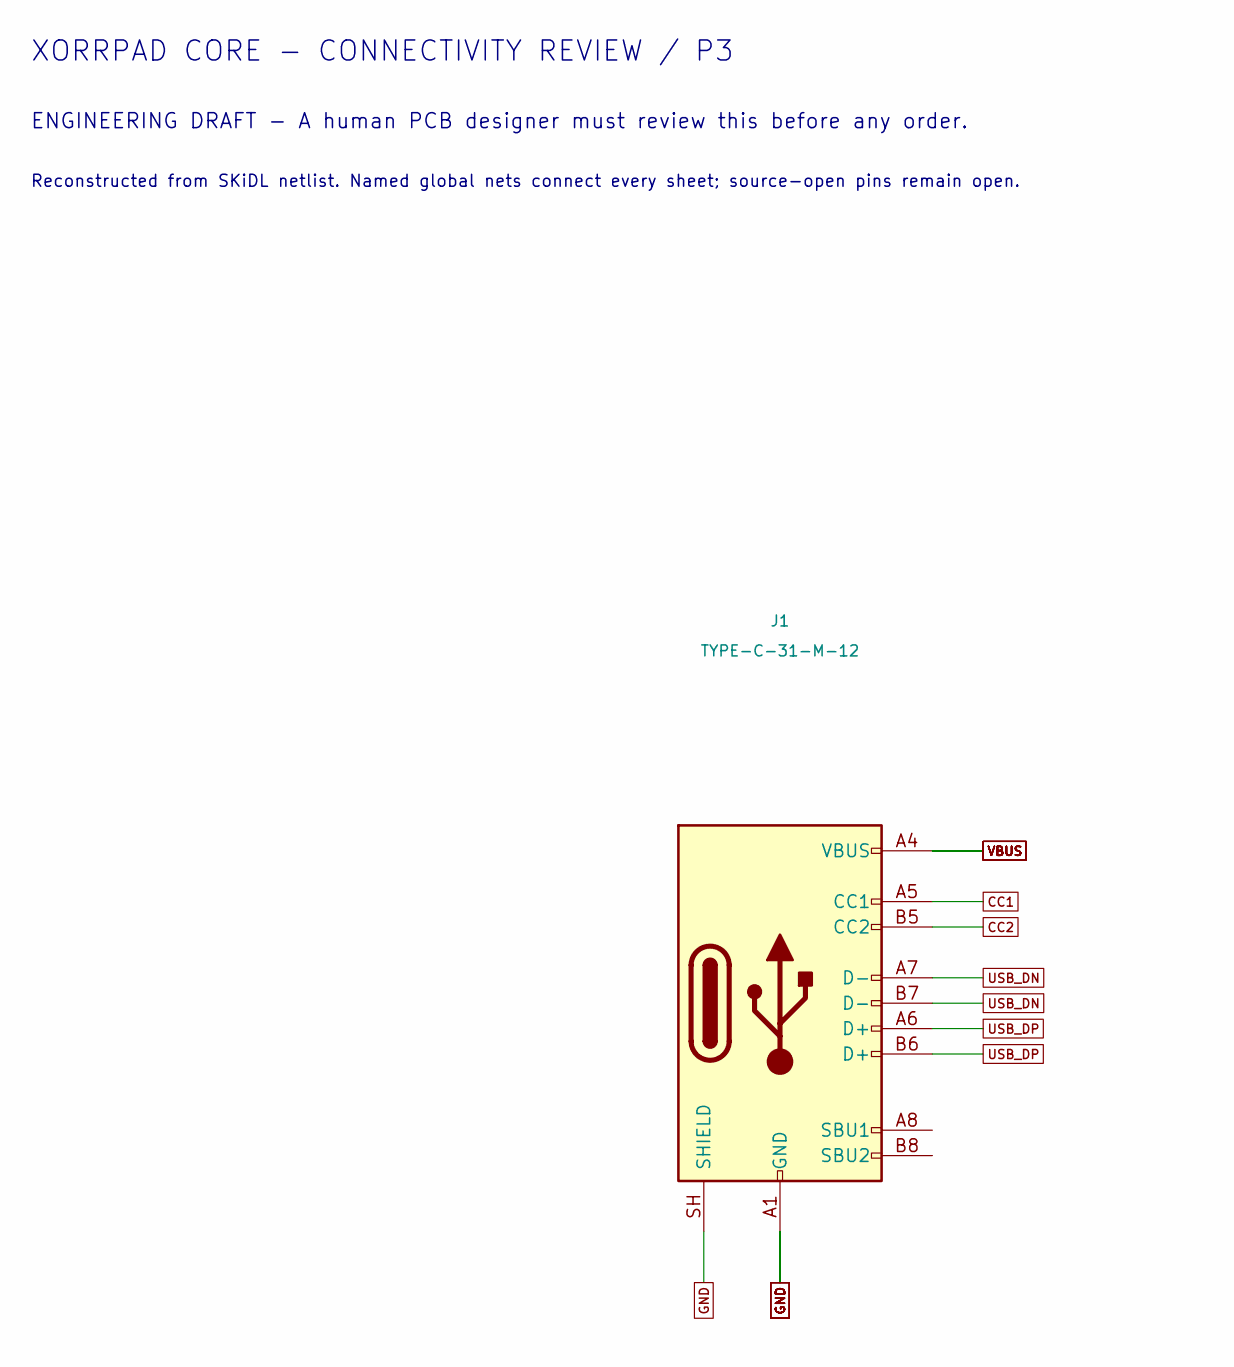
[picture p104: schematic core-review-01.kicad_sch, Xorrpad core connectivity review]

Parts:
J1: TYPE-C-31-M-12; USB_C_Receptacle_HRO_TYPE-C-31-M-12

Connections:
CC1: J1.A5 (CC1); also elsewhere on the board
CC2: J1.B5 (CC2); also elsewhere on the board
GND: J1.A1 (GND), J1.A12 (GND), J1.B1 (GND), J1.B12 (GND), J1.SH (SHIELD); also elsewhere on the board
USB_DN: J1.A7 (D-), J1.B7 (D-); also elsewhere on the board
USB_DP: J1.A6 (D+), J1.B6 (D+); also elsewhere on the board
VBUS: J1.A4 (VBUS), J1.A9 (VBUS), J1.B4 (VBUS), J1.B9 (VBUS); also elsewhere on the board

Notes on the sheet:
XORRPAD CORE - CONNECTIVITY REVIEW / P3
ENGINEERING DRAFT - A human PCB designer must review this before any order.
Reconstructed from SKiDL netlist. Named global nets connect every sheet; source-open pins remain open.

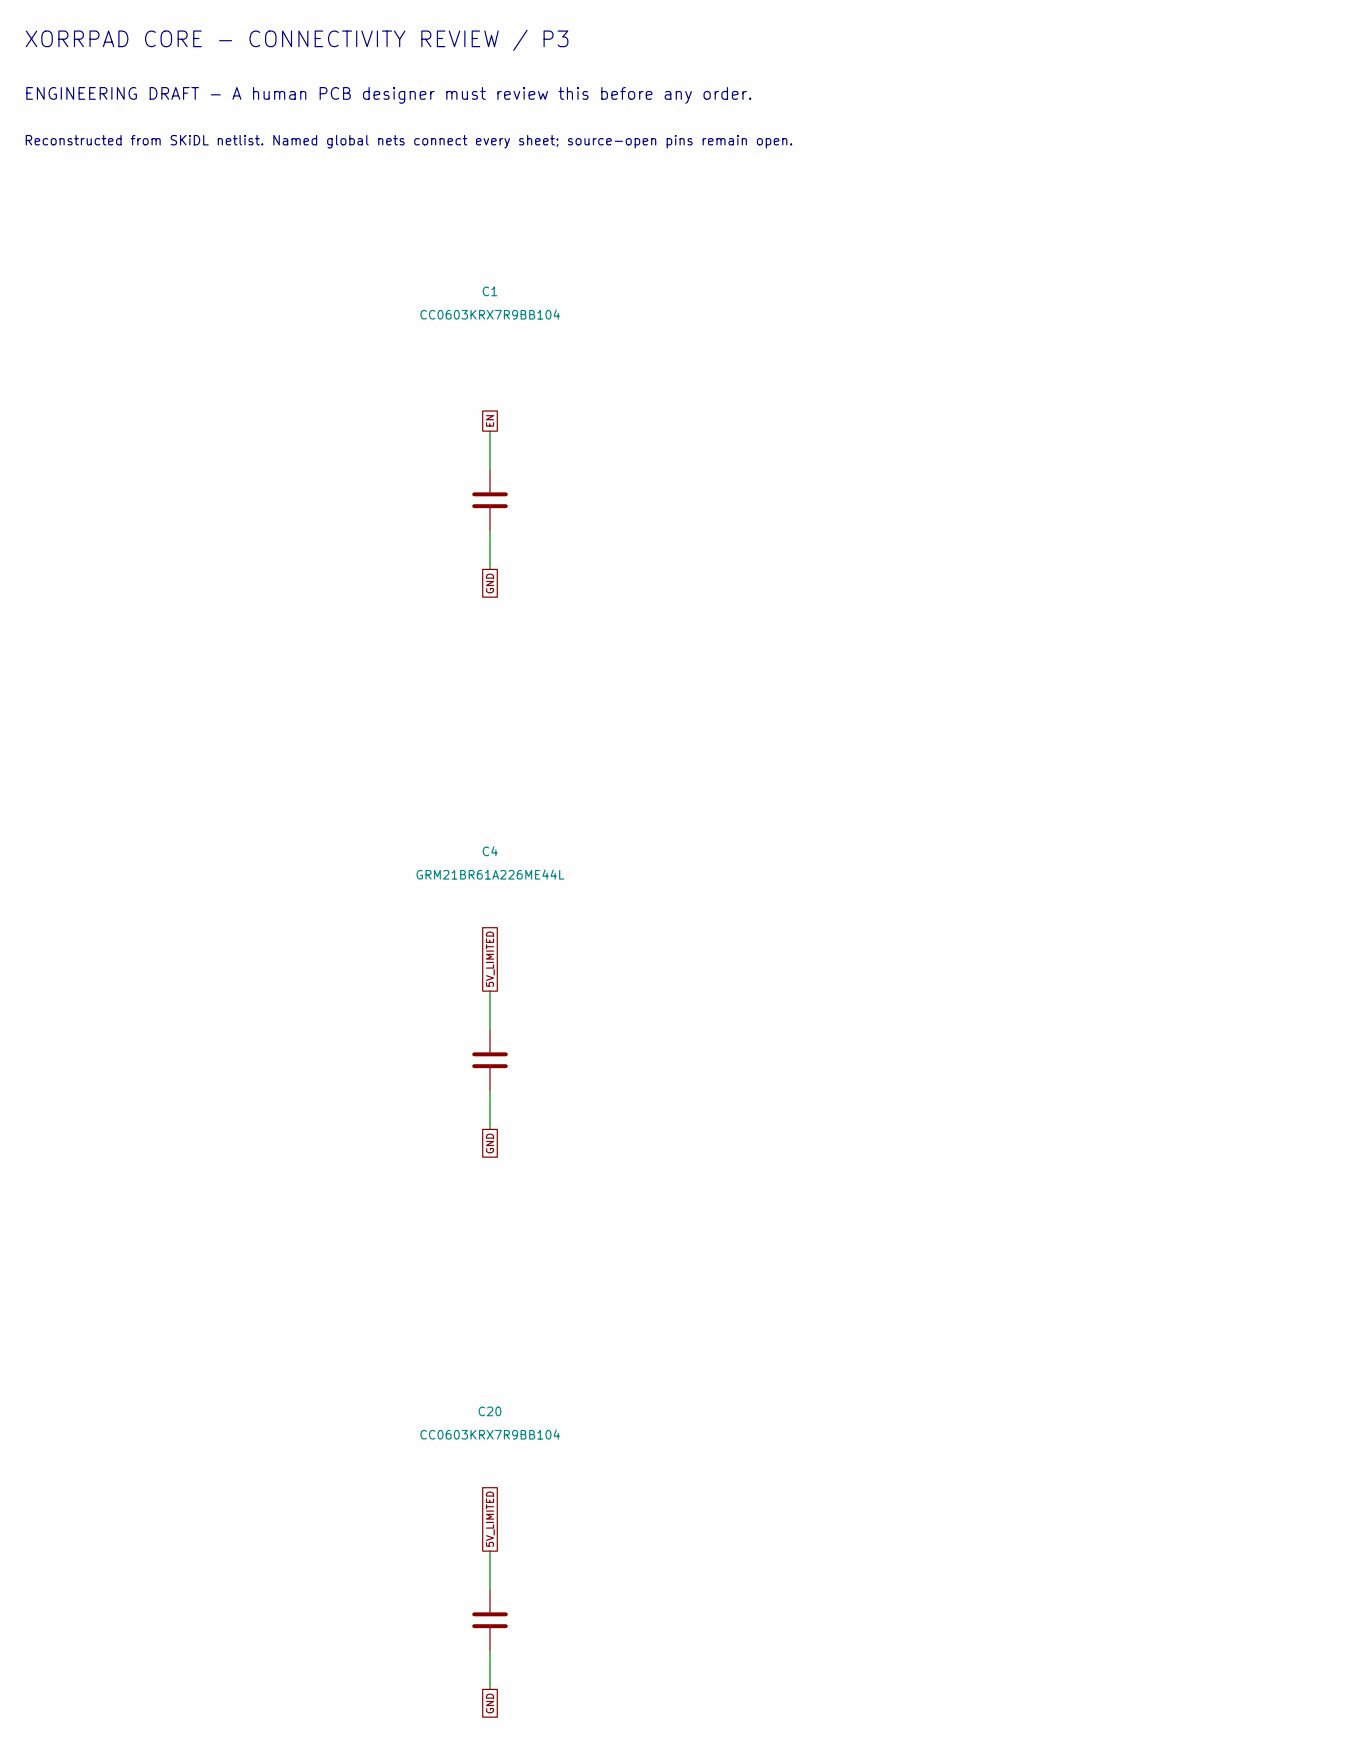
[picture p105: schematic core-review-02.kicad_sch, Xorrpad core connectivity review, part in row 1, column 1]

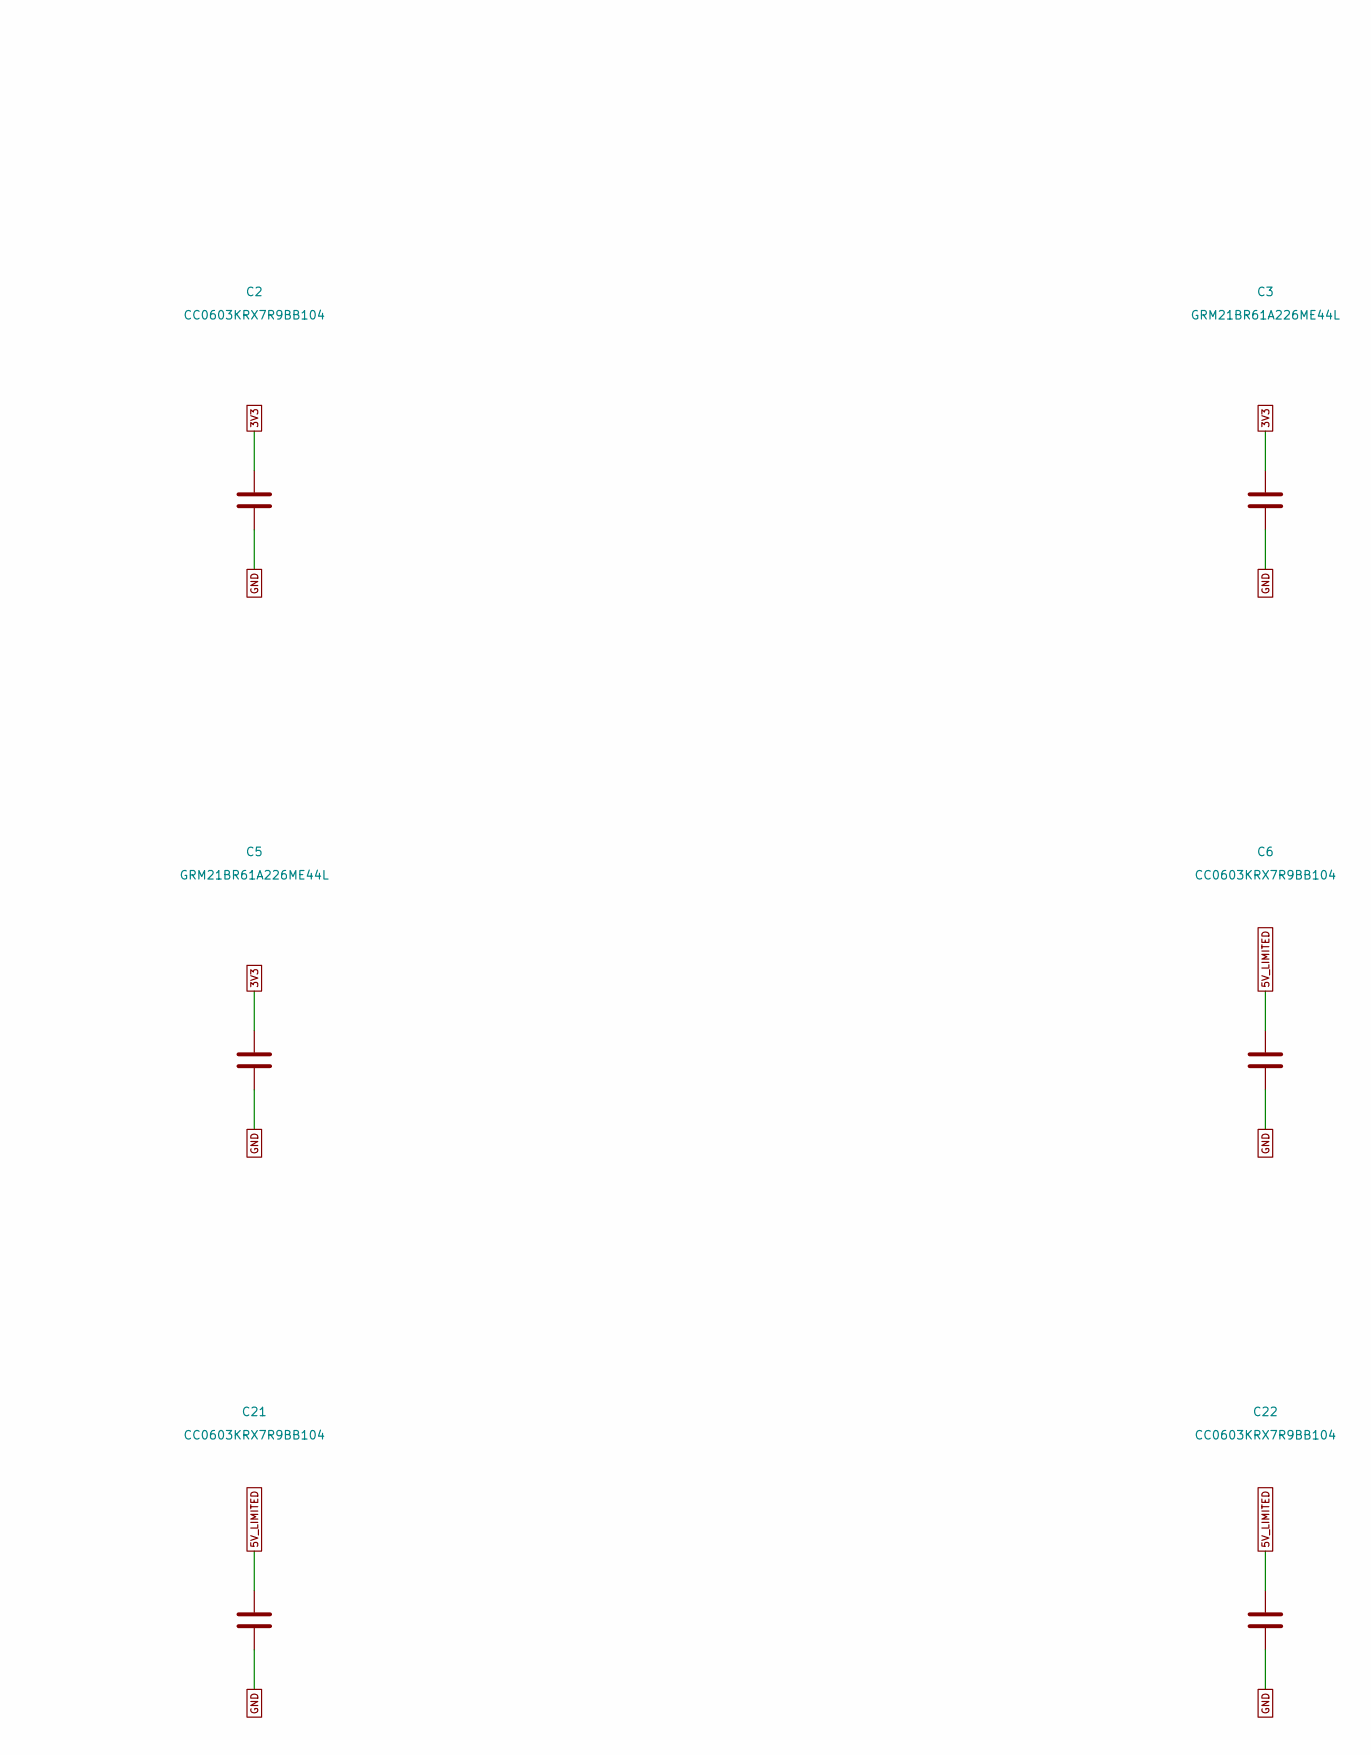
[picture p106: schematic core-review-02.kicad_sch, Xorrpad core connectivity review, part in row 1, column 2]

Parts:
C1, C2, C6, C20, C21, C22: CC0603KRX7R9BB104; C_0603_1608Metric
C3, C4, C5: GRM21BR61A226ME44L; C_0805_2012Metric

Connections:
3V3: C2.1, C3.1, C5.1; also elsewhere on the board
5V_LIMITED: C4.1, C6.1, C20.1, C21.1, C22.1; also elsewhere on the board
EN: C1.1; also elsewhere on the board
GND: C1.2, C2.2, C3.2, C4.2, C5.2, C6.2, C20.2, C21.2, C22.2; also elsewhere on the board

Notes on the sheet:
XORRPAD CORE - CONNECTIVITY REVIEW / P3
ENGINEERING DRAFT - A human PCB designer must review this before any order.
Reconstructed from SKiDL netlist. Named global nets connect every sheet; source-open pins remain open.

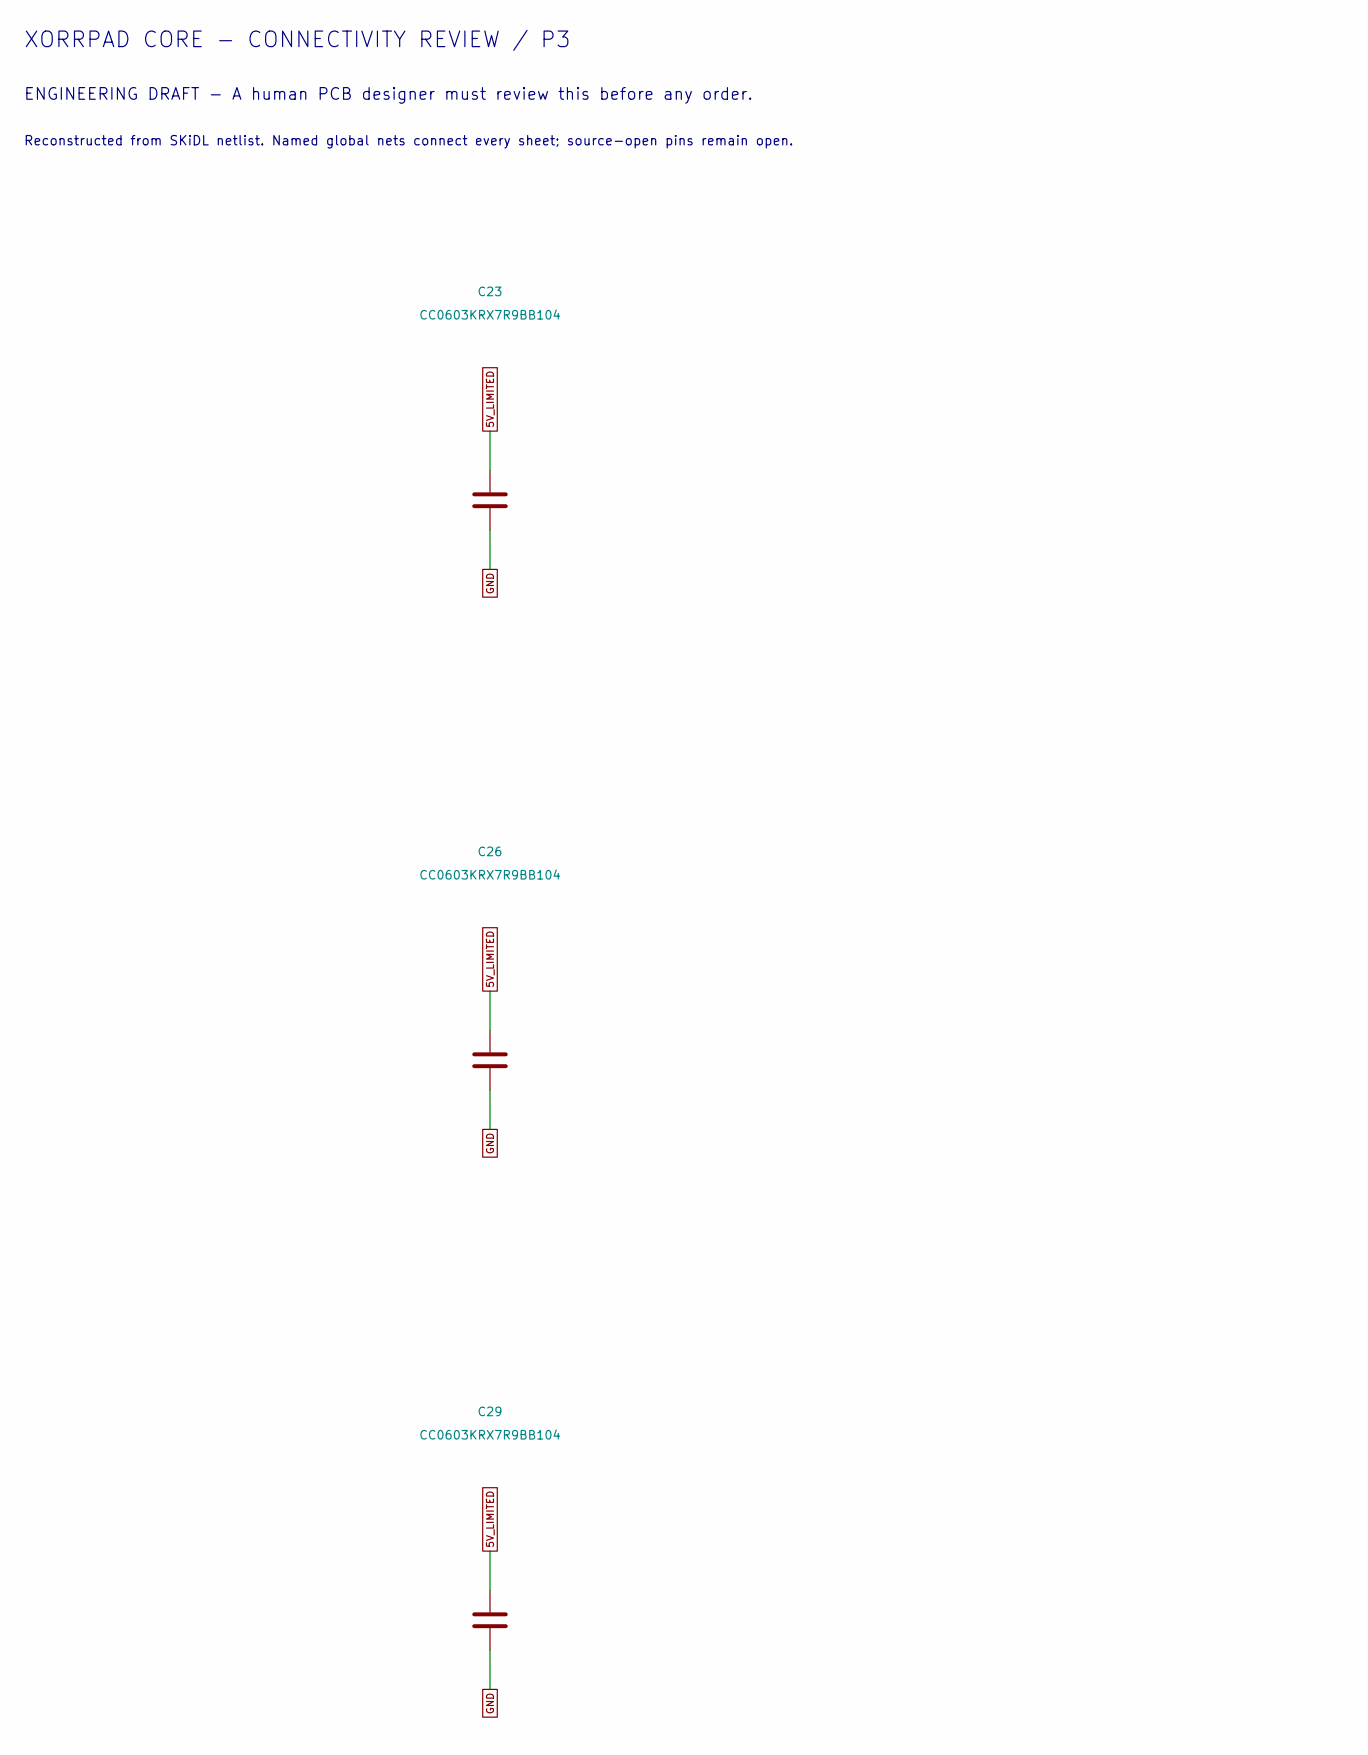
[picture p107: schematic core-review-03.kicad_sch, Xorrpad core connectivity review, part in row 1, column 1]

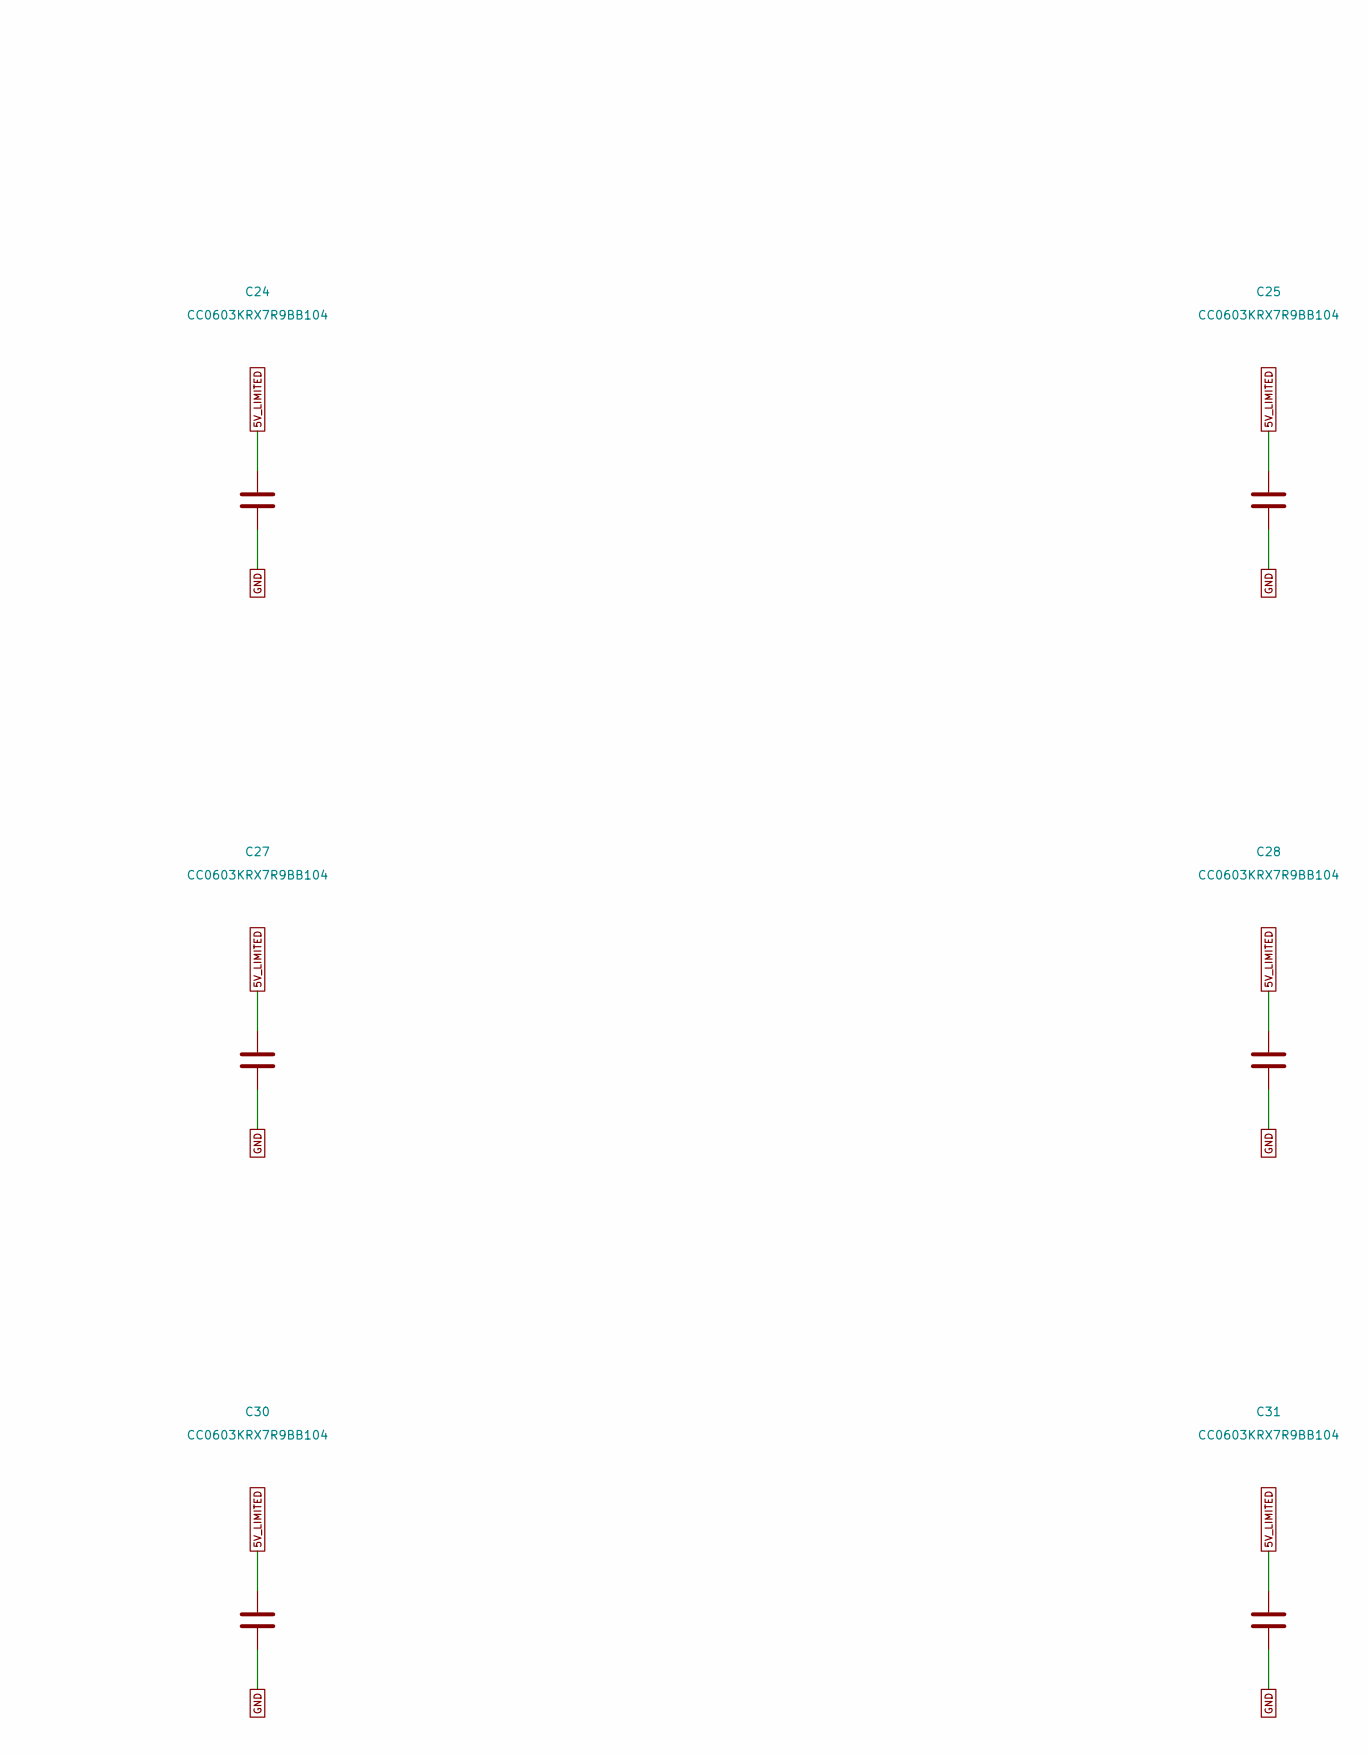
[picture p108: schematic core-review-03.kicad_sch, Xorrpad core connectivity review, part in row 1, column 2]

Parts:
C23, C24, C25, C26, C27, C28, C29, C30, C31: CC0603KRX7R9BB104; C_0603_1608Metric

Connections:
5V_LIMITED: C23.1, C24.1, C25.1, C26.1, C27.1, C28.1, C29.1, C30.1, C31.1; also elsewhere on the board
GND: C23.2, C24.2, C25.2, C26.2, C27.2, C28.2, C29.2, C30.2, C31.2; also elsewhere on the board

Notes on the sheet:
XORRPAD CORE - CONNECTIVITY REVIEW / P3
ENGINEERING DRAFT - A human PCB designer must review this before any order.
Reconstructed from SKiDL netlist. Named global nets connect every sheet; source-open pins remain open.

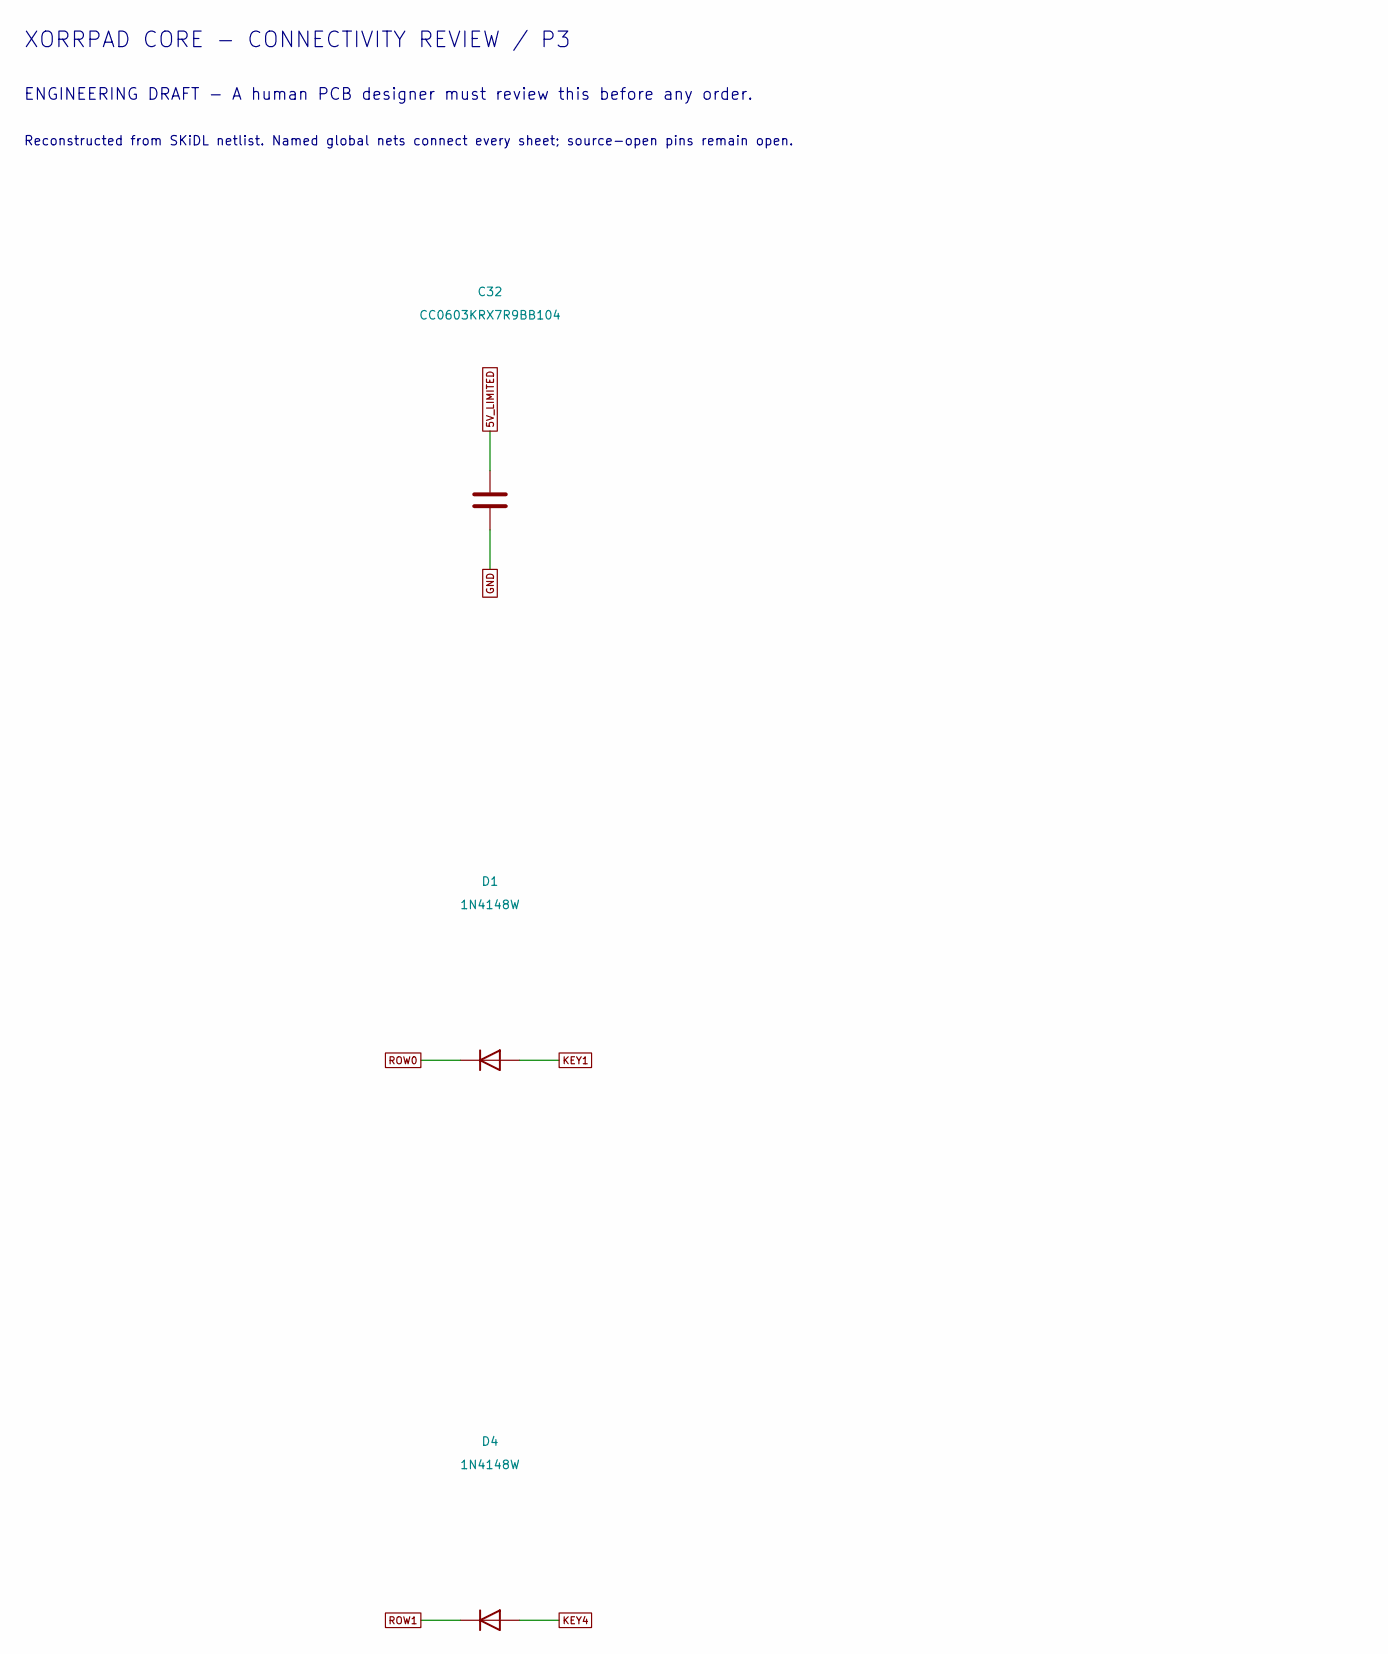
[picture p109: schematic core-review-04.kicad_sch, Xorrpad core connectivity review, part in row 1, column 1]

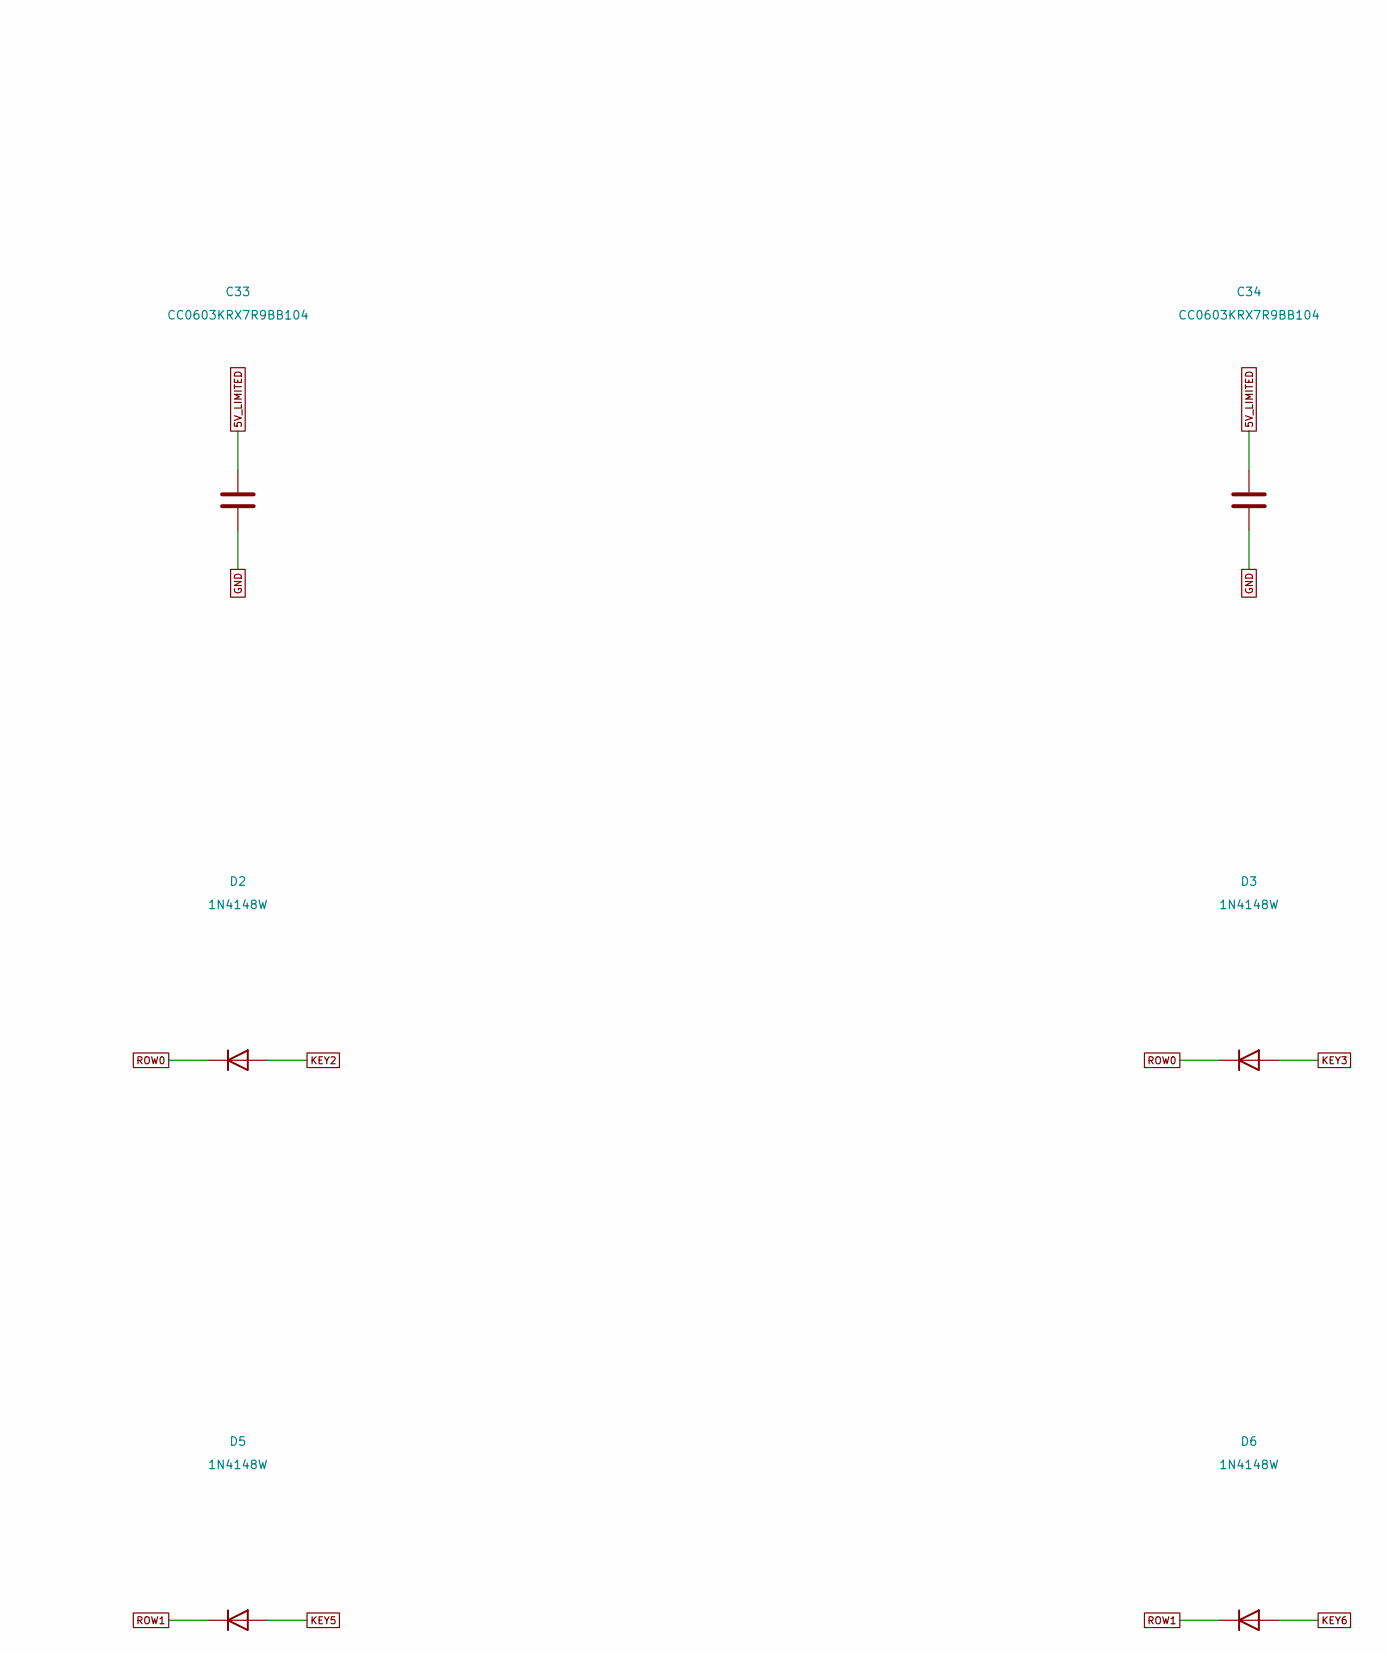
[picture p110: schematic core-review-04.kicad_sch, Xorrpad core connectivity review, part in row 1, column 2]

Parts:
C32, C33, C34: CC0603KRX7R9BB104; C_0603_1608Metric
D1, D2, D3, D4, D5, D6: 1N4148W; D_SOD-123

Connections:
5V_LIMITED: C32.1, C33.1, C34.1; also elsewhere on the board
GND: C32.2, C33.2, C34.2; also elsewhere on the board
KEY1: D1.2 (A); also elsewhere on the board
KEY2: D2.2 (A); also elsewhere on the board
KEY3: D3.2 (A); also elsewhere on the board
KEY4: D4.2 (A); also elsewhere on the board
KEY5: D5.2 (A); also elsewhere on the board
KEY6: D6.2 (A); also elsewhere on the board
ROW0: D1.1 (K), D2.1 (K), D3.1 (K); also elsewhere on the board
ROW1: D4.1 (K), D5.1 (K), D6.1 (K); also elsewhere on the board

Notes on the sheet:
XORRPAD CORE - CONNECTIVITY REVIEW / P3
ENGINEERING DRAFT - A human PCB designer must review this before any order.
Reconstructed from SKiDL netlist. Named global nets connect every sheet; source-open pins remain open.

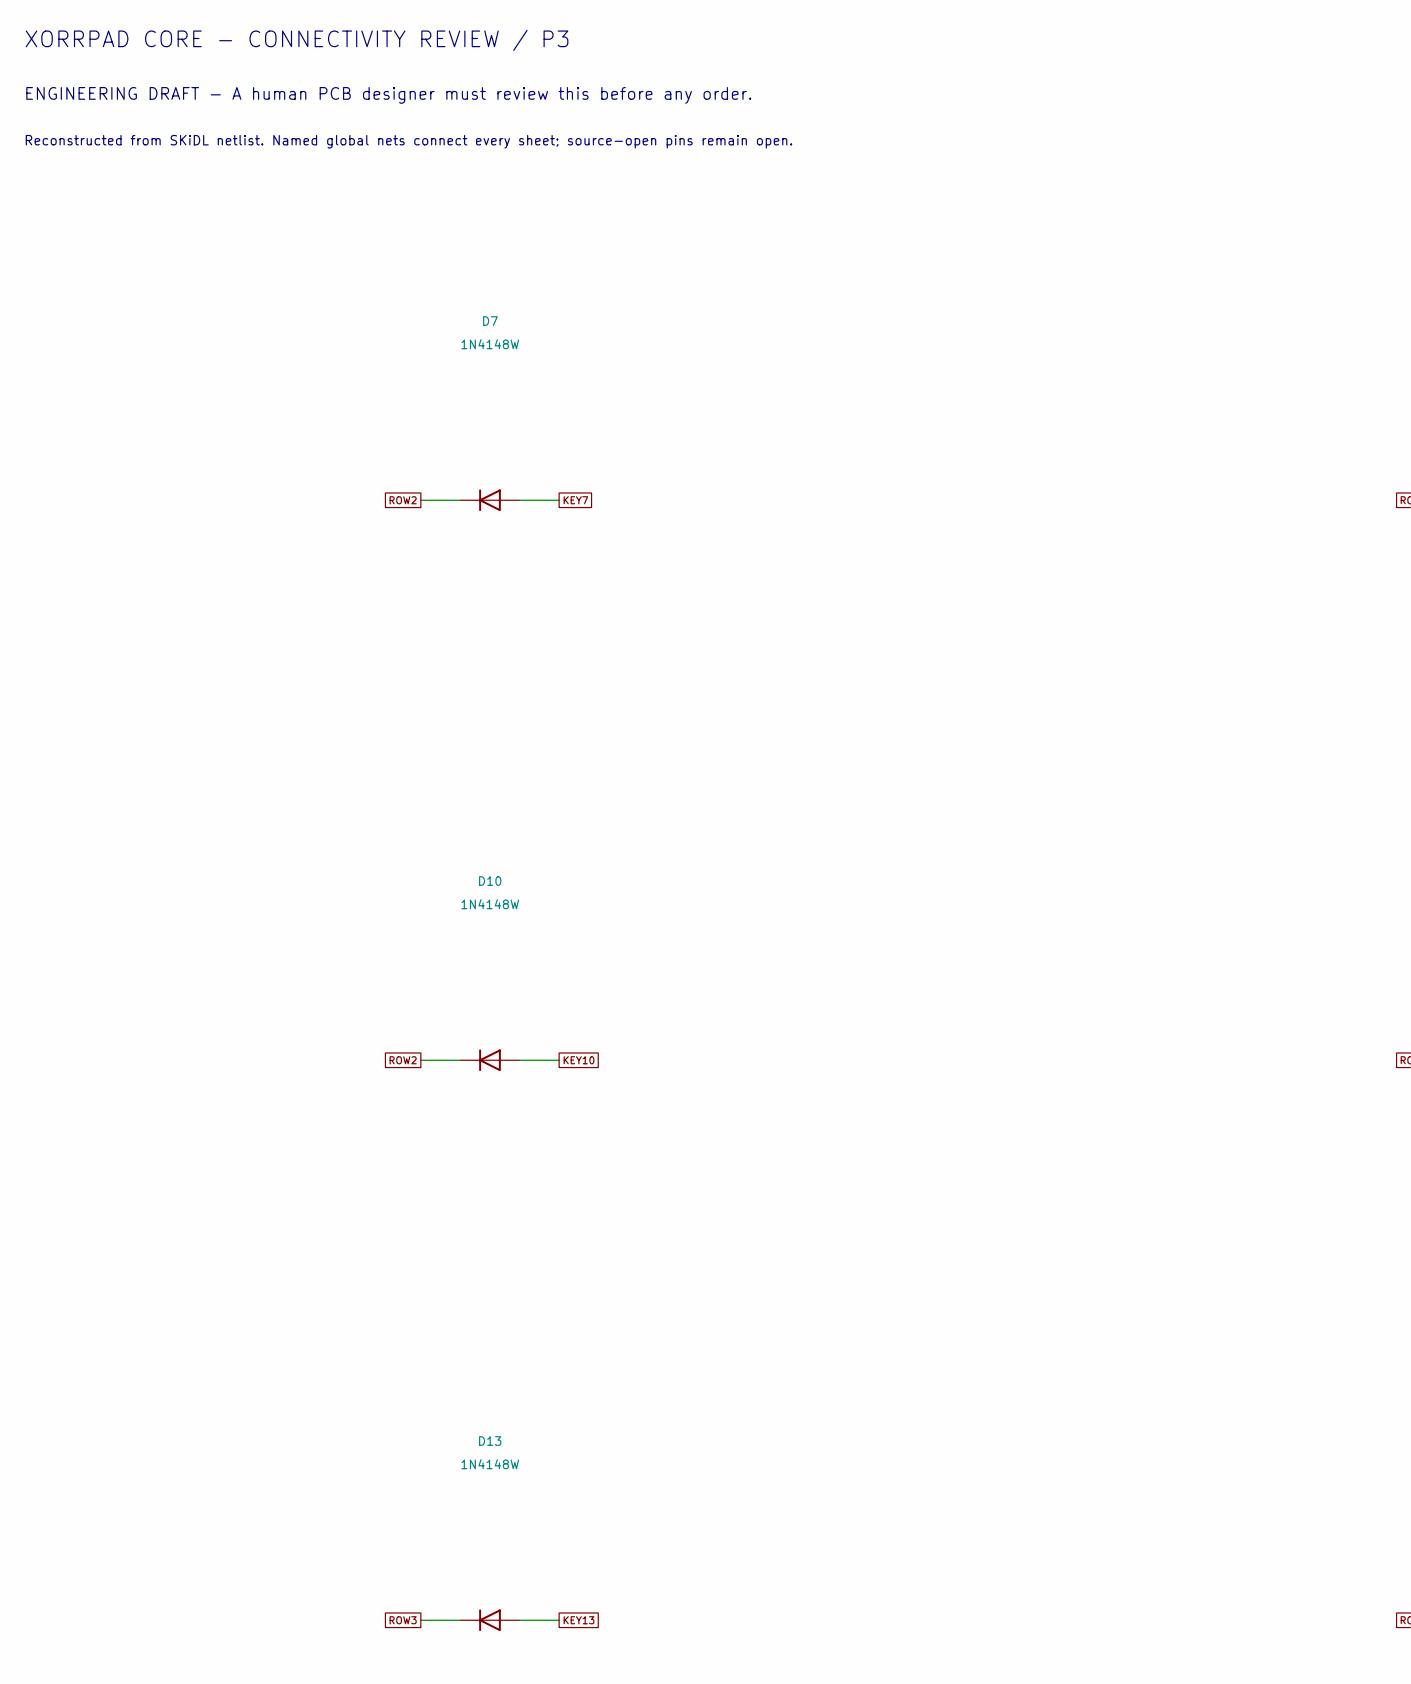
[picture p111: schematic core-review-05.kicad_sch, Xorrpad core connectivity review, part in row 1, column 1]

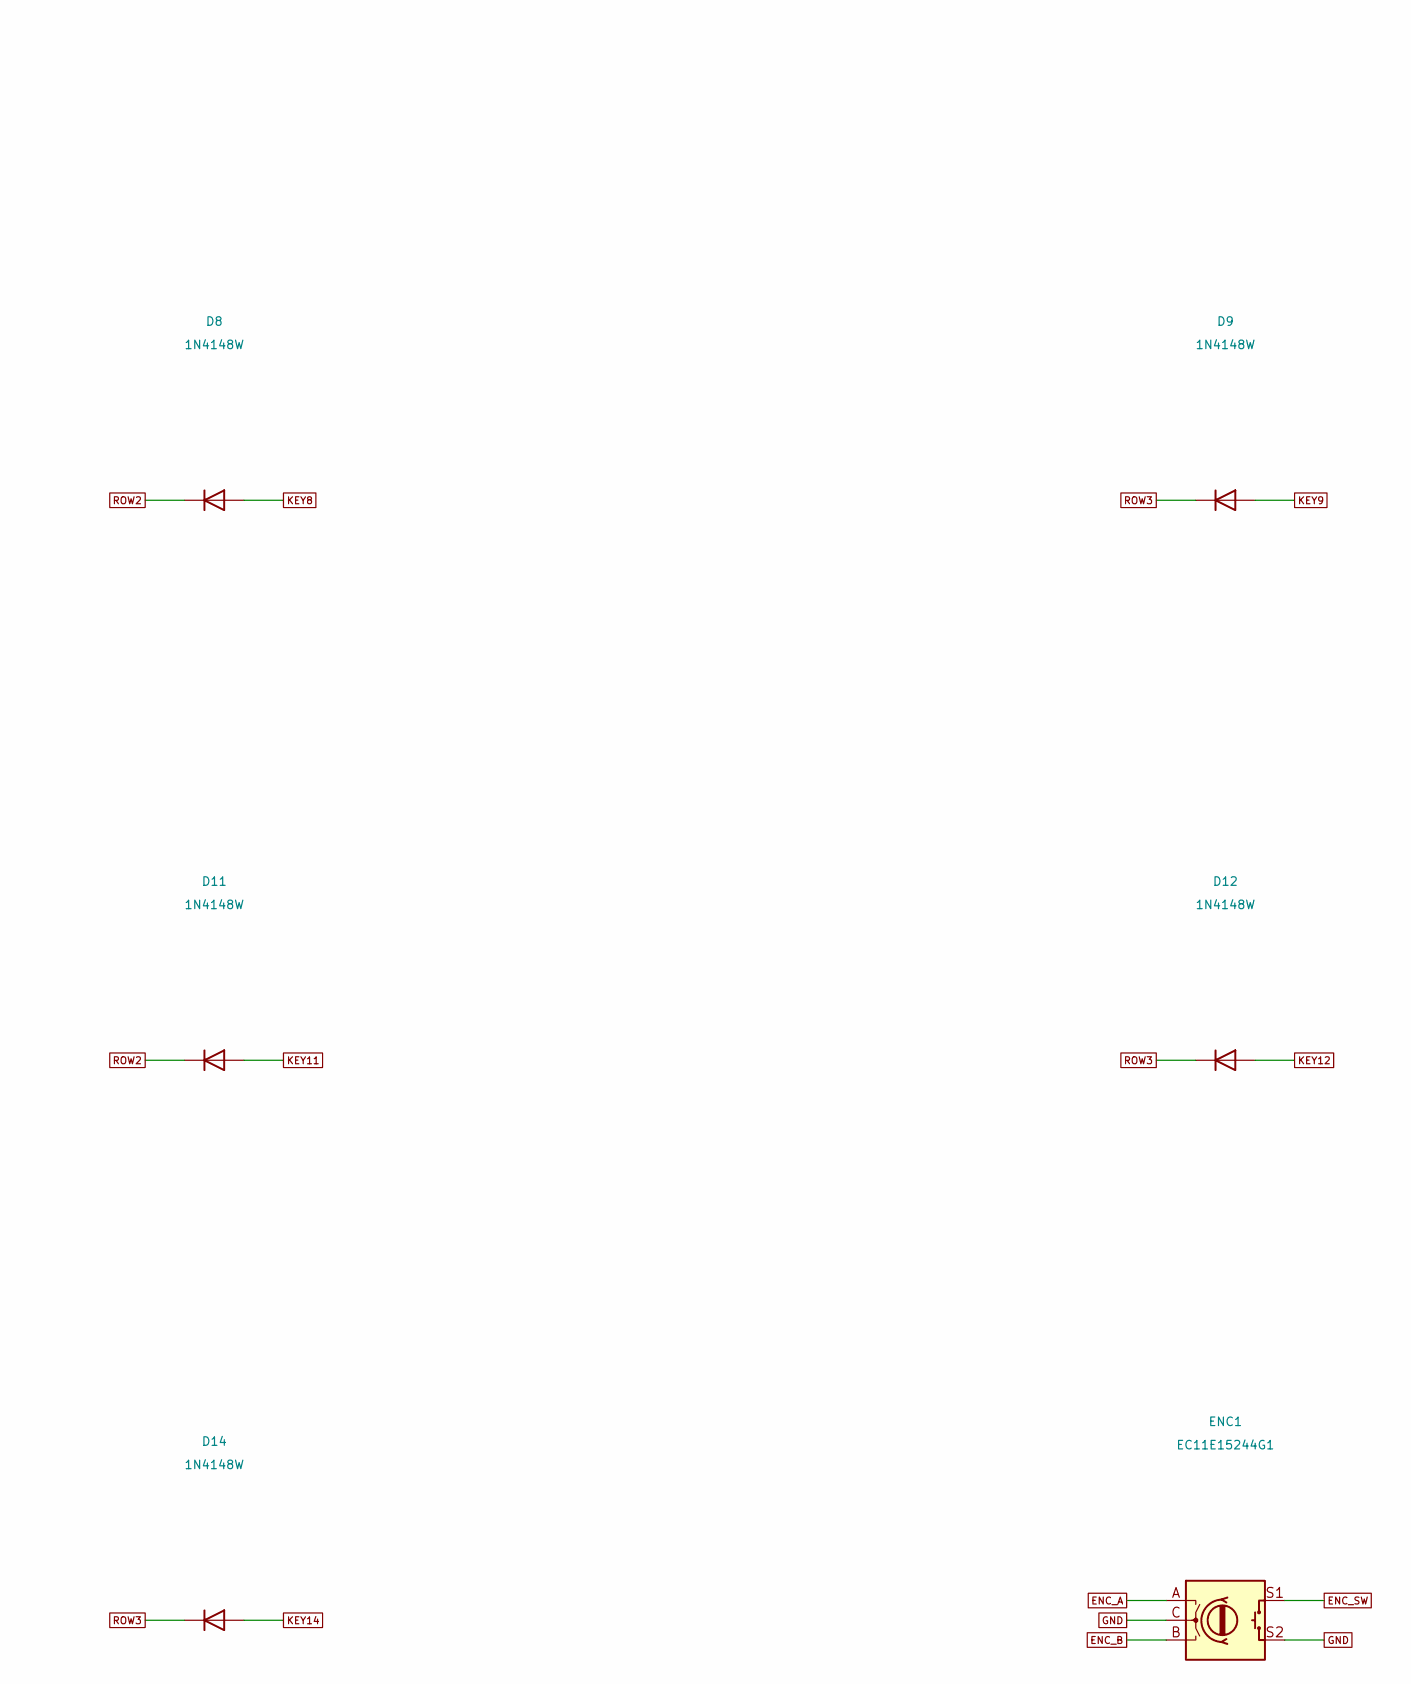
[picture p112: schematic core-review-05.kicad_sch, Xorrpad core connectivity review, part in row 1, column 2]

Parts:
D7, D8, D9, D10, D11, D12, D13, D14: 1N4148W; D_SOD-123
ENC1: EC11E15244G1; RotaryEncoder_Alps_EC11E-Switch_Vertical_H20mm

Connections:
ENC_A: ENC1.A; also elsewhere on the board
ENC_B: ENC1.B; also elsewhere on the board
ENC_SW: ENC1.S1; also elsewhere on the board
GND: ENC1.C, ENC1.S2; also elsewhere on the board
KEY7: D7.2 (A); also elsewhere on the board
KEY8: D8.2 (A); also elsewhere on the board
KEY9: D9.2 (A); also elsewhere on the board
KEY10: D10.2 (A); also elsewhere on the board
KEY11: D11.2 (A); also elsewhere on the board
KEY12: D12.2 (A); also elsewhere on the board
KEY13: D13.2 (A); also elsewhere on the board
KEY14: D14.2 (A); also elsewhere on the board
ROW2: D7.1 (K), D8.1 (K), D10.1 (K), D11.1 (K); also elsewhere on the board
ROW3: D9.1 (K), D12.1 (K), D13.1 (K), D14.1 (K); also elsewhere on the board

Notes on the sheet:
XORRPAD CORE - CONNECTIVITY REVIEW / P3
ENGINEERING DRAFT - A human PCB designer must review this before any order.
Reconstructed from SKiDL netlist. Named global nets connect every sheet; source-open pins remain open.
