nickthelegend/xorrpad/hardware/generated/core.kicad_pcb

## KiCad design hardware/generated/core.kicad_pcb (continued)

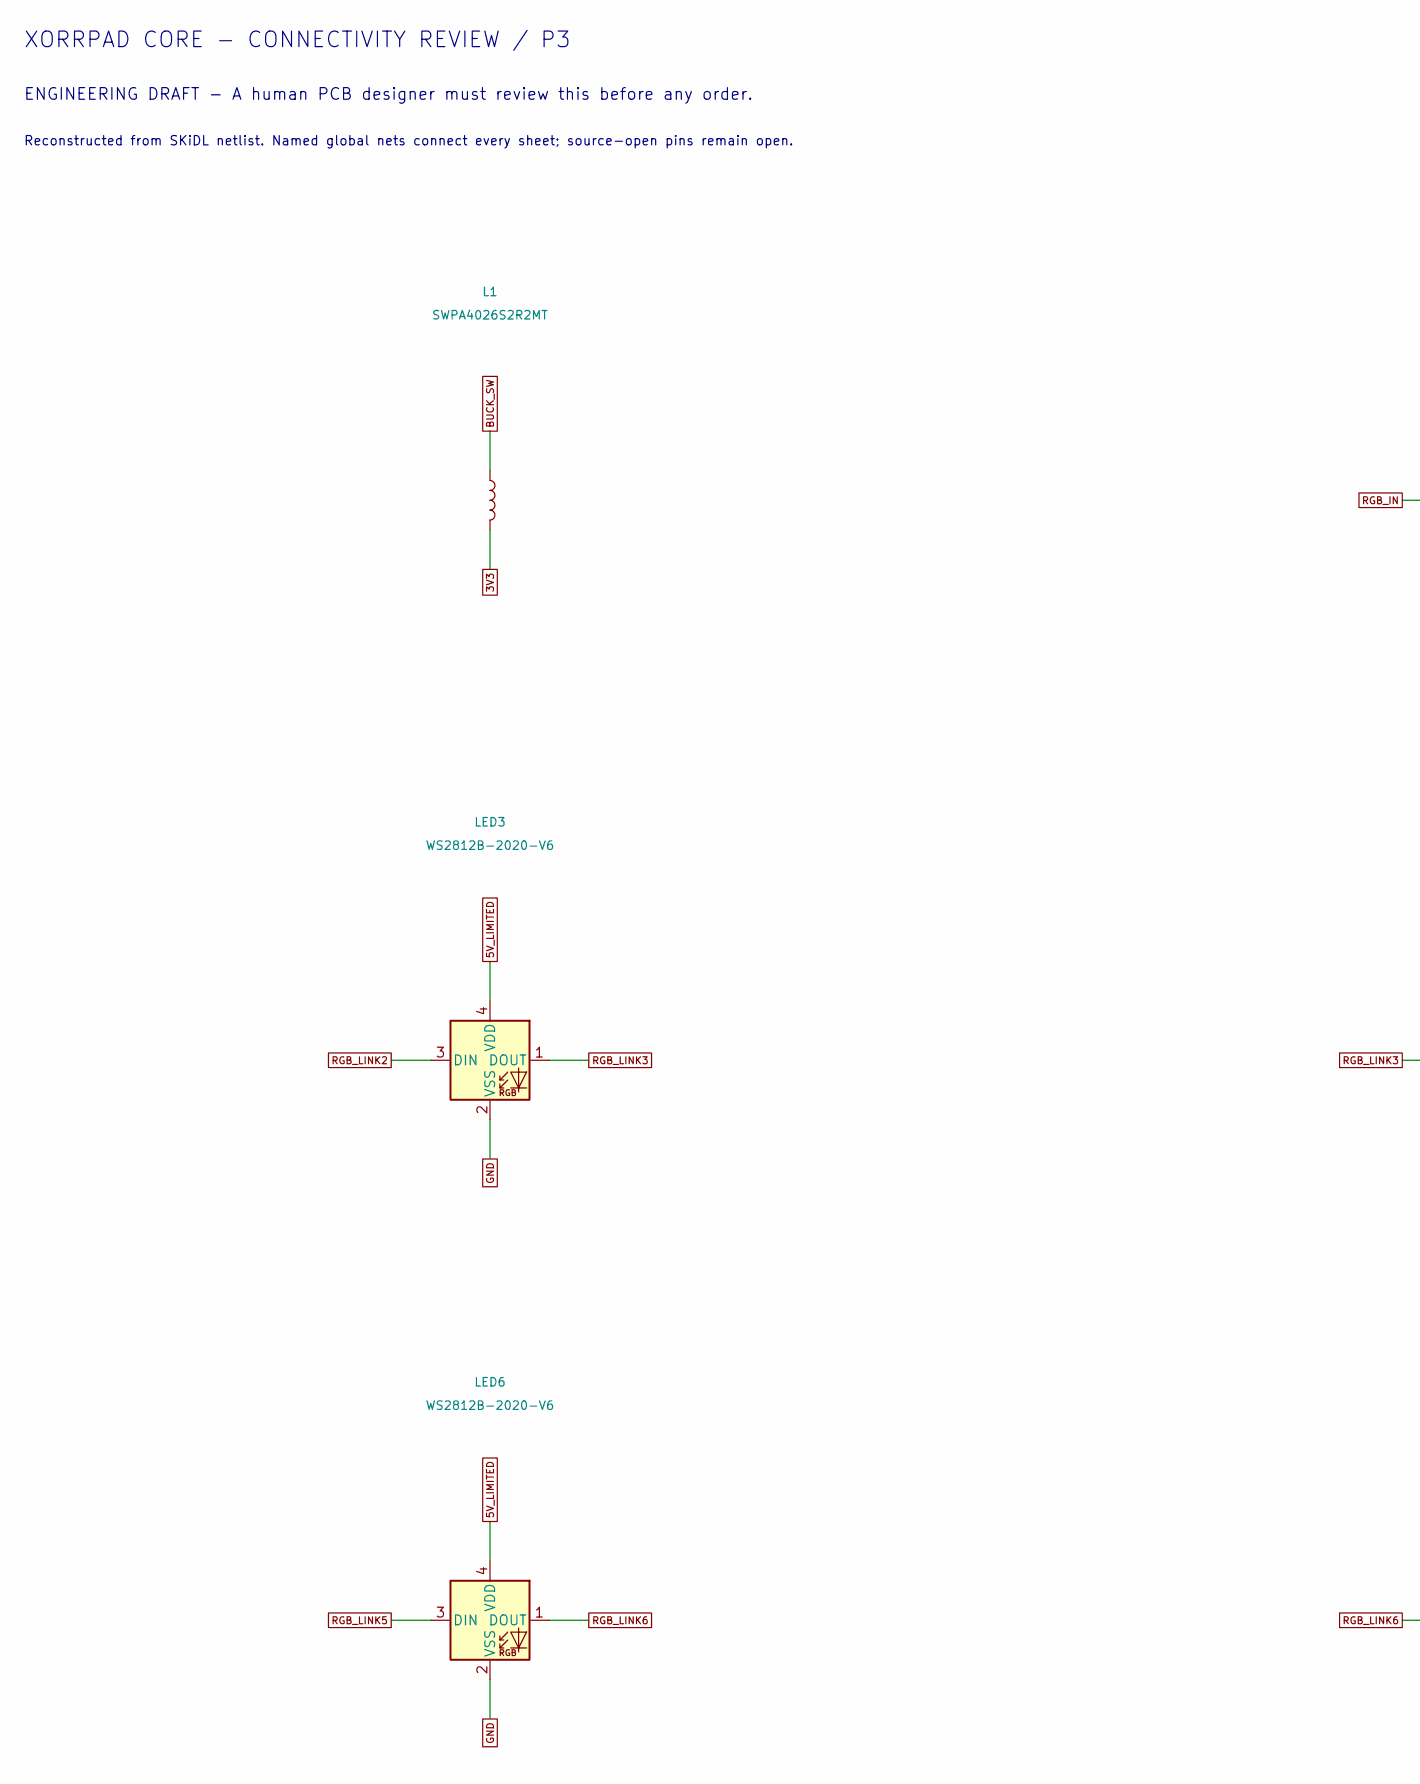
[picture p113: schematic core-review-06.kicad_sch, Xorrpad core connectivity review, part in row 1, column 1]

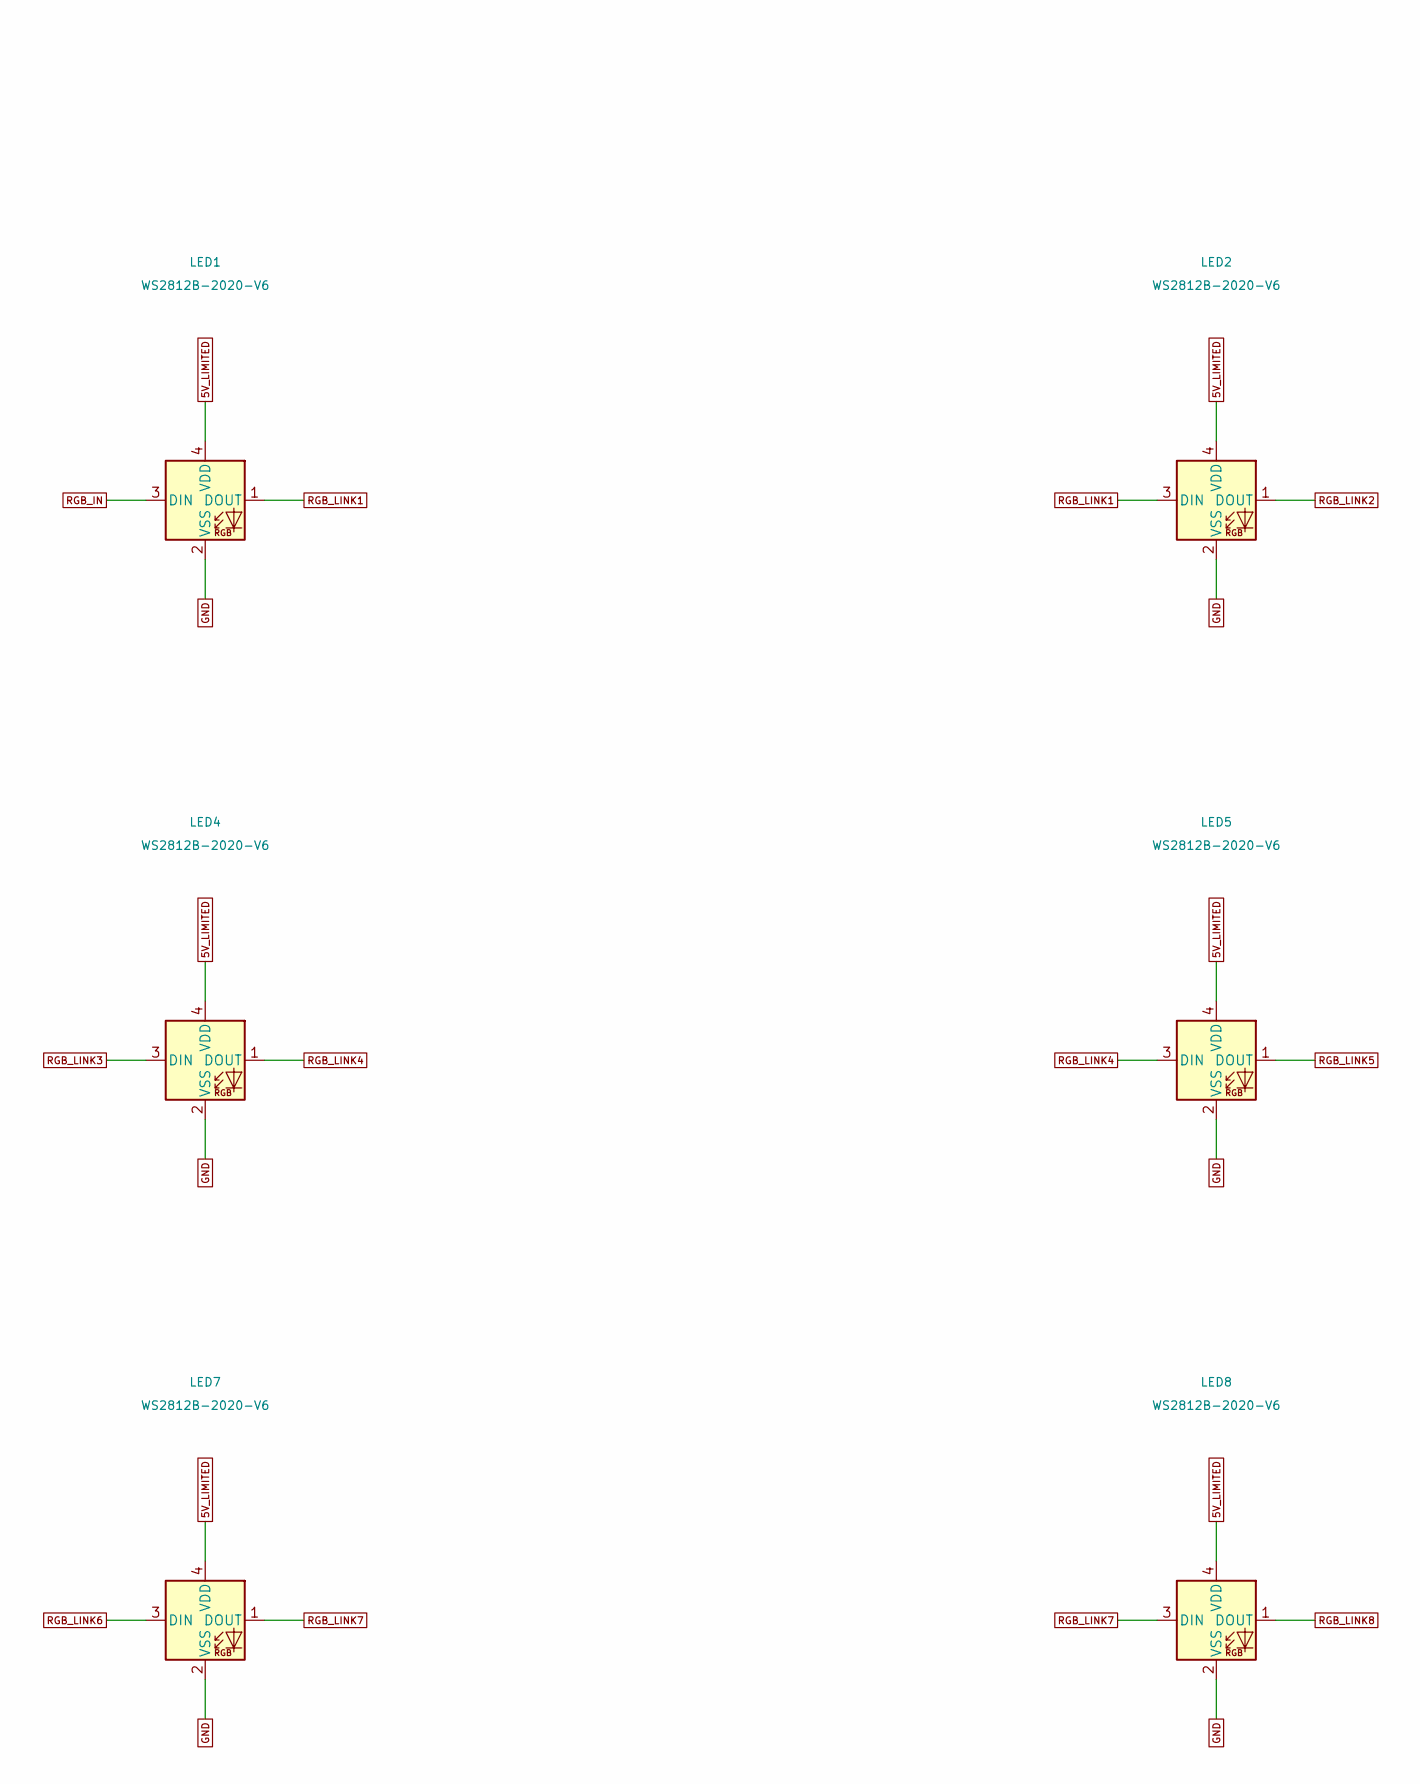
[picture p114: schematic core-review-06.kicad_sch, Xorrpad core connectivity review, part in row 1, column 2]

Parts:
L1: SWPA4026S2R2MT; L_Sunlord_SWPA4026S
LED1, LED2, LED3, LED4, LED5, LED6, LED7, LED8: WS2812B-2020-V6; LED_WS2812B-2020_PLCC4_2.0x2.0mm

Connections:
3V3: L1.2; also elsewhere on the board
5V_LIMITED: LED1.4 (VDD), LED2.4 (VDD), LED3.4 (VDD), LED4.4 (VDD), LED5.4 (VDD), LED6.4 (VDD), LED7.4 (VDD), LED8.4 (VDD); also elsewhere on the board
BUCK_SW: L1.1; also elsewhere on the board
GND: LED1.2 (VSS), LED2.2 (VSS), LED3.2 (VSS), LED4.2 (VSS), LED5.2 (VSS), LED6.2 (VSS), LED7.2 (VSS), LED8.2 (VSS); also elsewhere on the board
RGB_IN: LED1.3 (DIN); also elsewhere on the board
RGB_LINK1: LED1.1 (DOUT), LED2.3 (DIN)
RGB_LINK2: LED2.1 (DOUT), LED3.3 (DIN)
RGB_LINK3: LED3.1 (DOUT), LED4.3 (DIN)
RGB_LINK4: LED4.1 (DOUT), LED5.3 (DIN)
RGB_LINK5: LED5.1 (DOUT), LED6.3 (DIN)
RGB_LINK6: LED6.1 (DOUT), LED7.3 (DIN)
RGB_LINK7: LED7.1 (DOUT), LED8.3 (DIN)
RGB_LINK8: LED8.1 (DOUT); also elsewhere on the board

Notes on the sheet:
XORRPAD CORE - CONNECTIVITY REVIEW / P3
ENGINEERING DRAFT - A human PCB designer must review this before any order.
Reconstructed from SKiDL netlist. Named global nets connect every sheet; source-open pins remain open.

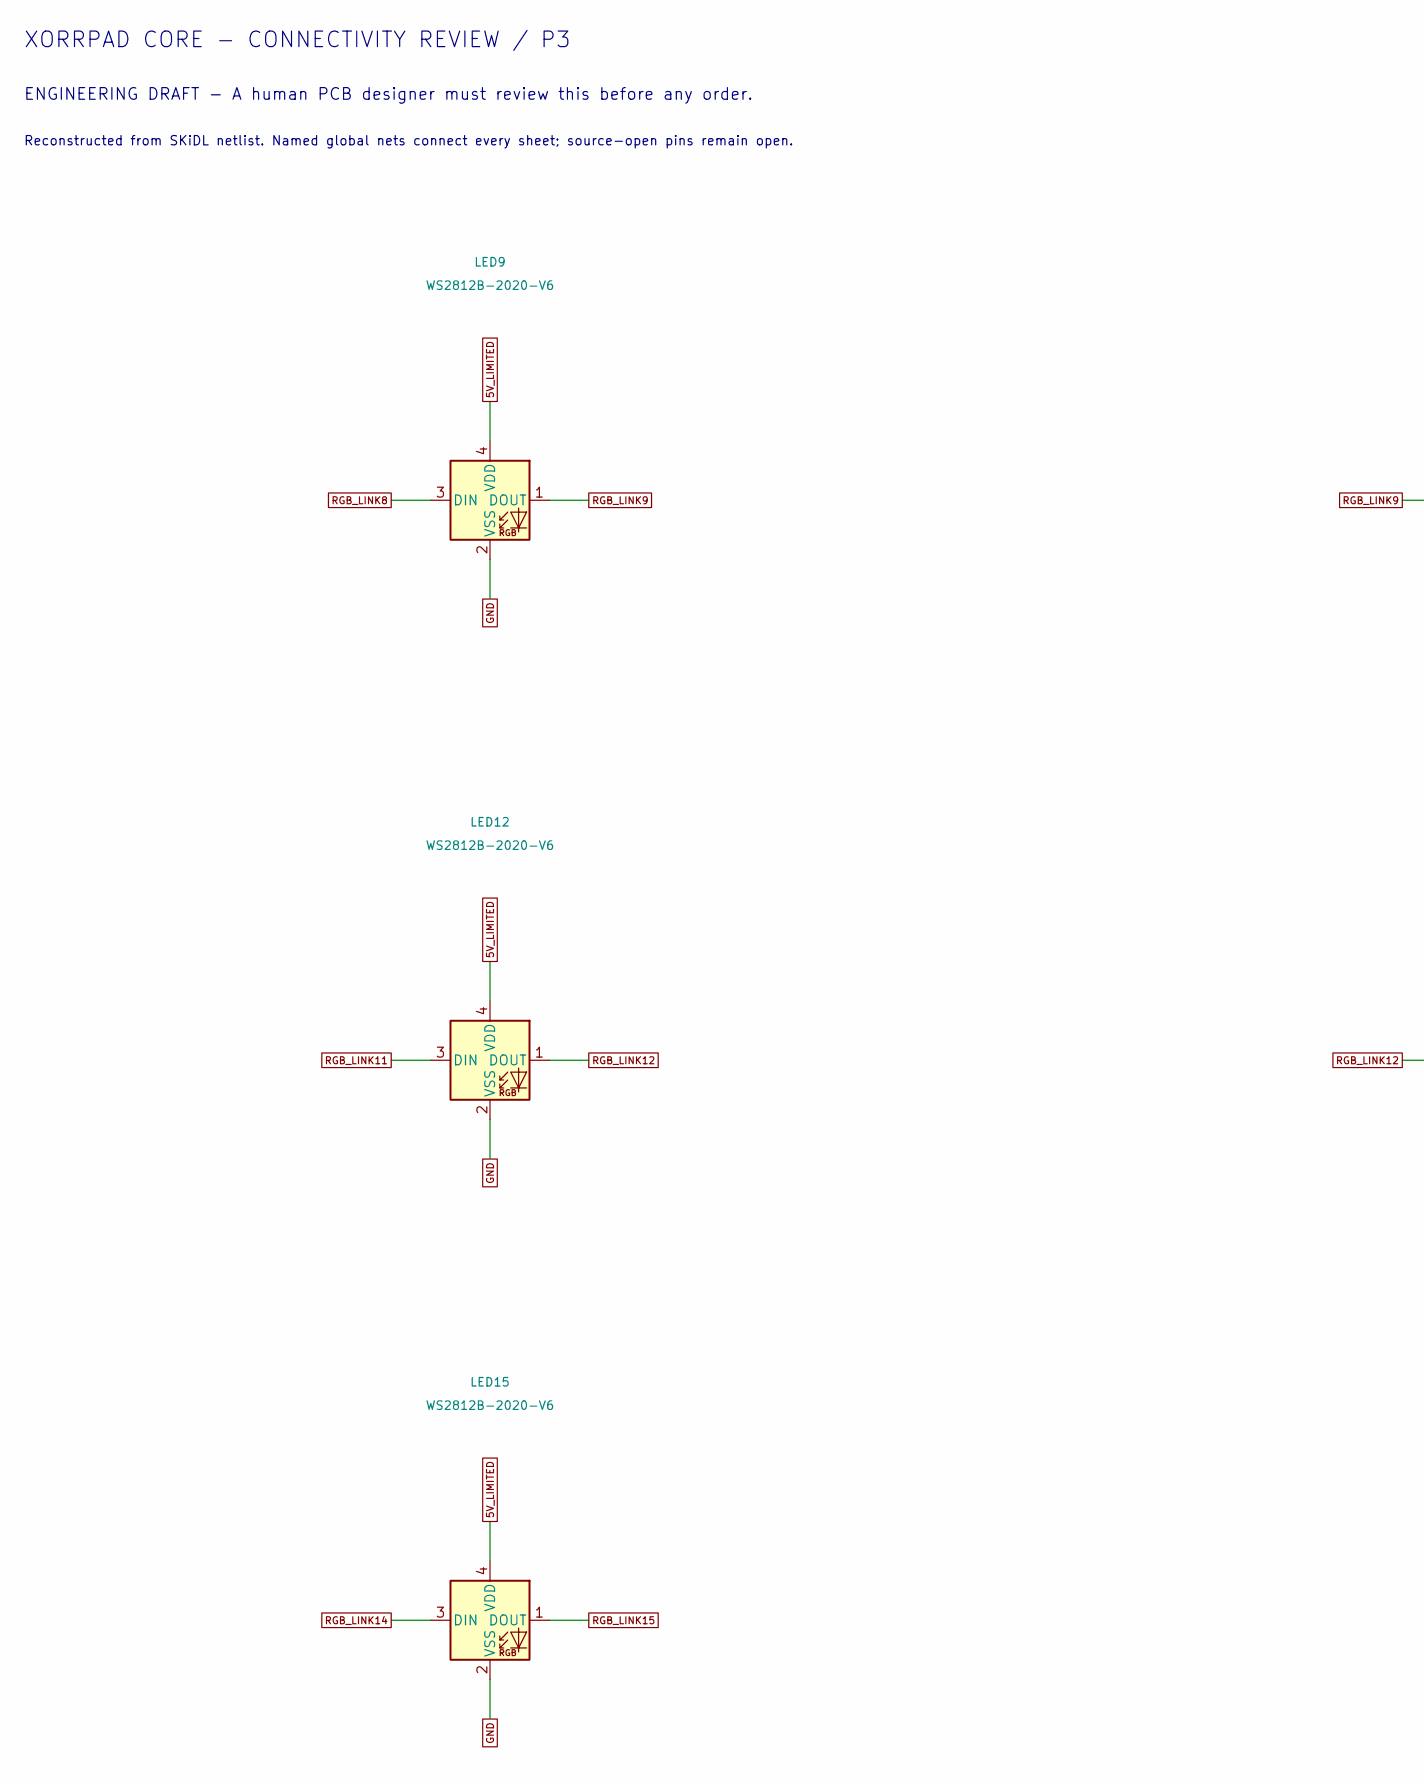
[picture p115: schematic core-review-07.kicad_sch, Xorrpad core connectivity review, part in row 1, column 1]

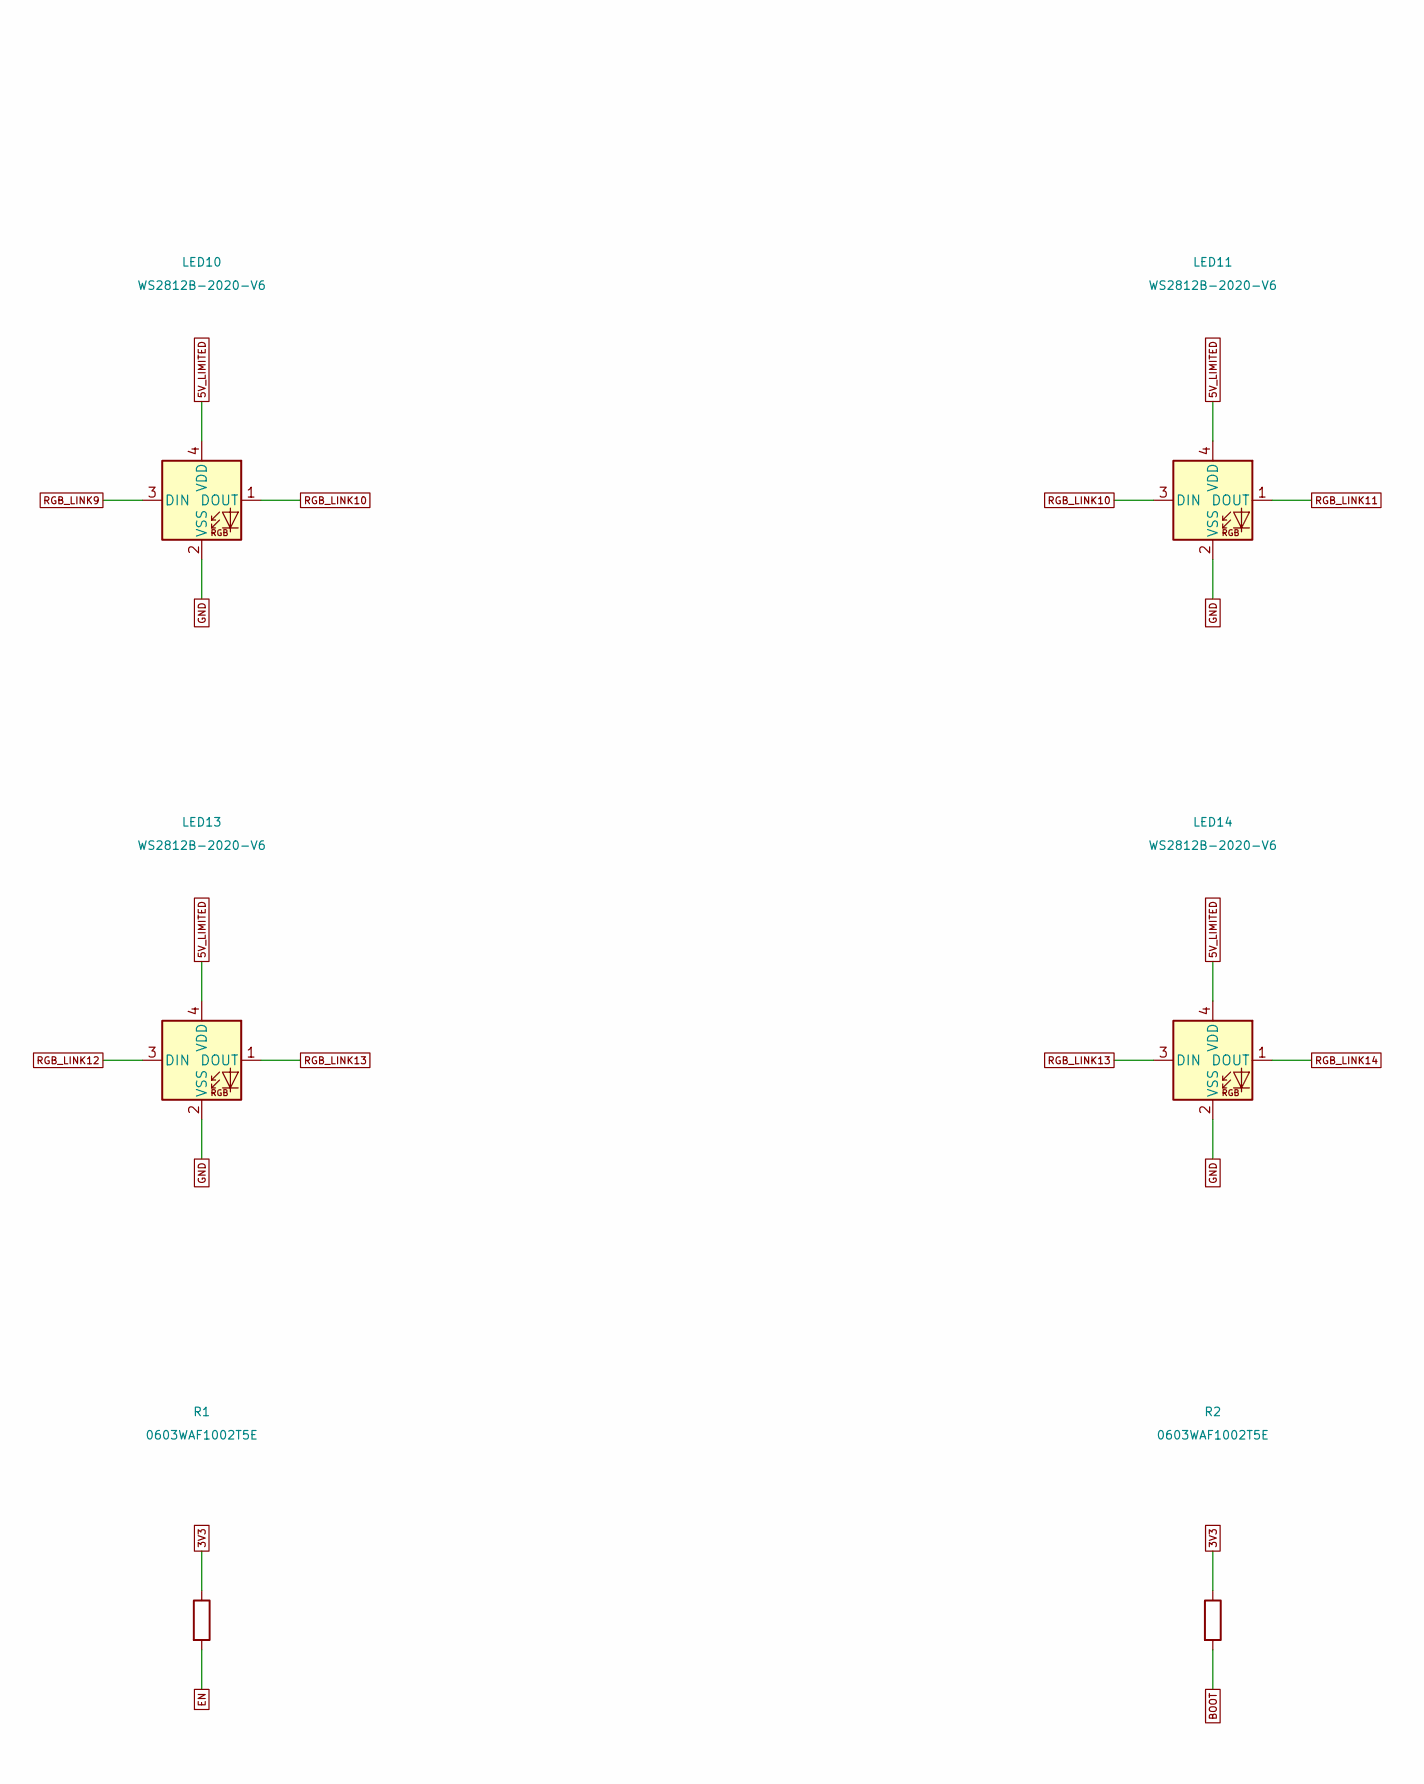
[picture p116: schematic core-review-07.kicad_sch, Xorrpad core connectivity review, part in row 1, column 2]

Parts:
LED9, LED10, LED11, LED12, LED13, LED14, LED15: WS2812B-2020-V6; LED_WS2812B-2020_PLCC4_2.0x2.0mm
R1, R2: 0603WAF1002T5E; R_0603_1608Metric

Connections:
3V3: R1.1, R2.1; also elsewhere on the board
5V_LIMITED: LED9.4 (VDD), LED10.4 (VDD), LED11.4 (VDD), LED12.4 (VDD), LED13.4 (VDD), LED14.4 (VDD), LED15.4 (VDD); also elsewhere on the board
BOOT: R2.2; also elsewhere on the board
EN: R1.2; also elsewhere on the board
GND: LED9.2 (VSS), LED10.2 (VSS), LED11.2 (VSS), LED12.2 (VSS), LED13.2 (VSS), LED14.2 (VSS), LED15.2 (VSS); also elsewhere on the board
RGB_LINK8: LED9.3 (DIN); also elsewhere on the board
RGB_LINK9: LED9.1 (DOUT), LED10.3 (DIN)
RGB_LINK10: LED10.1 (DOUT), LED11.3 (DIN)
RGB_LINK11: LED11.1 (DOUT), LED12.3 (DIN)
RGB_LINK12: LED12.1 (DOUT), LED13.3 (DIN)
RGB_LINK13: LED13.1 (DOUT), LED14.3 (DIN)
RGB_LINK14: LED14.1 (DOUT), LED15.3 (DIN)
RGB_LINK15: LED15.1 (DOUT)

Notes on the sheet:
XORRPAD CORE - CONNECTIVITY REVIEW / P3
ENGINEERING DRAFT - A human PCB designer must review this before any order.
Reconstructed from SKiDL netlist. Named global nets connect every sheet; source-open pins remain open.

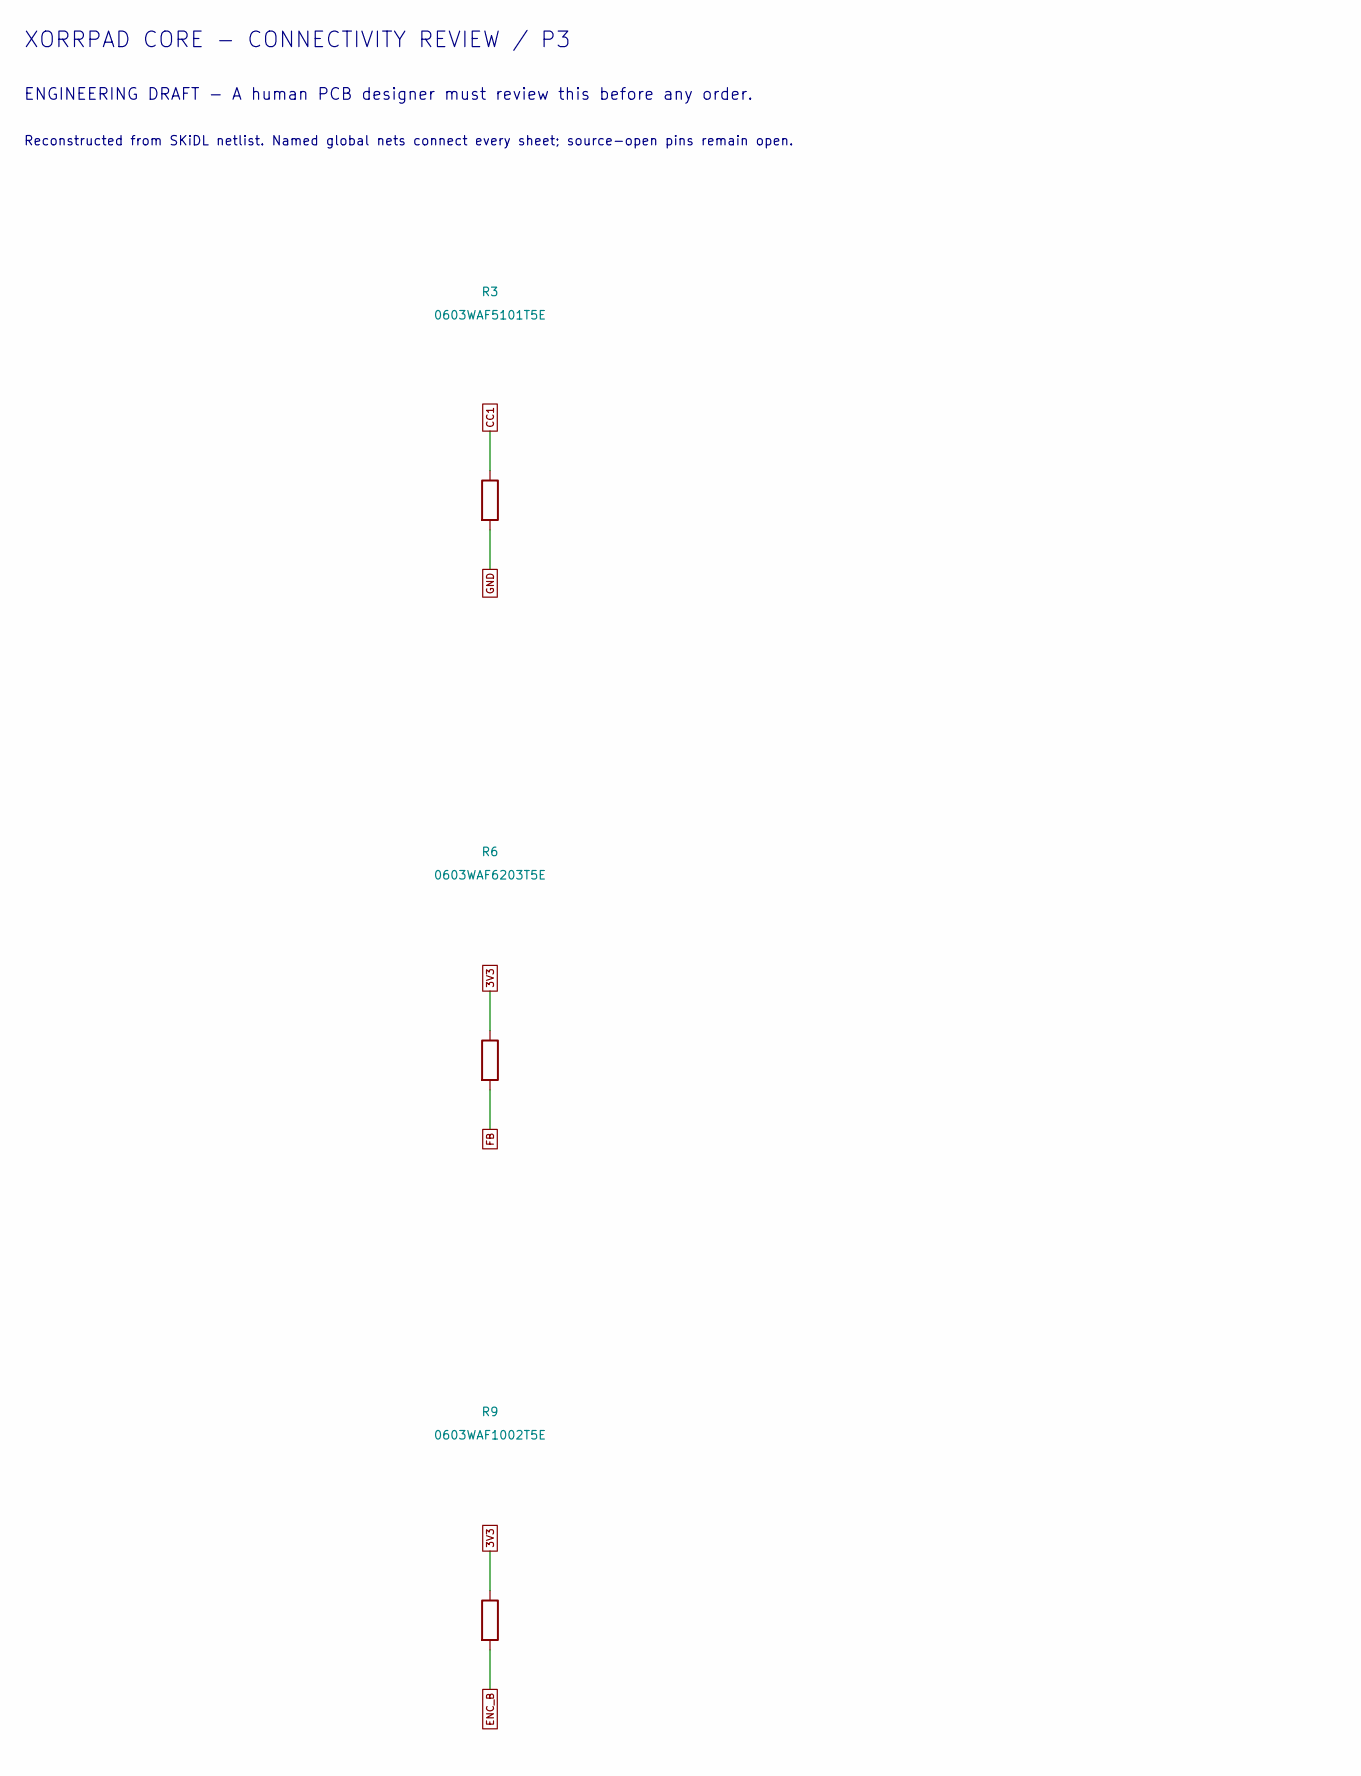
[picture p117: schematic core-review-08.kicad_sch, Xorrpad core connectivity review, part in row 1, column 1]

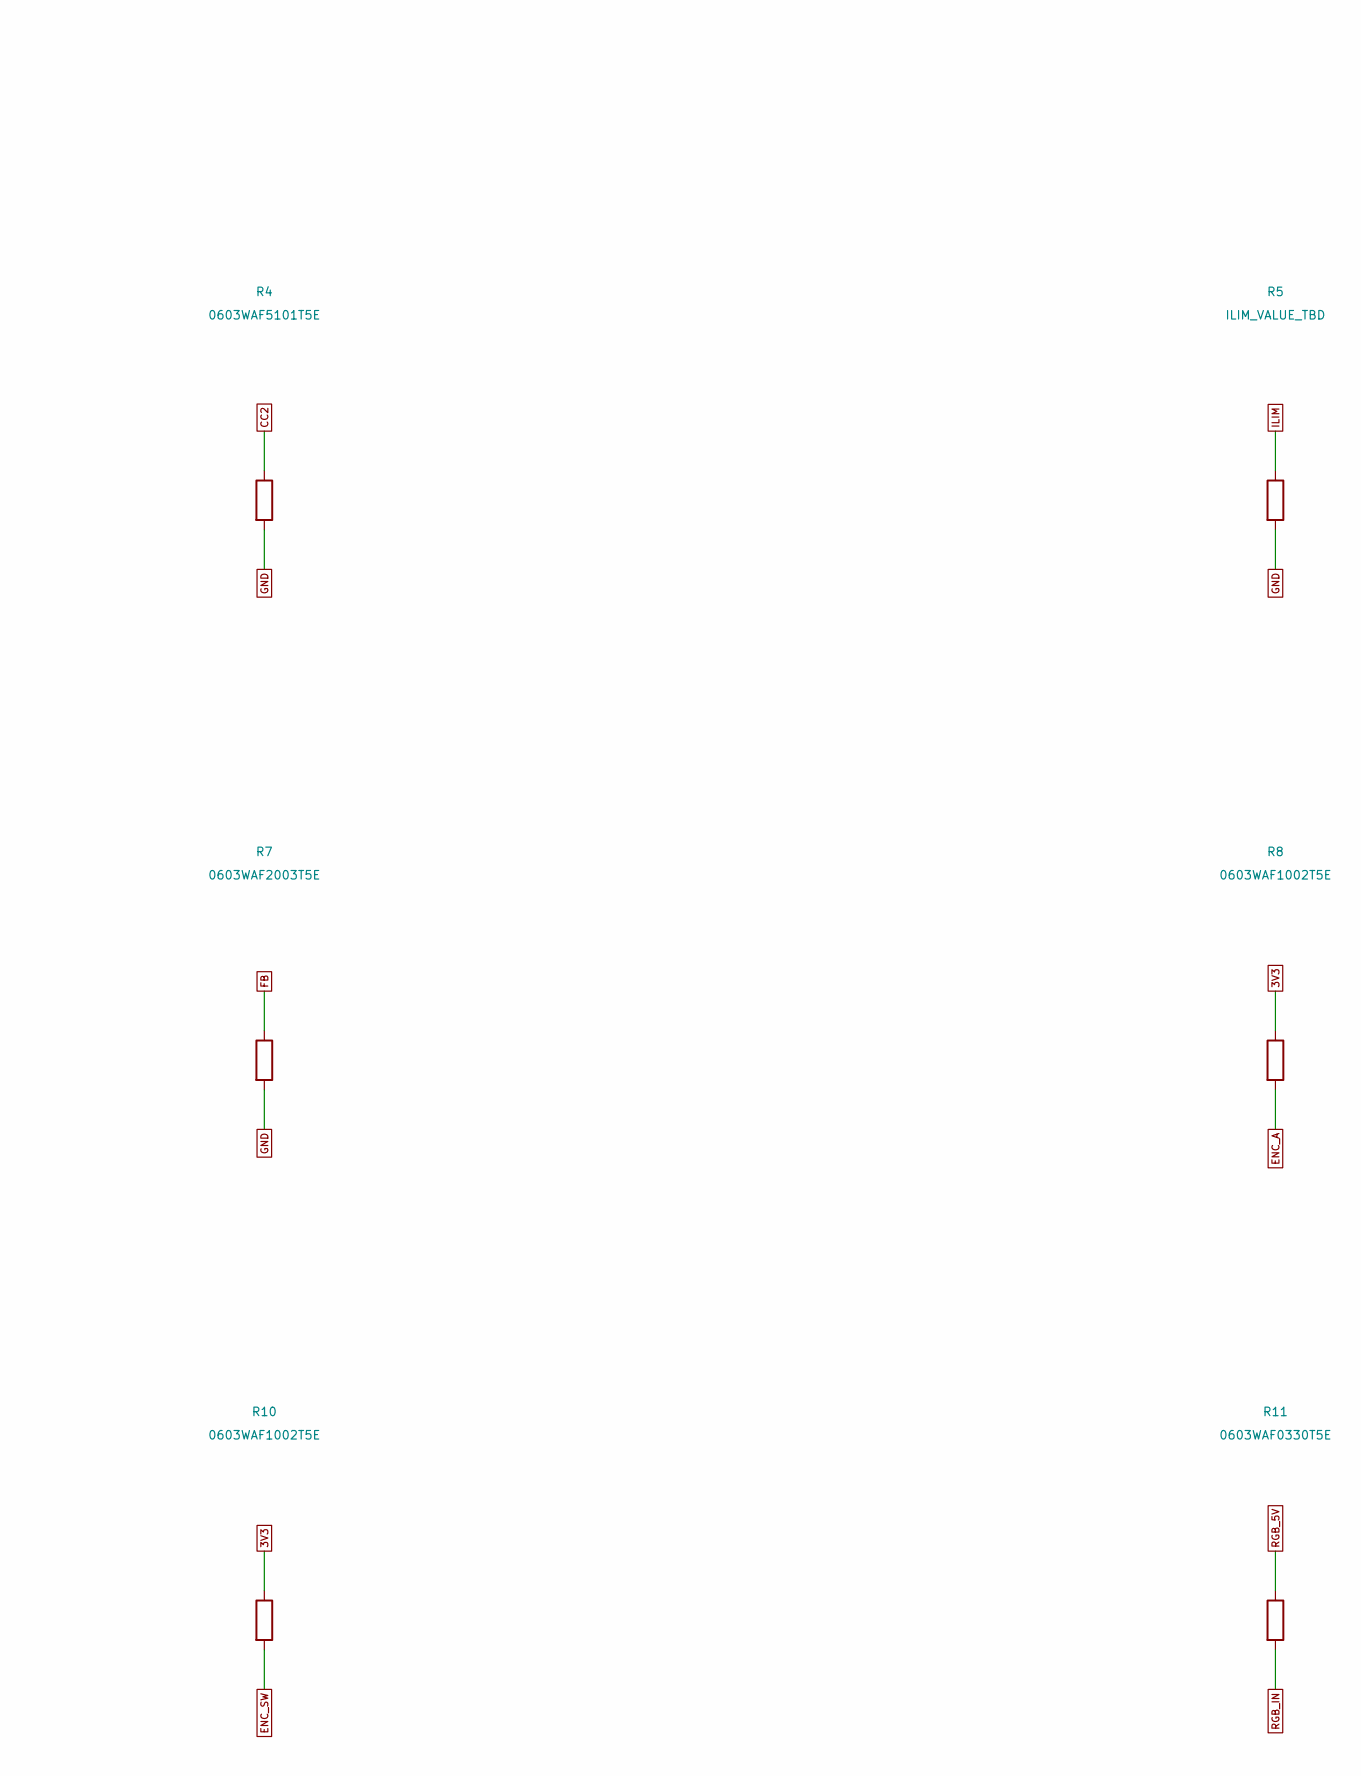
[picture p118: schematic core-review-08.kicad_sch, Xorrpad core connectivity review, part in row 1, column 2]

Parts:
R3, R4: 0603WAF5101T5E; R_0603_1608Metric
R5: ILIM_VALUE_TBD; R_0603_1608Metric
R6: 0603WAF6203T5E; R_0603_1608Metric
R7: 0603WAF2003T5E; R_0603_1608Metric
R8, R9, R10: 0603WAF1002T5E; R_0603_1608Metric
R11: 0603WAF0330T5E; R_0603_1608Metric

Connections:
3V3: R6.1, R8.1, R9.1, R10.1; also elsewhere on the board
CC1: R3.1; also elsewhere on the board
CC2: R4.1; also elsewhere on the board
ENC_A: R8.2; also elsewhere on the board
ENC_B: R9.2; also elsewhere on the board
ENC_SW: R10.2; also elsewhere on the board
FB: R6.2, R7.1; also elsewhere on the board
GND: R3.2, R4.2, R5.2, R7.2; also elsewhere on the board
ILIM: R5.1; also elsewhere on the board
RGB_5V: R11.1; also elsewhere on the board
RGB_IN: R11.2; also elsewhere on the board

Notes on the sheet:
XORRPAD CORE - CONNECTIVITY REVIEW / P3
ENGINEERING DRAFT - A human PCB designer must review this before any order.
Reconstructed from SKiDL netlist. Named global nets connect every sheet; source-open pins remain open.

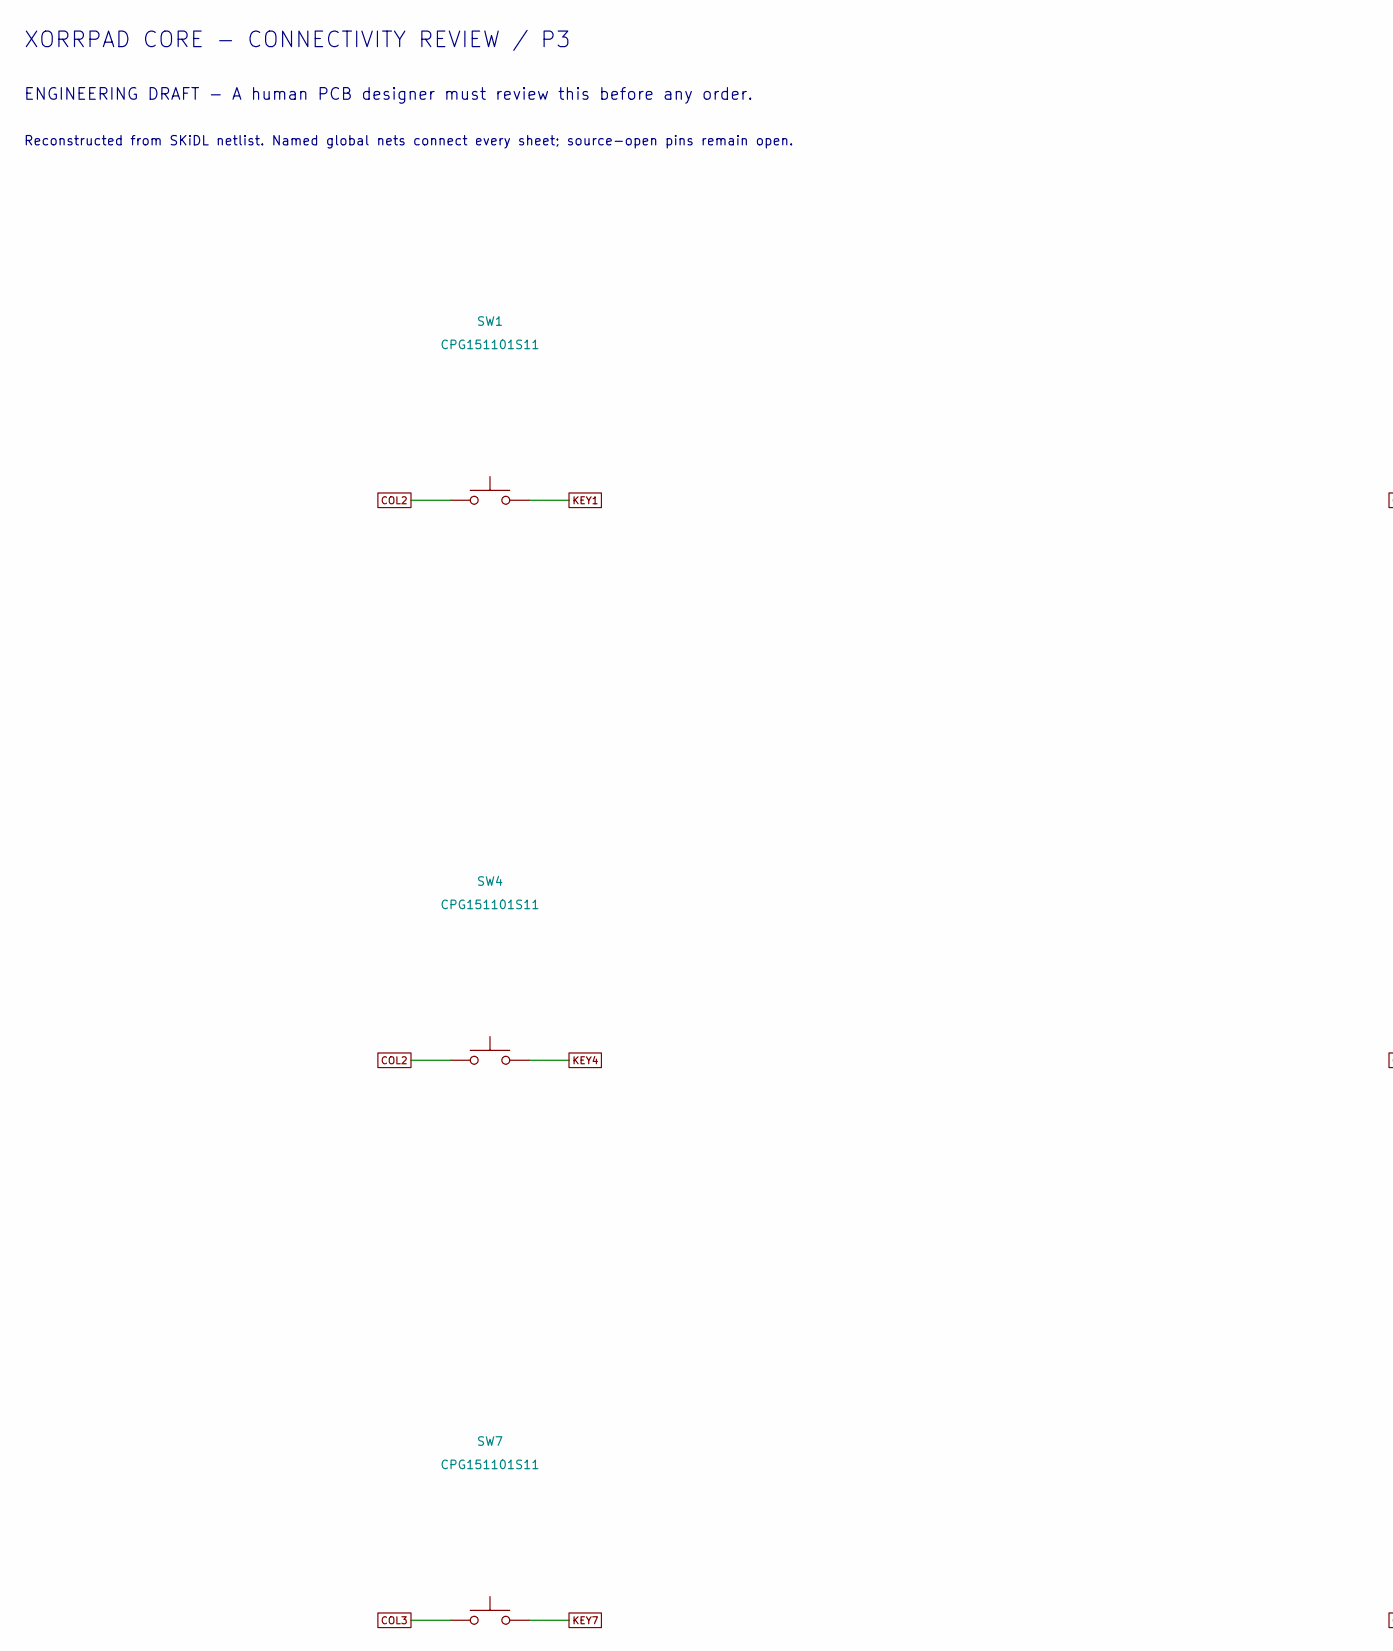
[picture p119: schematic core-review-09.kicad_sch, Xorrpad core connectivity review, part in row 1, column 1]

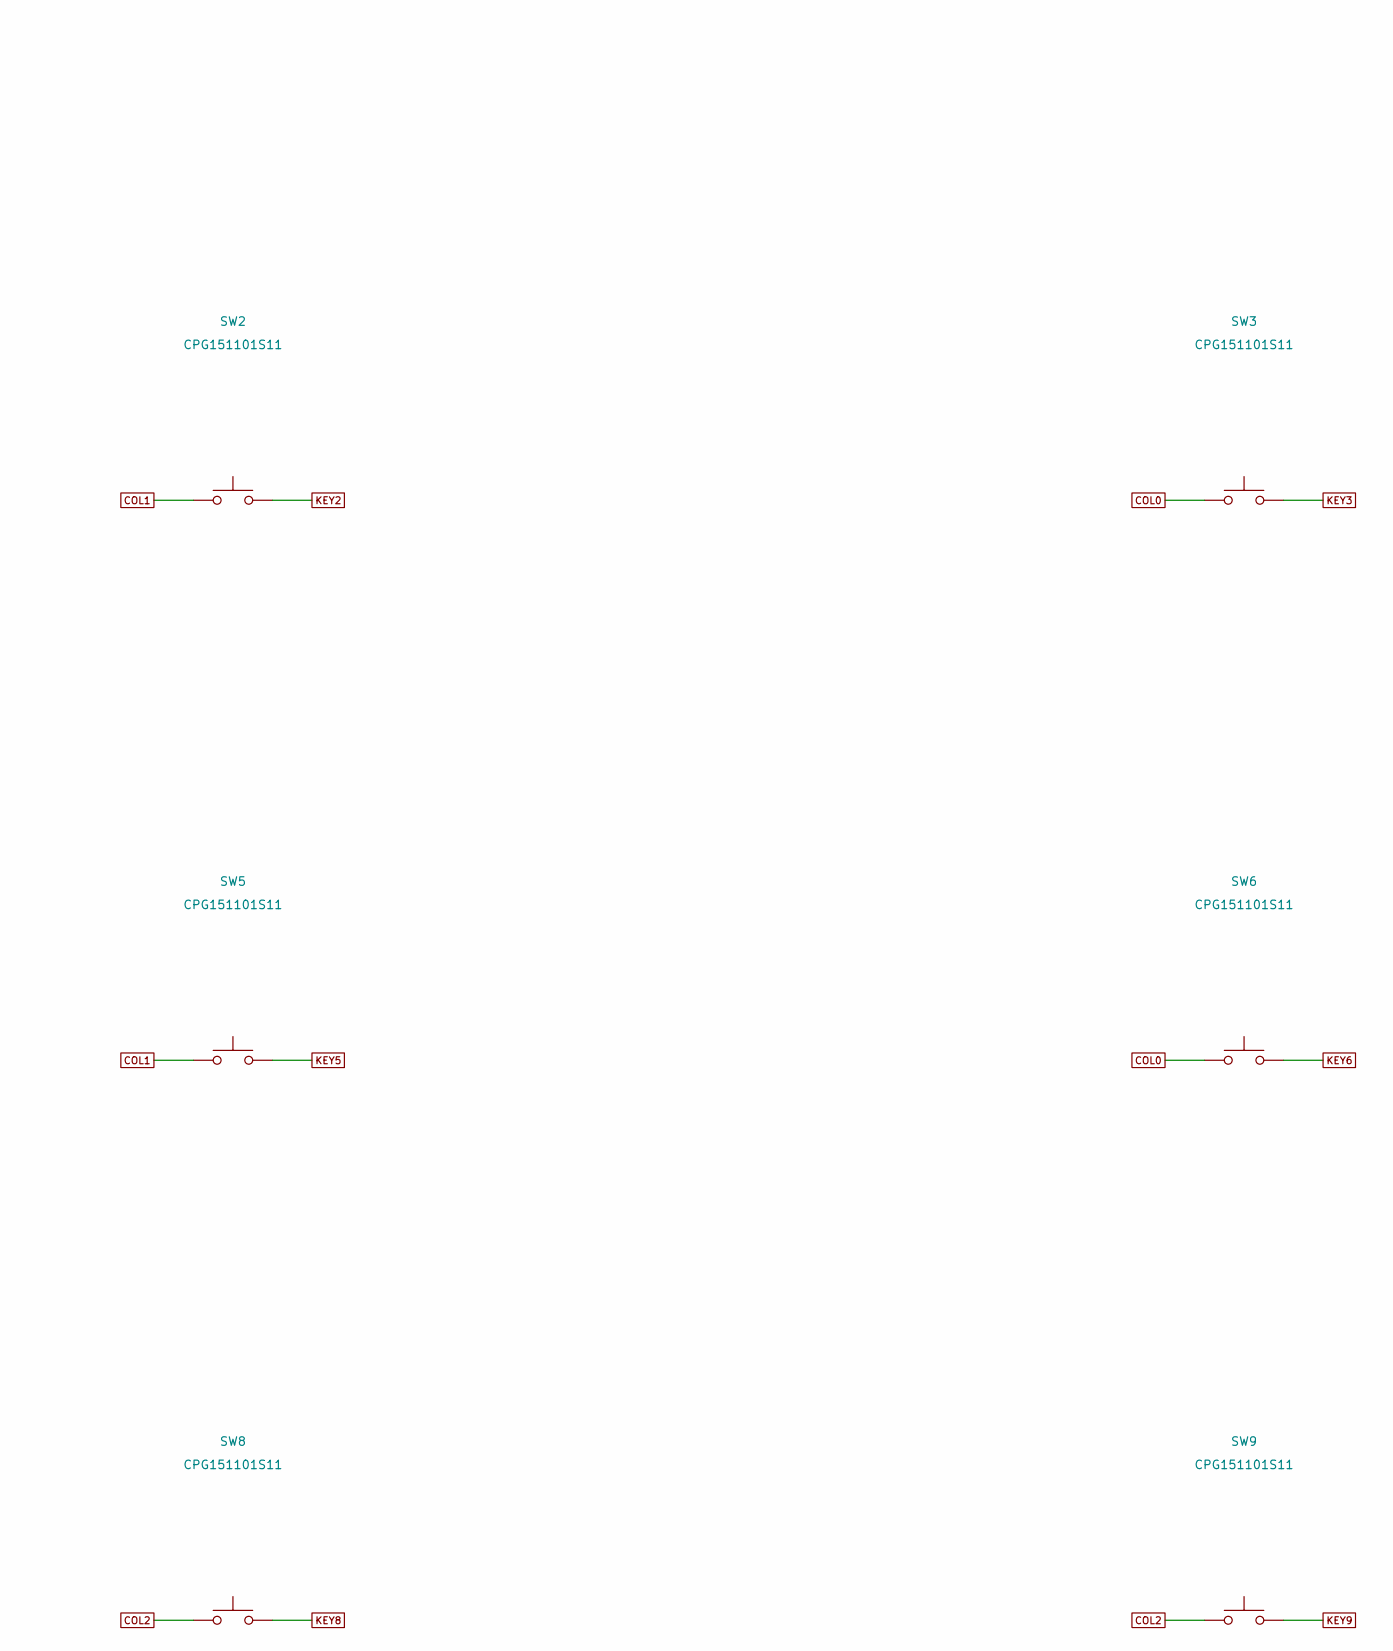
[picture p120: schematic core-review-09.kicad_sch, Xorrpad core connectivity review, part in row 1, column 2]

Parts:
SW1, SW2, SW3, SW4, SW5, SW6, SW7, SW8, SW9: CPG151101S11; Kailh_CPG151101S11

Connections:
COL0: SW3.1, SW6.1; also elsewhere on the board
COL1: SW2.1, SW5.1; also elsewhere on the board
COL2: SW1.1, SW4.1, SW8.1, SW9.1; also elsewhere on the board
COL3: SW7.1; also elsewhere on the board
KEY1: SW1.2; also elsewhere on the board
KEY2: SW2.2; also elsewhere on the board
KEY3: SW3.2; also elsewhere on the board
KEY4: SW4.2; also elsewhere on the board
KEY5: SW5.2; also elsewhere on the board
KEY6: SW6.2; also elsewhere on the board
KEY7: SW7.2; also elsewhere on the board
KEY8: SW8.2; also elsewhere on the board
KEY9: SW9.2; also elsewhere on the board

Notes on the sheet:
XORRPAD CORE - CONNECTIVITY REVIEW / P3
ENGINEERING DRAFT - A human PCB designer must review this before any order.
Reconstructed from SKiDL netlist. Named global nets connect every sheet; source-open pins remain open.
