nickthelegend/xorrpad/hardware/generated/core.kicad_pcb

## KiCad design hardware/generated/core.kicad_pcb (continued)

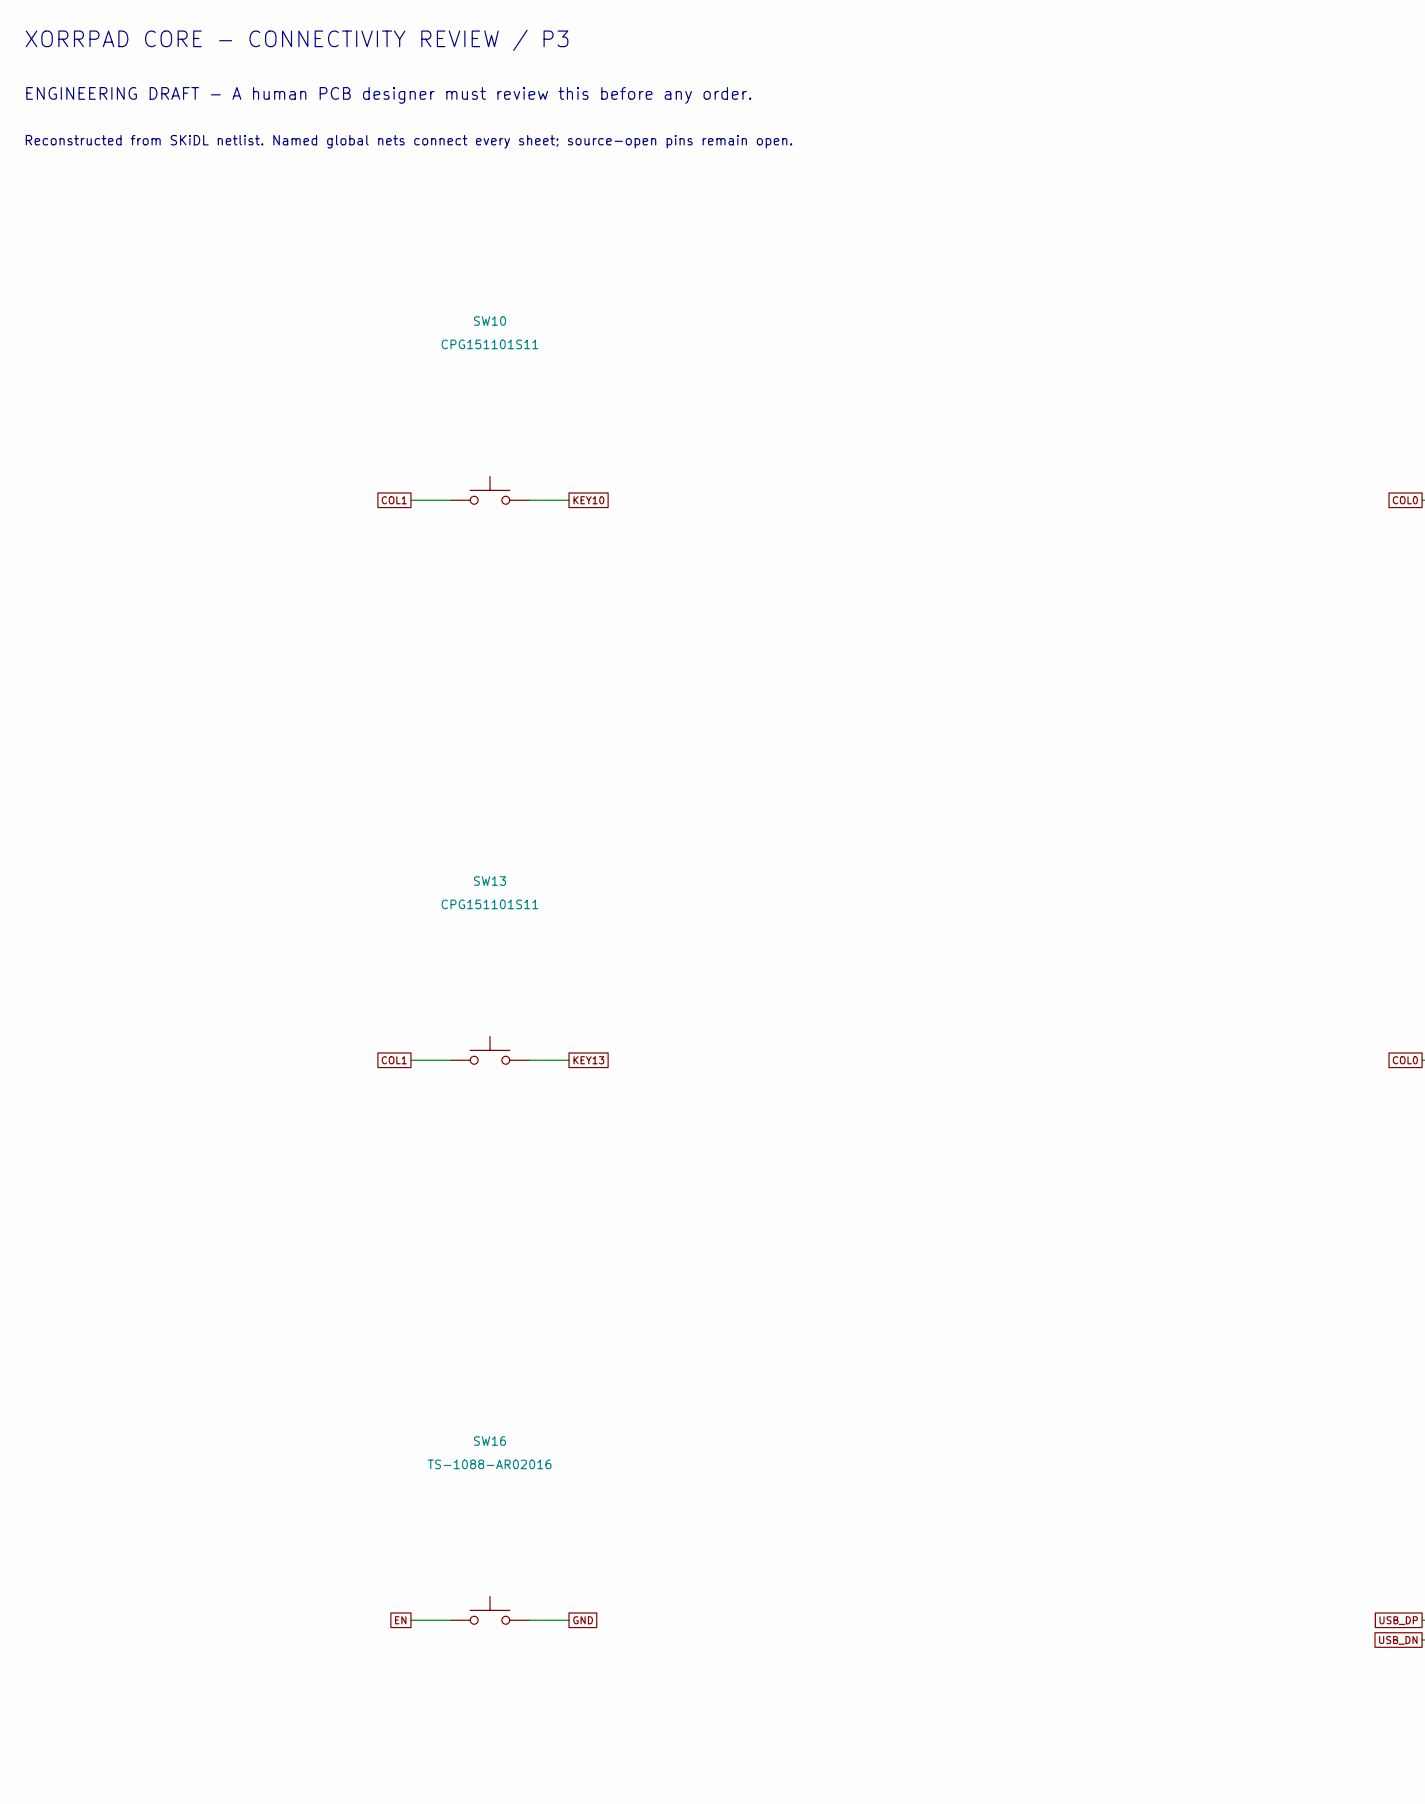
[picture p121: schematic core-review-10.kicad_sch, Xorrpad core connectivity review, part in row 1, column 1]

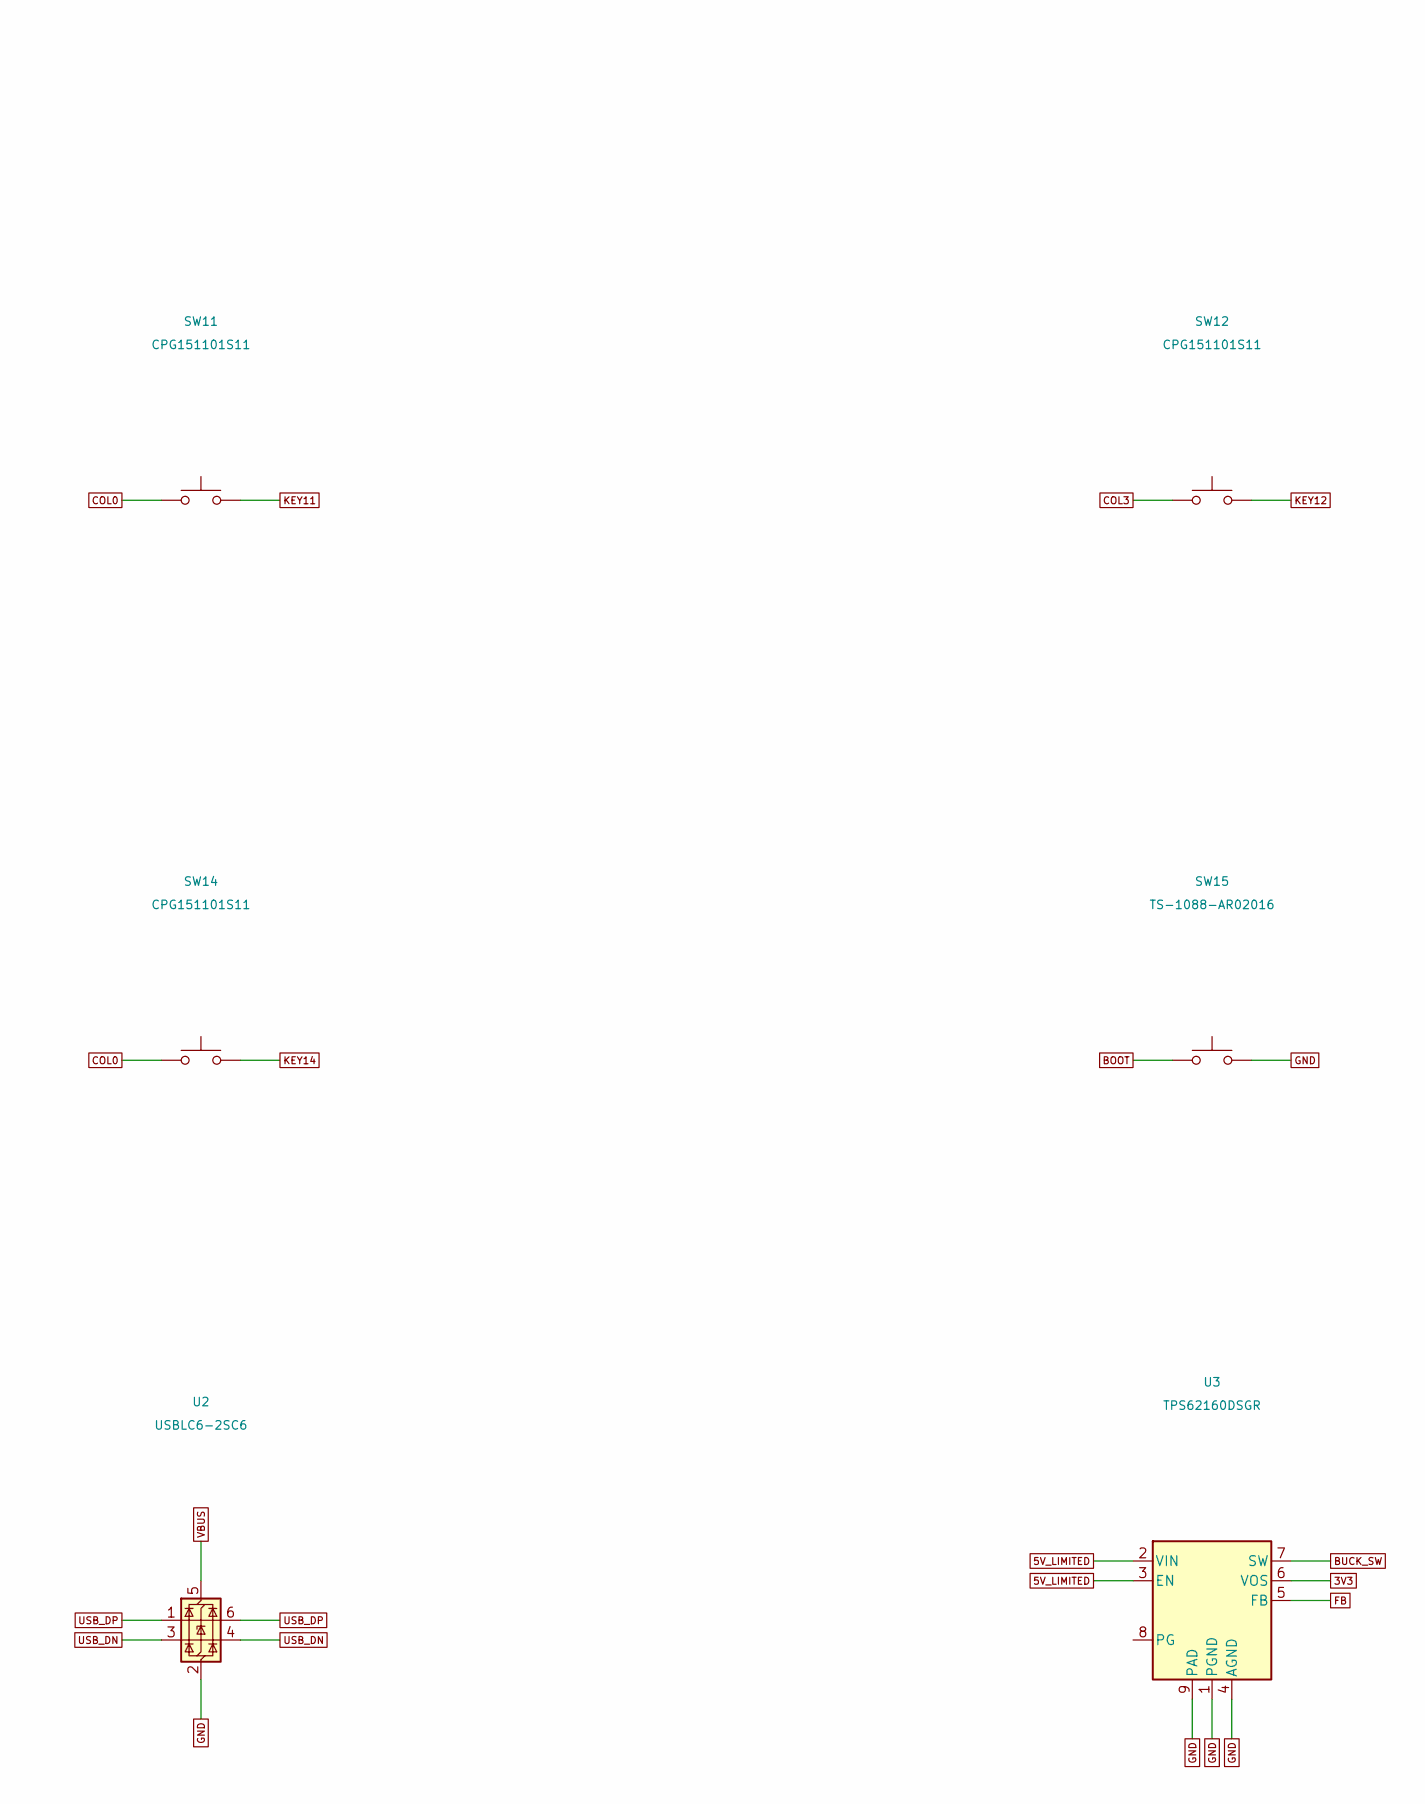
[picture p122: schematic core-review-10.kicad_sch, Xorrpad core connectivity review, part in row 1, column 2]

Parts:
SW10, SW11, SW12, SW13, SW14: CPG151101S11; Kailh_CPG151101S11
SW15, SW16: TS-1088-AR02016; SW_SPST_TL3342
U2: USBLC6-2SC6; SOT-666
U3: TPS62160DSGR; Texas_DSG0008A_WSON-8-1EP_2x2mm_P0.5mm_EP0.9x1.6mm_ThermalV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

Connections:
3V3: U3.6 (VOS); also elsewhere on the board
5V_LIMITED: U3.2 (VIN), U3.3 (EN); also elsewhere on the board
BOOT: SW15.1; also elsewhere on the board
BUCK_SW: U3.7 (SW); also elsewhere on the board
COL0: SW11.1, SW14.1; also elsewhere on the board
COL1: SW10.1, SW13.1; also elsewhere on the board
COL3: SW12.1; also elsewhere on the board
EN: SW16.1; also elsewhere on the board
FB: U3.5 (FB); also elsewhere on the board
GND: SW15.2, SW16.2, U2.2 (GND), U3.1 (PGND), U3.4 (AGND), U3.9 (PAD); also elsewhere on the board
KEY10: SW10.2; also elsewhere on the board
KEY11: SW11.2; also elsewhere on the board
KEY12: SW12.2; also elsewhere on the board
KEY13: SW13.2; also elsewhere on the board
KEY14: SW14.2; also elsewhere on the board
USB_DN: U2.3 (I/O2), U2.4 (I/O2); also elsewhere on the board
USB_DP: U2.1 (I/O1), U2.6 (I/O1); also elsewhere on the board
VBUS: U2.5 (VBUS); also elsewhere on the board

Notes on the sheet:
XORRPAD CORE - CONNECTIVITY REVIEW / P3
ENGINEERING DRAFT - A human PCB designer must review this before any order.
Reconstructed from SKiDL netlist. Named global nets connect every sheet; source-open pins remain open.

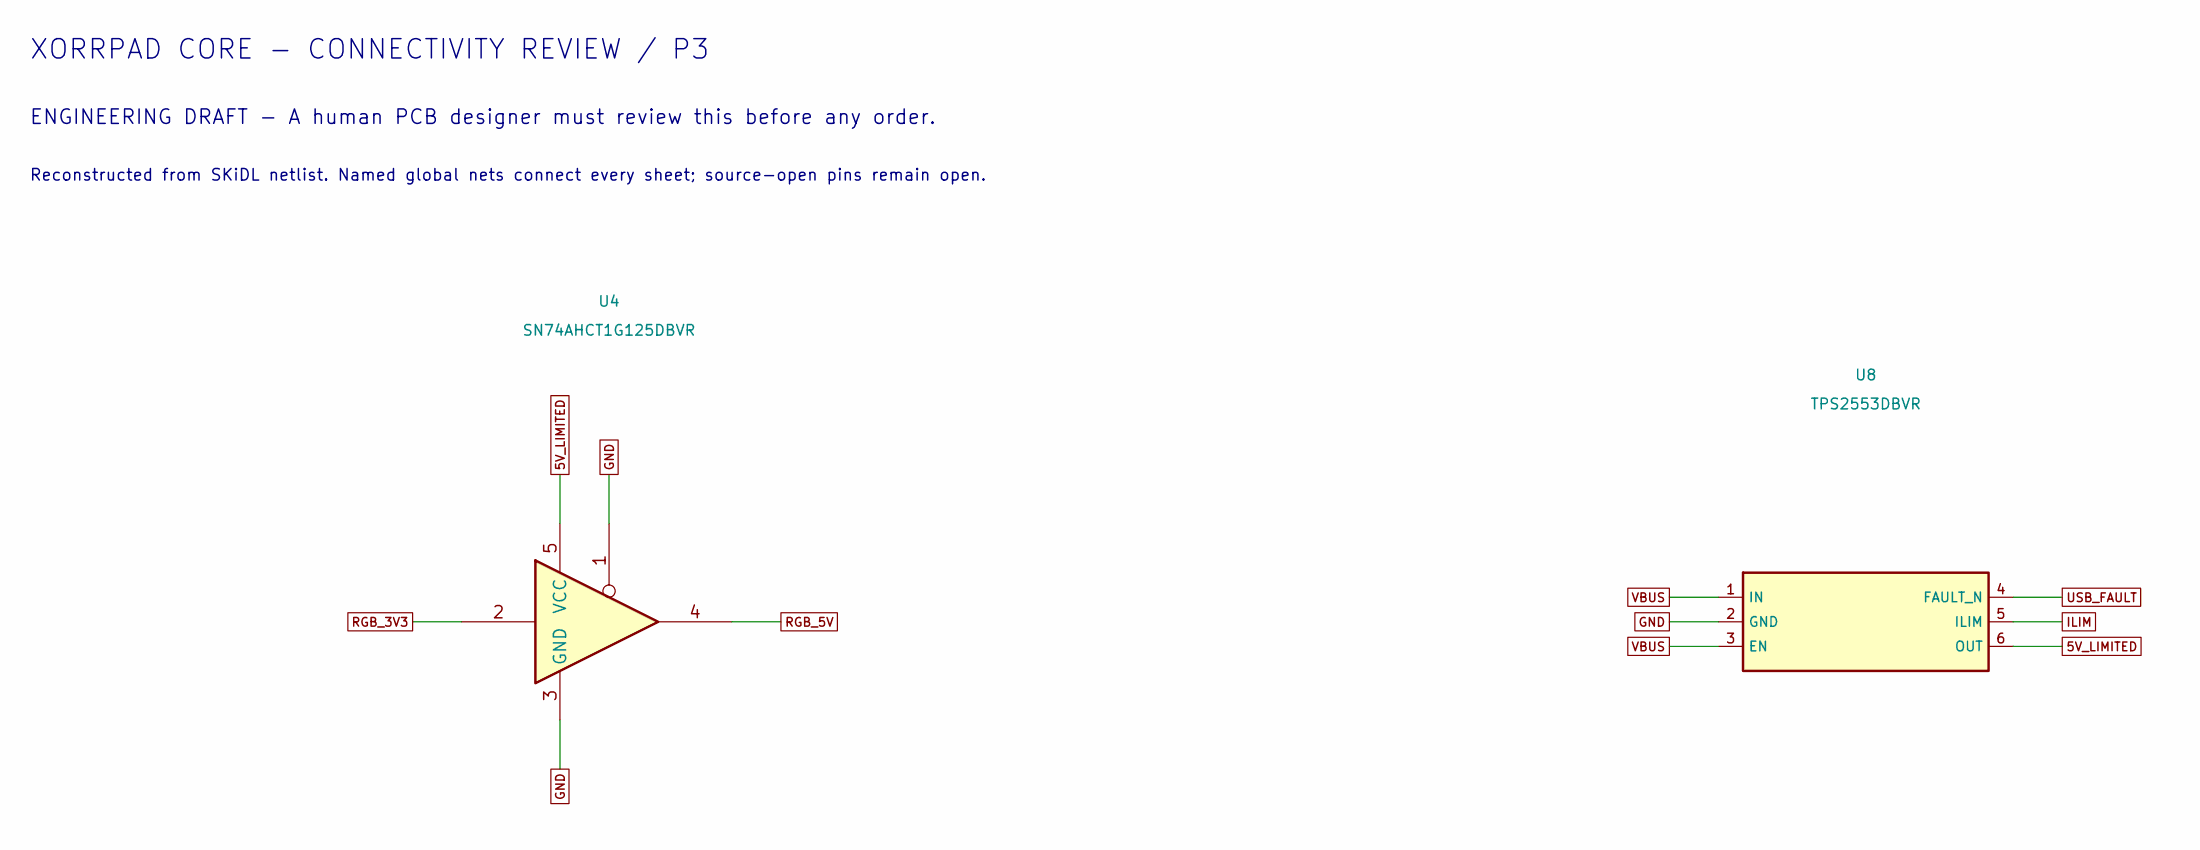
[picture p123: schematic core-review-11.kicad_sch, Xorrpad core connectivity review]

Parts:
U4: SN74AHCT1G125DBVR; SOT-23-5
U8: TPS2553DBVR; SOT-23-6

Connections:
5V_LIMITED: U4.5 (VCC), U8.6 (OUT); also elsewhere on the board
GND: U4.1, U4.3 (GND), U8.2 (GND); also elsewhere on the board
ILIM: U8.5 (ILIM); also elsewhere on the board
RGB_3V3: U4.2; also elsewhere on the board
RGB_5V: U4.4; also elsewhere on the board
USB_FAULT: U8.4 (FAULT_N)
VBUS: U8.1 (IN), U8.3 (EN); also elsewhere on the board

Notes on the sheet:
XORRPAD CORE - CONNECTIVITY REVIEW / P3
ENGINEERING DRAFT - A human PCB designer must review this before any order.
Reconstructed from SKiDL netlist. Named global nets connect every sheet; source-open pins remain open.

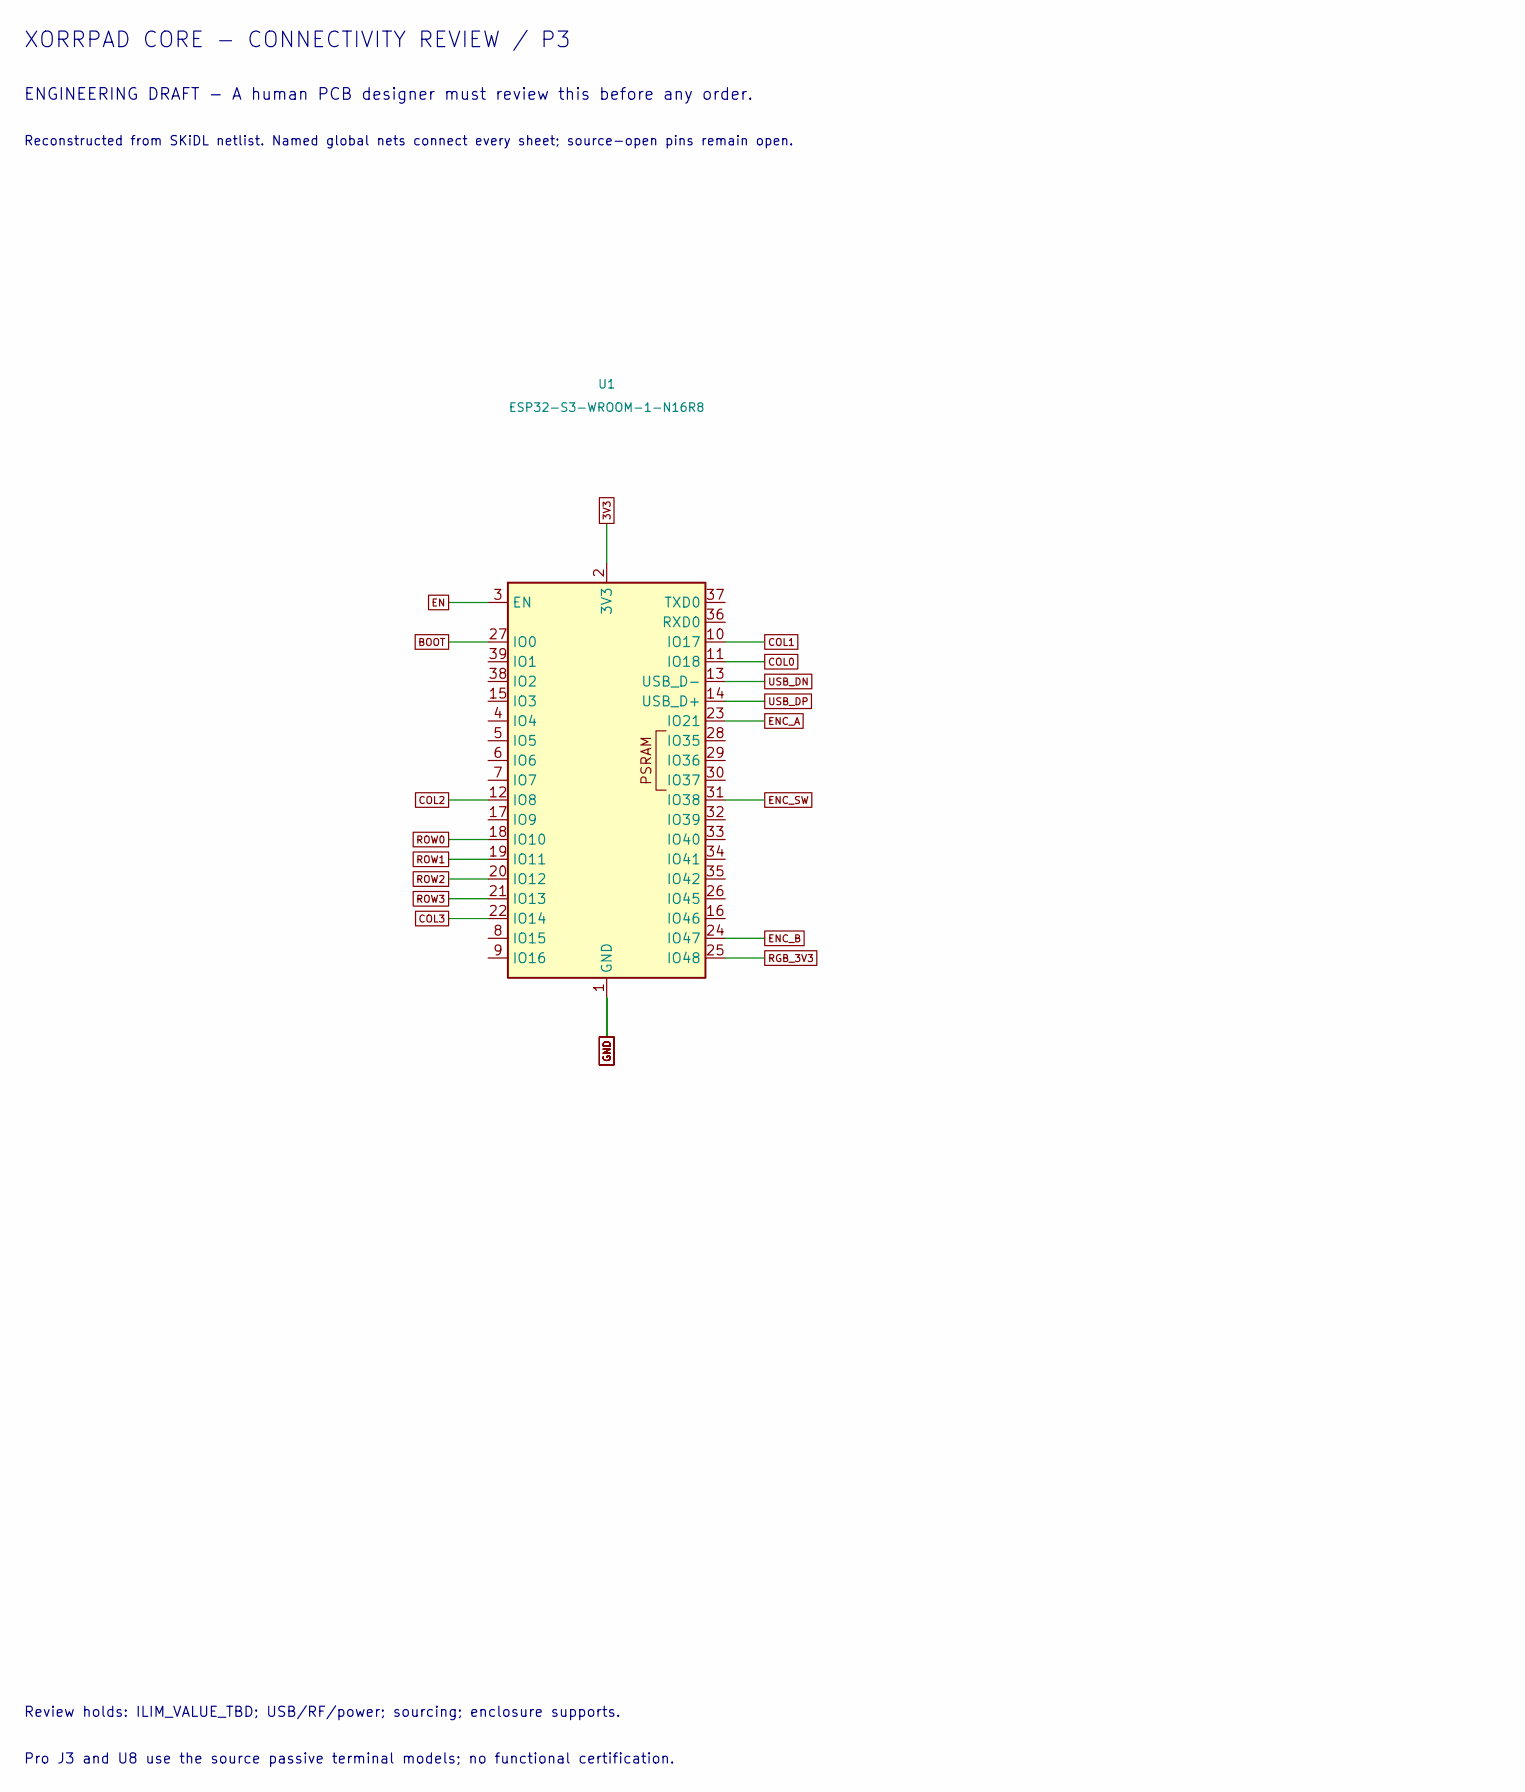
[picture p124: schematic core-review.kicad_sch, Xorrpad core connectivity review, part in row 1, column 1]

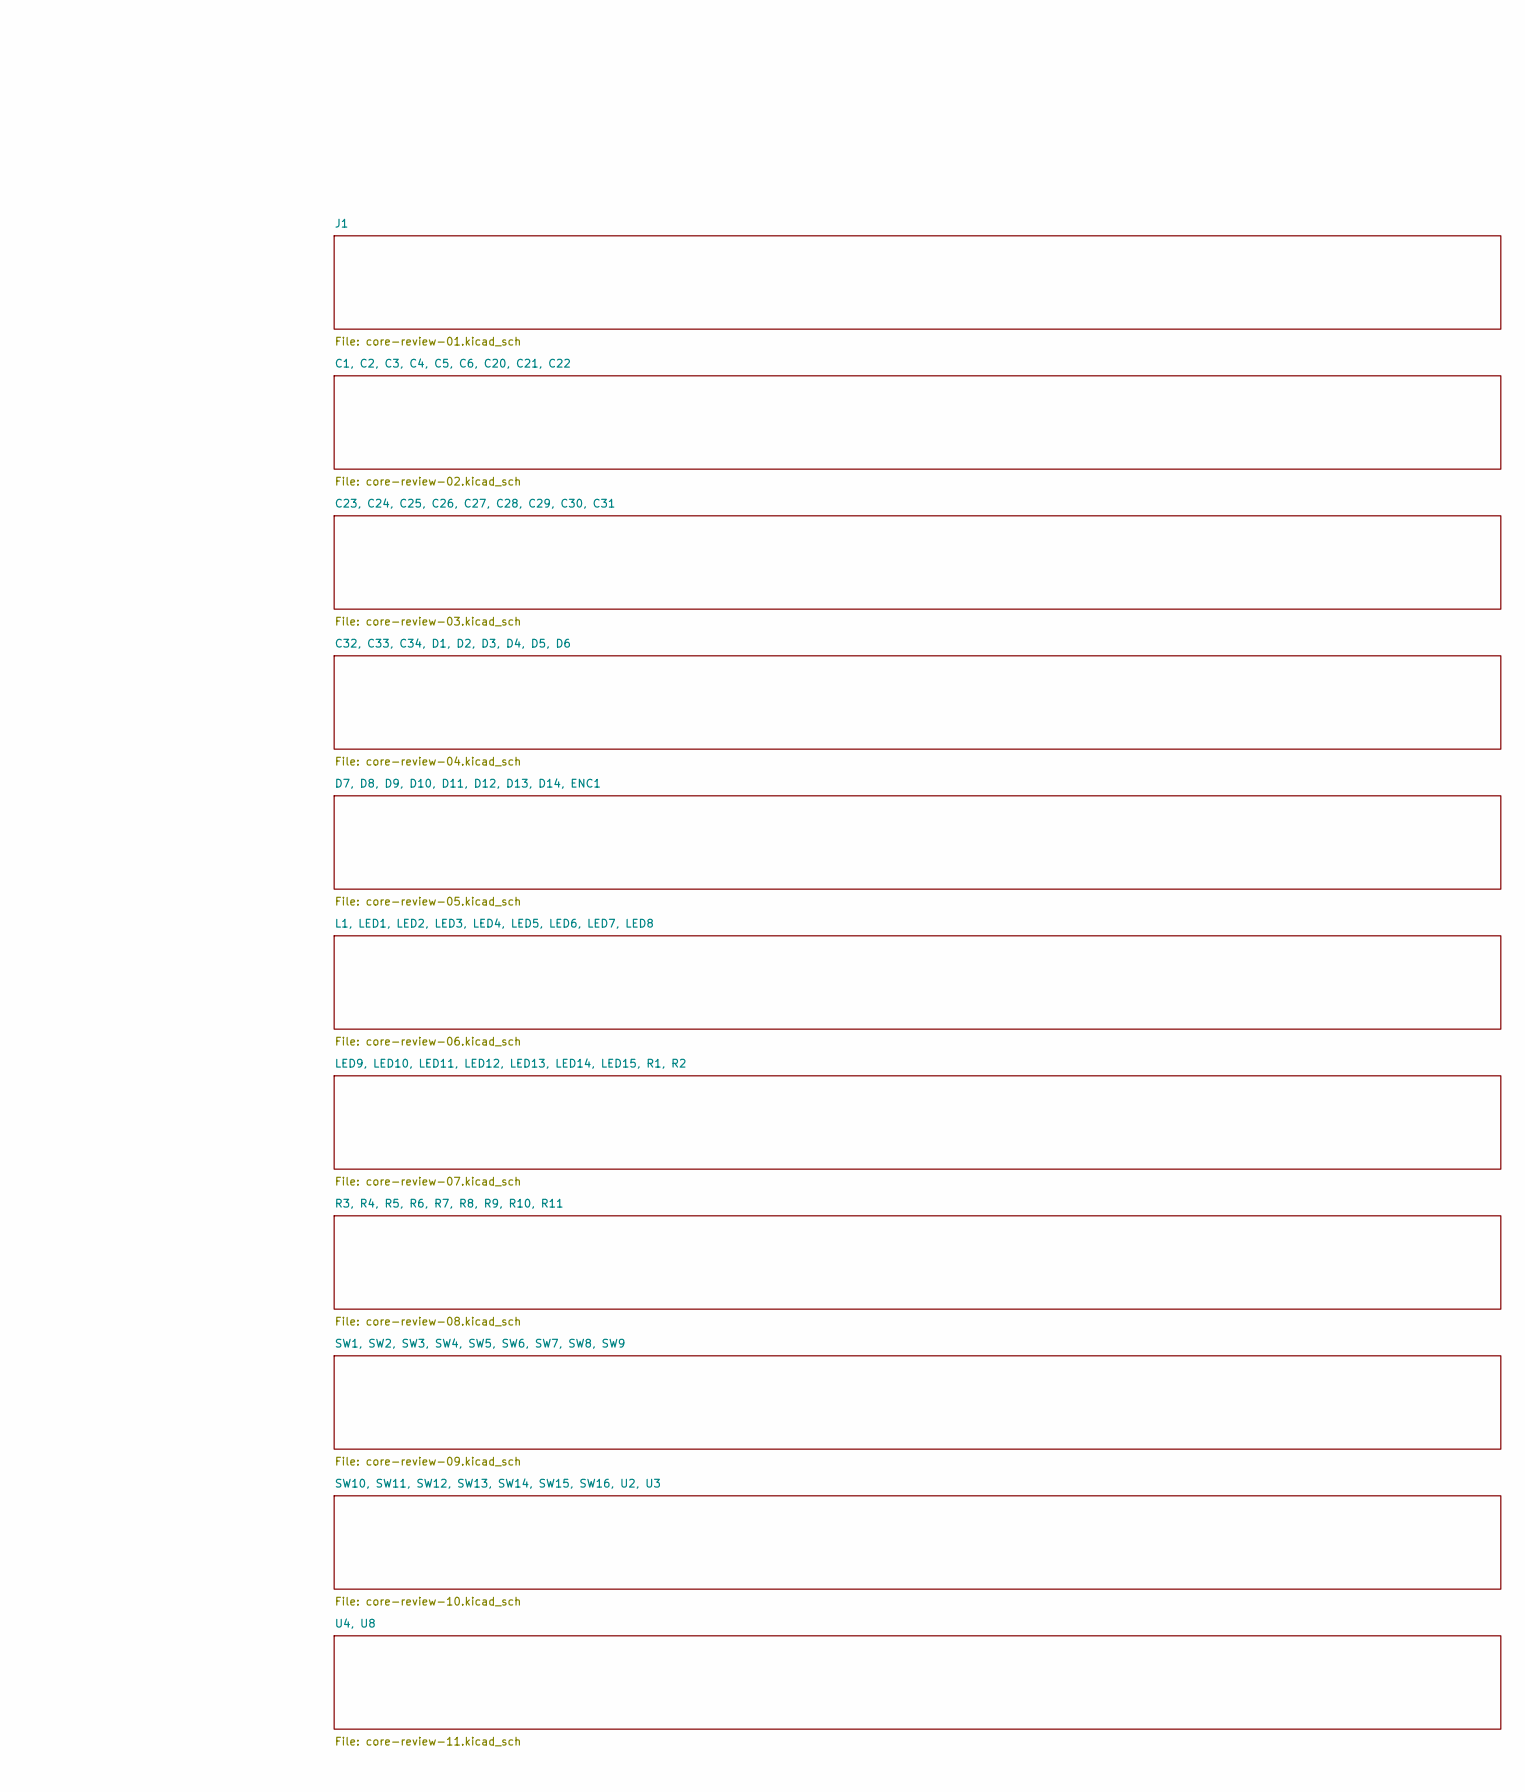
[picture p125: schematic core-review.kicad_sch, Xorrpad core connectivity review, part in row 1, column 2]

Parts:
U1: ESP32-S3-WROOM-1-N16R8; ESP32-S3-WROOM-1

Connections:
3V3: U1.2 (3V3); also elsewhere on the board
BOOT: U1.27 (IO0); also elsewhere on the board
COL0: U1.11 (IO18); also elsewhere on the board
COL1: U1.10 (IO17); also elsewhere on the board
COL2: U1.12 (IO8); also elsewhere on the board
COL3: U1.22 (IO14); also elsewhere on the board
EN: U1.3 (EN); also elsewhere on the board
ENC_A: U1.23 (IO21); also elsewhere on the board
ENC_B: U1.24 (IO47); also elsewhere on the board
ENC_SW: U1.31 (IO38); also elsewhere on the board
GND: U1.1 (GND), U1.40 (GND), U1.41 (GND); also elsewhere on the board
RGB_3V3: U1.25 (IO48); also elsewhere on the board
ROW0: U1.18 (IO10); also elsewhere on the board
ROW1: U1.19 (IO11); also elsewhere on the board
ROW2: U1.20 (IO12); also elsewhere on the board
ROW3: U1.21 (IO13); also elsewhere on the board
USB_DN: U1.13 (USB_D-); also elsewhere on the board
USB_DP: U1.14 (USB_D+); also elsewhere on the board

Notes on the sheet:
XORRPAD CORE - CONNECTIVITY REVIEW / P3
ENGINEERING DRAFT - A human PCB designer must review this before any order.
Reconstructed from SKiDL netlist. Named global nets connect every sheet; source-open pins remain open.
Review holds: ILIM_VALUE_TBD; USB/RF/power; sourcing; enclosure supports.
Pro J3 and U8 use the source passive terminal models; no functional certification.

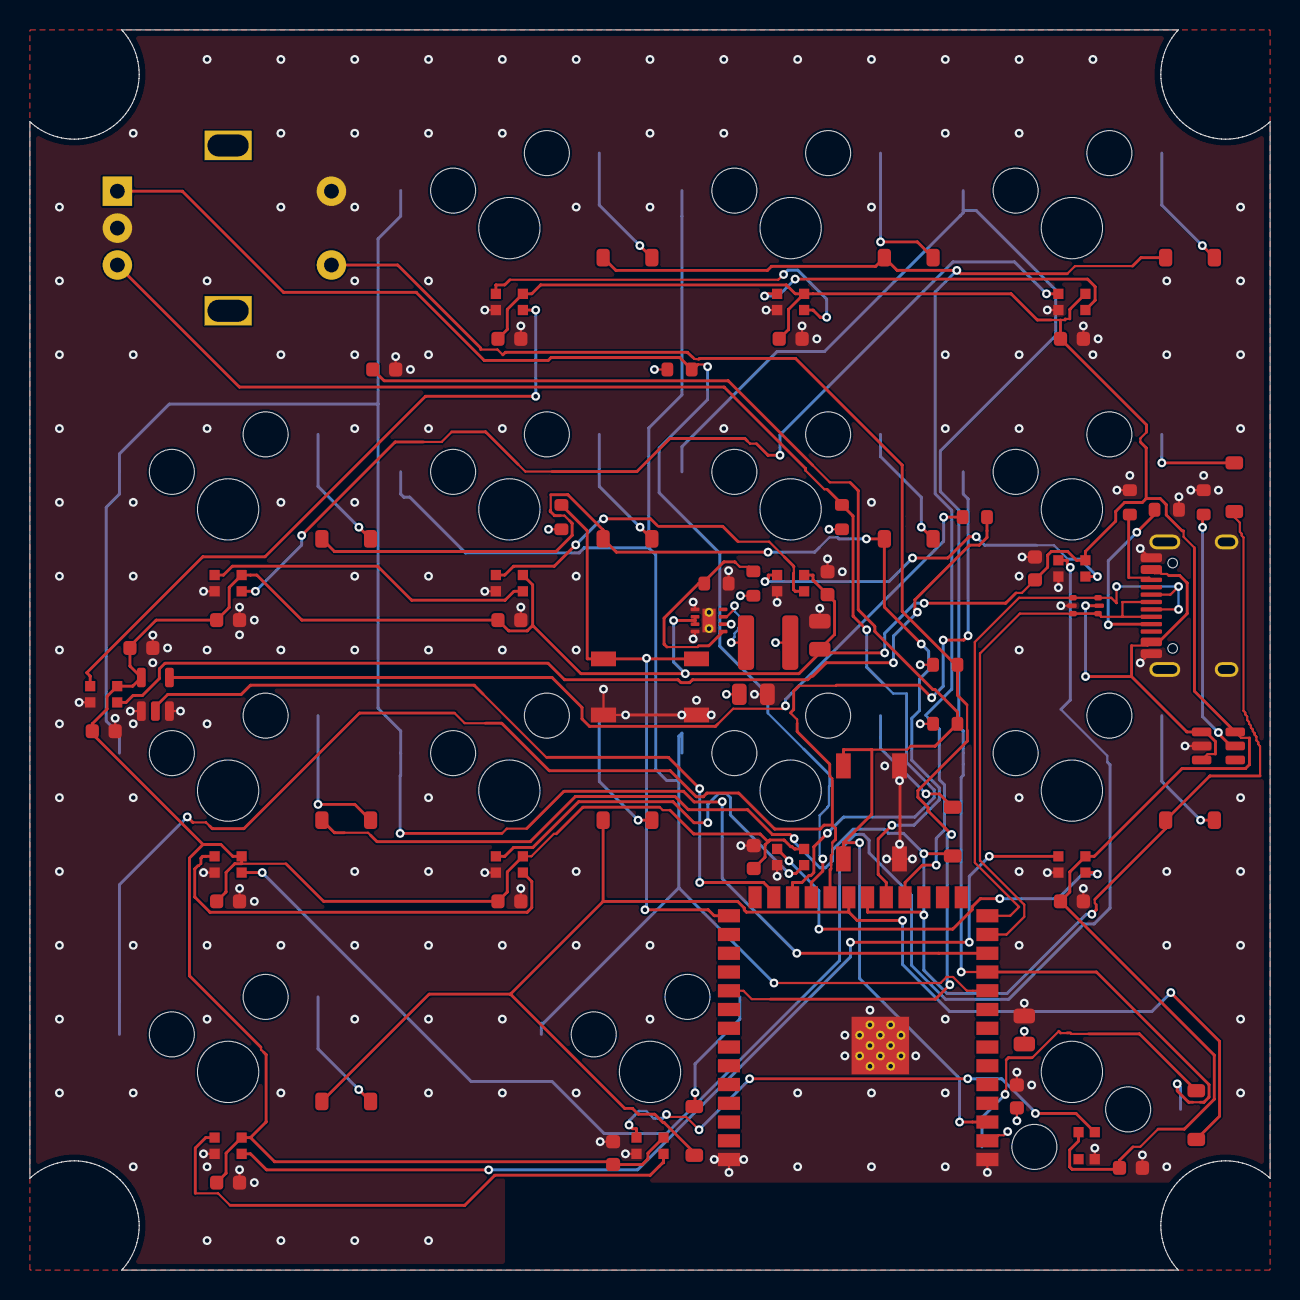
[picture p126: board core.kicad_pcb from above]

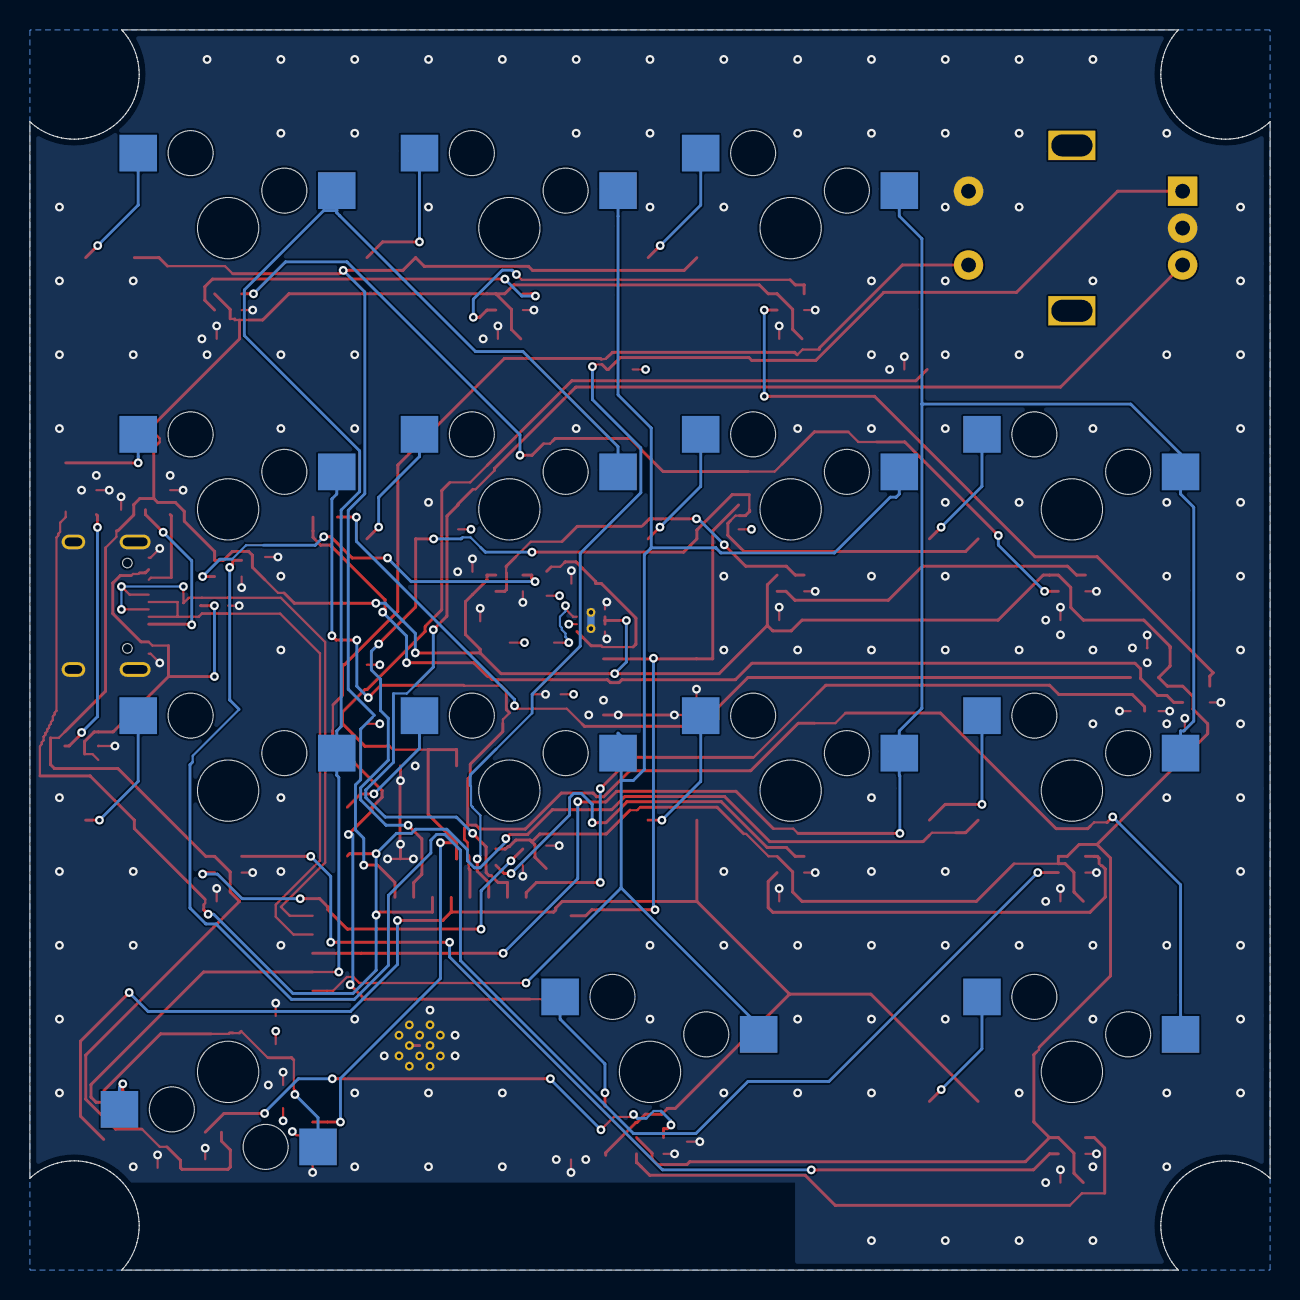
[picture p127: board core.kicad_pcb from below]

Board: 4 copper layers, 84.0 x 84.0 mm, 85 parts (14 on the bottom side), 55 nets.
