nickthelegend/xorrpad/firmware/xorrpad/padstate.h

#pragma once
#include <Arduino.h>
#include <string>
#include <vector>
#include "logic/presentation.h"
#include "logic/ambient-state.h"
#include "logic/scan-state.h"
#include "logic/journal-state.h"
#include "logic/predict-state.h"
#include "logic/perps-state.h"
#include "logic/flatten-state.h"

// ─────────────────────────────────────────────────────────────────────────────
// What the pad knows, as plain data.
//
// Split out of net.h so the drawing code can be compiled and looked at on a
// laptop. ui.h renders these two structs and nothing else — no WiFi, no SPI —
// which is what makes tools/uipreview able to produce a PNG of exactly the
// frame the panel will show. A UI you can only inspect by flashing it is a UI
// you will not inspect.
// ─────────────────────────────────────────────────────────────────────────────

// Everything the pad reads back from the xorr-pad backend in one poll. This is
// the whole model the firmware holds: it keeps no opinion of its own about what
// is armed or what is in hand, because the backend is the only thing that knows.
struct PadPosition {
  String market; float qty=0, pnl=0; bool hasPnl=false;
};

struct PadState {
  xorr::Ambient ambient;
  xorr::Scan scan;
  xorr::Journal journal;
  xorr::Flatten flatten;
  bool tiltBlocked=false,tiltAllowed=false;String tiltReason;uint32_t tiltRemaining=0,tiltDuration=0;
  xorr::Predict predict;
  xorr::Perps perps;
  xorr::LiqGuard liqGuard;
  xorr::Fund fund;
  xorr::Portfolio portfolio;
  bool alertsOnly=false;String alertNotice;uint32_t alertUntil=0;
  bool abilityReview=false;
  String abilityDeveloper,abilityWidget,abilityName;
  bool sessionPolicy=false;
  bool clearSigning=false,blindSigning=false,blindAllowed=false,clearReviewed=false;
  size_t clearPage=0;uint32_t confirmDuration=800;
  std::vector<std::string> clearRows;
  bool positionsVisible=false;
  PadPosition positions[8]; uint8_t positionN=0; int positionCount=-1;
  uint32_t replyAt=0;
  bool factory=false; int factoryStage=0, factoryMic=0;
  String factoryInstruction;
  String knobMode="size";
  double knobValue=100;
  float rearmProgress = 0;
  bool killed=false,rearmRequested=false,holdRequired=false,listening=false,highContrast=false;
  String fingerprint,signalSide,signalSize,signalPrice,signalFee,profile="Scalper",layer="Spot",pairCode,pairQr,errorCode,errorFix,reply;
  uint8_t otaProgress=0;bool updating=false;float holdProgress=0;int waveform[32]={};

  String keyLabels[14];uint32_t keymapUntil=0;
  bool signalReduceOnly=false;
  bool autoAccept = false;
  String link, signalId, signalState, receiptSignature, receiptExplorer, lastKeyLabel;
  uint32_t signalDeadline=0, receiptUntil=0, labelUntil=0;
  bool   ok        = false;   // did the poll succeed at all
  bool   armed     = false;
  bool   pending   = false;   // a decision is waiting on a ✓
  bool   chainOk   = false;
  bool   remembers = false;   // the store still has limits — false after a wipe
  String agent, market, mode, verdict;
  float  price      = 0;
  float  unrealised = 0;      // NaN-free: `hasPnl` says whether it means anything
  bool   hasPnl     = false;
  int    spentToday = -1, dayLimit = -1;
  // The venue in hand, and whether the exchange behind the asset is open.
  // A tokenized share trades around the clock; the company's listing does not.
  String chain, venue, hoursState, hoursNote, nyTime;
  bool   marketOpen = false;
};

// Same priority predicate for drawing, gesture consumption and confirmation eligibility.
inline bool padScanVisible(const PadState &p,uint32_t now) {
 return p.scan.fresh(now) && p.ok && !p.factory && !p.killed && !p.updating && !p.errorCode.length() &&
  !p.alertsOnly && !p.pairCode.length() && !p.abilityReview && !p.tiltBlocked && !p.listening && !p.liqGuard.fresh(now);
}

// The mirror uses the same visibility priority and pad uptime, including automatic pages.
inline const char *padMirrorView(const PadState &p,uint32_t now) {
 if(p.killed)return p.flatten.visible() && !p.rearmRequested?"flatten":"killed";
 if(p.tiltBlocked && !(p.pending && p.tiltAllowed) && !p.fund.visible && !p.portfolio.visible && !p.predict.positionsVisible && !(p.liqGuard.fresh(now) && !p.pending))return "cooldown";
 if(padScanVisible(p,now))return "scan";
 if(p.pending && p.ok)return "decision";
 if(p.ok && !p.listening && p.liqGuard.fresh(now))return "liq_guard";
 if(p.fund.visible)return "fund";
 if(p.portfolio.visible)return "portfolio";
 if(p.predict.positionsVisible)return "outcomes";
 if(p.journal.visible)return "journal";
 if(p.ambient.visible)return "ambient";
 if(p.predict.enabled)return "predict";
 if(p.positionsVisible || (p.positionCount>=0 && (now/6000)%2==1))return "positions";
 return "home";
}

// GET /pad/chart — the market in hand as hourly closes, for the display pod.
struct ChartState {
  bool    ok = false;
  String  symbol, error;
  float   price = 0, change24h = 0, hi = 0, lo = 0;
  bool    hasChange = false;
  uint8_t n = 0;
  float   closes[169];
};
