nickthelegend/xorrpad/firmware/xorrpad/ui.h

#pragma once
#include <Adafruit_GFX.h>
#include "padstate.h"
#include "config.h"
#include "logic/presentation.h"
#include <qrcode.h>
#include <ctime>

// ─────────────────────────────────────────────────────────────────────────────
// ui.h — every pixel the pad draws, and nothing that knows about hardware.
//
// This file talks to a GFXcanvas16 and reads PadState / ChartState. It has no
// SPI, no WiFi and no ESP32 in it, which is the point: tools/uipreview compiles
// this exact code on a laptop and writes out PNGs of the real frames, so the
// layout can be judged by looking at it instead of by flashing a board and
// squinting at a 2.8" panel across the desk.
//
// WHAT THIS SCREEN IS FOR
//
// It is read from two feet away, at a glance, by someone who is doing something
// else. So it answers three questions in descending size, and nothing else:
//
//   1. what is it worth        the price, as large as the panel allows
//   2. is anyone minding it    armed / stopped / waiting on you
//   3. is the exchange open    the banner across the bottom
//
// The third is the one that earns its place. These are tokenized shares: NVDAx
// trades at 3am on a Sunday, and the New York Stock Exchange does not. Most of
// the volume in this asset class happens while the listing that prices it is
// shut. A screen that showed a price without saying which of those two worlds
// it came from would be implying the market is open, so the banner is never
// absent and never subtle.
// ─────────────────────────────────────────────────────────────────────────────
namespace ui {

constexpr int W = 320, H = 240;

// xorr.finance palette, truncated to the TFT's RGB565 channels.
static constexpr uint16_t BG=xorr::night, INK=xorr::ink, MUTE=0x8c71, GRID=0x2124;
static constexpr uint16_t UP=xorr::mint, WARN=xorr::lime, BLUE=xorr::cobalt, SOL=xorr::lavender;
static constexpr uint16_t DOWN=0xfa27, UP_DIM=0x0143, DOWN_DIM=0x3882;

static constexpr int BANNER_H = 34;            // the hours bar owns the bottom



// ── small helpers ─────────────────────────────────────────────────────────
static int tw(uint8_t size, const char *s) { return (int)strlen(s) * 6 * size; }
static int th(uint8_t size) { return 8 * size; }

static bool highContrastTheme=false;
static void text(GFXcanvas16 &c, int x, int y, uint8_t size, uint16_t col, const char *s) {
  c.setTextSize(size); c.setTextColor(highContrastTheme?0xffff:col); c.setCursor(x, y); c.print(s);
}
static void textR(GFXcanvas16 &c, int right, int y, uint8_t size, uint16_t col, const char *s) {
  text(c, right - tw(size, s), y, size, col, s);
}

/**
 * Fold a backend string to printable ASCII.
 *
 * The built-in GFX font is a 7-bit face: anything multi-byte renders as two or
 * three pieces of line-noise. The desk app writes English prose with em dashes
 * and middots in it, and a middot arriving here as a stray glyph in the middle
 * of "momentum . $50 of $300" is exactly the sort of thing that looks like a
 * hardware fault. Map what has an obvious equivalent, drop the rest.
 */
static String ascii(const String &in) {
  const int n = (int)in.length();
  // Worst case is a 2-byte source char becoming 3 output chars (" - ", "...").
  char *buf = (char *)malloc((size_t)n * 3 + 1);
  if (!buf) return in;
  int w = 0;
  auto put = [&](const char *t) { while (*t) buf[w++] = *t++; };
  for (int i = 0; i < n; i++) {
    unsigned char ch = (unsigned char)in[i];
    if (ch >= 0x20 && ch < 0x7F) { buf[w++] = (char)ch; continue; }
    if (ch < 0x80) { buf[w++] = ' '; continue; }          // control bytes
    const int extra = (ch >= 0xF0) ? 3 : (ch >= 0xE0) ? 2 : 1;
    // Decode just enough of the code point to recognise the punctuation we
    // actually receive from the desk app.
    long cp = ch & (0x7F >> (extra + 1));
    for (int k = 1; k <= extra && i + k < n; k++) cp = (cp << 6) | ((unsigned char)in[i + k] & 0x3F);
    i += extra;
    switch (cp) {
      case 0x00B7: case 0x2022: put(" - "); break;        // middot, bullet
      case 0x2014: case 0x2013: put("-");   break;        // em / en dash
      case 0x2018: case 0x2019: put("'");   break;
      case 0x201C: case 0x201D: put("\"");  break;
      case 0x2026: put("...");              break;
      case 0x2192: put("->");               break;
      default:     buf[w++] = '?';          break;
    }
  }
  buf[w] = 0;
  String out(buf);
  free(buf);
  return out;
}

/** Draw `s` clipped to `wpx`, ending in "..." when it does not fit. */
static void textClip(GFXcanvas16 &c, int x, int y, int wpx, uint8_t size, uint16_t col, const String &s) {
  const int per = wpx / (6 * size);
  if (per <= 0) return;
  String t = ascii(s);
  if ((int)t.length() > per)
    t = per > 3 ? t.substring(0, per - 3) + "..." : t.substring(0, per);
  text(c, x, y, size, col, t.c_str());
}

/** An outlined capsule. Returns its left edge, so pills can be laid right to left. */
static int pill(GFXcanvas16 &c, int right, int y, const char *t, uint16_t col, uint8_t size = 1) {
  const int padx = 6, h = th(size) + 8;
  const int w = tw(size, t) + padx * 2;
  const int x = right - w;
  c.drawRoundRect(x, y, w, h, h / 2, col);
  text(c, x + padx, y + 4, size, col, t);
  return x;
}

/** A filled capsule, for the one state that must not be missed. */
static int pillSolid(GFXcanvas16 &c, int right, int y, const char *t, uint16_t col, uint16_t ink, uint8_t size = 1) {
  const int padx = 6, h = th(size) + 8;
  const int w = tw(size, t) + padx * 2;
  const int x = right - w;
  c.fillRoundRect(x, y, w, h, h / 2, col);
  text(c, x + padx, y + 4, size, ink, t);
  return x;
}

static void fmtPrice(char *b, size_t n, float p) {
  if (p <= 0)          snprintf(b, n, "$--");
  else if (p >= 10000) snprintf(b, n, "$%.0f", p);
  else if (p >= 100)   snprintf(b, n, "$%.2f", p);
  else if (p >= 1)     snprintf(b, n, "$%.3f", p);
  else                 snprintf(b, n, "$%.4f", p);
}

/** Greedy word wrap into a fixed column, drawn from (x,y). Returns lines used. */
static int wrap(GFXcanvas16 &c, int x, int y, int wpx, uint8_t size, uint16_t col,
                const String &s, int maxLines) {
  const int perLine = wpx / (6 * size);
  if (perLine <= 0 || !s.length()) return 0;
  int line = 0, i = 0;
  while (i < (int)s.length() && line < maxLines) {
    int take = min(perLine, (int)s.length() - i);
    if (i + take < (int)s.length()) {                 // break on a space when we can
      int sp = take;
      while (sp > 0 && s[i + sp] != ' ') sp--;
      if (sp > perLine / 3) take = sp;
    }
    String seg = s.substring(i, i + take); seg.trim();
    text(c, x, y + line * (th(size) + 3), size, col, seg.c_str());
    i += take; line++;
    while (i < (int)s.length() && s[i] == ' ') i++;
  }
  return line;
}

// ── the hours banner ──────────────────────────────────────────────────────
// Always drawn, always at the bottom, never subtle. `tag` is the state in two
// or three words; `sub` is the sentence under it.
static void banner(GFXcanvas16 &c, uint16_t col, const char *tag, const String &sub) {
  const int y = H - BANNER_H;
  c.fillRect(0, y, W, BANNER_H, BG);
  c.drawFastHLine(0, y, W, col);
  c.fillRect(0, y + 1, 5, BANNER_H - 1, col);        // a colour stripe, readable in a photo
  text(c, 14, y + 6, 2, col, tag);
  // Clipped, not wrapped: the bar is one line tall by design, and a sentence
  // running off the right edge of a 320px panel reads as a broken screen.
  textClip(c, 14, y + 22, W - 28, 1, MUTE, sub);
}

/** Colour and wording for the exchange's state. Open is the quiet case. */
static uint16_t hoursColour(const String &st) {
  if (st == "OPEN") return UP;
  if (st == "CRYPTO") return BLUE;                    // no bell to be shut by
  if (st == "PRE" || st == "AFTER") return WARN;
  return SOL;                                        // weekend / holiday / overnight
}
static const char *hoursTag(const String &st) {
  if (st == "OPEN")      return "NYSE OPEN";
  if (st == "PRE")       return "PRE-MARKET";
  if (st == "AFTER")     return "AFTER HOURS";
  if (st == "WEEKEND")   return "WEEKEND";
  if (st == "HOLIDAY")   return "HOLIDAY";
  if (st == "OVERNIGHT") return "OVERNIGHT";
  if (st == "CRYPTO")    return "24/7";
  return "MARKET";
}

void drawHoursBanner(GFXcanvas16 &c, const PadState &pad) {
  if (!pad.hoursState.length()) {                    // backend too old to say
    banner(c, GRID, "MARKET", "the desk did not say whether the exchange is open");
    return;
  }
  const uint16_t col = hoursColour(pad.hoursState);
  const char *tag = hoursTag(pad.hoursState);
  String sub = pad.hoursNote.length() ? pad.hoursNote
                                      : String(pad.marketOpen ? "the exchange is open" : "this trades anyway");
  banner(c, col, tag, sub.c_str());
  if (pad.nyTime.length()) {
    String t = pad.nyTime + " NY";
    textR(c, W - 12, H - BANNER_H + 10, 1, col, t.c_str());
  }
}

// ── screens ───────────────────────────────────────────────────────────────

void drawOffline(GFXcanvas16 &c) {
  text(c, 14, 14, 3, MUTE, "xorr-pad");
  text(c, 14, 52, 1, GRID, "NO ANSWER FROM THE DESK");
  wrap(c, 14, 72, W - 28, 1, MUTE,
       "The pad is not making anything up while it cannot reach the backend. "
       "Check the desk app is running and the URL in settings.", 4);
  banner(c, DOWN, "OFFLINE", "offline: nothing will execute");
}

/**
 * The resting screen: what it is worth, who is minding it, is the floor open.
 */
void drawHome(GFXcanvas16 &c, const PadState &pad, const ChartState &ch) {
  // Product title left, state and venue pills right; the live symbol is in the profile strip.
  text(c, 12, 10, 3, INK, "xorr-pad");

  int right = W - 12;
  if (pad.autoAccept) right = pillSolid(c, right, 88, "AUTO", WARN, BG) - 6;
  right = W - 12;
  if (!pad.armed)        right = pillSolid(c, right, 10, "STOPPED", DOWN, BG) - 6;
  else                   right = pill(c, right, 10, "ARMED", UP) - 6;
  if (pad.chain.length()) {
    String ch2 = pad.chain; ch2.toUpperCase();
    right = pill(c, right, 34, ch2.c_str(), pad.chain == "solana" ? SOL : BLUE) - 6;
  }

  // subtitle — the agent holding the baton, and what it can spend
  String sub = (pad.market.length() ? pad.market : String("--")) + " / " +
               (pad.agent.length() ? pad.agent : String("no agent"));
  if (pad.dayLimit > 0) {
    sub += "  -  $"; sub += (pad.spentToday >= 0 ? pad.spentToday : 0);
    sub += " of $";  sub += pad.dayLimit; sub += " today";
  }
  if (!pad.remembers) sub = "memory wiped — running on fallback limits";
  textClip(c, 12, 40, pad.chain.length() ? 190 : W - 24, 1, pad.remembers ? MUTE : WARN, sub);

  // price — the chart's close when it is for this market, else /pad's
  const bool fresh = ch.ok && ch.symbol == pad.market;
  const float px = (fresh && ch.price > 0) ? ch.price : pad.price;
  char buf[40];
  fmtPrice(buf, sizeof buf, px);
  const uint8_t psize = strlen(buf) <= 9 ? 5 : 3;
  text(c, 12, 56, psize, px > 0 ? INK : MUTE, buf);

  // Market Pulse keeps the signed 24h change visible without a chart.
  text(c, 12, 100, 1, BLUE, "MARKET PULSE");
  if (fresh && ch.hasChange) snprintf(buf, sizeof buf, "%+.2f%% 24h", ch.change24h);
  else snprintf(buf, sizeof buf, "24h --");
  textR(c, W - 12, 100, 1, fresh && ch.hasChange ? (ch.change24h >= 0 ? UP : DOWN) : MUTE, buf);

  // chart — a line with the area under it, green if it ends above where it began
  const int X0 = 12, X1 = W - 12, Y0 = 118, Y1 = H - BANNER_H - 30;
  c.drawFastHLine(X0, Y1, X1 - X0, GRID);
  if (fresh && ch.n >= 2 && ch.hi > ch.lo) {
    const bool rising = ch.closes[ch.n - 1] >= ch.closes[0];
    const uint16_t line = rising ? UP : DOWN, fill = rising ? UP_DIM : DOWN_DIM;
    int pxx = -1, pyy = -1;
    for (int i = 0; i < ch.n; i++) {
      int x = X0 + (int)((long)(X1 - X0) * i / (ch.n - 1));
      int y = Y1 - (int)((ch.closes[i] - ch.lo) / (ch.hi - ch.lo) * (Y1 - Y0));
      if (pxx >= 0) {
        for (int xx = pxx + 1; xx <= x; xx++) {
          int yy = pyy + (y - pyy) * (xx - pxx) / (x - pxx);
          c.drawFastVLine(xx, yy, Y1 - yy, fill);
        }
        c.drawLine(pxx, pyy, x, y, line);
        c.drawLine(pxx, pyy - 1, x, y - 1, line);
      }
      pxx = x; pyy = y;
    }
    c.fillCircle(pxx, pyy, 3, line);
    fmtPrice(buf, sizeof buf, ch.hi); text(c, X0, Y0 - 10, 1, GRID, buf);
    fmtPrice(buf, sizeof buf, ch.lo); text(c, X0, Y1 + 4,  1, GRID, buf);
    snprintf(buf, sizeof buf, "%uh", (unsigned)(ch.n - 1));
    textR(c, X1, Y1 + 4, 1, GRID, buf);
  } else {
    const char *why = ch.error.length() ? ch.error.c_str()
                    : !pad.chainOk      ? "the chain is not answering"
                                        : "waiting for the chart";
    text(c, X0, (Y0 + Y1) / 2 - 4, 1, GRID, why);
  }

  drawHoursBanner(c, pad);
}

/**
 * A decision is waiting on a human. This screen exists because the pad never
 * signs anything on its own: it can reason its way to a trade, but a person
 * presses ✓. So the ask is the whole screen, not a pill in a corner.
 */
void drawConfirm(GFXcanvas16 &c, const PadState &pad, const ChartState &ch) {
  (void)ch;
  if(pad.clearSigning) {
    uint16_t color=pad.blindSigning?DOWN:WARN;
    if(pad.blindSigning)c.fillScreen(0x6000);
    text(c,12,10,2,color,pad.sessionPolicy?"Signing policy":pad.blindSigning?"Blind sign":"Clear signing");
    if(!pad.sessionPolicy){text(c,12,36,1,INK,"SHA256 / BASE58");text(c,126,32,2,color,pad.fingerprint.c_str());}
    String page=String((unsigned)pad.clearPage+1)+" / "+String((unsigned)pad.clearRows.size());
    textClip(c,12,58,296,1,MUTE,"TURN KNOB TO REVIEW / "+page);
    if(pad.clearPage<pad.clearRows.size())wrap(c,12,82,296,2,INK,String(pad.clearRows[pad.clearPage].c_str()),5);
    const char *hint=pad.sessionPolicy?(!pad.clearReviewed?"REVIEW ALL PAGES FIRST":"HOLD YES 3.8s TO STORE POLICY"):!pad.blindAllowed?"BLIND SIGNING DISABLED ON DESK":!pad.clearReviewed?"REVIEW ALL PAGES FIRST":pad.blindSigning?"HOLD YES 3.8s (+3s BLIND)":"HOLD YES 800ms";
    textClip(c,12,188,296,1,color,hint);
    c.drawRect(12,205,int(296*pad.holdProgress),3,color);
    text(c,12,218,1,INK,"NO / REFUSE");
    int32_t left=(int32_t)(pad.signalDeadline-millis());String seconds=String(left>0?(left+999)/1000:0)+"s";textR(c,308,218,1,INK,seconds.c_str());
    return;
  }
  textClip(c,12,10,220,2,WARN,pad.signalReduceOnly?String("REDUCE 50%"):"CHECK / "+pad.signalSide);
  if(pad.autoAccept)pillSolid(c,308,10,"AUTO",WARN,BG);
  if(!pad.fingerprint.length()) textClip(c,12,148,296,1,MUTE,pad.verdict);
  wrap(c,12,36,296,1,INK,pad.market,2);
  wrap(c,12,64,296,1,INK,"VENUE "+pad.venue,2);
  textClip(c,12,92,296,1,INK,"SIZE $"+pad.signalSize);
  textClip(c,12,110,296,1,INK,"PRICE $"+pad.signalPrice);
  textClip(c,12,128,296,1,INK,"FEE $"+pad.signalFee);
  if(pad.fingerprint.length()) text(c,12,148,1,MUTE,"COMPARE WITH DESK + PHONE");
  text(c,12,161,2,WARN,pad.fingerprint.c_str());
  int32_t left=(int32_t)(pad.signalDeadline-millis());String seconds=String(left>0?(left+999)/1000:0)+"s";textR(c,308,161,2,INK,seconds.c_str());
  c.drawRoundRect(12,182,142,30,6,UP);text(c,20,192,1,UP,pad.holdRequired?"HOLD YES 800ms":"TAP YES");
  c.drawRoundRect(166,182,142,30,6,DOWN);text(c,182,192,1,DOWN,"NO / REFUSE");
  if(pad.holdRequired){for(int a=0;a<int(pad.holdProgress*360);a+=8){float rad=a*0.01745329252f;int x=137+10*sinf(rad),y=197-10*cosf(rad);c.fillCircle(x,y,1,WARN);}}
  textClip(c,12,215,296,1,MUTE,pad.verdict);
  textClip(c,12,228,296,1,MUTE,pad.profile+" / "+pad.layer);

}

/**
 * The boot card. Checks the wiring and the way up before there is any data:
 * palette bars, a border on the panel's very edge, and an arrow that must point
 * up the slant. Wrong way round? `rot 3` (or `rot 1`) on telnet.
 */
static void drawBoot(GFXcanvas16 &c, uint8_t rotation) {
  highContrastTheme=false;
  c.fillScreen(BG);
  const uint16_t bars[6] = {UP, DOWN, WARN, SOL, INK, MUTE};
  for (int i = 0; i < 6; i++) c.fillRect(i * W / 6, 0, W / 6 + 1, 8, bars[i]);
  c.drawRect(0, 0, W, H, GRID);
  c.setTextWrap(false);

  text(c, 14, 40, 4, INK, "xorr-pad");
  text(c, 14, 82, 1, MUTE, "firmware " XORR_FW_VERSION);

  text(c, 14, 118, 1, GRID, "DISPLAY");
  char b[48];
  snprintf(b, sizeof b, "ILI9341  %dx%d  rot %u", W, H, rotation);
  text(c, 14, 132, 1, MUTE, b);
  text(c, 14, 152, 1, GRID, "IF THE ARROW POINTS DOWN THE SLANT");
  text(c, 14, 166, 1, MUTE, "telnet in, type  rot 1  or  rot 3");

  c.fillTriangle(272, 40, 248, 82, 296, 82, UP);
  c.fillRect(264, 82, 17, 54, UP);
  text(c, 260, 144, 2, UP, "UP");

  banner(c, WARN, "CONNECTING", "joining wifi, then the desk");
}

// Pairing and funding share the real ESP encoder and the same pixel renderer.
// Native/WASM uses Espressif's encoder through tools/uipreview/shim/qrcode.h.
inline bool qrData[53*53]={};inline int qrSize=0;inline String qrText;
static bool drawQr(GFXcanvas16 &c,const String &uri,int x,int y,int box) {
  if(strcmp(qrText.c_str(),uri.c_str())) {
    qrText=uri;qrSize=0;
    esp_qrcode_config_t cfg={[](esp_qrcode_handle_t qr){
      qrSize=esp_qrcode_get_size(qr);if(qrSize>53){qrSize=0;return;}
      for(int row=0;row<qrSize;++row)for(int col=0;col<qrSize;++col)
        qrData[row*53+col]=esp_qrcode_get_module(qr,col,row);
    },9,ESP_QRCODE_ECC_LOW};
    if(esp_qrcode_generate(&cfg,uri.c_str())!=ESP_OK)qrSize=0;
  }
  if(!qrSize)return false;
  int scale=box/(qrSize+8),side=(qrSize+8)*scale;
  int left=x+(box-side)/2,top=y+(box-side)/2;
  c.fillRect(left,top,side,side,0xffff);
  for(int row=0;row<qrSize;++row)for(int col=0;col<qrSize;++col)
    if(qrData[row*53+col])c.fillRect(left+(col+4)*scale,top+(row+4)*scale,scale,scale,0);
  return true;
}

static void drawFund(GFXcanvas16 &c,const xorr::Fund &fund) {
  text(c,12,10,2,INK,"FUND");pill(c,308,8,fund.cluster.c_str(),fund.cluster=="devnet"?WARN:UP);
  text(c,12,52,1,MUTE,"AGENT WALLET");
  wrap(c,12,76,114,1,INK,"Send SOL or USDC to fund your agent",4);
  text(c,12,143,1,MUTE,"ADDRESS");
  String address(fund.address.c_str());
  text(c,12,159,1,INK,(address.substring(0,6)+"..."+address.substring(address.length()-6,address.length())).c_str());
  if(!drawQr(c,String(fund.uri.c_str()),136,34,176))text(c,148,110,1,WARN,"QR unavailable");
  text(c,12,224,1,MUTE,"Any key to close");
}

static void drawPortfolio(GFXcanvas16 &c, const xorr::Portfolio &p) {
  c.fillScreen(BG);
  text(c,12,10,2,INK,"PORTFOLIO");
  if(!p.message.empty()) {
    wrap(c,12,65,296,2,INK,String(p.message.c_str()),5);
    banner(c,BLUE,"AGENT WALLET","Any key to close");return;
  }
  textR(c,308,34,1,MUTE,p.cluster.c_str());
  char line[64];
  if(p.hasTotal)snprintf(line,sizeof line,"$%.2f",p.totalUsd);
  else snprintf(line,sizeof line,"USD unavailable");
  text(c,12,45,2,p.hasTotal?UP:MUTE,line);
  for(size_t i=0;i<p.rows.size() && i<5;++i) {
    const auto &row=p.rows[i];int y=78+int(i)*23;
    textClip(c,12,y,96,1,INK,String(row.symbol.c_str()));
    snprintf(line,sizeof line,"%.6g",row.amount);textR(c,216,y,1,INK,line);
    if(row.hasUsd)snprintf(line,sizeof line,"$%.2f",row.usd);
    else snprintf(line,sizeof line,"--");
    textR(c,308,y,1,MUTE,line);
  }
  banner(c,BLUE,p.cluster=="devnet"?"DEVNET":"LIVE BALANCES",p.cluster=="devnet"?"Test tokens / no USD market value":"Any key to close / -- unpriced");
}

static void perpValue(GFXcanvas16 &c,int y,const char *label,double value,const char *suffix="") {
 char b[64];if(std::isfinite(value))snprintf(b,sizeof b,"%s %.6g%s",label,value,suffix);
 else snprintf(b,sizeof b,"%s unavailable",label);text(c,12,y,1,INK,b);
}
static void drawPerp(GFXcanvas16 &c,const xorr::PerpPosition &p) {
 c.fillScreen(BG);text(c,12,10,2,INK,"POSITIONS / PERPS");
 textClip(c,12,40,296,2,SOL,String(p.market.c_str())+" "+p.side.c_str());
 text(c,12,64,1,MUTE,(String(p.venue.c_str())+" / mainnet read").c_str());
 perpValue(c,86,"Entry $",p.entry);perpValue(c,103,"Mark $",p.mark);
 perpValue(c,120,"Leverage",p.leverage,"x");perpValue(c,137,"Liquidation $",p.liq);
 perpValue(c,157,"Liq distance",p.distancePct,"%");
 c.fillRect(12,172,296,5,GRID);
 if(std::isfinite(p.distancePct))c.fillRect(12,172,int(296*std::min(100.,p.distancePct)/100),5,p.distancePct<=10?DOWN:UP);
 if(std::isfinite(p.nextFunding))perpValue(c,188,"Next funding UTC epoch",p.nextFunding);
 else text(c,12,188,1,MUTE,"Next funding unavailable");
 banner(c,BLUE,"PERPS","Venue values / unavailable stays unknown");
}
static void drawLiqGuard(GFXcanvas16 &c,const xorr::LiqGuard &g) {
 c.fillScreen(BG);c.fillRect(0,0,W,38,DOWN);text(c,12,8,3,BG,"LIQ GUARD");
 textClip(c,12,52,296,2,INK,String(g.market.c_str())+" / "+g.venue.c_str());
 perpValue(c,82,"Mark $",g.mark);perpValue(c,102,"Liquidation $",g.liq);
 perpValue(c,122,"Distance",g.distancePct,"%");
 c.fillRect(12,142,296,6,GRID);c.fillRect(12,142,int(296*std::min(100.,g.distancePct)/100),6,DOWN);
 text(c,12,162,2,INK,"Reduce 50%? YES / NO");
 text(c,12,191,1,MUTE,"YES proposes / review before signing");
 banner(c,DOWN,"RISK","Reduce-only / existing permissions apply");
}
static void drawPositions(GFXcanvas16 &c, const PadState &pad, uint32_t now) {
  c.fillScreen(BG);
    text(c,12,10,2,INK,"POSITIONS");
    char line[64];
    if(pad.hasPnl) snprintf(line,sizeof line,"Book PnL $%+.2f",pad.unrealised);
    else snprintf(line,sizeof line,"Book PnL -- / price or basis missing");
    text(c,12,38,1,pad.hasPnl?(pad.unrealised>=0?UP:DOWN):MUTE,line);
    if(!pad.positionCount) text(c,12,85,2,MUTE,"No open positions");
    else if(!pad.positionN) text(c,12,85,1,MUTE,"Position details unavailable");
    size_t spotPages=std::max(size_t(1),(size_t(pad.positionN)+3)/4);
    bool fresh=uint32_t(now-pad.perps.at)<30000;
    size_t perpN=fresh?pad.perps.positions.size():0;
    size_t pages=spotPages+perpN;
    size_t page=pad.positionsVisible && perpN?spotPages:(now/12000)%pages;
    if(page>=spotPages){drawPerp(c,pad.perps.positions[page-spotPages]);return;}
    if(!perpN && !pad.perps.message.empty())textClip(c,12,184,296,1,MUTE,pad.perps.message.c_str());
    for(size_t i=page*4;i<pad.positionN && i<(page+1)*4;++i) {
      const auto &position=pad.positions[i]; int y=65+int(i%4)*30;
      textClip(c,12,y,140,1,INK,position.market);
      if(position.hasPnl) snprintf(line,sizeof line,"$%+.2f",position.pnl);
      else snprintf(line,sizeof line,"PnL --");
      textR(c,308,y,1,position.hasPnl?(position.pnl>=0?UP:DOWN):MUTE,line);
      snprintf(line,sizeof line,"Qty %.6g",position.qty);text(c,12,y+12,1,MUTE,line);
    }
    snprintf(line,sizeof line,"%d open / %u shown",pad.positionCount,unsigned(pad.positionN));
    banner(c,BLUE,"PORTFOLIO",line);
}

static void drawPredict(GFXcanvas16 &c,const PadState &pad) {
  const auto &p=pad.predict;
  text(c,12,10,2,INK,"PREDICT");pill(c,308,8,"devnet",WARN);
  text(c,12,34,1,SOL,"pm-AMM");
  if(!p.fresh(millis())) {
    wrap(c,12,72,296,2,MUTE,"Setup required",2);
    wrap(c,12,112,296,1,INK,String(p.message.empty()?"Refresh open, funded devnet markets in XOR Desktop":p.message.c_str()),5);
    banner(c,BLUE,"NO LIVE QUOTE","Connect the desk / nothing will trade");return;
  }
  const auto &m=p.markets[p.selected];
  wrap(c,12,51,296,1,INK,String(m.question.c_str()),3);
  // A 240-degree arc: the lit fraction is the quoted YES probability.
  for(int a=0;a<=240;a+=3) {
    float r=(150+a)*0.01745329252f;
    uint16_t color=a<=int(m.probability*240)?UP:GRID;
    for(int radius=45;radius<51;++radius)c.fillCircle(77+int(radius*cosf(r)),143+int(radius*sinf(r)),1,color);
  }
  char b[64];snprintf(b,sizeof b,"%.0f%%",m.probability*100);text(c,45,130,3,UP,b);
  text(c,68,159,1,MUTE,"YES");
  if(m.hasChange)snprintf(b,sizeof b,"24h %+.2f pp",m.change24h);
  else snprintf(b,sizeof b,"24h unavailable");
  text(c,147,103,1,MUTE,b);
  uint32_t elapsed=uint32_t(millis()-p.receivedAt)/1000;
  uint32_t left=m.closesIn>elapsed?m.closesIn-elapsed:0;
  if(left>=86400)snprintf(b,sizeof b,"Closes in %ud %uh",unsigned(left/86400),unsigned(left%86400/3600));
  else snprintf(b,sizeof b,"Closes in %uh %um",unsigned(left/3600),unsigned(left%3600/60));
  text(c,147,125,1,INK,b);
  snprintf(b,sizeof b,"%u / %u  TURN KNOB",unsigned(p.offset+p.selected+1),unsigned(p.total?p.total:p.markets.size()));text(c,147,147,1,MUTE,b);
  text(c,147,170,1,WARN,"mUSDC / test tokens");
  snprintf(b,sizeof b,"BUY YES/NO $%.2f / then YES accepts",p.sizeUsd);
  banner(c,UP,"YES / NO: PROPOSE",b);
}
static void drawOutcomePositions(GFXcanvas16 &c,const xorr::Predict &p,uint32_t now) {
  text(c,12,10,2,INK,"OUTCOME POSITIONS");pill(c,308,36,"devnet",WARN);
  if(!p.positionsMessage.empty())wrap(c,12,74,296,1,MUTE,String(p.positionsMessage.c_str()),6);
  else if(p.positions.empty())text(c,12,85,2,MUTE,"No outcome positions");
  size_t page=(now/12000)%std::max(size_t(1),(p.positions.size()+2)/3);
  for(size_t i=page*3;i<p.positions.size() && i<(page+1)*3;++i) {
    int y=66+int(i%3)*42;char b[64];
    textClip(c,12,y,296,1,INK,String(p.positions[i].question.c_str()));
    snprintf(b,sizeof b,"YES %.6g / NO %.6g shares",p.positions[i].yes,p.positions[i].no);
    text(c,12,y+16,1,UP,b);
  }
  banner(c,BLUE,"PORTFOLIO","pm-AMM / any key to close / hold for FUND");
}

/**
 * One frame. Which screen to show is a property of the state, not a mode the
 * firmware keeps: a pending decision outranks everything, and an unreachable
 * desk outranks a stale price.
 */
inline void drawJournal(GFXcanvas16 &c,const xorr::Journal &j) {
 c.fillScreen(BG);text(c,12,12,2,INK,"PAD JOURNAL");
 if(!j.healthy){wrap(c,12,55,296,2,WARN,"Setup required: journal storage",3);return;}
 auto r=j.current();if(!r){text(c,12,60,2,MUTE,"No decisions yet");text(c,12,223,1,MUTE,"Press knob / key to close");return;}
 textClip(c,12,40,296,1,MUTE,String(unsigned(j.selected+1))+" / "+String(unsigned(j.entries.size()))+" newest first / turn knob");
 textClip(c,12,62,296,2,INK,String(r->action.c_str())+" "+r->market.c_str());
 textClip(c,12,89,296,1,MUTE,(r->size.empty()?String("Size unavailable"):String("Size $")+r->size.c_str())+" / "+(r->venue.empty()?String("venue unavailable"):String(r->venue.c_str())));
 char when[48];if(r->time){time_t stamp=r->time;struct tm t;gmtime_r(&stamp,&t);snprintf(when,sizeof when,"%04d-%02d-%02d %02d:%02d UTC",t.tm_year+1900,t.tm_mon+1,t.tm_mday,t.tm_hour,t.tm_min);}else snprintf(when,sizeof when,"Time unavailable");
 text(c,12,109,1,MUTE,when);
 textClip(c,12,132,296,2,r->result=="filled"?UP:WARN,r->result.c_str());
 wrap(c,12,158,296,1,INK,r->result=="filled"?r->signature.c_str():r->reason.c_str(),4);
 text(c,12,223,1,MUTE,"Read only / press knob or key to close");
}
inline void drawAmbient(GFXcanvas16 &c,const xorr::Ambient &a) {
 c.fillScreen(BG);bool fresh=a.fresh(millis());
 text(c,12,10,1,MUTE,"DESK CLOCK / UTC");
 uint64_t now=a.epoch+uint32_t(millis()-a.receivedAt)/1000;
 char clock[12];snprintf(clock,sizeof clock,"%02u:%02u",unsigned(now/3600%24),unsigned(now/60%60));
 text(c,12,30,5,INK,fresh?clock:"--:--");
 textClip(c,12,82,296,2,SOL,fresh && std::isfinite(a.price)?String("SOL $")+String(float(a.price)):String("SOL unavailable"));
 if(fresh && a.closes.size()>1){
  double lo=*std::min_element(a.closes.begin(),a.closes.end()),hi=*std::max_element(a.closes.begin(),a.closes.end());
  for(size_t i=1;i<a.closes.size();i++)c.drawLine(12+(i-1)*296/(a.closes.size()-1),132-int((a.closes[i-1]-lo)/std::max(hi-lo,0.001)*25),12+i*296/(a.closes.size()-1),132-int((a.closes[i]-lo)/std::max(hi-lo,0.001)*25),SOL);
 }
 textClip(c,12,145,296,1,INK,fresh && std::isfinite(a.pnl)?String("Book P/L $")+String(float(a.pnl)):String("Book P/L: Setup required"));
 String funding="Funding: unavailable";
 if(fresh && std::isfinite(a.nextFunding) && a.nextFunding>double(now)) {uint32_t left=a.nextFunding-now;funding=String("Funding in ")+String(left/60)+"m "+String(left%60)+"s";}
 textClip(c,12,161,296,1,MUTE,funding);
 textClip(c,12,178,296,1,MUTE,fresh?String(a.hours.c_str()):String("Setup required: refresh desk link"));
 textClip(c,12,195,296,1,MUTE,fresh?String(a.crew.c_str()):String("Crew: unavailable"));
 text(c,12,223,1,MUTE,"First key / turn wakes only");
}
static void drawCooldown(GFXcanvas16 &c,const PadState &p) {
  text(c,12,14,3,WARN,"Cooldown");
  textClip(c,12,52,296,1,INK,p.tiltReason);
  const int cx=160,cy=125,r=48;
  float fraction=p.tiltDuration?std::min(1.f,float(p.tiltRemaining)/p.tiltDuration):1.f;
  for(int i=0;i<120;i++) {
    float a=(i*3-90)*3.14159265f/180;
    c.drawLine(cx+int(cos(a)*(r-5)),cy+int(sin(a)*(r-5)),cx+int(cos(a)*r),cy+int(sin(a)*r),i<120*fraction?WARN:MUTE);
  }
  String remaining=p.tiltRemaining?String(p.tiltRemaining/60)+":"+(p.tiltRemaining%60<10?"0":"")+String(p.tiltRemaining%60):String("--:--");
  text(c,cx-int(remaining.length())*6,cy-7,2,INK,remaining.c_str());
  text(c,12,190,1,INK,"New trades paused. Desk cannot clear early.");
  text(c,12,211,1,MUTE,"KILL / NO / PORTFOLIO / reduce-only work");
}

static void drawScan(GFXcanvas16 &c,const xorr::Scan &s) {
 text(c,12,12,2,UP,"SCAN");
 wrap(c,12,43,296,1,INK,ascii(s.summary.c_str()),7);
 textClip(c,12,103,296,1,MUTE,String(s.checkedCount)+" checked / "+String(s.unavailableCount)+" unavailable");
 String checked="Markets: ";for(size_t i=0;i<s.markets.size();++i){if(i)checked+=", ";checked+=s.markets[i].symbol.c_str();if(!s.markets[i].error.empty())checked+=" (N/A)";}
 if(s.markets.empty())checked="Markets unavailable / Setup required";
 if(s.checkedCount+s.unavailableCount>s.markets.size())checked+=String(" +")+String(unsigned(s.checkedCount+s.unavailableCount-s.markets.size()))+" more";
 wrap(c,12,120,296,1,MUTE,checked,3);
 wrap(c,12,158,296,1,INK,s.top.empty()?String("Top setup: none"):String("Top: ")+s.top.c_str(),4);
 text(c,12,221,1,MUTE,"Any key: dismiss / returns after 8 seconds");
}
static void drawFrame(GFXcanvas16 &c, const PadState &pad, const ChartState &ch) {
  highContrastTheme=pad.highContrast;
  c.fillScreen(BG);
  c.setTextWrap(false);
  if (pad.factory) {
    text(c,12,8,2,INK,"FACTORY / SELF TEST");
    wrap(c,12,34,296,1,INK,pad.factoryInstruction,3);
    if (pad.factoryStage == 2) {
      text(c,12,90,2,INK,"MIC LEVEL"); c.drawRect(12,120,296,24,INK);
      c.fillRect(14,122,292*pad.factoryMic/100,20,UP);
    }
    if (pad.factoryStage == 4) {
      const uint16_t bars[]={0xf800,0x07e0,0x001f,0xffff,0x0000};
      for(int i=0;i<5;i++) c.fillRect(i*64,72,64,70,bars[i]);
      for(int x=0;x<W;x+=8) c.drawLine(x,150,x,239,INK);
      for(int y=150;y<H;y+=8) c.drawLine(0,y,319,y,INK);
    }
    return;
  }
  if(pad.killed){
    if(pad.clearSigning && pad.flatten.review(std::string(pad.signalId.c_str())) && !pad.rearmRequested){drawConfirm(c,pad,ch);return;}
    if(pad.flatten.visible() && !pad.rearmRequested){
      const auto &f=pad.flatten;
      text(c,12,12,3,DOWN,"FLATTEN ALL");
      text(c,12,46,1,WARN,"KILLED / REDUCE ONLY / LATCH STAYS ON");
      textClip(c,12,68,296,1,INK,String(f.orders)+" orders / "+String(f.perps)+" perps / "+String(f.outcomes)+" outcomes");
      if(f.rows.empty())wrap(c,12,96,296,1,INK,f.message.c_str(),6);
      else {
        size_t pages=(f.rows.size()+3)/4,page=f.page%pages;
        for(size_t i=0;i<4 && page*4+i<f.rows.size();++i)textClip(c,12,96+i*20,296,1,INK,f.rows[page*4+i].c_str());
        textClip(c,12,180,296,1,MUTE,f.message.empty()?String("Page ")+String(unsigned(page+1))+"/"+String(unsigned(pages))+" / turn knob":String(f.message.c_str()));
      }
      textClip(c,12,202,296,1,f.live(millis())?UP:WARN,f.live(millis())?"HOLD YES 800ms: EXECUTE / NO: KEEP LATCH":String(f.state.c_str())+" / latch remains on");
      c.fillRect(12,226,int(296*pad.holdProgress),4,WARN);return;
    }
    text(c,12,20,4,DOWN,"KILLED");wrap(c,12,72,296,2,INK,"Trading is latched off",2);
    wrap(c,12,130,296,1,INK,pad.rearmRequested?"Desk requested rearm. Hold YES for 800ms.":"Request rearm from the desk, then hold YES on this pad.",4);
    c.fillRect(12,190,(int)(296*pad.rearmProgress),8,WARN);if(pad.pairCode.length())text(c,12,220,1,INK,(String("PAIR CODE ")+pad.pairCode).c_str());return;
  }
  if(pad.updating){text(c,12,20,3,WARN,"UPDATING");text(c,12,80,4,INK,(String(pad.otaProgress)+"%").c_str());c.drawRect(12,145,296,20,INK);c.fillRect(14,147,292*pad.otaProgress/100,16,UP);text(c,12,190,1,INK,"Keep USB power connected");return;}
  if(pad.errorCode.length()){text(c,12,18,3,WARN,"ACTION NEEDED");textClip(c,12,66,296,2,INK,pad.errorCode);textClip(c,12,104,296,1,INK,pad.errorFix);text(c,12,205,1,MUTE,"Key: dismiss / retry the action");return;}
  if(pad.alertsOnly){
    text(c,12,18,2,WARN,"DESK OFFLINE");
    wrap(c,12,62,296,2,INK,"alerts only",2);
    wrap(c,12,104,296,1,INK,"Desk offline · alerts only · nothing will trade",3);
    wrap(c,12,156,296,2,UP,pad.alertNotice,3);return;
  }
  if(pad.pairCode.length()){
    drawQr(c,pad.pairQr,133,24,183);
    text(c,6,12,2,INK,"PAIR");text(c,6,64,1,INK,"ENTER CODE");text(c,6,84,2,WARN,pad.pairCode.c_str());text(c,6,120,1,INK,"BLE PASSKEY");text(c,6,134,1,INK,"IS THE SAME");text(c,6,224,1,INK,"Scan with XOR app / desk");if(!pad.ok)text(c,6,208,1,MUTE,"offline: nothing will execute");return;
  }
  if(pad.abilityReview){
    text(c,12,12,2,WARN,"TRUST DEVELOPER?");
    text(c,12,44,1,INK,"Compare this full key with your developer:");
    for(int i=0;i<4;++i)text(c,12,68+i*20,2,INK,pad.abilityDeveloper.substring(i*16,(i+1)*16).c_str());
    text(c,12,164,1,INK,"This replaces your trusted developer and abilities.");
    text(c,12,190,1,WARN,"HOLD YES 800ms / NO TO CANCEL");
    c.fillRect(12,212,int(296*pad.holdProgress),4,WARN);return;
  }
  if(pad.tiltBlocked && !(pad.pending && pad.tiltAllowed) && !pad.fund.visible && !pad.portfolio.visible && !pad.predict.positionsVisible && !(pad.liqGuard.fresh(millis()) && !pad.pending)){drawCooldown(c,pad);return;}
  if(padScanVisible(pad,millis())){drawScan(c,pad.scan);return;}
  if(pad.pending&&pad.ok){drawConfirm(c,pad,ch);return;}
  if(pad.ok && !pad.listening && pad.liqGuard.fresh(millis())){drawLiqGuard(c,pad.liqGuard);return;}
  if(pad.listening){text(c,12,20,3,SOL,"LISTENING");for(int i=0;i<32;i++){int h=pad.waveform[i];c.drawFastVLine(4+i*10,120-h,2*h+1,UP);}text(c,12,204,1,INK,"Release MIC or knob to send");return;}
  if (!pad.ok)          drawOffline(c);
  else if(pad.receiptSignature.length() && (int32_t)(pad.receiptUntil-millis())>0) {
    text(c,12,14,3,UP,"RECEIPT");text(c,12,50,1,MUTE,"CONFIRMED SIGNATURE");text(c,12,178,1,UP,(pad.receiptSignature.substring(0,8)+"..."+pad.receiptSignature.substring(pad.receiptSignature.length()-8,pad.receiptSignature.length())).c_str());
    wrap(c,12,68,W-24,1,INK,pad.receiptSignature,4);
    wrap(c,12,124,W-24,1,MUTE,pad.receiptExplorer,4);
    banner(c,UP,"CONFIRMED","confirmed / explorer short sig");
  }
  else if(pad.fund.visible) {drawFund(c,pad.fund);return;}
  else if(pad.portfolio.visible) {drawPortfolio(c,pad.portfolio);return;}
  else if(pad.predict.positionsVisible) {drawOutcomePositions(c,pad.predict,millis());return;}
  else if(pad.abilityWidget.length() && !pad.reply.length()) {
    textClip(c,12,18,296,1,MUTE,"ABILITY / "+pad.abilityName);
    wrap(c,12,58,296,2,INK,pad.abilityWidget,6);
  }
  else if (pad.reply.length()) {
    text(c,12,12,2,SOL,"AGENT REPLY");
    String body=ascii(pad.reply);
    auto lines=xorr::replyLines(body.c_str());
    size_t page=xorr::replyPage(millis(),pad.replyAt,lines.size());
    for(size_t i=page*8;i<lines.size() && i<(page+1)*8;++i)
      text(c,12,44+int(i%8)*18,2,INK,lines[i].c_str());
    char counter[40]; snprintf(counter,sizeof counter,"%u/%u - scrolls every 6s",unsigned(page+1),unsigned(xorr::replyPages(lines.size())));
    text(c,12,205,1,MUTE,counter);
    textClip(c,12,224,296,1,MUTE,pad.profile+" / "+pad.layer);
    return;
  }
  else if(pad.journal.visible){drawJournal(c,pad.journal);return;}
  else if(pad.ambient.visible){drawAmbient(c,pad.ambient);return;}
  else if(pad.predict.enabled && (int32_t)(pad.keymapUntil-millis())<=0) {drawPredict(c,pad);return;}
  else if (pad.positionsVisible || (pad.positionCount >= 0 && (millis()/6000)%2 == 1)) {
    drawPositions(c,pad,millis());
  }
  else if (pad.pending) drawConfirm(c, pad, ch);
  else if((int32_t)(pad.keymapUntil-millis())>0){
    text(c,12,12,2,INK,"PROGRAMMED KEYS");
    for(int i=0;i<14;i++){
      int x=8+(i%3)*104,y=42+(i/3)*30;
      c.drawRoundRect(x,y,98,24,4,GRID);textClip(c,x+4,y+8,90,1,MUTE,pad.keyLabels[i]);
    }
    banner(c,UP,"SAVED","desk keymap stored in NVS");
  }
  else                  drawHome(c, pad, ch);
  if(!pad.pending && (int32_t)(pad.labelUntil-millis())>0) {
    c.fillRect(0,H-76,W,36,BG);textClip(c,12,H-64,W-24,2,INK,pad.lastKeyLabel);
  }
  if(!pad.pending)textClip(c,12,H-44,210,1,pad.highContrast?INK:MUTE,pad.profile+" / "+pad.layer);
  if(pad.link.length())textR(c,W-12,H-44,1,MUTE,pad.link.c_str());
}

}  // namespace ui
