nickthelegend/xorrpad/(commit log)

2026-09-20 xorrpad: a desk terminal for tokenized stocks, on Solana and X Layer
    The pad now trades what it was always pointed at: shares. Backed Finance
    xStocks are ordinary SPL tokens, so unlike the Base B20 equities — which the
    node implements and a fork therefore cannot hold — these actually quote, route
    and settle. Seventeen of them are listed here, each measured rather than
    assumed.
    The thing the product is about
    A share of Tesla can be bought between 9:30 and 16:00 New York time on a
    weekday. TSLAx has no such opinion, and roughly two thirds of the volume in
    this asset class happens while the exchange that prices the underlying is shut.
    So the screen never shows a price without saying which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
2026-09-20 The pad runs on the venue it says it is on
    /pad claimed `chain: solana` while reporting market ETH, mode fork, chainOk
    false and a price of $2631 from the Base feed. Four fields, all true of a chain
    this build never touches, describing a panel that would have shown a ticker
    Jupiter cannot trade.
    Now the active venue drives all of it: the opening market is the first symbol
    it lists, reachability is its own, and the price is its quote, cached six
    seconds because /pad is polled by both the hardware and every open tab.
    The allowlist too. A fresh store was seeded with Base's tokens, so the gate
    refused every real market — "SPYx is not in the allowlist [ETH, WETH, USDC,
    cbBTC, ...]" — which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
2026-09-20 The desk app shows the venue it is on, and its book
    The browser said "the Base node at :8545 did not answer in time. Holdings,
    prices and on-chain data are all unavailable until it does" over a backend that
    was quoting Jupiter perfectly well the whole time. Underneath, the rail read
    "Base fork" and the Markets page listed six Base coins this build cannot reach,
    above tokenized equities marked NOT YET that it can.
    /portfolio and /markets now come from the active venue. Markets serves its book
    priced live — seventeen xStocks with the venue each one actually routes through
    — and keeps the rejected market visible with its reason, because an omission
    the operator cannot see reads as an overs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
2026-11-11 Expose keeper-created chain markets and public resolution evidence through read-only desk routes
2026-11-11 Measure keeper traction from parsed chain swaps and actual creator fee transfers
2026-11-11 Verify keeper guards, exact settlement, key isolation and real chain traction evidence
2026-11-11 Verify live multi-venue quotes, health and gated proposal HTTP flow
2026-11-11 docs: record ESP32-S3 v1 compile command and memory size
2026-11-11 Test agent providers, chat persistence, encrypted keys and voice safeguards
    Fix Electron readiness startup, exact proposal speech, setup origin checks and interrupted audio handling exposed during validation. Record verification counts and live-service limits.
2026-11-11 Expose authenticated backtest endpoints and wire the agent tool
2026-11-11 feat(site): add prototype landing and real desk captures
2026-11-11 test(site): verify API setup paths and responsive landing
    Add 1440/375 captures, validation checks and measured handoff evidence. Harden payment retry reconciliation, pending recovery and configured terms copy found during verification.
2026-11-12 Add the XOR Desktop v2 brief: the xorr.finance look, device-first
2026-11-12 feat(desktop): build the xorr device companion home
    Bundle the xorr.finance fonts, media, components and motion in a local React/Vite app. Add verified device state, tactile key programming and saved profiles, preserve v1 and Classic, and set the Electron minimum window to 1280 by 800.
2026-11-12 feat(desktop): add verified device pairing and connection setup
    Reuse brand rings media in the USB/BLE/Wi-Fi flow, expose actual host/Tailscale state, and keep firmware updates unavailable until a signed image exists.
2026-11-12 Finish desktop v2 integration and verification harness
    Complete the pending command palette, formatted brand ports, guarded ability bindings, loss metadata checks and isolated HTTP/browser verification. Browser verification identified a Device overflow to address in FIX-1.
2026-11-12 Fit the device at 375 pixels and move mobile navigation to a bottom bar
2026-11-12 Bind desk confirmations to trusted v2 signal fingerprints
    Expose canonical executable signal details in snapshots and trade controls, reject quote changes through the acceptance gate, and share signed-manifest verification primitives.
2026-11-12 Complete the encrypted v2 desk bridge and device management routes
    Add QR/code pairing, authenticated framing and retries, telemetry and bounded crash intake, signed OTA, profile sync and BLE Opus conversion. Require verified sessions and a current physical hold to clear the kill latch.
2026-11-12 Expose v2 pairing and signed updates in the Connect screen
    Connect pad settings, profiles, secure device status and deliberate rearming to the v2 management API, with disconnected action guards.
2026-11-12 Verify v2 desk flows with the stateful pad simulator
    Exercise encrypted TCP and serial pairing, replay and downgrade rejection, real desk routes, trusted live signals, signed OTA and persisted kill/rearm behavior. Run live test files sequentially and document protocol and compile evidence with hardware limitations.
2026-11-12 Authenticate v2 pairing with fresh device challenges and encrypted frames
    Bind X25519 sessions to one-use device offers and TFT codes, retain Ed25519 identity proofs, and enforce BLE Secure Connections passkeys. Add the portable AEAD/replay core and native pairing coverage.
2026-11-12 Add the brief for the real-CAD 3D model and brand assets
2026-11-12 Export real CAD as compressed photo-material web models
2026-11-12 Make v2 retries replay-safe and enforce reconnect and failover policy
    Separate control replay tracking from reliable acknowledgments, keep heartbeats independent of backend work, back off BLE reconnects, reject standby trade inputs and drop expired signal deliveries. Disable legacy HTTP until explicitly enabled by the paired desk and discard old Wi-Fi output on failover. Add native frame conformance and real TCP fault coverage, with normal/release build and desk test evidence.
2026-11-12 Render real CAD studio stills and a seamless six-second turntable
    Compile the actual firmware drawing code to a bundled WebAssembly screen texture and retain its redistribution license.
2026-11-12 Use real CAD for interactive keys knob and firmware display in Device
    Keep the approved page composition and assignment sheet, use a lightweight mobile poster, and verify native/WebAssembly firmware pixel parity and CAD artifact contracts.
2026-11-12 Add inspected ChatGPT brand art to existing ability and empty-state slots
    Use only the real CAD turntable and render wherever the companion shows the pad; retain the approved layout and document prompts, credit, alpha and size limits.
2026-11-12 Finish real-CAD captures motion preferences and native GPU verification
    Record the completed 151-test run, 13 captures and native Apple M4 60 fps evidence from MODEL-3D.
2026-11-12 Fit studio cameras to actual CAD bounds with eight percent padding
2026-11-12 Define the firmware status LED language with kill-first priority
2026-11-12 Add exact-message pad signer mode to the desk executor
    Expose encrypted public signer and policy management, verify device signatures before existing submission gates, and refuse mainnet without acknowledgment or any wallet fallback. Exercise native firmware signing over the encrypted simulator.
2026-11-12 Record V2 session signer evidence and explicit trust limits
    Document public management/signing frames, conservative supported exposures and rolling time accounting, native/simulator and full-suite totals, and both isolated and working-tree build sizes. Keep hardware and funded broadcast work explicitly unproven.
2026-11-12 Add the PCB routing pass-2 brief
2026-11-12 Document sourced component tiers and BOM gaps
2026-11-12 Research current comparables and addressable demand
2026-11-12 Record Core quantity-tier reference BOM
2026-11-12 Record Pro quantity-tier reference BOM
2026-11-12 Record PCB transient-file exclusions
2026-11-12 Record Keebio socket footprint license
2026-11-12 Record PCB draft review requirements
2026-11-12 Record provisional FPC placement footprint
2026-11-12 Record Kailh socket compatibility footprint
2026-11-12 Record Core assembler BOM
2026-11-12 Record Core part and pin manifest
2026-11-12 Record Core placement board
2026-11-12 Record Pro assembler BOM
2026-11-12 Record Pro part and pin manifest
2026-11-12 Record Pro placement board
2026-11-12 Record KiCad placement generator
2026-11-12 Record SKiDL version pin
2026-11-12 Record PCB artifact and BOM checks
2026-11-12 Record sourced BOM generation
2026-11-12 Clear placement DRC with sourced socket geometry and CAD key centres
2026-11-12 Import official Freerouting Pro session and record real KiCad DRC
2026-11-12 Reserve Pro plane access and fully protect USB connector routing
2026-11-12 feat(firmware): add OTA channels, staged rollout and signed delta updates
2026-11-12 Finish Pro routing and ground stitching with zero KiCad DRC findings
2026-11-12 Import Core official Freerouting session and retain independent KiCad DRC
2026-11-12 Finish Core routing and ground stitching with zero KiCad DRC findings
2026-11-12 Document Core P2 DRC evidence, enclosure clearances and local review renders
2026-11-12 Export P3 fabrication and schematic review packages for both SKUs
2026-11-12 Measure both PCB outlines and document enclosure and FPC fit blockers
2026-11-12 Rebuild the desktop firmware-screen module from the v3 ui.h
    tools/uipreview/build-web-screen.sh with the cached emsdk. The browser TFT
    frame matches the native firmware RGB565 frame byte for byte again
    (model3d parity test 5/5).
2026-11-12 Replace the Base chain mark on the white SCAN key with a magnifier
    The white key runs SCAN (checks every market for a setup), but its cap
    carried the Base chain logo from the multi-chain pad. xorrpad is Solana
    only and caps carry no third-party marks, so it now prints a magnifier.
    The key id stays "base", so firmware, desk and profiles are unchanged.
    export_print_batches.py: 5 plates, all watertight; export_caps_plate.py:
    all checks pass. docs/print/keys-print-check.png is the top view of the
    print geometry.
2026-11-12 feat(desktop): add Device v3 controls (D2)
2026-11-12 test(desktop): check Device clipping and refresh D5 padsim captures
2026-11-12 fix(desk): live price first, short pad heading, real firmware version, refuse trades after KILL
    - Markets shows the live Jupiter quote as soon as it resolves; the 24 h reference has its own state.
    - Connect heads the pad as 'xorrpad · <short id>' with the full id in small mono.
    - Release notes and /desk/connection report the paired pad's firmware, not 1.0.0.
    - BUY/SELL/SCAN after KILL are refused at the key: 'Killed: re-arm on the pad to trade'.
    - v3 form labels get the existing field spacing; Remove alert shows a shortened id.
2026-11-12 feat(firmware): add v4 Predict on the pad (F1)
    Stream live devnet outcomes to Predictor home, preserve two-step trusted YES/NO decisions, and show outcome positions through existing gated desk routes. Include v4 padsim, native/WASM parity coverage, unsigned Pro/Core compilation evidence, and captured frames.
    Validation: desk 244 passed, 12 environment skips, 0 failed; native 277 cases and 2744 assertions passed; app build and Pro/Core compiles passed. No push or release signing.
